dganin-hw/bldc-foc/hardware/encoder-board/README.md

# Плата энкодера

Маленькая плата с датчиком AS5047P. Она измеряет угол ротора по магниту на валу
мотора и передаёт его в STM32 основной платы по SPI. На плате восемь компонентов:
датчик, два конденсатора, четыре резистора и разъём.

Плата энкодера: сторона магнита и сторона кабеля

*Слева сторона, обращённая к магниту, справа обратная сторона с разъёмом.*

## Коротко

| Параметр | Значение |
|---|---|
| Размер | 32 × 28 мм, 2 слоя, FR-4 1,6 мм, фаски 1 мм на углах |
| Датчик | AS5047P-ATSM, 14 бит, TSSOP-14, в центре платы |
| Питание | только 3,3 В от основной платы (3,0-3,6 В), 5 В подавать нельзя |
| Интерфейс | SPI mode 1, первые запуски на частоте до 1 МГц |
| Крепление | 4 отверстия Ø2,2 мм под M2 на сетке 24 × 20 мм, по центру датчика |
| Разъём | JST GH, 6 контактов, на обратной стороне |

## Подключение к основной плате

| Основная плата, J3 | Энкодер, J1 | Сигнал | Вывод AS5047P |
|---:|---:|---|---|
| 1 | 1 | 3,3 В | 11 и 12 (соединены) |
| 2 | 2 | GND | 5 (TEST) и 13 |
| 3 | 3 | SCK | 2 |
| 4 | 4 | MISO | 3, через R4 33 Ом |
| 5 | 5 | MOSI | 4 |
| 6 | 6 | CS, активный ноль | 1 |

Разъём J1 - JST SM06B-GHS-TB(LF)(SN), шаг 1,25 мм. Ответная часть - корпус
GHR-06V-S и шесть контактов SSHL-002T-P0.2. На другом конце кабеля гнездовая колодка
1×6 с шагом 2,54 мм под J3. Готовый кабель GH-GH сюда не подходит.

- Для первого кабеля провод AWG28 длиной до 150 мм. Это условие для стенда, а не
  гарантированная длина линии SPI.
- Контакты считать по маркировке платы и чертежу разъёма, а не по цвету провода.
  Вид сзади зеркальный.
- До включения прозвонить все шесть проводов и проверить, что соседние контакты
  не замкнуты.
- Кабель вести подальше от фазных проводов мотора.

Контрольные площадки: TP1 - 3,3 В, TP2 - GND, TP3 - CS, TP4 - SCK, TP5 - MOSI,
TP6 - MISO после R4.

## Схема

- Выводы питания VDD (11) и VDD3V3 (12) соединены, как требует питание 3,3 В.
  TEST (5) соединён с GND (13). Рядом стоят C1 100 нФ и C2 1 мкФ.
- R1 10 кОм держит CS в единице, R2 и R3 47 кОм держат SCK и MOSI в нуле, пока
  STM32 в сбросе. Вместе с R37 10 кОм на основной плате CS подтянут примерно через
  5 кОм.
- R4 33 Ом стоит у выхода MISO. Линия MISO общая с DRV8323 на основной плате, там
  же подтяжка R10 1 кОм. При CS = 1 датчик отпускает линию. Энкодер и драйвер нельзя
  выбирать одновременно.
- Выходы A/B/I и U/V/W датчика не используются.

## Первый запуск

1. Обесточить обе платы. Проверить ориентацию U1, пайку, отсутствие перемычек
   припоем, соединение выводов 11 и 12, TEST и GND. Прозвонить кабель.
2. Подать питание на основную плату при снятой JP1, чтобы мост был обесточен.
   Измерить 3,3 В между TP1 и TP2, проверить, что ничего не греется. Датчик
   потребляет до 15 мА.
3. Настроить SPI: mode 1 (CPOL = 0, CPHA = 1), старшим битом вперёд, 16 бит,
   частота до 1 МГц. После включения подождать 10 мс. От спада CS до первого такта
   и между посылками при CS = 1 выдерживать не меньше 350 нс.
4. Ответ приходит со сдвигом на одну посылку: сначала команда чтения, ответ на неё
   придёт в следующей посылке. Команды отправлять с чётным битом чётности, в ответе
   проверять чётность и флаг ошибки.
5. Прочитать регистры диагностики и угол при медленном полном обороте. Переход
   16383 → 0 при прохождении нуля нормален. Проверить повторяемость и биение,
   положение магнита подобрать по диагностике поля.
6. Ноль электрического угла и направление вращения хранить в прошивке STM32.
   OTP-память датчика для стенда программировать не нужно.

Паспортные 10 МГц SPI на стенде не проверялись.

## Механика

| Элемент | Координаты в KiCad, мм | Относительно U1, мм |
|---|---|---|
| U1, ось магнита | 100; 100 | 0; 0 |
| H1, Ø2,2 | 88; 90 | -12; -10 |
| H2, Ø2,2 | 112; 90 | +12; -10 |
| H3, Ø2,2 | 112; 110 | +12; +10 |
| H4, Ø2,2 | 88; 110 | -12; +10 |
| J1, обратная сторона | 100; 110,5 | 0; +10,5 |

Вид со стороны магнита: X вправо, Y вниз.

- Сторона `MAGNET SIDE` смотрит на магнит, кабель выходит у нижнего края с обратной
  стороны.
- Плата крепится к неподвижному кронштейну, а не к вращающемуся торцу мотора.
  Головки винтов, шайбы и стойки не шире Ø4,5 мм, вокруг отверстий зона без меди
  Ø5 мм. Крепёж лучше немагнитный, например латунный. Не всякая нержавейка немагнитна.
- Магнит двухполюсный, намагниченный по диаметру, Ø6 × 2,5 мм. По документации
  датчику нужно поле 35-70 мТ. Начальный зазор 2 мм от крышки магнита до корпуса U1
  задаётся калибром из комплекта стенда, рабочий зазор подбирается по диагностике.
- Позади платы у J1 нужно около 6 мм свободного места и около 15 мм за краем платы
  для колодки, проводов и защёлки.

Плата и магнит встроены в [испытательный стенд](../stand/README.md).

## Файлы

- [`kicad/`](kicad/) - проект KiCad 10, открывать `foc-encoder.kicad_pro`.
- [`documentation/SCHEMATIC.pdf`](documentation/SCHEMATIC.pdf) - схема.
- [`documentation/ASSEMBLY-TOP.pdf`](documentation/ASSEMBLY-TOP.pdf) и
  [`ASSEMBLY-BOTTOM.pdf`](documentation/ASSEMBLY-BOTTOM.pdf) - сборочные чертежи.
- [`manufacturing/`](manufacturing/) - Gerber, сверловка, перечень компонентов и координаты.
- [`mechanical/foc-encoder.step`](mechanical/foc-encoder.step) - 3D-модель с компонентами,
  начало координат XY на оси U1. При импорте проверить направление осей и Z.
- [`mechanical/`](mechanical/) - контур и оси в DXF.

Проверки ERC и DRC в KiCad проходят без ошибок. SPI, магнит и механику ещё нужно
проверить на собранной плате.
