dganin-hw/bldc-foc/hardware/dev-board/manufacturing/drill/drill-report.txt

Drill report for foc-dev-board.kicad_pcb
Created on 2026-09-15T18:38:44

Copper Layer Stackup:
    =============================================================
    L1 :  F.Cu                      front
    L2 :  In1.Cu                    in1
    L3 :  In2.Cu                    in2
    L4 :  B.Cu                      back

Drill file 'foc-dev-board-PTH.drl' contains
    plated through holes:
    =============================================================
    T1  0.200mm  0.0079"  (25 holes))
    T2  0.300mm  0.0118"  (300 holes))
    T3  1.000mm  0.0394"  (23 holes))
    T4  1.050mm  0.0413"  (4 holes))
    T5  1.300mm  0.0512"  (7 holes))

    Total plated holes count 359

Drill file 'foc-dev-board-NPTH.drl' contains
    unplated through holes:
    =============================================================
    T1  3.200mm  0.1260"  (4 holes))

    Total unplated holes count 4
