dganin-hw/bldc-foc/docs/pin-plan.md

# План выводов STM32G431

> Документ относится к основной плате. Правило про единственный TIM1 действует
> для этой платы и не запрещает управлять мостами через HRTIM или несколько
> синхронизированных таймеров в 4-in-1 ESC.

Делается **до первой линии схемы**. Схема зависит от распределения выводов, а не
наоборот: нарисовать схему и потом открыть CubeMX - верный способ обнаружить, что
выбранные ноги не умеют нужного.

Корпус: LQFP48 (`G431CBT6`, основная плата). У UFQFPN48 (`G431CBU6`, возможный
4-in-1) **другая физическая нумерация выводов**. Назначения GPIO можно переиспользовать
после проверки, номера ножек переносить дословно нельзя. Схема:
[основная плата](../hardware/dev-board/README.md). Тайминг АЦП и защиты из `.ioc`
нужно проверить перед включением силовой части.

> GPIO перенесены в схему основной платы, выбор функций взят из CubeMX 6.18.1.
> Это не подтверждает рабочий тайминг ADC/PWM или настройку аппаратной защиты.
> Исходник: `hardware/dev-board/cubemx/CubeMX.ioc`, отчёт рядом в `.pdf`.

**До запуска прошивки требуется:**

- `ProjectManager.TargetToolchain=EWARM` - сменить на **CMake** при генерации кода
- Приоритеты NVIC все по нулям. Нужно: `ADC1_2` → 0 (цикл FOC), `EXTI15_10` → 2
  (авария драйвера), DMA и USART → 3 и ниже. Ставится в коде инициализации
- Спроектировать точку выборки шунтов. При center-aligned и RCR=0 Update возникает
  на обоих экстремумах, поэтому один TRGO Update не гарантирует один правильный
  замер за период PWM. Проверить длительность нижнего импульса и установление CSA/ADC.
- Явно включить BKIN, выбрать активный Low, idle-уровни и порядок повторного взвода.
- Начать проверку SPI на пониженной частоте; SDO драйвера имеет открытый сток.

Ещё одно значение не хранится в `.ioc`, потому что совпадает с дефолтом:
`Clock Prescaler = Synchronous clock mode divided by 4` у обоих АЦП (42.5 МГц).
Если после обновления CubeMX дефолт изменится - проверить.

---

## Правила, из которых всё следует

1. **Все шесть выходов ШИМ - с одного TIM1.** Не обсуждается: комплементарность и
   dead-time аппаратные, между двумя таймерами их не сделать.
2. **Комплементарные каналы не должны съедать выводы, способные на АЦП.** Это
   главное решение всей раскладки, см. ниже.
3. **Три тока распределены между ADC1 и ADC2.** Первые ранги IA/IB могут измеряться
   одновременно; IC во втором ранге ADC1 измеряется позже. Способ использования
   этих измерений в FOC ещё нужно определить.
4. **Injected ADC читаются из JDR в обработчике.** DMA для них здесь не используется;
   каналы DMA SPI, USART и таймера DShot проверяются на конфликты отдельно.
5. Выводы SWD не занимать ничем: иначе при первой же ошибке конфигурации плата
   перестанет прошиваться.

---

## Ключевое решение: N-каналы на порт B

У TIM1 у каждого канала несколько вариантов вывода. Для комплементарных есть два
типичных набора:

| Набор | CH1N | CH2N | CH3N | Последствие |
|---|---|---|---|---|
| A | PA7 | PB0 | PB1 | **съедает три вывода, способные на АЦП** |
| B | PB13 | PB14 | PB15 | порт A остаётся свободным под аналог |

**Берём набор B.** PA7, PB0, PB1 - аналоговые входы, и они нужны под измерение
токов. Набор A загоняет в тупик, из которого выход только через перерисовку.

Это же и есть причина, по которой мы отказались от встроенных опампов G431 в
пользу усилителей внутри DRV8323: входы опампов сидят ровно на этих же выводах и
конфликтуют с TIM1.

Прямые каналы CH1/CH2/CH3 - PA8/PA9/PA10, вариантов по сути нет.

---

## Итоговая раскладка

| Вывод | Функция | Сигнал | Настройки |
|---|---|---|---|
| PA8 | TIM1_CH1 | ШИМ фазы A, верх | center-aligned, ARR 1770 |
| PA9 | TIM1_CH2 | ШИМ фазы B, верх | |
| PA10 | TIM1_CH3 | ШИМ фазы C, верх | |
| PB13 | TIM1_CH1N | ШИМ фазы A, низ | dead-time DTG=68 ≈ 400 нс |
| PB14 | TIM1_CH2N | ШИМ фазы B, низ | |
| PB15 | TIM1_CH3N | ШИМ фазы C, низ | |
| PB12 | TIM1_BKIN | аварийное отключение от nFAULT | включить и проверить активный Low |
| PA0 | ADC1_IN1 | ток фазы A | инж. ранг 1, 6.5 такта |
| PA1 | ADC1_IN2 | ток фазы C | инж. ранг 2, 6.5 такта |
| PA2 | ADC1_IN3 | Vbat через делитель | инж. ранг 3, 47.5 такта |
| PA4 | ADC2_IN17 | ток фазы B | инж. ранг 1, 6.5 такта |
| PA5 | ADC2_IN13 | NTC | инж. ранг 2, 47.5 такта |
| PB3 | SPI1_SCK | шина драйвера и энкодера | 16 бит, 5.3 Мбит/с, CPOL 0 / CPHA 1 |
| PB4 | SPI1_MISO | | DMA RX |
| PB5 | SPI1_MOSI | | DMA TX |
| PA15 | `DRV_CS` | выбор драйвера | выход, старт High |
| PB9 | `ENC_CS` | выбор энкодера | выход, старт High |
| PA11 | `DRV_ENABLE` | разрешение драйвера | выход, **старт Low** |
| PA12 | `DRV_NFAULT` | авария драйвера | вход, pull-up, EXTI по спаду |
| PB6 | TIM4_CH1 | приём DShot600 | захват обоих фронтов, фильтр 3, DMA |
| PB10 | USART3_TX | телеметрия | DMA TX |
| PB11 | USART3_RX | команды | |
| PC13 | `LED` | индикация | выход |
| PB1 | `TP_TIMING` | замер времени цикла | выход, пятак под щуп |
| PA13 | SYS_JTMS-SWDIO | отладка | |
| PA14 | SYS_JTCK-SWCLK | отладка | |

Оба АЦП запускаются от одного TRGO TIM1 по нарастающему фронту, тактируются
синхронно от HCLK с делением на 4 (42.5 МГц). Прерывание `ADC1_2` - обработчик
цикла FOC, приоритет 0.

**Не подключены в схеме:** PA3, PA6, PA7, PB0, PB2, PB7, PC14, PC15, PF0, PF1.
PB8 используется как BOOT0, PG10/NRST - для сброса; их нельзя считать свободными.

Полезно, что осталось: три аналоговых входа про запас, второй канал того же TIM4
под возможное разделение приёма и передачи двунаправленного DShot, и PB7 рядом с
PB6 для этого же.

### Как сгруппировано на корпусе

- **Правая грань** - всё к драйверу: шесть ШИМ, BKIN, nFAULT, ENABLE
- **Верхняя грань** - SPI и два CS: драйвер и разъём энкодера
- **Левая грань** - аналог: пять входов АЦП подряд
- **Нижняя грань** - UART, пин замера, свободные выводы
- DShot вынесен на PB6 отдельно от затворных сигналов

При разводке это даёт четыре аккуратных пучка вместо паутины через весь корпус.

---

## Что проверить в CubeMX перед схемой

- [ ] Все шесть ШИМ встают на TIM1 одновременно, без конфликтов
- [ ] TIM1_BKIN доступен на выбранном выводе в LQFP48
- [ ] Токи A/B/C: минимум один на ADC1 и один на ADC2
- [ ] Инжектированные группы **обоих** АЦП стартуют от TRGO TIM1
- [ ] Таймер DShot умеет input capture с DMA на выбранном выводе
- [ ] Каналы DMA АЦП и DShot не пересекаются
- [ ] Vbat и NTC - на выводах, способных на АЦП, и не заняты ничем
- [ ] PA13/PA14 свободны
- [ ] BOOT0 разведён

Результат - экспортировать из CubeMX (`.ioc` + отчёт) в `hardware/` и
зафиксировать. Схема рисуется по нему, а не по этому документу.

---

## Процедура в CubeMX

Порядок выбран так, чтобы самое зажатое вставало первым.

1. `New Project` → `STM32G431CBT6` (корпус влияет на список доступных выводов)
2. **`System Core → SYS → Debug: Serial Wire` - первым делом.** Резервирует
   PA13/PA14. Если забыть, отладочный интерфейс может уйти под другую функцию, и
   плата перестанет прошиваться после первой же заливки
3. `System Core → RCC → HSE: Disable` - кварц не ставим
4. `TIM1`: Internal Clock; `Channel1/2/3 = PWM Generation CHx CHxN`;
   `Counter Mode = Center Aligned mode 1`; `PSC = 0`; `ARR = 1770`
   (170 МГц / (2 × 1771) = 48.0 кГц); `TRGO = Update Event`;
   включить `Break Input`, dead-time 300-500 нс на первое время
5. **Переставить N-каналы на PB13/PB14/PB15** вручную через клик по выводу.
   CubeMX по умолчанию возьмёт PA7/PB0/PB1 - набор, съедающий аналоговые входы.
   Убедиться, что PA7, PB0, PB1 освободились
6. `ADC1` и `ADC2`: каналы токов разнести между двумя АЦП; инжектированная группа,
   `External Trigger Source = Timer 1 Trigger Out event`
7. `SPI1`, `USART`, отдельный таймер в `Input Capture direct mode` под DShot, GPIO
8. `Clock Configuration`: вписать `170` в HCLK
9. `DMA Settings`: проверить каналы SPI, UART и DShot. Для injected ADC DMA не назначается
10. Сохранить `.ioc` в `hardware/dev-board/cubemx/`, `Toolchain = CMake`,
    `Generate Report`. **Код не генерировать** - нужна только раскладка

---

## Перенос на 4-in-1

В текущем `.ioc` CS энкодера - PB9. При отказе от энкодера эта линия освобождается.
Для переноса на UFQFPN48 заново сверить **все физические номера выводов**, питание
и доступность функций по datasheet STM32G431. У этого корпуса распиновка отличается
от LQFP48; прямая замена посадочного места недопустима.

Проверка выполняется один раз, четыре канала получают её бесплатно.
