dganin-hw/bldc-foc/docs/safety.md

# Безопасность и порядок включения

Прочитать до первого включения силовой части. Здесь нет паранойи - есть
конкретные способы не потерять плату и глаза.

---

## Железные правила

1. **БП только с ограничением тока.** Первое включение - предел 0.3 А. Поднимать
   порог только после того, как всё ожидаемое работает.
2. **Начинать с 12 В и маленького мотора.** Энергия ошибки растёт как V².
3. **Очки при первом включении новой платы.** Электролит и керамика при КЗ
   разлетаются.
4. **Мотор механически закреплён.** Незакреплённый мотор с пропеллером - травма.
   Пропеллер не ставить вообще, пока алгоритм не отлажен.
5. **Не трогать плату под напряжением.** Щупы ставить при выключенном питании.
6. **Земля осциллографа.** При измерении на high-side НЕЛЬЗЯ цеплять землю щупа
   к средней точке полумоста - это КЗ через землю сети. Использовать
   дифференциальный щуп либо измерять сигналы относительно GND в пределах
   допустимых напряжений прибора. Изолированный БП сам по себе не разрешает
   подключать землю щупа к фазе: остаются общие земли каналов, USB и ST-Link.
7. **Разряд шины.** После выключения конденсаторы шины держат заряд. Ждать или
   ставить bleeder-резистор.

---

## Отдельно про дрон

Здесь появляются два источника опасности, которых нет на стенде: аккумулятор и
пропеллеры.

### LiPo

**У LiPo нет ограничения тока.** Лабораторный БП при КЗ уходит в защиту, LiPo
отдаёт сотни ампер и продолжает. Разница между «сгорел транзистор» и «пожар».

- Вся отладка - **только от лабораторного БП**. LiPo подключается в последнюю
  очередь, после полной наземной валидации
- Первое подключение LiPo - через **smoke stopper** (лампа накаливания 12 В в
  разрыв плюса): при КЗ она просто светится
- Хранить и заряжать в огнеупорном мешке, не оставлять без присмотра
- Не подключать/отключать аккумулятор при вращающихся моторах
- Вздувшийся аккумулятор - в утиль, не «ещё разок»

### Пропеллеры

- **Все стендовые работы - без пропеллеров.** Вообще. Ни одного исключения:
  «только проверить направление» - тоже без
- Пропеллеры ставятся только на собранном аппарате, после того как направления
  вращения и микшер проверены без них
- Первые подлёты - на привязи или в защитной клетке, на улице и вдали от людей
- Перед каждым включением: газ на минимуме, аппарат disarmed, руки не над плоскостью
  винтов
- Раскрученный 5" пропеллер режет до кости. Это не фигура речи

### Failsafe

Failsafe по потере DShot - **обязательная функция до первого полёта**, а не
доработка потом. Проверять её на стенде: выдернуть сигнальный провод при
работающем моторе, мотор должен плавно остановиться.

То же с failsafe в приёмнике и FC - настроить и проверить выключением пульта.

---

## Порядок первого включения новой силовой платы

1. Визуальный осмотр, проверка на КЗ тестером: Vbus↔GND, каждая фаза↔GND, 3.3 В↔GND
2. На основной плате снять JP1 и JP2, затем подать 12 В на J1 с ограничением тока.
   Проверить 5 В/3,3 В, прошивку MCU и внешний датчик. Не подавать внешние 3,3/5 В
   на сигнальные разъёмы. При JP1 open питание VM драйвера отсутствует; его SPI
   проверяется позже, после подключения VM и контролируемого разрешения ENABLE.
3. Проверить, что при старте MCU все шесть PWM и команда ENABLE имеют неактивный
   уровень. Перед изменением перемычек выключать питание и проверять разряд VM.
4. Установить JP1, оставить JP2 снятой; мотор не подключать. Подать 12 В с
   ограничением тока. Ток покоя оценивать по бюджету MCU, buck/LDO и драйвера,
   а не считать, что он обязательно равен нескольким миллиамперам. VM должен
   оставаться в рабочем диапазоне; 5 В недостаточно для полноценной проверки DRV8323.
5. После проверки прошивки запуска установить JP2 при снятом питании. При
   неактивных PWM разрешить драйвер, прочитать SPI и настроить защиту. Затем без
   мотора проверить входные PWM, реальные VGS, dead-time, реакцию nFAULT/BKIN
   и кнопки отключения. Осциллограммы сохранять; freeze таймера защитой не считать.
6. Подключать мотор только после этих проверок и проверки измерения токов.
   Ограничение тока БП относится к входу платы, а программный лимит - к фазному
   току: это разные величины. Начинать с малой команды и проверенного режима
   остановки без недопустимого подъёма напряжения шины.
7. Повышать нагрузку только по результатам измерений тока, напряжения и
   температуры. Использовать NTC/термопару, не оценивать температуру пальцем.

Подробный порядок для основной платы описан в
[памятке по сборке и первому включению](../hardware/dev-board/bring-up.md).

Если на любом шаге БП уходит в ограничение тока - **выключить и разбираться**,
а не «попробовать ещё раз».

---

## Типовые способы сжечь всё

| Ошибка | Последствие | Профилактика |
|---|---|---|
| Dead-time = 0 или инверсия сигнала | сквозной ток, оба транзистора плеча открыты → мгновенный отказ | проверить осциллографом ДО силового питания |
| Зависание МК с открытым ключом | постоянный ток в обмотке, перегрев | IWDG + BRK-вход + аппаратная OCP драйвера |
| Отладчик остановил МК на брейкпоинте | выход может остаться активным | заранее снять ENABLE; проверить BKIN и неактивные уровни. При freeze выходы TIM1 отключаются, но их уровень зависит от OSSI и GPIO: проверить осциллографом |
| Длинная петля коммутации на плате | выбросы напряжения выше Vds | керамика вплотную к полумосту, короткий контур |
| Слишком короткий интервал проводимости нижнего ключа | недостоверная выборка шунта | ограничить скважность по реальному окну измерения. DRV8323RS использует зарядовый насос, а не bootstrap моста |
| Перепутана полярность питания | мгновенный отказ | reverse-polarity MOSFET на входе |
| Обрыв фазы при работе | выброс на индуктивности | не дёргать разъёмы под напряжением |

---

## Что должно быть на столе

- [ ] БП с ограничением тока
- [ ] Осциллограф (2+ канала), желательно дифференциальный щуп
- [ ] Мультиметр
- [ ] Тиски/крепление для мотора
- [ ] Огнетушитель или хотя бы отсутствие бумаги вокруг
- [ ] Резисторы 10-47 Ом мощные - для «мягкого» первого включения
