dganin-hw/bldc-foc/hardware/dev-board/cubemx/CubeMX.pdf

18/08/2026

CubeMX Project
Configuration Report

## 1. Description

### 1.1. Project

Project Name | CubeMX
Board Name | custom
Generated with: | STM32CubeMX 6.18.1
Date | 08/18/2026

### 1.2. MCU

MCU Series | STM32G4
MCU Line | STM32G4x1
MCU name | STM32G431CBTx
MCU Package | LQFP48
MCU Pin number | 48

### 1.3. Core(s) information

Core(s) | ARM Cortex-M4

## 2. Pinout Configuration

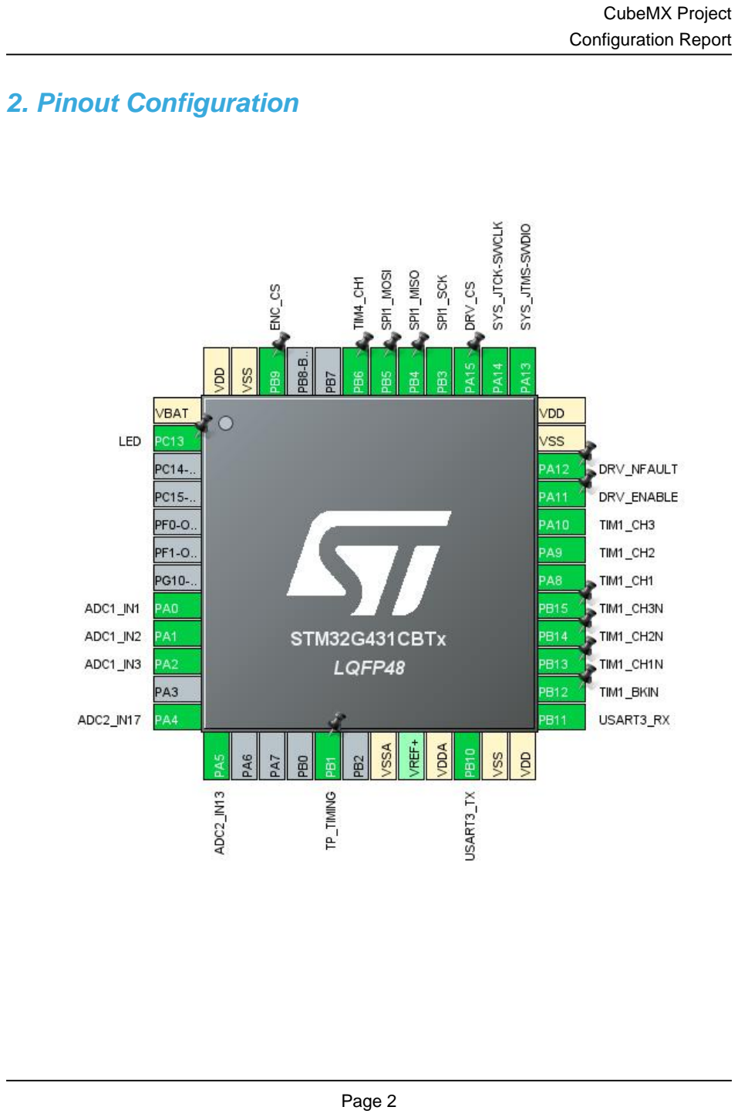
[picture p12: page 3]

## 3. Pins Configuration

Pin Number LQFP48 | Pin Name (function after reset) | Pin Type | Alternate Function(s) | Label
1 | VBAT | Power
2 | PC13 * | I/O | GPIO_Output | LED
8 | PA0 | I/O | ADC1_IN1
9 | PA1 | I/O | ADC1_IN2
10 | PA2 | I/O | ADC1_IN3
12 | PA4 | I/O | ADC2_IN17
13 | PA5 | I/O | ADC2_IN13
17 | PB1 * | I/O | GPIO_Output | TP_TIMING
19 | VSSA | Power
21 | VDDA | Power
22 | PB10 | I/O | USART3_TX
23 | VSS | Power
24 | VDD | Power
25 | PB11 | I/O | USART3_RX
26 | PB12 | I/O | TIM1_BKIN
27 | PB13 | I/O | TIM1_CH1N
28 | PB14 | I/O | TIM1_CH2N
29 | PB15 | I/O | TIM1_CH3N
30 | PA8 | I/O | TIM1_CH1
31 | PA9 | I/O | TIM1_CH2
32 | PA10 | I/O | TIM1_CH3
33 | PA11 * | I/O | GPIO_Output | DRV_ENABLE
34 | PA12 | I/O | GPIO_EXTI12 | DRV_NFAULT
35 | VSS | Power
36 | VDD | Power
37 | PA13 | I/O | SYS_JTMS-SWDIO
38 | PA14 | I/O | SYS_JTCK-SWCLK
39 | PA15 * | I/O | GPIO_Output | DRV_CS
40 | PB3 | I/O | SPI1_SCK
41 | PB4 | I/O | SPI1_MISO
42 | PB5 | I/O | SPI1_MOSI
43 | PB6 | I/O | TIM4_CH1
46 | PB9 * | I/O | GPIO_Output | ENC_CS
47 | VSS | Power
48 | VDD | Power

* The pin is affected with an I/O function

## 4. Clock Tree Configuration

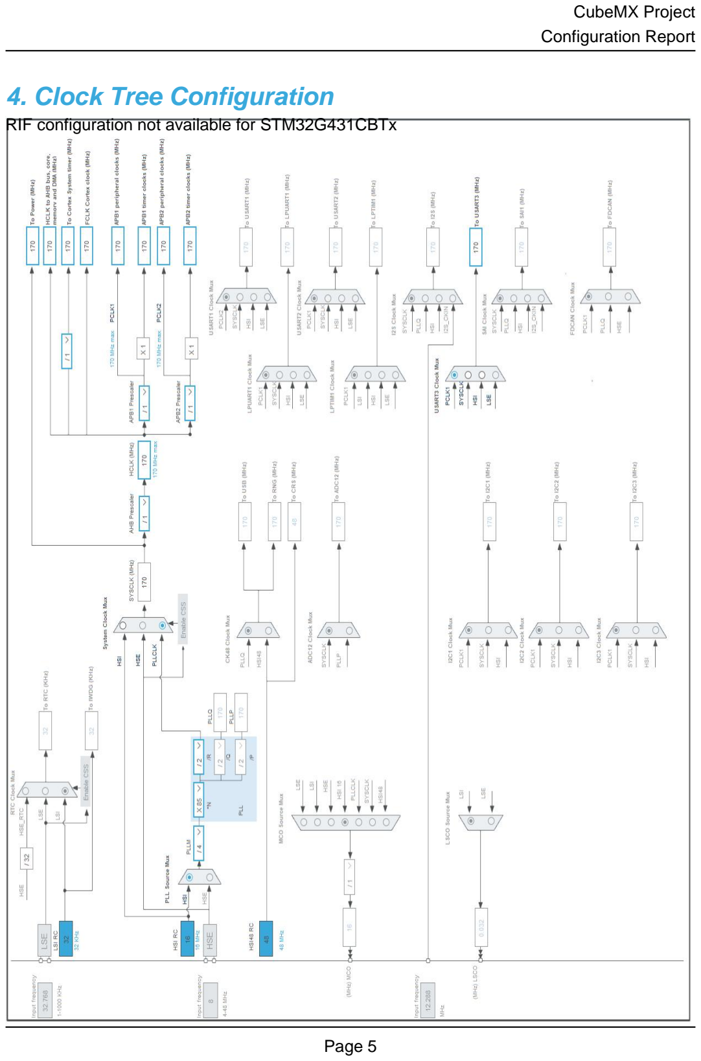
[picture p13: page 6]

RIF configuration not available for STM32G431CBTx

## 1. Power Consumption Calculator report

### 1.1. Microcontroller Selection

Series | STM32G4
Line | STM32G4x1
MCU | STM32G431CBTx
Datasheet | DS12589_Rev0

### 1.2. Parameter Selection

Temperature | 25
Vdd | 3.0

### 1.3. Battery Selection

Battery | Li-SOCL2(A3400)
Capacity | 3400.0 mAh
Self Discharge | 0.08 %/month
Nominal Voltage | 3.6 V
Max Cont Current | 100.0 mA
Max Pulse Current | 200.0 mA
Cells in series | 1
Cells in parallel | 1

### 1.4. Sequence

Step | Step1 | Step2
Mode | RUN | STOP1
Vdd | 3.0 | 3.0
Voltage Source | Battery | Battery
Range | Range1-Boost | NoRange
Fetch Type | FLASH/ART | NA
CPU Frequency | 170 MHz | 0 Hz
Clock Configuration | HSE BYP PLL | ALL CLOCKS OFF
Clock Source Frequency | 4 MHz | 0 Hz
Peripherals
Additional Cons. | 0 mA | 0 mA
Average Current | 25.5 mA | 59 µA
Duration | 0.1 ms | 0.9 ms
DMIPS | 213.0 | 0.0
Ta Max | 124.26 | 129.99
Category | In DS Table | In DS Table

### 1.5. Results

Sequence Time | 1 ms | Average Current | 2.6 mA
Battery Life | 1 month, 23 days, 22 hours | Average DMIPS | 212.5 DMIPS

### 1.6. Chart

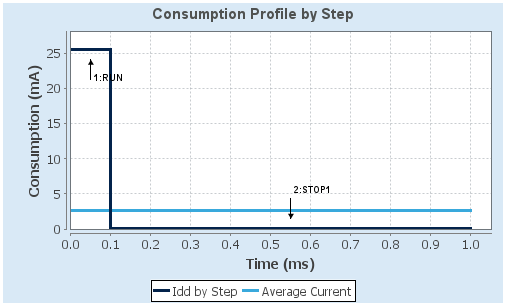
[picture p14: figure]

## 2. Software Project

### 2.1. Project Settings

Name | Value
Project Name | CubeMX
Project Folder | D:\Projects\bldc-foc\hardware\dev-board\cubemx
Toolchain / IDE | EWARM V8.50
Firmware Package Name and Version | STM32Cube FW_G4 V1.6.3
Application Structure | Advanced
Generate Under Root | No
Do not generate the main() | No
Minimum Heap Size | 0x200
Minimum Stack Size | 0x400

### 2.2. Code Generation Settings

Name | Value
STM32Cube MCU packages and embedded software | Copy all used libraries into the project folder
Generate peripheral initialization as a pair of '.c/.h' files | No
Backup previously generated files when re-generating | No
Keep User Code when re-generating | Yes
Delete previously generated files when not re-generated | Yes
Set all free pins as analog (to optimize the power consumption) | No
Enable Full Assert | No

### 2.3. Advanced Settings - Generated Function Calls

Rank | Function Name | Peripheral Instance Name
1 | SystemClock_Config | RCC
2 | MX_GPIO_Init | GPIO
3 | MX_DMA_Init | DMA
4 | MX_ADC1_Init | ADC1
5 | MX_ADC2_Init | ADC2
6 | MX_SPI1_Init | SPI1
7 | MX_TIM1_Init | TIM1
8 | MX_USART3_UART_Init | USART3
9 | MX_TIM4_Init | TIM4

## 3. Peripherals and Middlewares Configuration

### 3.1. ADC1

IN1: IN1 Single-ended
IN2: IN2 Single-ended
IN3: IN3 Single-ended
3.1.1. Parameter Settings:

ADCs_Common_Settings:

Mode | Independent mode
ADC_Settings:
Clock Prescaler | Synchronous clock mode divided by 4
Resolution | ADC 12-bit resolution
Data Alignment | Right alignment
Gain Compensation | 0
Scan Conversion Mode | Enabled
End Of Conversion Selection | End of single conversion
Low Power Auto Wait | Disabled
Continuous Conversion Mode | Disabled
Discontinuous Conversion Mode | Disabled
DMA Continuous Requests | Disabled
Overrun behaviour | Overrun data preserved
ADC_Regular_ConversionMode:
Enable Regular Conversions | Disable *
ADC_Injected_ConversionMode:
Enable Injected Conversions | Enable *
Number Of Conversions | 3 *
External Trigger Source | Timer 1 Trigger Out event *
External Trigger Conversion Edge | Trigger detection on the rising edge
Enable Injected Oversampling | Disable
Injected Conversion Mode | None
Injected Queue | Injected Queue Disable
Rank | 1
Channel | Channel 1
Sampling Time | 6.5 Cycles *
Offset Number | No offset
Rank | 2 *
Channel | Channel 2 *
Sampling Time | 6.5 Cycles *
Offset Number | No offset

Rank | 3 *
Channel | Channel 3 *
Sampling Time | 47.5 Cycles *
Offset Number | No offset
Analog Watchdog 1:
Enable Analog WatchDog1 Mode | false
Analog Watchdog 2:
Enable Analog WatchDog2 Mode | false
Analog Watchdog 3:
Enable Analog WatchDog3 Mode | false

### 3.2. ADC2

IN13: IN13 Single-ended
mode: IN17 Single-ended
3.2.1. Parameter Settings:

ADCs_Common_Settings:

Mode | Independent mode
ADC_Settings:
Clock Prescaler | Synchronous clock mode divided by 4
Resolution | ADC 12-bit resolution
Data Alignment | Right alignment
Gain Compensation | 0
Scan Conversion Mode | Enabled
End Of Conversion Selection | End of single conversion
Low Power Auto Wait | Disabled
Continuous Conversion Mode | Disabled
Discontinuous Conversion Mode | Disabled
DMA Continuous Requests | Disabled
Overrun behaviour | Overrun data preserved
ADC_Regular_ConversionMode:
Enable Regular Conversions | Disable *
ADC_Injected_ConversionMode:
Enable Injected Conversions | Enable *
Number Of Conversions | 2 *
External Trigger Source | Timer 1 Trigger Out event *
External Trigger Conversion Edge | Trigger detection on the rising edge
Enable Injected Oversampling | Disable

Injected Conversion Mode | None
Injected Queue | Injected Queue Disable
Rank | 1
Channel | Channel 17 *
Sampling Time | 6.5 Cycles *
Offset Number | No offset
Rank | 2 *
Channel | Channel 13
Sampling Time | 47.5 Cycles *
Offset Number | No offset
Analog Watchdog 1:
Enable Analog WatchDog1 Mode | false
Analog Watchdog 2:
Enable Analog WatchDog2 Mode | false
Analog Watchdog 3:
Enable Analog WatchDog3 Mode | false

### 3.3. RCC

3.3.1. Parameter Settings:

System Parameters:

VDD voltage (V) | 3.3
Instruction Cache | Enabled
Prefetch Buffer | Disabled
Data Cache | Enabled
Flash Latency(WS) | 4 WS (5 CPU cycle)
RCC Parameters:
HSI Calibration Value | 64
HSE Startup Timout Value (ms) | 100
LSE Startup Timout Value (ms) | 5000
Power Parameters:
Power Regulator Voltage Scale | Power Regulator Voltage Scale 1 boost
Peripherals Clock Configuration:
Generate the peripherals clock configuration | TRUE

### 3.4. SPI1

Mode: Full-Duplex Master
3.4.1. Parameter Settings:

Basic Parameters:

Frame Format | Motorola
Data Size | 16 Bits *
First Bit | MSB First
Clock Parameters:
Prescaler (for Baud Rate) | 32 *
Baud Rate | 5.3125 MBits/s *
Clock Polarity (CPOL) | Low
Clock Phase (CPHA) | 2 Edge *
Advanced Parameters:
CRC Calculation | Disabled
NSS Signal Type | Software

### 3.5. SYS

Debug: Serial Wire
Timebase Source: SysTick
mode: save power of non-active UCPD - deactive Dead Battery pull-up

### 3.6. TIM1

Clock Source : Internal Clock
Channel1: PWM Generation CH1 CH1N
Channel2: PWM Generation CH2 CH2N Channel3: PWM Generation CH3 CH3N mode: Activate-Break-Input
3.6.1. Parameter Settings:

Counter Settings:

Prescaler (PSC - 16 bits value) | 0
Counter Mode | Center Aligned mode1 *
Dithering | Disable
Counter Period (AutoReload Register - 16 bits value ) | 1770 *
Internal Clock Division (CKD) | No Division
Repetition Counter (RCR - 16 bits value) | 0

auto-reload preload | Enable *
Trigger Output (TRGO) Parameters:
Master/Slave Mode (MSM bit) | Disable (Trigger input effect not delayed)
Trigger Event Selection TRGO | Update Event *
Trigger Event Selection TRGO2 | Reset (UG bit from TIMx_EGR)
Break And Dead Time management - BRK Configuration:
BRK State | Enable
BRK Polarity | High
BRK Filter (4 bits value) | 0
BRK Sources Configuration
- Digital Input | Enable
Break_IO mode selection | Break IO is an Input
Digital Input Polarity | Polarity High
- COMP1 | Disable
- COMP2 | Disable
- COMP3 | Disable
- COMP4 | Disable
Break And Dead Time management - BRK2 Configuration:
BRK2 State | Disable
BRK2 Polarity | High
BRK2 Filter (4 bits value) | 0
BRK2 Sources Configuration
- Digital Input | Disable
- COMP1 | Disable
- COMP2 | Disable
- COMP3 | Disable
- COMP4 | Disable
Break And Dead Time management - Output Configuration:
Automatic Output State | Disable
Off State Selection for Run Mode (OSSR) | Disable
Off State Selection for Idle Mode (OSSI) | Disable
Lock Configuration | Off
DeadTime Preload | Disable
Dead Time | 68 *
Asymmetrical DeadTime | Disable
Falling Dead Time | 0
Clear Input:
Clear Input Source | Disable
PWM Generation Channel 1 and 1N:
Mode | PWM mode 1
Pulse (16 bits value) | 0

Output compare preload | Enable
Fast Mode | Disable
CH Polarity | High
CHN Polarity | High
CH Idle State | Reset
CHN Idle State | Reset
PWM Generation Channel 2 and 2N:
Mode | PWM mode 1
Pulse (16 bits value) | 0
Output compare preload | Enable
Fast Mode | Disable
CH Polarity | High
CHN Polarity | High
CH Idle State | Reset
CHN Idle State | Reset
PWM Generation Channel 3 and 3N:
Mode | PWM mode 1
Pulse (16 bits value) | 0
Output compare preload | Enable
Fast Mode | Disable
CH Polarity | High
CHN Polarity | High
CH Idle State | Reset
CHN Idle State | Reset

### 3.7. TIM4

Clock Source : Internal Clock Channel1: Input Capture direct mode
3.7.1. Parameter Settings:

Counter Settings:

Prescaler (PSC - 16 bits value) | 0
Counter Mode | Up
Dithering | Disable
Counter Period (AutoReload Register - 16 bits value ) | 65535
Internal Clock Division (CKD) | No Division
auto-reload preload | Disable
Trigger Output (TRGO) Parameters:
Master/Slave Mode (MSM bit) | Disable (Trigger input effect not delayed)
Trigger Event Selection TRGO | Reset (UG bit from TIMx_EGR)

Input Capture Channel 1:

Polarity Selection | Both Edges *
IC Selection | Direct
Prescaler Division Ratio | No division
Input Filter (4 bits value) | 3 *

### 3.8. USART3

Mode: Asynchronous
3.8.1. Parameter Settings:

Basic Parameters:

Baud Rate | 115200
Word Length | 8 Bits (including Parity)
Parity | None
Stop Bits | 1
Advanced Parameters:
Data Direction | Receive and Transmit
Over Sampling | 16 Samples
Single Sample | Disable
ClockPrescaler | 1
Fifo Mode | Disable
Txfifo Threshold | 1 eighth full configuration
Rxfifo Threshold | 1 eighth full configuration
Advanced Features:
Auto Baudrate | Disable
TX Pin Active Level Inversion | Disable
RX Pin Active Level Inversion | Disable
Data Inversion | Disable
TX and RX Pins Swapping | Disable
Overrun | Enable
DMA on RX Error | Enable
MSB First | Disable

* User modified value

## 4. System Configuration

### 4.1. GPIO configuration

IP | Pin | Signal | GPIO mode | GPIO pull/up pull down | Max Speed | User Label
ADC1 | PA0 | ADC1_IN1 | Analog mode | No pull-up and no pull-down | n/a
| PA1 | ADC1_IN2 | Analog mode | No pull-up and no pull-down | n/a
| PA2 | ADC1_IN3 | Analog mode | No pull-up and no pull-down | n/a
ADC2 | PA4 | ADC2_IN17 | Analog mode | No pull-up and no pull-down | n/a
| PA5 | ADC2_IN13 | Analog mode | No pull-up and no pull-down | n/a
SPI1 | PB3 | SPI1_SCK | Alternate Function Push Pull | No pull-up and no pull-down | High *
| PB4 | SPI1_MISO | Alternate Function Push Pull | No pull-up and no pull-down | High *
| PB5 | SPI1_MOSI | Alternate Function Push Pull | No pull-up and no pull-down | High *
SYS | PA13 | SYS_JTMS-SWDIO | n/a | n/a | n/a
| PA14 | SYS_JTCK-SWCLK | n/a | n/a | n/a
TIM1 | PB12 | TIM1_BKIN | Alternate Function Open Drain | No pull-up and no pull-down | Low
| PB13 | TIM1_CH1N | Alternate Function Push Pull | No pull-up and no pull-down | Very High *
| PB14 | TIM1_CH2N | Alternate Function Push Pull | No pull-up and no pull-down | Very High *
| PB15 | TIM1_CH3N | Alternate Function Push Pull | No pull-up and no pull-down | Very High *
| PA8 | TIM1_CH1 | Alternate Function Push Pull | No pull-up and no pull-down | Very High *
| PA9 | TIM1_CH2 | Alternate Function Push Pull | No pull-up and no pull-down | Very High *
| PA10 | TIM1_CH3 | Alternate Function Push Pull | No pull-up and no pull-down | Very High *
TIM4 | PB6 | TIM4_CH1 | Alternate Function Push Pull | No pull-up and no pull-down | Low
USART3 | PB10 | USART3_TX | Alternate Function Push Pull | No pull-up and no pull-down | Low
| PB11 | USART3_RX | Alternate Function Push Pull | No pull-up and no pull-down | Low
GPIO | PC13 | GPIO_Output | Output Push Pull | No pull-up and no pull-down | Low | LED
| PB1 | GPIO_Output | Output Push Pull | No pull-up and no pull-down | Low | TP_TIMING
| PA11 | GPIO_Output | Output Push Pull | No pull-up and no pull-down | Low | DRV_ENABLE
| PA12 | GPIO_EXTI12 | External Interrupt Mode with Falling edge trigger detection | Pull-up * | n/a | DRV_NFAULT

IP | Pin | Signal | GPIO mode | GPIO pull/up pull down | Max Speed | User Label
| PA15 | GPIO_Output | Output Push Pull | No pull-up and no pull-down | Low | DRV_CS
| PB9 | GPIO_Output | Output Push Pull | No pull-up and no pull-down | Low | ENC_CS

### 4.2. DMA configuration

DMA request | Stream | Direction | Priority
SPI1_RX | DMA1_Channel1 | Peripheral To Memory | Medium *
SPI1_TX | DMA1_Channel2 | Memory To Peripheral | Medium *
USART3_RX | DMA1_Channel3 | Peripheral To Memory | Low
USART3_TX | DMA1_Channel4 | Memory To Peripheral | Low
TIM4_CH1 | DMA1_Channel5 | Peripheral To Memory | Low

SPI1_RX: DMA1_Channel1 DMA request Settings:

Mode: | Normal
Peripheral Increment: | Disable
Memory Increment: | Enable *
Peripheral Data Width: | Half Word
Memory Data Width: | Half Word

SPI1_TX: DMA1_Channel2 DMA request Settings:

Mode: | Normal
Peripheral Increment: | Disable
Memory Increment: | Enable *
Peripheral Data Width: | Half Word
Memory Data Width: | Half Word

USART3_RX: DMA1_Channel3 DMA request Settings:

Mode: | Normal
Peripheral Increment: | Disable
Memory Increment: | Enable *
Peripheral Data Width: | Byte
Memory Data Width: | Byte

USART3_TX: DMA1_Channel4 DMA request Settings:

Mode: | Normal
Peripheral Increment: | Disable
Memory Increment: | Enable *
Peripheral Data Width: | Byte

Memory Data Width: Byte

TIM4_CH1: DMA1_Channel5 DMA request Settings:

Mode: | Normal
Peripheral Increment: | Disable
Memory Increment: | Enable *
Peripheral Data Width: | Half Word
Memory Data Width: | Half Word

### 4.3. NVIC configuration

4.3.1. NVIC
Interrupt Table | Enable | Preenmption Priority | SubPriority
Non maskable interrupt | true | 0 | 0
Hard fault interrupt | true | 0 | 0
Memory management fault | true | 0 | 0
Prefetch fault, memory access fault | true | 0 | 0
Undefined instruction or illegal state | true | 0 | 0
System service call via SWI instruction | true | 0 | 0
Debug monitor | true | 0 | 0
Pendable request for system service | true | 0 | 0
System tick timer | true | 15 | 0
DMA1 channel1 global interrupt | true | 0 | 0
DMA1 channel2 global interrupt | true | 0 | 0
DMA1 channel3 global interrupt | true | 0 | 0
DMA1 channel4 global interrupt | true | 0 | 0
DMA1 channel5 global interrupt | true | 0 | 0
ADC1 and ADC2 global interrupt | true | 0 | 0
USART3 global interrupt / USART3 wake-up interrupt through EXTI line 28 | true | 0 | 0
EXTI line[15:10] interrupts | true | 0 | 0
PVD/PVM1/PVM2/PVM3/PVM4 interrupts through EXTI lines 16/38/39/40/41 | unused
Flash global interrupt | unused
RCC global interrupt | unused
TIM1 break interrupt and TIM15 global interrupt | unused
TIM1 update interrupt and TIM16 global interrupt | unused
TIM1 trigger and commutation interrupts and TIM17 global interrupt | unused
TIM1 capture compare interrupt | unused
TIM4 global interrupt | unused
SPI1 global interrupt | unused
FPU global interrupt | unused
4.3.2. NVIC Code generation
Enabled interrupt Table | Select for init sequence ordering | Generate IRQ handler | Call HAL handler
Non maskable interrupt | false | true | false
Hard fault interrupt | false | true | false
Memory management fault | false | true | false

Enabled interrupt Table | Select for init sequence ordering | Generate IRQ handler | Call HAL handler
Prefetch fault, memory access fault | false | true | false
Undefined instruction or illegal state | false | true | false
System service call via SWI instruction | false | true | false
Debug monitor | false | true | false
Pendable request for system service | false | true | false
System tick timer | false | true | true
DMA1 channel1 global interrupt | false | true | true
DMA1 channel2 global interrupt | false | true | true
DMA1 channel3 global interrupt | false | true | true
DMA1 channel4 global interrupt | false | true | true
DMA1 channel5 global interrupt | false | true | true
ADC1 and ADC2 global interrupt | false | true | true
USART3 global interrupt / USART3 wake-up interrupt through EXTI line 28 | false | true | true
EXTI line[15:10] interrupts | false | true | true

* User modified value

## 5. System Views

5.1. Category view
5.1.1. Current

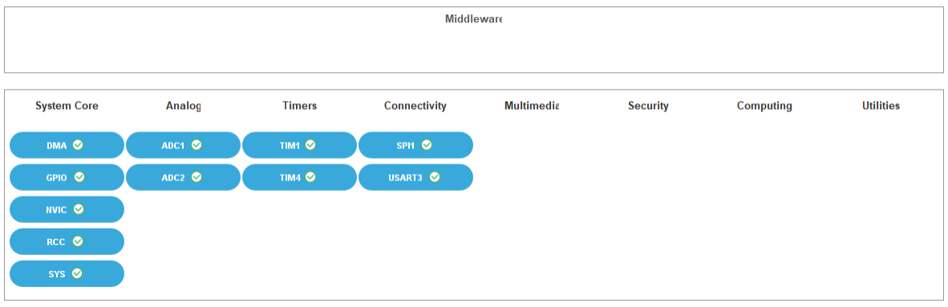
[picture p15: figure]

## 6. Docs & Resources

Type | Link
BSDL files | https://www.st.com/resource/en/bsdl_model/stm32g4_bsdl.zip
IBIS models | https://www.st.com/resource/en/ibis_model/stm32g4_ibis.zip
System View Description | https://www.st.com/resource/en/svd/stm32g4_svd.zip
Presentations | https://www.st.com/resource/en/product_presentation/stm32-stm8_embedded_software_solutions.pdf
Presentations | https://www.st.com/resource/en/product_presentation/stm32_eval-tools_portfolio.pdf
Presentations | https://www.st.com/resource/en/product_presentation/stm32_stm8_functi onal-safety-packages.pdf
Presentations | https://www.st.com/resource/en/product_presentation/stm32-usb-c-pd-solutions-presentation.pdf
Presentations | https://www.st.com/resource/en/product_presentation/stm32-stm8_software_development_tools.pdf
Presentations | https://www.st.com/resource/en/product_presentation/microcontrollers-stm32-family-overview.pdf
Presentations | https://www.st.com/resource/en/product_presentation/microcontrollers-stm32g4-series-product-overview.pdf
Brochures | https://www.st.com/resource/en/brochure/humanoid-robot-reference-guide.pdf
Flyers | https://www.st.com/resource/en/flyer/flstm32g4.pdf
Flyers | https://www.st.com/resource/en/flyer/flstm32nucleo.pdf
Flyers | https://www.st.com/resource/en/flyer/flstm32trust.pdf
Flyers | https://www.st.com/resource/en/flyer/flstm32c5.pdf
Security Bulletin | https://www.st.com/resource/en/technical_note/tn1489-security-bulletin-tn1489stpsirt-physical-attacks-on-stm32-and-stm32cube-firmware-stmicroelectronics.pdf
Application Notes | https://www.st.com/resource/en/application_note/an1709-emc-design-guide-for-stm8-stm32-and-legacy-mcus-stmicroelectronics.pdf

Application Notes | https://www.st.com/resource/en/application_note/an4221-i2c-protocol-used-in-the-stm32-bootloader-stmicroelectronics.pdf
Application Notes | https://www.st.com/resource/en/application_note/an4232-getting-started-with-analog-comparators-for-stm32f3-series-and-stm32g4-series-devices-stmicroelectronics.pdf
Application Notes | https://www.st.com/resource/en/application_note/an4296-use-stm32f3stm32g4-ccm-sram-with-iar-embedded-workbench-keil-mdkarm-stmicroelectronics-stm32cubeide-and-other-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
Application Notes | https://www.st.com/resource/en/application_note/an4655-virtually-increasing-the-number-of-serial-communication-peripherals-in-stm32-applications-stmicroelectronics.p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
Application Notes | https://www.st.com/resource/en/application_note/an4750-handling-of-soft-errors-in-stm32-applications-stmicroelectronics.pdf
Application Notes | https://www.st.com/resource/en/application_note/an4803-highspeed-si-simulations-using-ibis-and-boardlevel-simulations-using-hyperlynx-si-on-stm32-mcus-and-mpus-stmic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
Application Notes | https://www.st.com/resource/en/application_note/an5027-interfacing-pdm-digital-microphones-using-stm32-mcus-and-mpus-stmicroelectronics.pdf
Application Notes | https://www.st.com/resource/en/application_note/an5093-getting-started-with-stm32g4-series--hardware-development-boards-stmicroelectronics.pdf
Application Notes | https://www.st.com/resource/en/application_note/an5306-operational-amplifier-opamp-usage-in-stm32g4-series-stmicroelectronics.pdf
Application Notes | https://www.st.com/resource/en/application_note/an5310-guideline-for-using-analog-features-of-stm32g4-series-versus-stm32f3-series-devices-stmicroelectronics.pdf
Application Notes | https://www.st.com/resource/en/application_note/an5315-stm32cube-firmware-examples-for-stm32g4-series-stmicroelectronics.pdf
Application Notes | https://www.st.com/resource/en/application_note/an5346-stm32g4-adc-use-tips-and-recommendations-stmicroelectronics.pdf
Application Notes | https://www.st.com/resource/en/application_note/an4899-stm32-microcontroller-gpio-hardware-settings-and-lowpower-consumption-stmicroelectronics.pdf

Application Notes | https://www.st.com/resource/en/application_note/an5612-esd-protection-of-stm32-mcus-and-mpus-stmicroelectronics.pdf
Application Notes | https://www.st.com/resource/en/application_note/an4991-how-to-wake-up-an-stm32-microcontroller-from-lowpower-mode-with-the-usart-or-the-lpuart-stmicroelectronics.pdf
Application Notes | https://www.st.com/resource/en/application_note/an4838-introduction-to-memory-protection-unit-management-on-stm32-mcus-stmicroelectronics.pdf
Application Notes | https://www.st.com/resource/en/application_note/an5325-how-to-use-the-cordic-to-perform-mathematical-functions-on-stm32-mcus-stmicroelectronics.pdf
Application Notes | https://www.st.com/resource/en/application_note/an4879-introduction-to-usb-hardware-and-pcb-guidelines-using-stm32-mcus-stmicroelectronics.pdf
Application Notes | https://www.st.com/resource/en/application_note/an5225-introduction-to-usb-typec-power-delivery-for-stm32-mcus-and-mpus-stmicroelectronics.pdf
Application Notes | https://www.st.com/resource/en/application_note/an4894-how-to-use-eeprom-emulation-on-stm32-mcus-stmicroelectronics.pdf
Application Notes | https://www.st.com/resource/en/application_note/an5537-how-to-use-adc-oversampling-techniques-to-improve-signaltonoise-ratio-on-stm32-mcus-stmicroelectronics.pdf
Application Notes | https://www.st.com/resource/en/application_note/an5405-how-to-use-fdcan-bootloader-protocol-on-stm32-mcus-stmicroelectronics.pdf
Application Notes | https://www.st.com/resource/en/application_note/an5978-introduction-to-mb1971-llc-hat-12-v-to-75-v1-a-for-f334-g474-nucleo-board-stmicroelectronics.pdf
Application Notes | https://www.st.com/resource/en/application_note/an5690-how-to-use-vrefbuf-peripheral-on-stm32-mcus-and-mpus-stmicroelectronics.pdf
Application Notes | https://www.st.com/resource/en/application_note/an4230-introduction-to-random-number-generation-validation-using-the-nist-statistical-test-suite-for-stm32-mcus-and-m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
Application Notes | https://www.st.com/resource/en/application_note/an2548-introduction-to-dma-controller-for-stm32-mcus-stmicroelectronics.pdf

Application Notes | https://www.st.com/resource/en/application_note/an4013-introduction-to-timers-for-stm32-mcus-stmicroelectronics.pdf
Application Notes | https://www.st.com/resource/en/application_note/an4277-how-to-use-pwm-shutdown-for-motor-control-and-digital-power-conversion-on-stm32-mcus-stmicroelectronics.pdf
Application Notes | https://www.st.com/resource/en/application_note/an4635-how-to-optimize-lpuart-power-consumption-on-stm32-mcus-stmicroelectronics.pdf
Application Notes | https://www.st.com/resource/en/application_note/an4908-getting-started-with-usart-automatic-baud-rater-detection-for-stm32-mcus-stmicroelectronics.pdf
Application Notes | https://www.st.com/resource/en/application_note/an5156-introduction-to-security-for-stm32-mcus-stmicroelectronics.pdf
Application Notes | https://www.st.com/resource/en/application_note/an5224-introduction-to-dmamux-for-stm32-mcus-stmicroelectronics.pdf
Application Notes | https://www.st.com/resource/en/application_note/an5543-guidelines-for-enhanced-spi-communication-on-stm32-mcus-and-mpus-stmicroelectronics.pdf
Application Notes | https://www.st.com/resource/en/application_note/an5348-introduction-to-fdcan-peripherals-for-stm32-mcus-stmicroelectronics.pdf
Application Notes | https://www.st.com/resource/en/application_note/cd00211314-how-to-optimize-the-adc-accuracy-in-the-stm32-mcus-stmicroelectronics.pdf
Application Notes | https://www.st.com/resource/en/application_note/an2639-soldering-recommendations-and-package-information-for-leadfree-ecopack2-mcus-and-mpus-stmicroelectronics.pdf
Application Notes | https://www.st.com/resource/en/application_note/an4566-how-to-extend-the-dac-performance-on-stm32-mcus-stmicroelectronics.pdf
Application Notes | https://www.st.com/resource/en/application_note/an5647-the-goertzel-algorithm-to-compute-individual-terms-of-the-discrete-fourier-transform-dft-in-stm32-products-stm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
Application Notes | https://www.st.com/resource/en/application_note/an2606-introduction-to-system-memory-boot-mode-on-stm32-mcus-stmicroelectronics.pdf
Application Notes | https://www.st.com/resource/en/application_note/an5036-guidelines-for-

| thermal-management-on-stm32-mcus-and-mpus-stmicroelectronics.pdf
Application Notes | https://www.st.com/resource/en/application_note/an3126-how-to-use-dac-for-audio-and-waveform-generation-on-stm32-mcus-and-mpus-stmicroelectronics.pdf
Application Notes | https://www.st.com/resource/en/application_note/an3155-how-to-use-usart-protocol-in-bootloader-on-stm32-mcus-stmicroelectronics.pdf
Application Notes | https://www.st.com/resource/en/application_note/an3156-how-to-use-usb-dfu-protocol-in-bootloader-on-stm32-mcus-stmicroelectronics.pdf
Application Notes | https://www.st.com/resource/en/application_note/an4286-how-to-use-spi-protocol-in-bootloader-on-stm32-mcus-stmicroelectronics.pdf
Application Notes | https://www.st.com/resource/en/application_note/an4759-introduction-to-using-the-hardware-realtime-clock-rtc-and-the-tamper-management-unit-tamp-for-stm32-mcus-stmic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
Application Notes | https://www.st.com/resource/en/application_note/an4776-how-to-use-generalpurpose-timer-peripheral-on-stm32-mcus-stmicroelectronics.pdf
Application Notes | https://www.st.com/resource/en/application_note/an4989-introduction-to-debug-toolbox-for-stm32-mcus-stmicroelectronics.pdf
Application Notes | https://www.st.com/resource/en/application_note/an5094-migrating-between-stm32f334303-and-stm32g431g474g491-mcus-stmicroelectronics.pdf
Application Notes | https://www.st.com/resource/en/application_note/an5738-guidelines-for-lifetime-estimation-on-stm32g4-mcus-stmicroelectronics.pdf
Application Notes | https://www.st.com/resource/en/application_note/an6363-introduction-to-clock-requirements-and-calibration-for-stm32-mcus-stmicroelectronics.pdf
Errata Sheets | https://www.st.com/resource/en/errata_sheet/es0431-stm32g431xx441xx-device-errata-stmicroelectronics.pdf
Datasheet | https://www.st.com/resource/en/datasheet/dm00507199.pdf
Programming Manuals | https://www.st.com/resource/en/programming_manual/pm0214-stm32-cortexm4-mcus-and-mpus-programming-manual-stmicroelectronics.pdf
Reference Manuals | https://www.st.com/resource/en/reference_manual/rm0440-stm32g4-series-advanced-armbased-32bit-mcus-stmicroelectronics.pdf

Technical Notes
& Articles

https://www.st.com/resource/en/technical_note/tn1163-description-ofwlcsp-for-microcontrollers-and-recommendations-for-its-use-

| stmicroelectronics.pdf
Technical Notes & Articles | https://www.st.com/resource/en/technical_note/tn1205-tape-and-reel-shipping-media-for-stm8-and-stm32-microcontrollers-in-fpn-packages-stmicroelectronics.pdf
Technical Notes & Articles | https://www.st.com/resource/en/technical_note/tn1206-tape-and-reel-shipping-media-for-stm8-and-stm32-microcontrollers-in-qfp-packages-stmicroelectronics.pdf
Technical Notes & Articles | https://www.st.com/resource/en/technical_note/tn1207-tape-and-reel-shipping-media-for-stm8-and-stm32-microcontrollers-in-so-packages-stmicroelectronics.pdf
Technical Notes & Articles | https://www.st.com/resource/en/technical_note/tn1208-tape-and-reel-shipping-media-for-stm8-and-stm32-microcontrollers-in-tssop-and-ssop-packages-stmicroelectronics.p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
Technical Notes & Articles | https://www.st.com/resource/en/technical_note/tn1433-reference-device-marking-schematics-for-stm32-microcontrollers-and-microprocessors-stmicroelectronics.pdf
Technical Notes & Articles | https://www.st.com/resource/en/technical_note/tn1204-tape-and-reel-shipping-media-for-stm32-devices-in-bga-packages-stmicroelectronics.pdf
User Manuals | https://www.st.com/resource/en/user_manual/um3167-stm32g4-series-ulcsaiec-607301603351-selftest-library-user-guide-stmicroelectronics.pdf
