dganin-hw/bldc-foc/hardware/stand/fasteners.csv

Деталь | Количество | Единица | Узел | Размер_или_условие | Статус
Винт M3×10 | 4 | шт. | Ножки | Длина из-под головки | По CAD, проверить примеркой
Винт M3×12 | 4 | шт. | Кронштейн мотора к основанию | Длина из-под головки | По CAD, проверить примеркой
Винт M3×16 | 12 | шт. | PCB 4 + опора энкодера 4 + рамка 4 | Головка у PCB ≤Ø7 | По CAD, проверить примеркой
Гайка M3 | 20 | шт. | Все соединения M3 | Шестигранная под ключ 5,5 | По CAD, проверить примеркой
Шайба M3 обычная | 24 | шт. | Ножки 4 + PCB 4 + моторный кронштейн 4 + опора 4 + рамка 8 | 3,2×7×0,5 | По CAD, проверить примеркой
Шайба M3 широкая | 4 | шт. | Под основанием в пазах опоры | 3,2×9×0,8 | По CAD, проверить примеркой
Шайба M5 широкая | 4 | шт. | Поверх рамки энкодера под малыми шайбами M3 | 5,3×15×1,2 | По CAD, проверить примеркой
Винт M2×16 | 4 | шт. | PCB энкодера | Латунь предпочтительна, головка ≤Ø4,5, без шайбы Ø5 у платы | По CAD, проверить примеркой
Винт M2×30 потайной | 4 | шт. | Крышка держателя магнита | Латунь, потай 90°, головка ≤Ø4,3, конус высотой ≤1,2, полная резьба | По CAD, проверить примеркой
Гайка M2 | 8 | шт. | PCB энкодера 4 + держатель 4 | Латунь, под ключ 4, высота ≤1,6 | По CAD, проверить примеркой
Винт M2,5, длина не утверждена | 4 | шт. | Мотор к стенке | Ввинчивание e = L - 5 - 0,5 мм, сверить допустимую глубину | Длина после проверки мотора
Шайба M2,5 | 4 | шт. | Мотор к стенке | 2,7×6×0,5 | По CAD, проверить примеркой
Штатный адаптер M5 и его два оригинальных винта | 1 | комплект | MN2212 к держателю | Болтовой адаптер по PDF, буртик Ø5,7, резьбовая часть 13 мм | Проверить наличие и исполнение в комплекте мотора
Гайка M5 тонкая DIN 439B | 2 | шт. | Крепление корпуса держателя и контрение | Латунь, M5×0,8, под ключ 8, высота 2,7 | По CAD, проверить примеркой
Шайба M5 обычная | 1 | шт. | Под корпусом держателя | Латунь, 5,3×10×1 | По CAD, проверить примеркой
Струбцина | 2 | шт. | Основание к столу | Зажимать над ножками, раствор под фактический стол | Подобрать по столу
Стяжка кабельная | 5 | шт. | Разгрузка проводов | Ширина ≤2,5 мм, ориентир 100 мм длиной | По трассе кабелей
