dganin-hw/bldc-foc/hardware/dev-board/manufacturing/placement/component-map.csv

Reference | Value | MPN_or_assembly | Footprint | X_from_left_mm | Y_from_top_mm | KiCad_angle_deg | Side | Physical_BOM | DNP | Note
C1 | 470u / 35V low ESR | EEUFR1V471 | Capacitor_THT:CP_Radial_D10.0mm_P5.00mm | 21.0 | 18.0 | 0.0 | TOP | True | False | Panasonic FR, 470uF 35V, D10 x H16 mm, lead pitch 5mm; 0.6mm leads.
C10 | 100n / 10V | CL10B104KB8NNNC | Capacitor_SMD:C_0603_1608Metric | 91.4 | 43.55 | -90.0 | TOP | True | False
C11 | 100n / 10V | CL10B104KB8NNNC | Capacitor_SMD:C_0603_1608Metric | 82.1 | 40.6 | 0.0 | TOP | True | False
C12 | 100n / 10V | CL10B104KB8NNNC | Capacitor_SMD:C_0603_1608Metric | 78.0 | 42.7 | 180.0 | TOP | True | False
C13 | 4.7u / 10V | CL21B475KPFNNNE | Capacitor_SMD:C_0805_2012Metric | 82.0 | 36.5 | 0.0 | TOP | True | False
C14 | 1u / 10V | CL10B105KO8NNNC | Capacitor_SMD:C_0603_1608Metric | 83.5 | 55.7 | 180.0 | TOP | True | False
C15 | 100n / 10V | CL10B104KB8NNNC | Capacitor_SMD:C_0603_1608Metric | 83.5 | 53.25 | 180.0 | TOP | True | False | At VDDA pin 21.
C16 | 100n / 10V | CL10B104KB8NNNC | Capacitor_SMD:C_0603_1608Metric | 86.0 | 54.2 | -90.0 | TOP | True | False | At VREF+ pin 20.
C17 | 1u / 10V | CL10B105KO8NNNC | Capacitor_SMD:C_0603_1608Metric | 87.0 | 57.0 | 0.0 | TOP | True | False | At VREF+ pin 20.
C18 | 100n / 10V | CL10B104KB8NNNC | Capacitor_SMD:C_0603_1608Metric | 74.6 | 44.0 | 0.0 | TOP | True | False
C19 | 47n / 50V X7R | CL10B473KB8NNNC | Capacitor_SMD:C_0603_1608Metric | 53.8 | 44.4 | 90.0 | TOP | True | False
C2 | 4.7u / 50V X7R | GRM32ER71H475KA88L | Capacitor_SMD:C_1210_3225Metric | 54.7 | 38.0 | 90.0 | TOP | True | False
C20 | 1u / 25V X7R | CL21B105KAFNNNE | Capacitor_SMD:C_0805_2012Metric | 52.4 | 48.2 | -90.0 | TOP | True | False
C21 | 100n / 50V | CL10B104KB8NNNC | Capacitor_SMD:C_0603_1608Metric | 53.8 | 51.5 | 0.0 | TOP | True | False
C22 | 10u / 50V X7R | GRM32ER71H106KA12L | Capacitor_SMD:C_1210_3225Metric | 51.0 | 55.0 | -90.0 | TOP | True | False
C23 | 1u / 10V | CL10B105KO8NNNC | Capacitor_SMD:C_0603_1608Metric | 67.0 | 44.0 | 0.0 | TOP | True | False
C24 | 100n / 10V | CL10B104KB8NNNC | Capacitor_SMD:C_0603_1608Metric | 67.2 | 51.8 | 0.0 | TOP | True | False
C25 | 1n / C0G | GRM1885C1H102JA01D | Capacitor_SMD:C_0603_1608Metric | 78.0 | 45.5 | 0.0 | TOP | True | False
C26 | 1n / C0G | GRM1885C1H102JA01D | Capacitor_SMD:C_0603_1608Metric | 78.0 | 51.0 | 0.0 | TOP | True | False
C27 | 1n / C0G | GRM1885C1H102JA01D | Capacitor_SMD:C_0603_1608Metric | 78.0 | 48.0 | 0.0 | TOP | True | False
C28 | 4.7u / 50V X7R | GRM32ER71H475KA88L | Capacitor_SMD:C_1210_3225Metric | 18.0 | 26.0 | 0.0 | TOP | True | False
C29 | 100n / 50V | CL10B104KB8NNNC | Capacitor_SMD:C_0603_1608Metric | 23.0 | 24.0 | 0.0 | TOP | True | False
C3 | 100n / 50V | CL10B104KB8NNNC | Capacitor_SMD:C_0603_1608Metric | 55.05 | 41.7 | 180.0 | TOP | True | False
C30 | 4.7u / 50V X7R | GRM32ER71H475KA88L | Capacitor_SMD:C_1210_3225Metric | 18.0 | 42.0 | 0.0 | TOP | True | False
C31 | 100n / 50V | CL10B104KB8NNNC | Capacitor_SMD:C_0603_1608Metric | 23.0 | 40.0 | 0.0 | TOP | True | False
C32 | 4.7u / 50V X7R | GRM32ER71H475KA88L | Capacitor_SMD:C_1210_3225Metric | 18.0 | 58.0 | 0.0 | TOP | True | False
C33 | 100n / 50V | CL10B104KB8NNNC | Capacitor_SMD:C_0603_1608Metric | 23.0 | 56.0 | 0.0 | TOP | True | False
C34 | 10n / 50V | CL10B103KB8NNNC | Capacitor_SMD:C_0603_1608Metric | 78.0 | 53.5 | 0.0 | TOP | True | False
C35 | 10n / 10V | CL10B103KB8NNNC | Capacitor_SMD:C_0603_1608Metric | 79.0 | 55.5 | 0.0 | TOP | True | False
C4 | 100n / 25V | CL10B104KB8NNNC | Capacitor_SMD:C_0603_1608Metric | 58.5 | 41.4 | 180.0 | TOP | True | False
C5 | 22u / 16V X7R | CL32B226KAJNNNE | Capacitor_SMD:C_1210_3225Metric | 70.8 | 34.4 | 180.0 | TOP | True | False
C6 | 22u / 16V X7R | CL32B226KAJNNNE | Capacitor_SMD:C_1210_3225Metric | 70.8 | 38.4 | 180.0 | TOP | True | False
C7 | 1u / 10V | CL10B105KO8NNNC | Capacitor_SMD:C_0603_1608Metric | 84.4 | 23.6 | 90.0 | TOP | True | False
C8 | 4.7u / 10V | CL21B475KPFNNNE | Capacitor_SMD:C_0805_2012Metric | 91.0 | 26.05 | 0.0 | TOP | True | False
C9 | 100n / 10V | CL10B104KB8NNNC | Capacitor_SMD:C_0603_1608Metric | 88.5 | 53.3 | 0.0 | TOP | True | False
D1 | BZT52C12 | BZT52C12-7-F | Diode_SMD:D_SOD-123 | 55.0 | 15.0 | 90.0 | TOP | True | False | 12 V VGS clamp; cathode at PMOS source.
D2 | SMBJ18A | SMBJ18A | Diode_SMD:D_SMB | 63.0 | 19.0 | 0.0 | TOP | True | False | Input transient clamp, NOT a continuous braking resistor.
D3 | SS16 | SS16 | Diode_SMD:D_SMA | 58.4 | 36.9 | 90.0 | TOP | True | False
D4 | POWER green | LTST-C190KGKT | LED_SMD:LED_0603_1608Metric | 95.0 | 5.0 | 0.0 | TOP | True | False
D5 | STATUS green | LTST-C190KGKT | LED_SMD:LED_0603_1608Metric | 95.0 | 9.0 | 0.0 | TOP | True | False
F1 | 2A fast / DC-rated | BK1/S501-2-R + 01110005MR x2 | Fuse:Fuseholder_Clip-5x20mm_Littelfuse_111_Inline_P20.00x5.00mm_D1.05mm_Horizontal | 18.0 | 5.0 | 0.0 | TOP | True | False | Assembly: two Littelfuse 111 clips plus one Eaton BK1/S501-2-R, 2A fast 5x20mm cartridge; not a phase-current limiter.
H1 | M3 NPTH |  | MountingHole:MountingHole_3.2mm_M3 | 4.0 | 4.0 | 0.0 | TOP | False | False
H2 | M3 NPTH |  | MountingHole:MountingHole_3.2mm_M3 | 104.0 | 4.0 | 0.0 | TOP | False | False
H3 | M3 NPTH |  | MountingHole:MountingHole_3.2mm_M3 | 104.0 | 77.0 | 0.0 | TOP | False | False
H4 | M3 NPTH |  | MountingHole:MountingHole_3.2mm_M3 | 4.0 | 77.0 | 0.0 | TOP | False | False
J1 | VIN 12V / GND | 1715721 | TerminalBlock_Phoenix:TerminalBlock_Phoenix_MKDS-1,5-2-5.08_1x02_P5.08mm_Horizontal | 7.0 | 16.0 | -90.0 | TOP | True | False | Phoenix MKDS 1.5/2-5.08; wire entry faces board left edge.
J2 | MOTOR A / B / C | 1715734 | TerminalBlock_Phoenix:TerminalBlock_Phoenix_MKDS-1,5-3-5.08_1x03_P5.08mm_Horizontal | 7.0 | 47.0 | -90.0 | TOP | True | False | Phoenix MKDS 1.5/3-5.08; wire entry faces board left edge.
J3 | ENC 3V3 GND SCK MISO MOSI CS | B-2100S06P-A110 | Connector_PinHeader_2.54mm:PinHeader_1x06_P2.54mm_Vertical | 104.0 | 13.0 | 0.0 | TOP | True | False
J4 | SWD VTREF GND IO CLK RESET | B-2100S05P-A110 | Connector_PinHeader_2.54mm:PinHeader_1x05_P2.54mm_Vertical | 104.0 | 31.0 | 0.0 | TOP | True | False
J5 | UART 3V3 GND TX RX | B-2100S04P-A110 | Connector_PinHeader_2.54mm:PinHeader_1x04_P2.54mm_Vertical | 104.0 | 47.0 | 0.0 | TOP | True | False
J6 | DSHOT / GND | B-2100S02P-A110 | Connector_PinHeader_2.54mm:PinHeader_1x02_P2.54mm_Vertical | 104.0 | 61.0 | 0.0 | TOP | True | False
J7 | EXTERNAL BUS LOAD | 1715721 | TerminalBlock_Phoenix:TerminalBlock_Phoenix_MKDS-1,5-2-5.08_1x02_P5.08mm_Horizontal | 7.0 | 32.0 | -90.0 | TOP | True | False | External VM/GND load connection; braking load is not included.
JP1 | BRIDGE POWER LINK | B-2100S02P-A110 | Connector_PinHeader_2.54mm:PinHeader_1x02_P2.54mm_Vertical | 63.0 | 4.0 | 90.0 | TOP | True | False
JP2 | ARM LINK | B-2100S02P-A110 | Connector_PinHeader_2.54mm:PinHeader_1x02_P2.54mm_Vertical | 75.0 | 63.0 | 90.0 | TOP | True | False
L1 | 33u / SRN6045TA-330M | SRN6045TA-330M | Inductor_SMD:L_Bourns_SRN6045TA | 63.9 | 36.0 | 0.0 | TOP | True | False
Q1 | PSMN7R0-60YS | PSMN7R0-60YS,115 | Package_TO_SOT_SMD:LFPAK56 | 23.0 | 32.0 | 180.0 | TOP | True | False
Q2 | PSMN7R0-60YS | PSMN7R0-60YS,115 | Package_TO_SOT_SMD:LFPAK56 | 35.0 | 32.0 | 180.0 | TOP | True | False
Q3 | PSMN7R0-60YS | PSMN7R0-60YS,115 | Package_TO_SOT_SMD:LFPAK56 | 23.0 | 48.0 | 180.0 | TOP | True | False
Q4 | PSMN7R0-60YS | PSMN7R0-60YS,115 | Package_TO_SOT_SMD:LFPAK56 | 35.0 | 48.0 | 180.0 | TOP | True | False
Q5 | PSMN7R0-60YS | PSMN7R0-60YS,115 | Package_TO_SOT_SMD:LFPAK56 | 23.0 | 64.0 | 180.0 | TOP | True | False
Q6 | PSMN7R0-60YS | PSMN7R0-60YS,115 | Package_TO_SOT_SMD:LFPAK56 | 35.0 | 64.0 | 180.0 | TOP | True | False
Q7 | IRFR5305TRPBF | IRFR5305TRPBF | Package_TO_SOT_SMD:TO-252-2 | 48.0 | 7.0 | 90.0 | TOP | True | False | Reverse polarity: drain toward input, source toward load. On-state permits regenerative current to source.
R1 | 10k | RC0603FR-0710KL | Resistor_SMD:R_0603_1608Metric | 59.0 | 14.0 | 90.0 | TOP | True | False
R10 | 1k | RC0603FR-071KL | Resistor_SMD:R_0603_1608Metric | 71.0 | 45.0 | 0.0 | TOP | True | False | Open-drain SDO; verify RC rise time with encoder cable. 3.3mA maximum static load.
R11 | 10k | RC0603FR-0710KL | Resistor_SMD:R_0603_1608Metric | 71.0 | 47.0 | 0.0 | TOP | True | False
R12 | 10k | RC0603FR-0710KL | Resistor_SMD:R_0603_1608Metric | 71.0 | 49.0 | 0.0 | TOP | True | False
R13 | 1k | RC0603FR-071KL | Resistor_SMD:R_0603_1608Metric | 72.0 | 54.0 | 0.0 | TOP | True | False
R14 | 10k | RC0603FR-0710KL | Resistor_SMD:R_0603_1608Metric | 72.5 | 41.5 | 0.0 | TOP | True | False
R15 | 100R | RC0603FR-07100RL | Resistor_SMD:R_0603_1608Metric | 75.0 | 46.0 | 0.0 | TOP | True | False
R16 | 100R | RC0603FR-07100RL | Resistor_SMD:R_0603_1608Metric | 75.0 | 51.0 | 0.0 | TOP | True | False
R17 | 100R | RC0603FR-07100RL | Resistor_SMD:R_0603_1608Metric | 75.0 | 48.0 | 0.0 | TOP | True | False
R18 | 2.2R | RC0603FR-072R2L | Resistor_SMD:R_0603_1608Metric | 28.0 | 28.0 | 180.0 | TOP | True | False
R19 | 100k | RC0603FR-07100KL | Resistor_SMD:R_0603_1608Metric | 28.0 | 30.5 | -90.0 | TOP | True | False
R2 | 2.2k / 1W | 25121WF2201T4E | Resistor_SMD:R_2512_6332Metric | 15.0 | 71.0 | 90.0 | TOP | True | False | Bus bleed; nominal 1.03 s RC with 470u.
R20 | 2.2R | RC0603FR-072R2L | Resistor_SMD:R_0603_1608Metric | 40.0 | 28.0 | 180.0 | TOP | True | False
R21 | 100k | RC0603FR-07100KL | Resistor_SMD:R_0603_1608Metric | 40.0 | 30.5 | -90.0 | TOP | True | False
R22 | 2.2R | RC0603FR-072R2L | Resistor_SMD:R_0603_1608Metric | 28.0 | 44.0 | 180.0 | TOP | True | False
R23 | 100k | RC0603FR-07100KL | Resistor_SMD:R_0603_1608Metric | 28.0 | 46.5 | -90.0 | TOP | True | False
R24 | 2.2R | RC0603FR-072R2L | Resistor_SMD:R_0603_1608Metric | 40.0 | 44.0 | 180.0 | TOP | True | False
R25 | 100k | RC0603FR-07100KL | Resistor_SMD:R_0603_1608Metric | 40.0 | 46.5 | -90.0 | TOP | True | False
R26 | 2.2R | RC0603FR-072R2L | Resistor_SMD:R_0603_1608Metric | 28.0 | 60.0 | 180.0 | TOP | True | False
R27 | 100k | RC0603FR-07100KL | Resistor_SMD:R_0603_1608Metric | 28.0 | 62.5 | -90.0 | TOP | True | False
R28 | 2.2R | RC0603FR-072R2L | Resistor_SMD:R_0603_1608Metric | 40.0 | 60.0 | 180.0 | TOP | True | False
R29 | 100k | RC0603FR-07100KL | Resistor_SMD:R_0603_1608Metric | 40.0 | 62.5 | -90.0 | TOP | True | False
R3 | 56k / 0.1% | RT0603BRD0756KL | Resistor_SMD:R_0603_1608Metric | 48.5 | 42.975 | 0.0 | TOP | True | False
R30 | 20m / 1% / 1W | WSK2512R0200FEA | Resistor_SMD:R_Shunt_Vishay_WSK2512_6332Metric_T1.19mm | 46.0 | 32.0 | 0.0 | TOP | True | False | 20mOhm 1% 1W, T=1.19mm. Four terminals: 1/4 force, 2/3 sense. Sense lands 1.70 x 0.76mm per Vishay drawing.
R31 | 20m / 1% / 1W | WSK2512R0200FEA | Resistor_SMD:R_Shunt_Vishay_WSK2512_6332Metric_T1.19mm | 46.0 | 48.0 | 0.0 | TOP | True | False | 20mOhm 1% 1W, T=1.19mm. Four terminals: 1/4 force, 2/3 sense. Sense lands 1.70 x 0.76mm per Vishay drawing.
R32 | 20m / 1% / 1W | WSK2512R0200FEA | Resistor_SMD:R_Shunt_Vishay_WSK2512_6332Metric_T1.19mm | 46.0 | 64.0 | 0.0 | TOP | True | False | 20mOhm 1% 1W, T=1.19mm. Four terminals: 1/4 force, 2/3 sense. Sense lands 1.70 x 0.76mm per Vishay drawing.
R33 | 33R | RC0603FR-0733RL | Resistor_SMD:R_0603_1608Metric | 86.25 | 38.5 | 90.0 | TOP | True | False
R34 | 33R | RC0603FR-0733RL | Resistor_SMD:R_0603_1608Metric | 88.6 | 38.5 | 90.0 | TOP | True | False
R35 | 33R | RC0603FR-0733RL | Resistor_SMD:R_0603_1608Metric | 96.0 | 15.0 | 90.0 | TOP | True | False
R36 | 33R | RC0603FR-0733RL | Resistor_SMD:R_0603_1608Metric | 96.0 | 19.0 | 90.0 | TOP | True | False
R37 | 10k | RC0603FR-0710KL | Resistor_SMD:R_0603_1608Metric | 96.0 | 25.0 | 0.0 | TOP | True | False
R38 | 100R | RC0603FR-07100RL | Resistor_SMD:R_0603_1608Metric | 96.0 | 61.0 | 0.0 | TOP | True | False
R39 | 47k | RC0603FR-0747KL | Resistor_SMD:R_0603_1608Metric | 94.0 | 65.0 | 0.0 | TOP | True | False
R4 | 10k / 0.1% | RT0603BRD0710KL | Resistor_SMD:R_0603_1608Metric | 51.0 | 43.8 | -90.0 | TOP | True | False
R40 | 100R | RC0603FR-07100RL | Resistor_SMD:R_0603_1608Metric | 96.0 | 49.0 | 0.0 | TOP | True | False
R41 | 100R | RC0603FR-07100RL | Resistor_SMD:R_0603_1608Metric | 96.0 | 53.0 | 0.0 | TOP | True | False
R42 | 49.9k / 0.1% | RT0603BRD0749K9L | Resistor_SMD:R_0603_1608Metric | 65.0 | 65.0 | 0.0 | TOP | True | False
R43 | 49.9k / 0.1% | RT0603BRD0749K9L | Resistor_SMD:R_0603_1608Metric | 68.0 | 67.0 | 0.0 | TOP | True | False
R44 | 10k / 0.1% | RT0603BRD0710KL | Resistor_SMD:R_0603_1608Metric | 71.0 | 69.0 | 0.0 | TOP | True | False
R45 | 10k / 1% | RC0603FR-0710KL | Resistor_SMD:R_0603_1608Metric | 74.0 | 58.0 | 0.0 | TOP | True | False
R5 | 100k | RC0603FR-07100KL | Resistor_SMD:R_0603_1608Metric | 49.7 | 39.9 | -90.0 | TOP | True | False
R6 | 2.2k | RC0603FR-072K2L | Resistor_SMD:R_0603_1608Metric | 89.0 | 5.0 | 0.0 | TOP | True | False
R7 | 0R / analog feed | RC0603JR-070RL | Resistor_SMD:R_0603_1608Metric | 80.0 | 57.0 | 0.0 | TOP | True | False | One ground plane; no split in ground. Optional ferrite needs resonance review.
R8 | 10k | RC0603FR-0710KL | Resistor_SMD:R_0603_1608Metric | 96.0 | 46.0 | 90.0 | TOP | True | False
R9 | 2.2k | RC0603FR-072K2L | Resistor_SMD:R_0603_1608Metric | 89.0 | 9.0 | 0.0 | TOP | True | False
SW1 | RESET | TL3342F160QG | Button_Switch_SMD:SW_SPST_TL3342 | 91.0 | 74.0 | 0.0 | TOP | True | False | E-Switch TL3342F160QG; reset.
SW2 | HOLD TO DISABLE | TL3342F160QG | Button_Switch_SMD:SW_SPST_TL3342 | 100.0 | 70.0 | 0.0 | TOP | True | False | Momentary ENABLE disable; firmware must enforce deliberate rearming.
TH1 | 10k / B3435 | NCP18XH103F03RB | Resistor_SMD:R_0603_1608Metric | 38.0 | 71.0 | 0.0 | TOP | True | False | Verify exact R-T table before firmware conversion.
TP1 | GND |  | TestPoint:TestPoint_Pad_D1.0mm | 33.0 | 22.0 | 0.0 | TOP | False | False
TP10 | DRV_nFAULT |  | TestPoint:TestPoint_Pad_D1.0mm | 94.0 | 58.0 | 0.0 | TOP | False | False
TP11 | TP_TIMING |  | TestPoint:TestPoint_Pad_D1.0mm | 94.0 | 63.0 | 0.0 | TOP | False | False
TP12 | SPI_MISO |  | TestPoint:TestPoint_Pad_D1.0mm | 96.0 | 22.0 | 0.0 | TOP | False | False
TP13 | PWM_AH |  | TestPoint:TestPoint_Pad_D1.0mm | 77.0 | 29.0 | 0.0 | TOP | False | False
TP14 | PWM_AL |  | TestPoint:TestPoint_Pad_D1.0mm | 81.0 | 29.0 | 0.0 | TOP | False | False
TP15 | PWM_BH |  | TestPoint:TestPoint_Pad_D1.0mm | 77.0 | 33.0 | 0.0 | TOP | False | False
TP16 | PWM_BL |  | TestPoint:TestPoint_Pad_D1.0mm | 81.0 | 33.0 | 0.0 | TOP | False | False
TP17 | PWM_CH |  | TestPoint:TestPoint_Pad_D1.0mm | 85.0 | 33.0 | 0.0 | TOP | False | False
TP18 | PWM_CL |  | TestPoint:TestPoint_Pad_D1.0mm | 85.0 | 30.0 | 0.0 | TOP | False | False
TP19 | ADC_IA |  | TestPoint:TestPoint_Pad_D1.0mm | 78.5 | 38.3 | 0.0 | TOP | False | False
TP2 | GND |  | TestPoint:TestPoint_Pad_D1.0mm | 64.0 | 57.0 | 0.0 | TOP | False | False
TP20 | ADC_IB |  | TestPoint:TestPoint_Pad_D1.0mm | 75.2 | 53.7 | 0.0 | TOP | False | False
TP21 | ADC_IC |  | TestPoint:TestPoint_Pad_D1.0mm | 74.5 | 55.7 | 0.0 | TOP | False | False
TP22 | ADC_VBUS |  | TestPoint:TestPoint_Pad_D1.0mm | 73.0 | 74.0 | 0.0 | TOP | False | False
TP23 | ADC_NTC |  | TestPoint:TestPoint_Pad_D1.0mm | 71.0 | 58.0 | 0.0 | TOP | False | False
TP24 | DRV_DVDD |  | TestPoint:TestPoint_Pad_D1.0mm | 69.0 | 42.2 | 0.0 | TOP | False | False
TP25 | GATE_H_A |  | TestPoint:TestPoint_Pad_D1.0mm | 25.2 | 27.0 | 0.0 | TOP | False | False
TP26 | PH_A |  | TestPoint:TestPoint_Pad_D1.0mm | 29.5 | 33.5 | 0.0 | TOP | False | False
TP27 | GATE_L_A |  | TestPoint:TestPoint_Pad_D1.0mm | 42.5 | 29.0 | 0.0 | TOP | False | False
TP28 | LS_A |  | TestPoint:TestPoint_Pad_D1.0mm | 40.0 | 33.5 | 0.0 | TOP | False | False
TP29 | GATE_H_B |  | TestPoint:TestPoint_Pad_D1.0mm | 25.2 | 43.0 | 0.0 | TOP | False | False
TP3 | GND |  | TestPoint:TestPoint_Pad_D1.0mm | 92.0 | 56.0 | 0.0 | TOP | False | False
TP30 | PH_B |  | TestPoint:TestPoint_Pad_D1.0mm | 29.5 | 49.5 | 0.0 | TOP | False | False
TP31 | GATE_L_B |  | TestPoint:TestPoint_Pad_D1.0mm | 42.5 | 45.0 | 0.0 | TOP | False | False
TP32 | LS_B |  | TestPoint:TestPoint_Pad_D1.0mm | 40.0 | 49.5 | 0.0 | TOP | False | False
TP33 | GATE_H_C |  | TestPoint:TestPoint_Pad_D1.0mm | 25.2 | 59.0 | 0.0 | TOP | False | False
TP34 | PH_C |  | TestPoint:TestPoint_Pad_D1.0mm | 29.5 | 65.5 | 0.0 | TOP | False | False
TP35 | GATE_L_C |  | TestPoint:TestPoint_Pad_D1.0mm | 42.5 | 61.0 | 0.0 | TOP | False | False
TP36 | LS_C |  | TestPoint:TestPoint_Pad_D1.0mm | 40.0 | 65.5 | 0.0 | TOP | False | False
TP4 | VIN_PROTECTED |  | TestPoint:TestPoint_Pad_D1.0mm | 56.0 | 22.0 | 0.0 | TOP | False | False
TP5 | VM |  | TestPoint:TestPoint_Pad_D1.0mm | 33.0 | 18.0 | 0.0 | TOP | False | False
TP6 | +5V |  | TestPoint:TestPoint_Pad_D1.0mm | 75.1 | 34.4 | 0.0 | TOP | False | False
TP7 | +3V3 |  | TestPoint:TestPoint_Pad_D1.0mm | 93.0 | 30.0 | 0.0 | TOP | False | False
TP8 | +3V3_A |  | TestPoint:TestPoint_Pad_D1.0mm | 84.0 | 61.0 | 0.0 | TOP | False | False
TP9 | DRV_ENABLE |  | TestPoint:TestPoint_Pad_D1.0mm | 72.0 | 67.0 | 0.0 | TOP | False | False
U1 | STM32G431CBT6 | STM32G431CBT6 | Package_QFP:LQFP-48_7x7mm_P0.5mm | 85.0 | 47.0 | 0.0 | TOP | True | False
U2 | DRV8323RSRGZT | DRV8323RSRGZT | Package_DFN_QFN:Texas_RGZ0048A_VQFN-48-1EP_7x7mm_P0.5mm_EP5.15x5.15mm_ThermalVias | 60.0 | 47.0 | 0.0 | TOP | True | False
U3 | AP2112K-3.3TRG1 | AP2112K-3.3TRG1 | Package_TO_SOT_SMD:SOT-23-5 | 87.0 | 27.0 | 0.0 | TOP | True | False
