dganin-hw/bldc-foc/hardware/encoder-board/manufacturing/placement/component-map.csv

Ref | Value | MPN | X_mm | Y_mm | Rotation_deg | Side | In_BOM
C1 | 100n / 16V X7R | CL10B104KB8NNNC | 105.5 | 99.1 | 90.0 | Top | True
C2 | 1u / 16V X7R | CL10B105KO8NNNC | 108.0 | 99.1 | 90.0 | Top | True
H1 | M2 / NPTH 2.2 |  | 88.0 | 90.0 | 0.0 | Top | False
H2 | M2 / NPTH 2.2 |  | 112.0 | 90.0 | 0.0 | Top | False
H3 | M2 / NPTH 2.2 |  | 112.0 | 110.0 | 0.0 | Top | False
H4 | M2 / NPTH 2.2 |  | 88.0 | 110.0 | 0.0 | Top | False
J1 | SM06B-GHS-TB(LF)(SN) | SM06B-GHS-TB(LF)(SN) | 100.0 | 110.5 | 180.0 | Bottom | True
R1 | 10k / 1% | RC0603FR-0710KL | 94.0 | 95.0 | -90.0 | Top | True
R2 | 47k / 1% | RC0603FR-0747KL | 91.5 | 98.7 | 90.0 | Top | True
R3 | 47k / 1% | RC0603FR-0747KL | 91.5 | 102.5 | 90.0 | Top | True
R4 | 33R / 1% | RC0603FR-0733RL | 94.5 | 99.35 | 180.0 | Top | True
TP1 | 3V3 |  | 108.0 | 94.5 | 0.0 | Top | False
TP2 | GND |  | 108.0 | 103.0 | 0.0 | Top | False
TP3 | ENC_CS |  | 95.0 | 91.8 | 0.0 | Top | False
TP4 | ENC_SCK |  | 88.0 | 96.0 | 0.0 | Top | False
TP5 | ENC_MOSI |  | 88.0 | 104.0 | 0.0 | Top | False
TP6 | SPI_MISO |  | 96.0 | 105.0 | 0.0 | Top | False
U1 | AS5047P-ATSM | AS5047P-ATSM | 100.0 | 100.0 | 0.0 | Top | True
