dganin-hw/bldc-foc/hardware/stand/step/stand-assembly.step

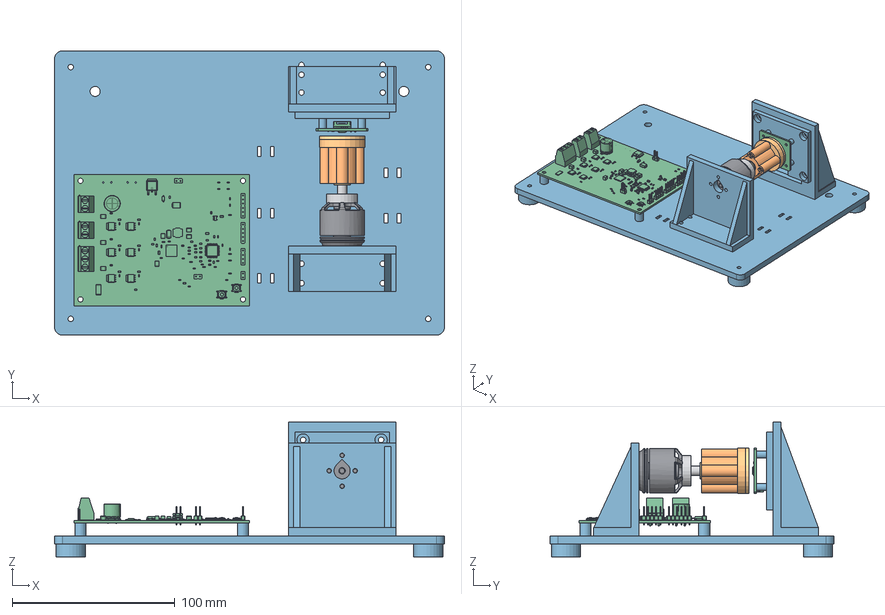
[picture p16: CAD file, 2026-10-20]
hardware/stand/step/stand-assembly.step
240.0 x 175.0 x 83.0 mm
01_base_1
02_foot_1
02_foot_2
02_foot_3
02_foot_4
03_pcb_spacer_1
03_pcb_spacer_2
03_pcb_spacer_3
03_pcb_spacer_4
04_motor_bracket_1
05_encoder_slide_1
06_encoder_frame_1
07_magnet_cup_1
08_magnet_tray_1
09_magnet_lid_1
REF_factory_motor
REF_adapter_PDF_envelope
REF_diametric_magnet_6x2p5
REF_M5_brass_thin_nut_1
REF_M5_brass_thin_nut_2
REF_M5_washer
REF_encoder_E0_R1
REF_main_A0_R1
