dganin-hw/bldc-foc/hardware/dev-board/mechanical/foc-dev-board.step

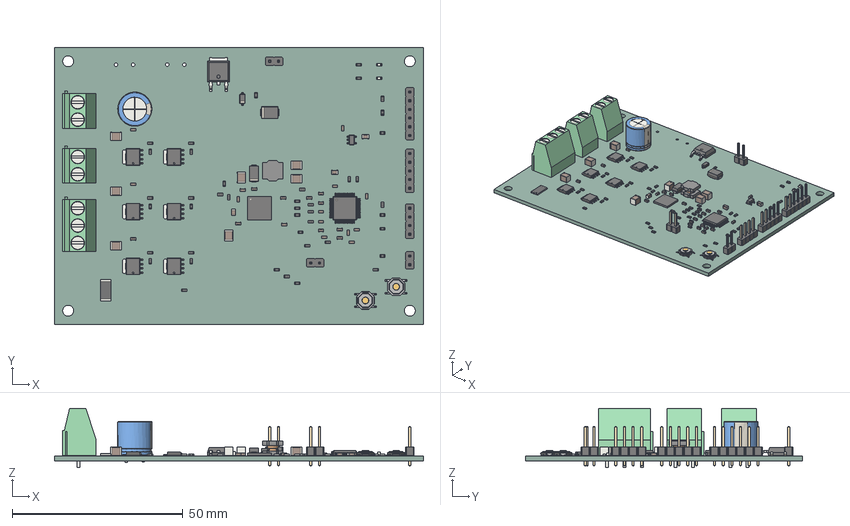
[picture p17: CAD file, 2026-10-20]
hardware/dev-board/mechanical/foc-dev-board.step
108.0 x 81.0 x 17.3 mm
C_0603_1608Metric x 24
C_1210_3225Metric x 7
C_0805_2012Metric x 3
R_0603_1608Metric x 42
SOT-23-5
CP_Radial_D100mm_P500mm
D_SMA
adbeea53-9c39-11ed-93f0-dde97e994e83_part x 6
adbeea54-9c39-11ed-93f0-dde97e994e83_part x 6
adbeea55-9c39-11ed-93f0-dde97e994e83_part x 6
D_SMB
D_SOD-123
TerminalBlock_Phoenix_MKDS-1,5-2-5.08_1x02_P5.08mm_Horizontal x 2
R_2512_6332Metric
PinHeader_1x06_P254mm_Vertical
PinHeader_1x02_P254mm_Vertical x 3
Texas_RGZ0048A_VQFN-48-1EP_7x7mm_P0.5mm_EP5.15x5.15mm
L_Bourns_SRN6045TA
SW_SPST_TL3342 x 2
LQFP-48_7x7mm_P0.5mm
PinHeader_1x05_P254mm_Vertical
PinHeader_1x04_P254mm_Vertical
LED_0603_1608Metric x 2
TerminalBlock_Phoenix_MKDS-1,5-3-5.08_1x03_P5.08mm_Horizontal
932d09b3-9c39-11ed-93f0-dde97e994e83_part
932d09b4-9c39-11ed-93f0-dde97e994e83_part
932d09b5-9c39-11ed-93f0-dde97e994e83_part
foc-dev-board_PCB
