dganin-hw/bldc-foc/hardware/encoder-board/mechanical/foc-encoder-User_Drawings.dxf

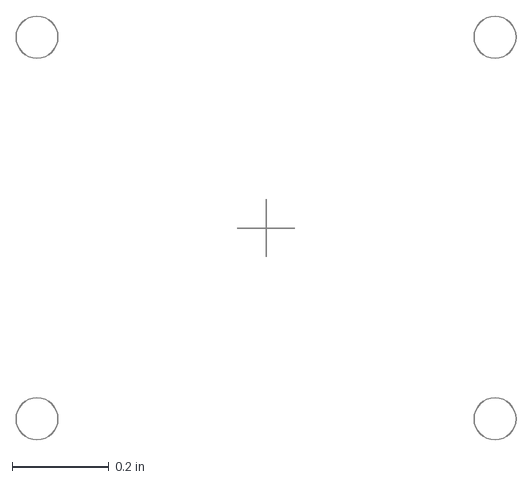
[picture p18: CAD file, 2026-10-20]
hardware/encoder-board/mechanical/foc-encoder-User_Drawings.dxf
1.03 x 0.874 in
