dganin-hw/bldc-foc/hardware/stand/step/11_gap_gauge_2mm.step

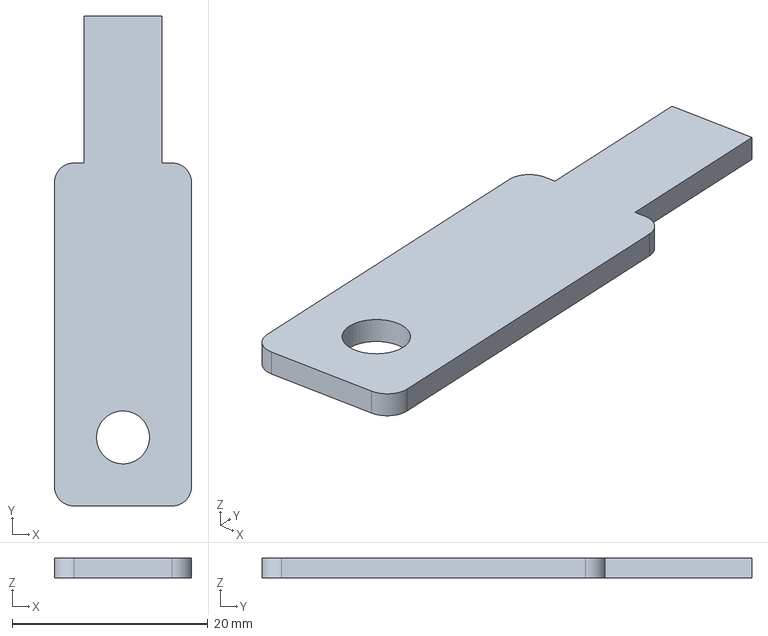
[picture p19: CAD file, 2026-10-20]
hardware/stand/step/11_gap_gauge_2mm.step
14.0 x 50.0 x 2.00 mm
