dganin-hw/bldc-foc/hardware/encoder-board/mechanical/foc-encoder-Edge_Cuts.dxf

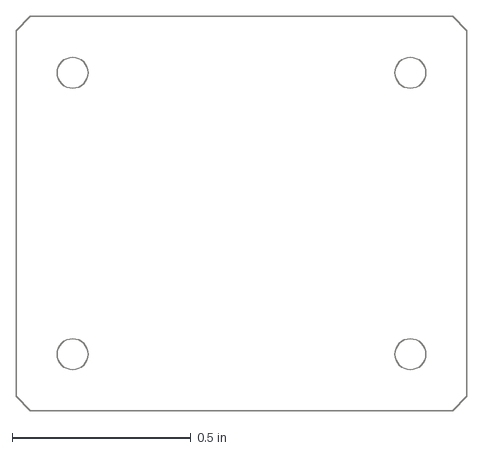
[picture p20: CAD file, 2026-10-20]
hardware/encoder-board/mechanical/foc-encoder-Edge_Cuts.dxf
1.26 x 1.10 in
