dganin-hw/bldc-foc/hardware/stand/step/10_fit_coupon.step

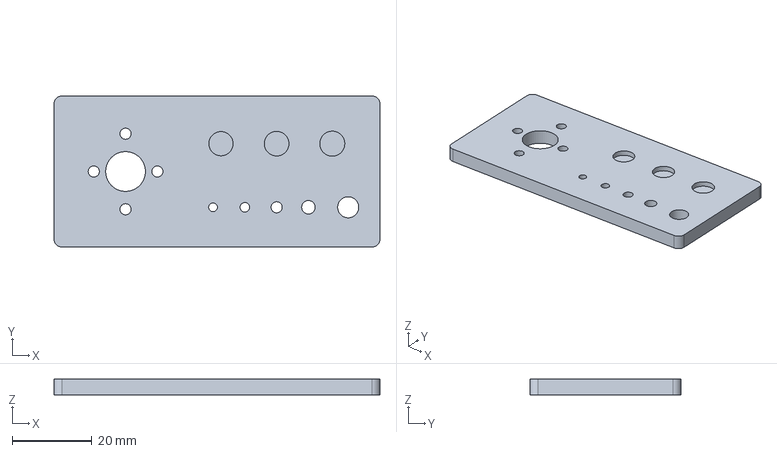
[picture p21: CAD file, 2026-10-20]
hardware/stand/step/10_fit_coupon.step
82.0 x 38.0 x 4.00 mm
