dganin-hw/bldc-foc/hardware/encoder-board/mechanical/foc-encoder.step

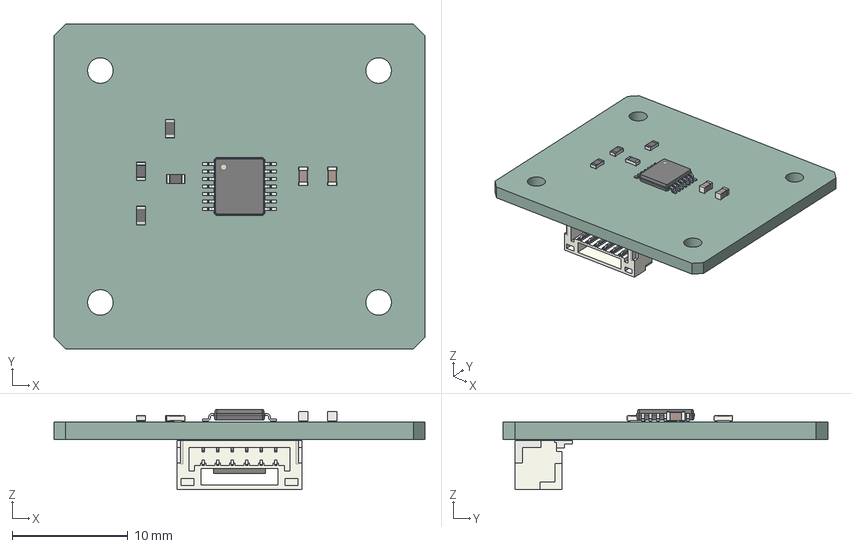
[picture p22: CAD file, 2026-10-20]
hardware/encoder-board/mechanical/foc-encoder.step
32.0 x 28.0 x 6.92 mm
R_0603_1608Metric x 4
C_0603_1608Metric x 2
TSSOP-14_4.4x5mm_P0.65mm
JST_SM06B_GHS_TB
foc-encoder_PCB
