dganin-hw/bldc-foc/hardware/stand/step/05_encoder_slide.step

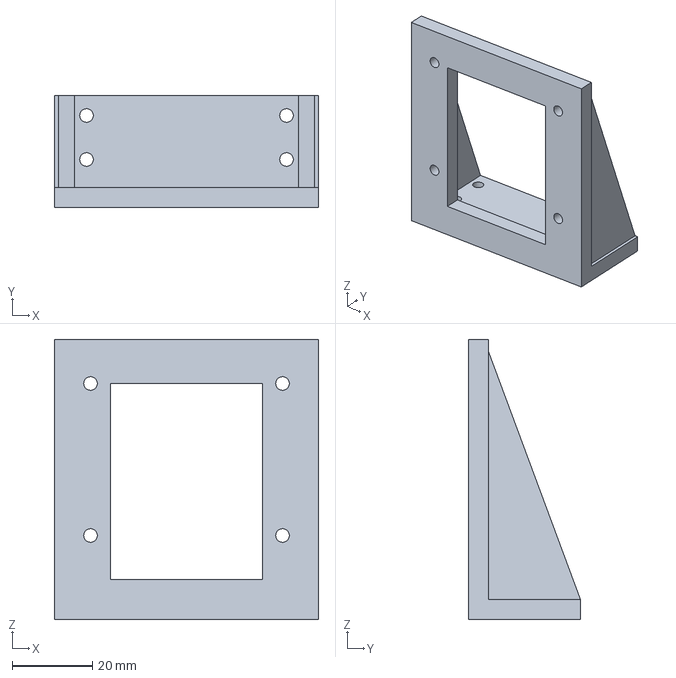
[picture p23: CAD file, 2026-10-20]
hardware/stand/step/05_encoder_slide.step
66.0 x 28.0 x 70.0 mm
