dganin-hw/bldc-foc/hardware/stand/step/04_motor_bracket.step

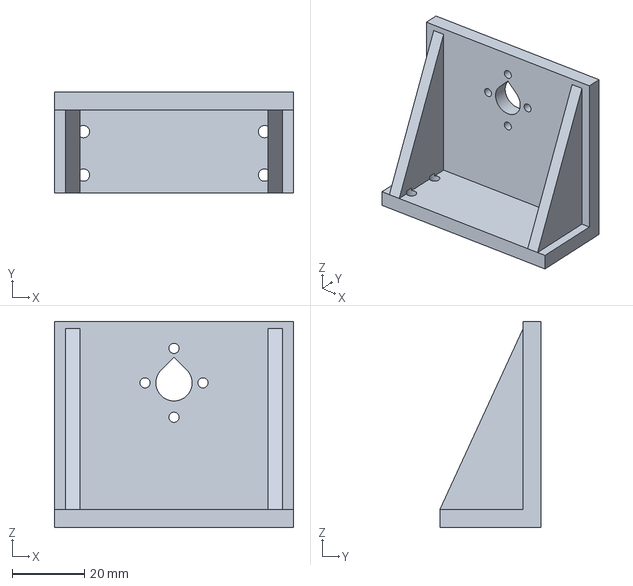
[picture p24: CAD file, 2026-10-20]
hardware/stand/step/04_motor_bracket.step
66.0 x 28.0 x 57.0 mm
