dganin-hw/bldc-foc/hardware/stand/step/06_encoder_frame.step

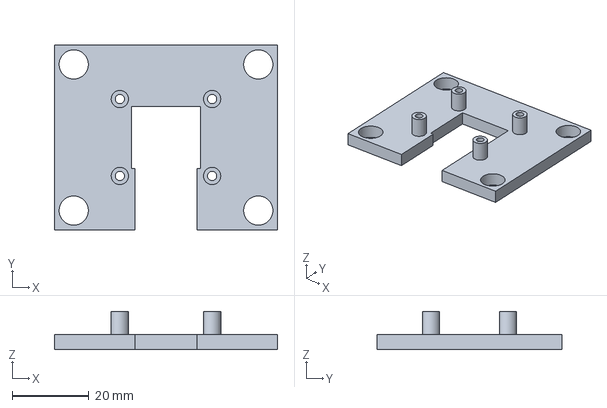
[picture p25: CAD file, 2026-10-20]
hardware/stand/step/06_encoder_frame.step
58.0 x 48.0 x 10.0 mm
