dganin-hw/bldc-foc/hardware/stand/step/08_magnet_tray.step

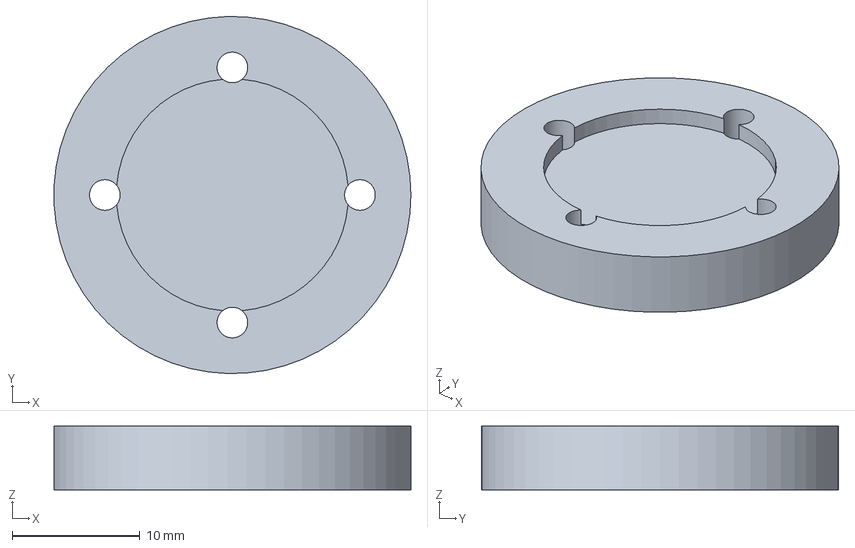
[picture p26: CAD file, 2026-10-20]
hardware/stand/step/08_magnet_tray.step
28.0 x 28.0 x 5.00 mm
