dganin-hw/bldc-foc/hardware/stand/step/07_magnet_cup.step

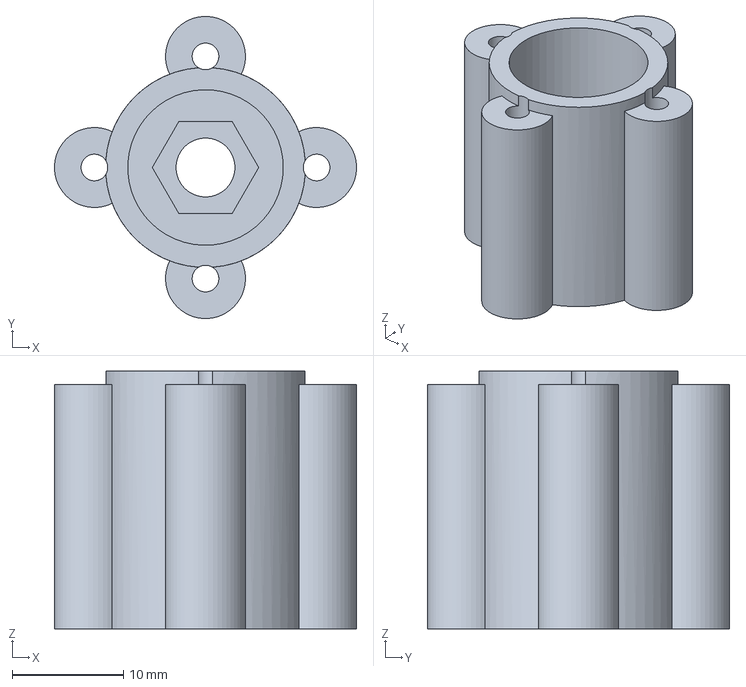
[picture p27: CAD file, 2026-10-20]
hardware/stand/step/07_magnet_cup.step
27.2 x 27.2 x 23.2 mm
