dganin-hw/bldc-foc/hardware/stand/step/03_pcb_spacer.step

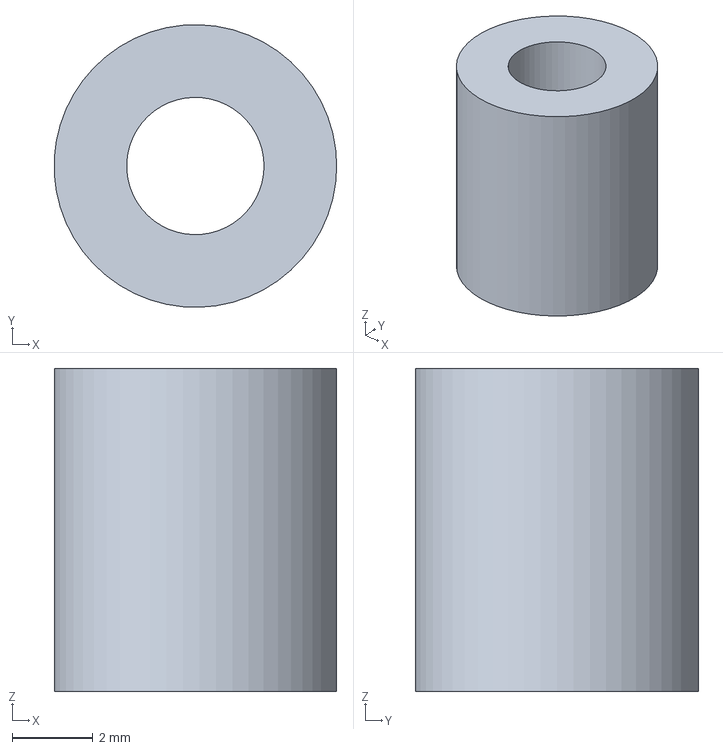
[picture p28: CAD file, 2026-10-20]
hardware/stand/step/03_pcb_spacer.step
6.99 x 7.00 x 8.00 mm
