dganin-hw/bldc-foc/hardware/stand/step/01_base.step

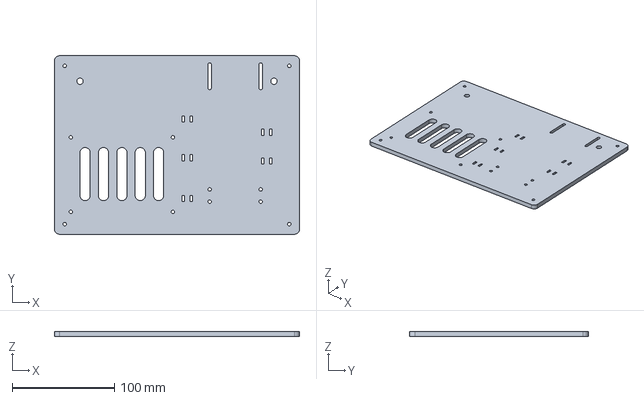
[picture p29: CAD file, 2026-10-20]
hardware/stand/step/01_base.step
240.0 x 175.0 x 5.00 mm
