dganin-hw/bldc-foc/hardware/stand/step/09_magnet_lid.step

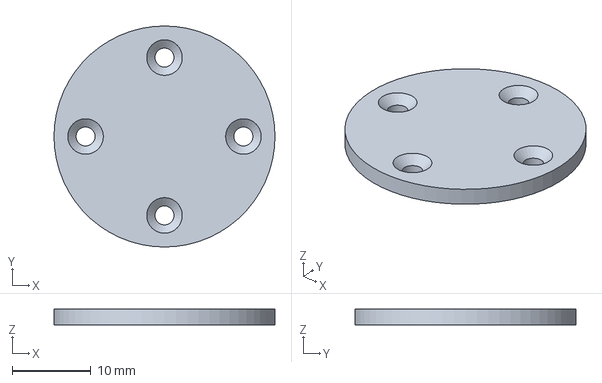
[picture p30: CAD file, 2026-10-20]
hardware/stand/step/09_magnet_lid.step
28.0 x 28.0 x 2.00 mm
