dganin-hw/bldc-foc/hardware/stand/step/02_foot.step

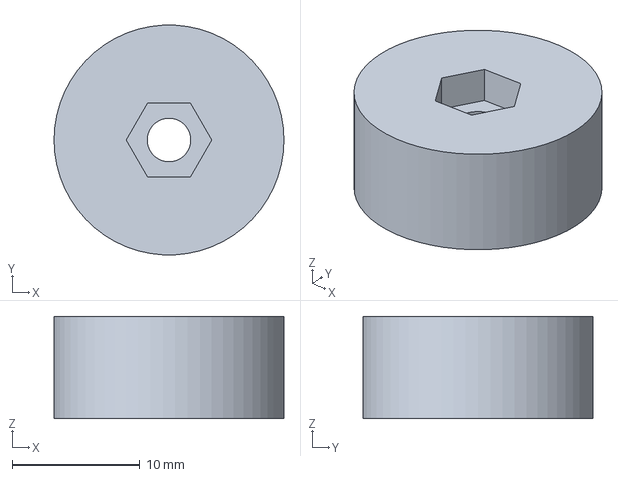
[picture p31: CAD file, 2026-10-20]
hardware/stand/step/02_foot.step
18.0 x 18.0 x 8.00 mm
