dganin-hw/bldc-foc/(list of files, cad)

Other CAD files:
hardware/stand/stl/01_base.stl
hardware/stand/stl/02_foot.stl
hardware/stand/stl/03_pcb_spacer.stl
hardware/stand/stl/04_motor_bracket.stl
hardware/stand/stl/05_encoder_slide.stl
hardware/stand/stl/06_encoder_frame.stl
hardware/stand/stl/07_magnet_cup.stl
hardware/stand/stl/08_magnet_tray.stl
hardware/stand/stl/09_magnet_lid.stl
hardware/stand/stl/10_fit_coupon.stl
hardware/stand/stl/11_gap_gauge_2mm.stl
