dganin-hw/bldc-foc/hardware/stand/print-layout.pdf

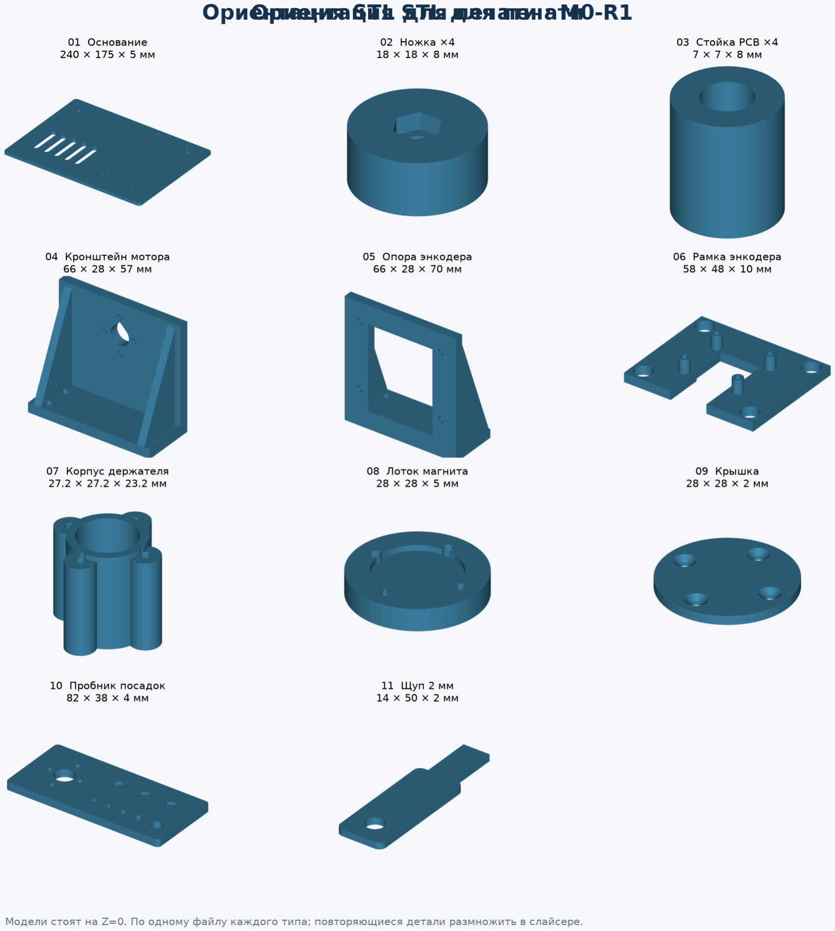
[picture p32: page 1]

Ориентация STL для печати
