dganin-hw/bldc-foc/hardware/stand/assembly.md

# Сборка стенда

Мотор, магнит и энкодер

## Крепёж на один стенд

Длины указаны для заданной геометрии, без прокладок под платой. Длина винтов M3 и
обычных M2 считается без головки, потайных M2 вместе с головкой. Резьба метрическая
с обычным шагом. Рядом с датчиком и во вращающемся держателе лучше латунь: не всякая
нержавейка немагнитна.

| Узел | Винты | Гайки | Шайбы |
|---|---|---|---|
| Четыре ножки | 4 × M3×10 | 4 × M3, в верхних гнёздах ножек | 4 × M3, Ø7×0,5 |
| Основная плата и стойки | 4 × M3×16 | 4 × M3, в нижних гнёздах основания | 4 × M3, **наружный Ø не больше 7**, толщина 0,5 |
| Кронштейн мотора к основанию | 4 × M3×12 | 4 × M3, снизу основания | 4 × M3, Ø7×0,5 |
| Опора энкодера к основанию | 4 × M3×16 | 4 × M3, снизу | сверху 4 × Ø7×0,5, снизу 4 × M3 широкие Ø9×0,8 |
| Рамка энкодера к опоре | 4 × M3×16 | 4 × M3, сзади | спереди 4 × широкие M5 Ø15×1,2 и **поверх них** 4 × M3 Ø7×0,5, сзади 4 × M3 Ø7×0,5 |
| Плата энкодера к рамке | 4 × M2×16, головка не шире Ø4,5 | 4 × M2, сзади рамки | обычные шайбы M2 Ø5 у платы не ставить, они не помещаются |
| Мотор к кронштейну | 4 × M2,5, **длина после проверки глубины** | резьба в моторе | 4 × M2,5, Ø6×0,5 |
| Штатный адаптер к ротору | два штатных винта адаптера | из комплекта мотора | из комплекта мотора |
| Корпус держателя на M5 адаптера | - | 2 × латунные тонкие M5 DIN 439B, под ключ 8, высота 2,7 | 1 × латунная M5, 5,3×10×1, под корпусом |
| Крышка и лоток к корпусу держателя | 4 × латунные **M2×30 потай 90°**, головка не шире Ø4,3, конус не выше 1,2, резьба на всю длину | 4 × латунные M2, под ключ 4, высота до 1,6 | нет |

Итого: M3×10 - 4, M3×12 - 4, M3×16 - 12, гаек M3 - 20, обычных шайб M3 - 24,
широких M3 - 4, широких M5 - 4, гаек M2 - 8. Ещё нужны две струбцины, стяжки шириной
до 2,5 мм, магнит и клей. Резьбовые вставки не нужны. Перед заказом крепежа сверить
его размеры с гнёздами на пробнике.

Широкая шайба в креплении рамки перекрывает отверстие Ø7,6 при смещении рамки, а
маленькая шайба M3 поверх неё держит головку винта. Одной обычной шайбы M3 здесь
мало. Пластик не затягивать так, как металлическое соединение.

## Порядок сборки

1. Вставить гайки M3 в четыре ножки, поставить ножки под основание и закрепить
   винтами M3×10 с шайбами сверху. Основание поднимается на 8 мм, снизу остаётся
   доступ к крепежу.
2. Вставить восемь гаек M3 снизу основания: четыре под плату, четыре под кронштейн
   мотора. Поставить четыре стойки 8 мм, на них основную плату и винты M3×16. Между
   платой и основанием 8 мм, выводы деталей не касаются пластика. Клеммники J1 и J2
   смотрят к левому краю.
3. Поставить кронштейн мотора на четыре винта M3×12. Широкая стенка смотрит к мотору,
   рёбра с обратной стороны.
4. Проверить резьбу M2,5 в моторе и допустимую глубину. При стенке 5 мм и шайбе
   0,5 мм винт входит в мотор на **e = L - 5 - 0,5** мм. Например, M2,5×8 войдёт на
   2,5 мм, но только если такая глубина допустима для этого мотора. Слишком длинный
   винт может повредить обмотку. На чертеже глубина не указана, по модели STEP её
   назначать нельзя.
5. Закрепить мотор четырьмя винтами. Отверстия: пара по горизонтали через 16 мм,
   пара по вертикали через 19 мм, вал проходит через фигурный вырез. Это не
   прямоугольник 16 × 19. Проверить, что провода мотора не зажаты между мотором и стенкой.
6. Поставить штатный адаптер M5 его родными винтами. Резьба в роторе на чертеже не
   подписана, подбирать винты по диаметру отверстия нельзя, нужен штатный комплект.
7. Вложить первую тонкую гайку M5 в шестигранное гнездо корпуса `07`, надеть
   латунную шайбу M5 на адаптер и навернуть корпус до упора в шайбу. Гайку держит
   от проворота шестигранный карман. Вторая тонкая гайка ставится сверху внутри
   корпуса и контрит первую. Корпус придерживать, работать тонкостенной глубокой
   головкой на 8 с наружным диаметром **не больше 13 мм**, полость Ø14. Штатную
   высокую гайку-колпак здесь не использовать.
8. Проверить посадку и биение, провернув мотор рукой. По резьбе набирается шайба 1 +
   дно корпуса 4 + две гайки по 2,7 = **10,4 мм** при длине резьбы 13 мм. Обе гайки
   должны полностью сидеть на резьбе, не упираться в её конец, PETG не должен
   сминаться. Настоящий адаптер может отличаться от чертежа.
9. Вклеить магнит Ø6 × 2,5 в лоток `08`. Карман шире магнита на 0,2 мм и глубиной
   1,4 мм, магнит выступает на 1,1 мм в выемку крышки глубиной 1,2 мм. Учесть слой
   клея: крышка должна лечь на лоток плоскостью. Магнит ставить по центру, а не
   прижимать к краю. Дождаться отверждения клея. Положить лоток на корпус, закрыть
   крышкой `09` и стянуть четырьмя M2×30 с гайками в задних карманах корпуса.
   Буртик корпуса Ø18×1,2 входит в выемку лотка Ø18,2×1,3 и центрирует лоток
   независимо от зазоров винтов. Головки винтов должны полностью утонуть в потаях.
   Перед пуском убедиться, что магнит, лоток, крышка и корпус вращаются как одно целое.
10. Прикрутить опору `05` четырьмя M3×16 через продольные пазы основания, пока не
    затягивая, снизу широкие шайбы M3. Собрать рамку `06` с платой энкодера:
    **AS5047P смотрит на магнит**, стойки упираются в обратную сторону платы, разъём
    JST GH попадает в вырез. Притянуть плату четырьмя M2×16 с гайками сзади рамки,
    без шайб Ø5 у платы.
11. Поставить рамку на опору четырьмя M3×16. Широкие шайбы спереди рамки, обычные
    шайбы M3 поверх широких под головками и сзади под гайками. Отцентровать U1 по
    оси магнита. Рамка смещается в круге радиусом до 2,1 мм, это не квадрат ±2,1 мм
    по каждой оси.
12. Без питания выставить начальный зазор **2 мм от крышки держателя до корпуса U1**.
    Вставить щуп узким концом между ними, затянуть опору, убрать щуп и провернуть
    мотор рукой на полный оборот. Пазы дают 12 мм хода и не ограничивают минимальный
    зазор, касание недопустимо. После проверки диагностики AS5047P зазор подбирается
    заново с учётом поля и биения. Защёлка J1 доступна сзади.
13. Закрепить кабели стяжками в прорезях основания. Кабель SPI от J3 до разъёма
    энкодера около **150 мм**, с небольшим запасом на движение опоры, петлю не
    класть рядом с вращающимися деталями. Фазные провода вести вдоль переднего края
    к J2, это примерно 230-260 мм. Штатных выводов мотора может не хватить: резать
    провода только после примерки, при необходимости сделать три удлинителя.
14. Прижать основание к столу двумя струбцинами над ножками, например у левого
    заднего и правого переднего угла. Губки не должны касаться платы и гнуть основание.

Механическая сборка не означает, что мотор готов к включению. Ток, обороты и
торможение задаются планом первого запуска в
[памятке по основной плате](../dev-board/bring-up.md).
