dganin-hw/bldc-foc/hardware/dev-board/bring-up.md

# Сборка и первое включение основной платы

Плата под питанием ещё не включалась. Здесь описан порядок, который позволяет
проверить её по частям: сначала питание логики, потом драйвер без ШИМ, потом ШИМ
без мотора и только в конце мотор с малым током.

## Механика

- Плата 108 × 81 мм, 4 слоя меди, FR-4 1,6 мм. Контур в CAD: X от 40 до 148 мм,
  Y от 43 до 124 мм.
- Отверстия H1-H4 Ø3,2 мм без металлизации, координаты (44; 47), (144; 47),
  (144; 120) и (44; 120). Головки винтов, шайбы и стойки не шире Ø7 мм. Рядом
  с разъёмами большие шайбы не ставить.
- Провода в J1, J7 и J2 заходят слева, со стороны края платы. При затяжке
  придерживать клеммник, момент 0,5-0,6 Н·м.

## Детали, на которые смотреть при сборке

Полный перечень в [`manufacturing/bom/BOM.csv`](manufacturing/bom/BOM.csv). Здесь только
позиции, где легко ошибиться.

| Позиция | Деталь | На что смотреть |
|---|---|---|
| C1 | Panasonic EEUFR1V471 | 470 мкФ, 35 В, D10 × H16 мм, шаг 5 мм. Плюс на контакт 1 (VM). Корпус по допуску бывает до 17,5 мм, над клапаном нужен запас. [Описание](https://industrial.panasonic.com/ww/products/pt/aluminum-cap-lead/models/EEUFR1V471), [чертёж серии FR](https://industrial.panasonic.com/cdbs/www-data/pdf/RDF0000/ABA0000C1259.pdf) |
| R30-R32 | Vishay WSK2512R0200FEA | 20 мОм, 1%, 1 Вт, вариант T=1,19 мм. Выводы 1 и 4 силовые, 2 и 3 измерительные. Измерительные площадки 1,70 × 0,76 мм не соединять с силовой медью. [Документация](https://www.vishay.com/docs/30108/wsk2512.pdf) |
| Q1-Q6 | Nexperia PSMN7R0-60YS,115 | LFPAK56: выводы 1, 2, 3 исток, 4 затвор, 5 (корпус) сток |
| U2 | TI DRV8323RSRGZT | VQFN48, тепловая площадка 49 = GND. Проверить метку первого вывода |
| J1, J7 | Phoenix Contact 1715721 | MKDS 1,5/2-5,08. J1: 1 = вход питания, 2 = GND. J7: 1 = VM, 2 = GND. [Описание](https://www.phoenixcontact.com/en-us/products/printed-circuit-board-terminal-mkds-15-2-508-1715721) |
| J2 | Phoenix Contact 1715734 | MKDS 1,5/3-5,08, фазы A, B, C на контактах 1, 2, 3. [Описание](https://www.phoenixcontact.com/en-us/products/printed-circuit-board-terminal-mkds-15-3-508-1715734) |
| F1 | 2 × Littelfuse 01110005MR и Eaton BK1/S501-2-R | Две клипсы и быстрая керамическая вставка 2 А, 5 × 20 мм. Один символ F1 на схеме означает три детали. [Клипсы](https://www.littelfuse.com/assetdocs/111-mr-series-datasheet?assetguid=bc74b1bc-7507-4786-9a59-0f9eb414f154), [вставка](https://www.eaton.com/content/dam/eaton/products/electronic-components/resources/data-sheet/eaton-s501-ceramic-tube-fuses-data-sheet.pdf) |
| SW1, SW2 | E-Switch TL3342F160QG | SW1 = RESET, SW2 = отключение ENABLE, пока кнопка нажата. [Чертёж](https://configured-product-images.s3.amazonaws.com/2D/specs/TL3342F160QG.pdf) |

Номинал вставки F1 не ограничивает ток фазы. Паспортный ток клеммника тоже не
равен допустимому току платы.

## Пайка U2

Под тепловой площадкой U2 стоят 25 сквозных отверстий Ø0,20 мм с площадками
Ø0,50 мм. Сверху окно в маске открывает площадку вместе с отверстиями. Снизу
нижняя площадка 4,5 × 4,5 мм и все отверстия закрыты маской (тентирование, без
заполнения смолой). Нижнюю маску не вскрывать, отверстия не рассверливать.

1. Паять дозированной пастой и феном с подогревом снизу. Паяльником тепловую
   площадку не достать.
2. Сначала U2 и остальной SMD, потом высокий C1 и клеммники, чтобы они не мешали
   греть и осматривать.
3. Не заливать площадку лишним припоем. Проверить перемычки между выводами и
   ровную посадку корпуса.
4. После пайки прозвонить шины питания и затворы на короткое замыкание. Качество
   пайки тепловой площадки на глаз не проверить.

TI рекомендует обрабатывать отверстия под пастой, здесь выбрано именно закрытие
маской снизу. Источник: [документация DRV832x](https://www.ti.com/lit/ds/symlink/drv8323.pdf),
корпус RGZ0048A, примеры платы и трафарета на с. 94-95.

## Настройка DRV8323 до первого ШИМ

**Предел 1 А задаёт прошивка, а не железо.** С шунтом 20 мОм минимальный порог
SEN_OCP (0,25 В) соответствует примерно 12,5 А, а значение после сброса
(SEN_LVL = 11b, 1 В) примерно 50 А. Это пороги компаратора с задержками и допусками,
а не точный ограничитель. Блок питания с ограничением тока и предохранитель 2 А
тоже не защищают фазу.

До первого импульса ШИМ записать в драйвер и **прочитать обратно**: режим ШИМ,
токи затворов, dead-time, VDS_OCP, OCP_MODE, OCP_DEG, CSA_FET, VREF_DIV, CSA_GAIN,
DIS_SEN, SEN_LVL и флаг окончания калибровки. Для внешних шунтов и масштаба
0,8 В/А нужно CSA_FET = 0, VREF_DIV = 1, CSA_GAIN = 11b (усиление 40). Значения
после сброса не считаются успешной записью.

Если прочитанное не совпало, SPI выдал ошибку или висит авария, ШИМ запрещён.
После сброса, сна драйвера или пропадания VM настройку повторить.

SW2 - кнопка без фиксации. Это не аварийный выключатель и не разрыв питания.
После отпускания прошивка не должна запускаться сама: она остаётся в выключенном
состоянии до отдельной команды. То же после аварии, сброса, watchdog, отладчика и
пропадания питания. Проверить полярность TIM1_BKIN, сигнал nFAULT и выключенное
состояние выходов GH/GL. Наличие сигналов на схеме ещё не значит, что защита работает.

Источник: [документация DRV832x](https://www.ti.com/lit/ds/symlink/drv8323.pdf),
раздел 8.3.7, таблицы 8-18 и 8-19.

## Знак и масштаб тока

Положительным считается ток через шунт от истока нижнего ключа к GND. При
VREF = 3,3 В, VREF_DIV = 1 и усилении 40:

```text
VSO = 1,65 В - I × 0,8 В/А
I   = (VSO_zero - VSO) / 0,8 В/А
```

- `VSO_zero` измерить для каждой фазы отдельно при нулевом токе.
- Положительный ток уменьшает VSO. Линейная область выхода от 0,25 В до 3,05 В,
  то есть примерно ±1,75 А.
- Знак и масштаб проверить известным малым током до замыкания контура. Знак в
  прошивке не менять наугад. Проверить, что фазы A, B, C не перепутаны.

## Окно АЦП и ШИМ

Токи фаз **измеряются не одновременно**. По схеме и `CubeMX.ioc`:

| Фаза | Вход | АЦП |
|---|---|---|
| A | PA0 | ADC1_IN1, injected, первый в очереди |
| C | PA1 | ADC1_IN2, injected, второй в очереди |
| B | PA4 | ADC2_IN17, injected, первый в очереди |

C измеряется после A. Общий запуск от TIM1 сам по себе не делает ADC1 и ADC2
синхронными: нужно проверить режим, задержки и готовность обоих результатов.

При 48 кГц период ШИМ около 20,83 мкс. При скважности 97% нижний ключ открыт
всего 625 нс. Только dead-time 400 нс и установление усилителя при усилении 40
(по документации DRV8323 около 1,2 мкс до 1%) уже дают около 1,6 мкс, ещё без
выборки АЦП. Поэтому предел 97% из `foc_config.h` на первом запуске не подходит,
реальный предел будет заметно ниже. При усилении 20 установление вдвое быстрее
(около 600 нс), но масштаб становится 0,4 В/А.

Допустимый диапазон скважности и момент запуска АЦП определить по осциллографу:
переключение затворов, установление усилителя и RC-фильтра, время выборки,
порядок каналов. Отдельно проверить, сколько событий TIM1 TRGO приходит за период
при центрированном счёте: на один период ШИМ должен приходиться ровно один шаг FOC.

Файлы: [`cubemx/CubeMX.ioc`](cubemx/CubeMX.ioc),
[`firmware/src/foc/foc_config.h`](../../firmware/src/foc/foc_config.h). Как работают
injected-каналы, совместный режим АЦП и TIM1, описано в
[RM0440](https://www.st.com/resource/en/reference_manual/rm0440-stm32g4-series-advanced-armbased-32bit-mcus-stmicroelectronics.pdf).

## Порядок первого включения

1. **Без питания и мотора.** Снять JP1 и JP2. Разрядить VM и проверить вольтметром.
   Осмотреть пайку и ориентацию деталей. Измерить сопротивление VIN, VIN_PROTECTED,
   VM, +5V и +3V3 относительно GND (с поправкой на заряд конденсаторов).
   Программатор подключить так, чтобы VTREF был только входом опорного напряжения
   и не питал плату.
2. **Только логика.** Подать 12 В на J1 от лабораторного источника с ограничением
   тока. С открытой JP1 питаются только понижающий преобразователь и LDO.
   Проверить +5V, +3V3, аналоговые 3,3 В и отсутствие нагрева. VM моста и
   драйвера не питается, поэтому драйвер по SPI сейчас не ответит, это нормально.
   На этом шаге проверяются МК и его питание: SWD, светодиод, UART.
3. **Подготовка драйвера.** Выключить источник, дождаться разряда C1 через R2 и
   проверить это вольтметром. Только потом установить JP1. JP2 пока не ставить.
   Тестовая прошивка держит все ШИМ выключенными, MOE таймера TIM1 запрещён.
   Мотор не подключать. Перемычки и мотор под напряжением не переключать.
4. **Драйвер без ШИМ.** Подать питание, проверить VM. Без JP2 резистор R14 держит
   ENABLE в нуле. Затем при снятом питании установить JP2, запустить тестовую
   прошивку с запрещёнными ШИМ и MOE и включить драйвер командой. Выдержать
   задержки из документации, проверить SPI и регистры аварий, записать настройки,
   прочитать их обратно и откалибровать усилители. Любое расхождение означает стоп.
5. **Осциллограф без мотора.** Только короткие тестовые импульсы. Проверить пары
   GH/SH и GL/исток, dead-time, отсутствие перекрытия, срабатывание nFAULT, BKIN и
   SW2, повторное включение только вручную. Землю осциллографа подключать только
   к GND, затвор и исток верхнего ключа мерить дифференциальным щупом. Окно АЦП
   проверить до включения обратной связи по току.
6. **Первый запуск мотора.** Обесточить плату и разрядить VM, потом подключить мотор
   и энкодер. Мотор закрепить, пропеллер и любую опасную нагрузку убрать. Ещё раз
   проверить настройки и защиты. Начать с тока не больше 0,3 А, следить за
   температурой, фактическим током и VM. К 1 А переходить только после измерений
   и проверки нагрева.

## Торможение и рекуперация

TVS-диод SMBJ18A не держит VM на уровне 16 В и не поглощает энергию торможения.
16 В - это верхняя граница рабочего диапазона, а не порог TVS. Обычный
лабораторный источник может не принимать энергию обратно, а открытый Q7 пропускает
обратный ток в источник.

Для опытов с торможением нужна внешняя нагрузка на J7 (VM и GND) или источник,
который умеет поглощать энергию. Такой нагрузки нет в BOM, её сопротивление и
мощность нужно рассчитать отдельно. Во время опыта следить за VM и останавливаться
при выходе из диапазона. Выключение ШИМ или ENABLE не отменяет рекуперацию:
вращающийся мотор заряжает шину через диоды ключей.

Источник: [документация DRV832x](https://www.ti.com/lit/ds/symlink/drv8323.pdf),
разделы 10.1 Generator Mode и 10.2 Bulk Capacitance.

## Что записывать

Версию прошивки, блок питания и его ограничения, положение JP1 и JP2, прочитанные
регистры драйвера, нули, знаки и масштабы токов, осциллограммы ШИМ, АЦП и защит,
напряжение VM и температуры. Пока этих результатов нет, плата не считается проверенной.
