dganin-hw/bldc-foc/hardware/dev-board/documentation/SCHEMATIC.pdf

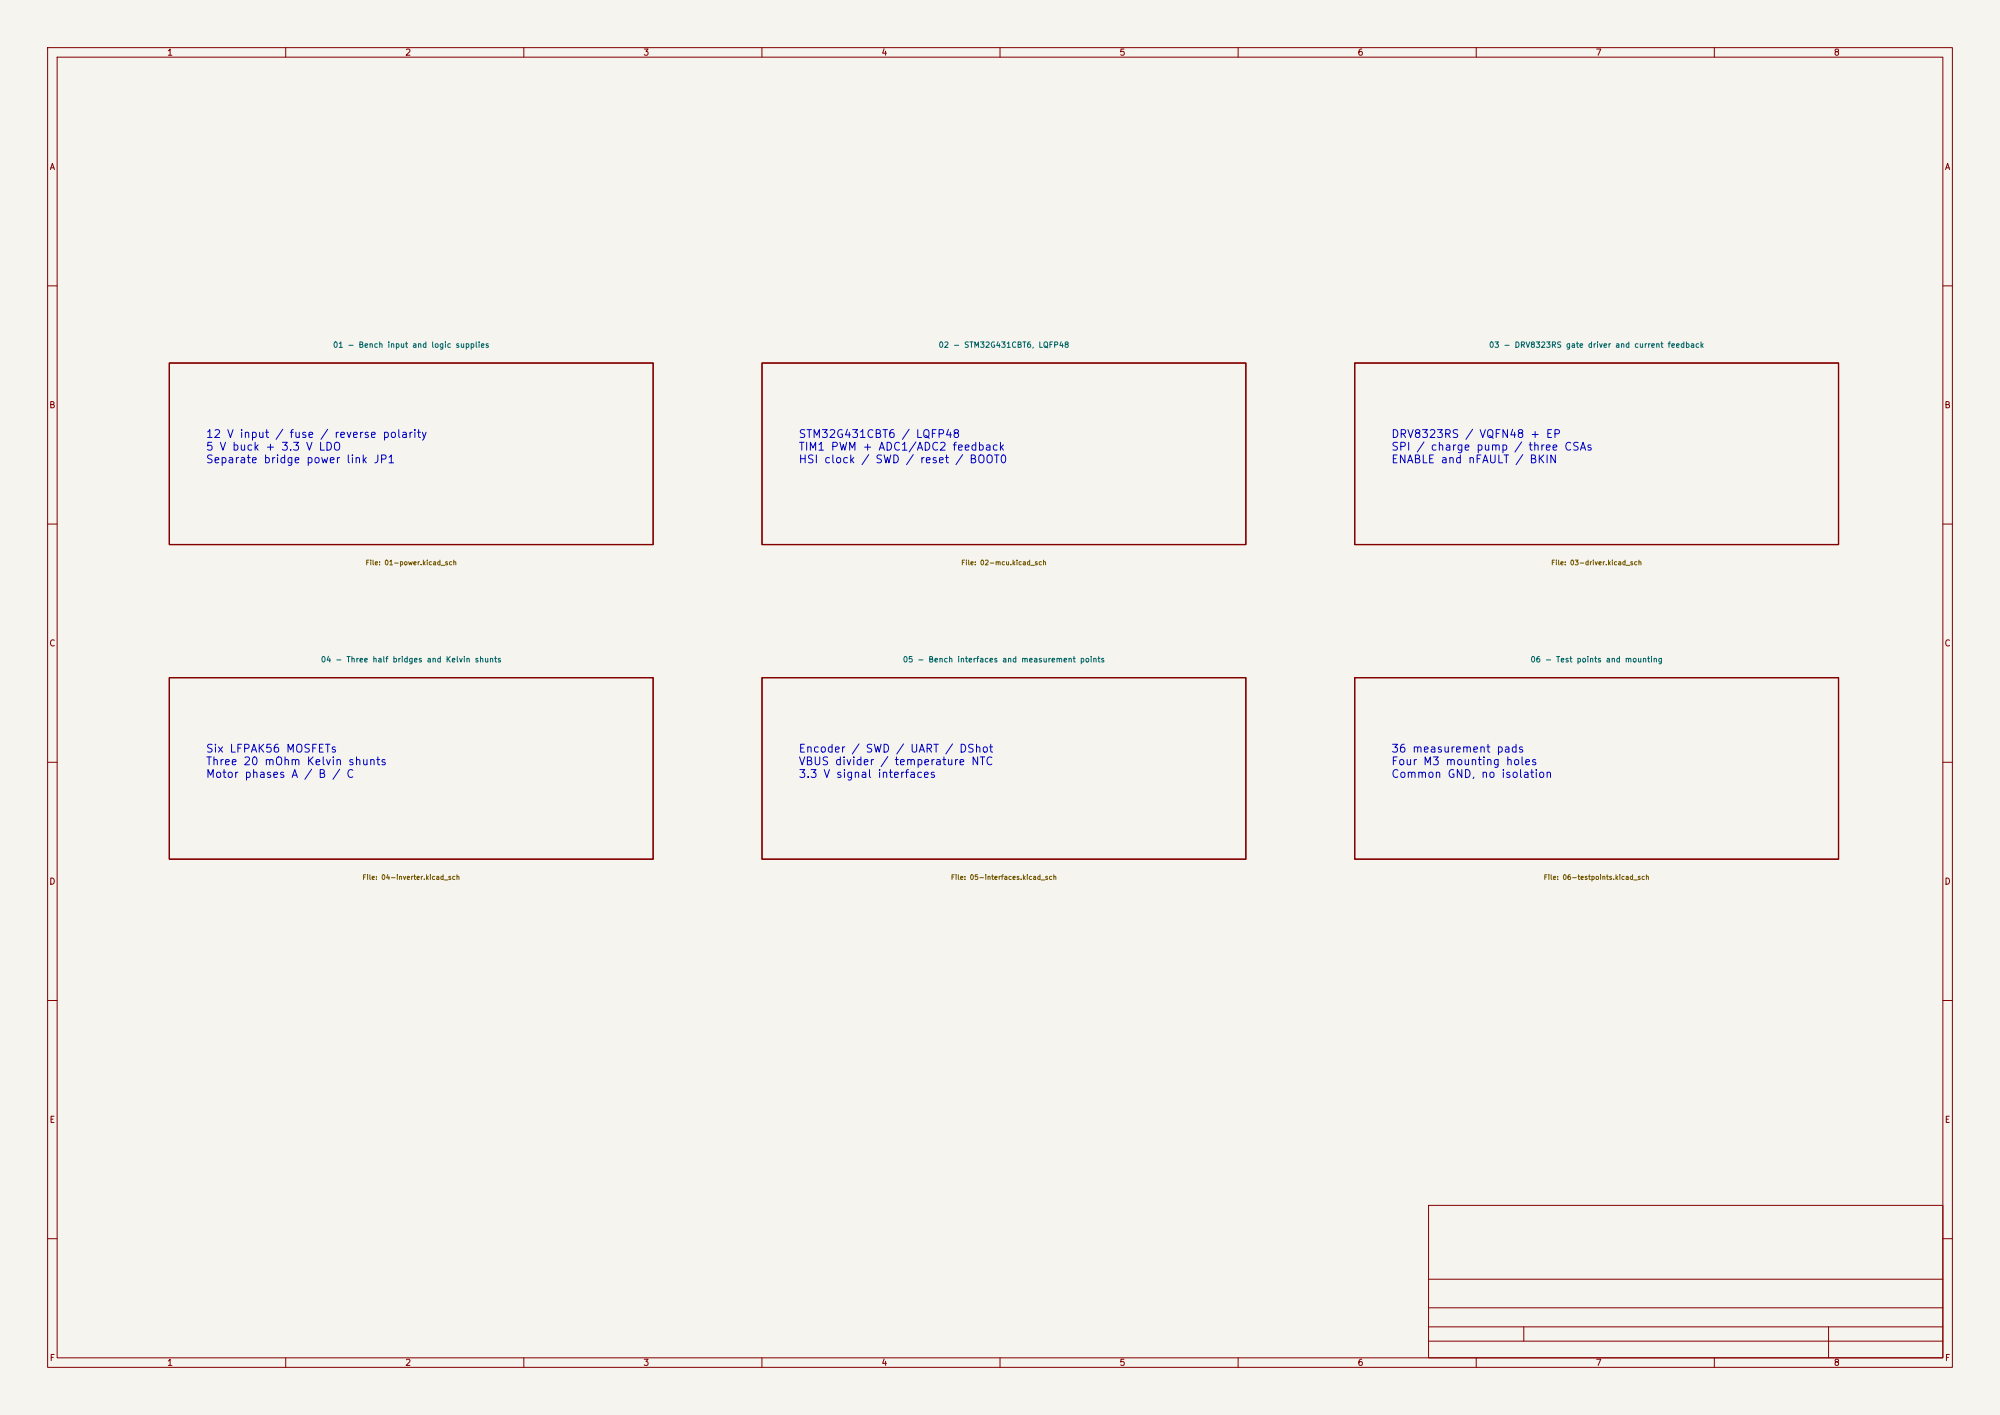
[picture p33: page 1]

01 - Bench input and logic supplies

File: 06-testpoints.kicad_sch 12 V input / fuse / reverse polarity
5 V buck + 3.3 V LDO
Separate bridge power link JP1

STM32G431CBT6 / LQFP48
TIM1 PWM + ADC1/ADC2 feedback
HSI clock / SWD / reset / BOOT0

DRV8323RS / VQFN48 + EP
SPI / charge pump / three CSAs
ENABLE and nFAULT / BKIN

File: 01-power.kicad_sch 04 - Three half bridges and Kelvin shunts

File: 03-driver.kicad_sch 06 - Test points and mounting

Six LFPAK56 MOSFETs
Three 20 mOhm Kelvin shunts
Motor phases A / B / C

Encoder / SWD / UART / DShot
VBUS divider / temperature NTC
3.3 V signal interfaces

36 measurement pads
Four M3 mounting holes
Common GND, no isolation

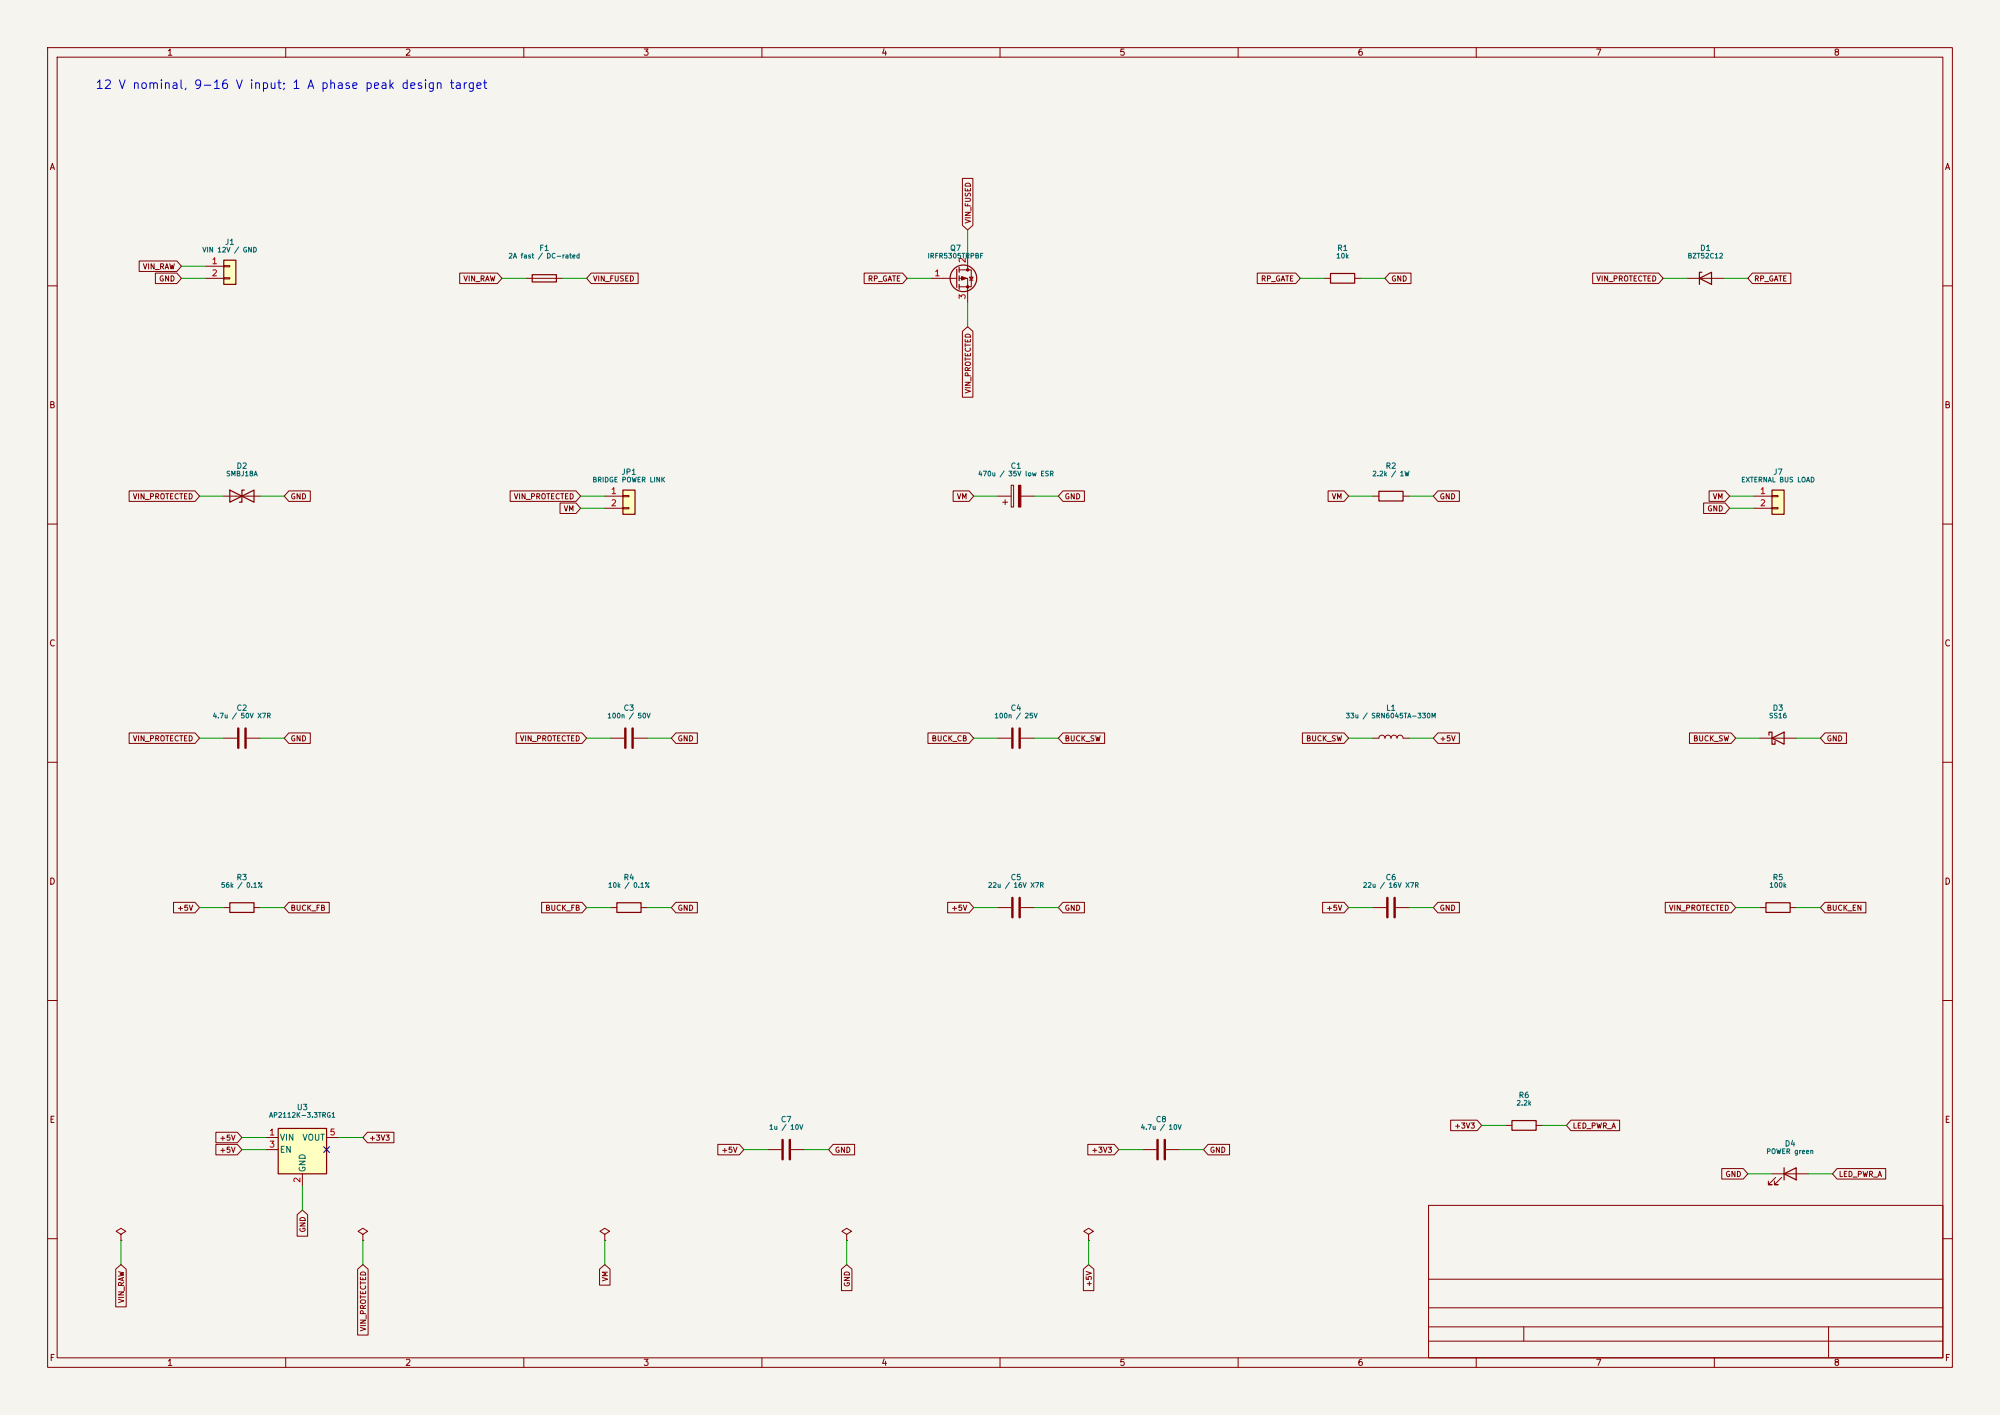
[picture p34: page 2]

12 V nominal, 9-16 V input; 1 A phase peak design target

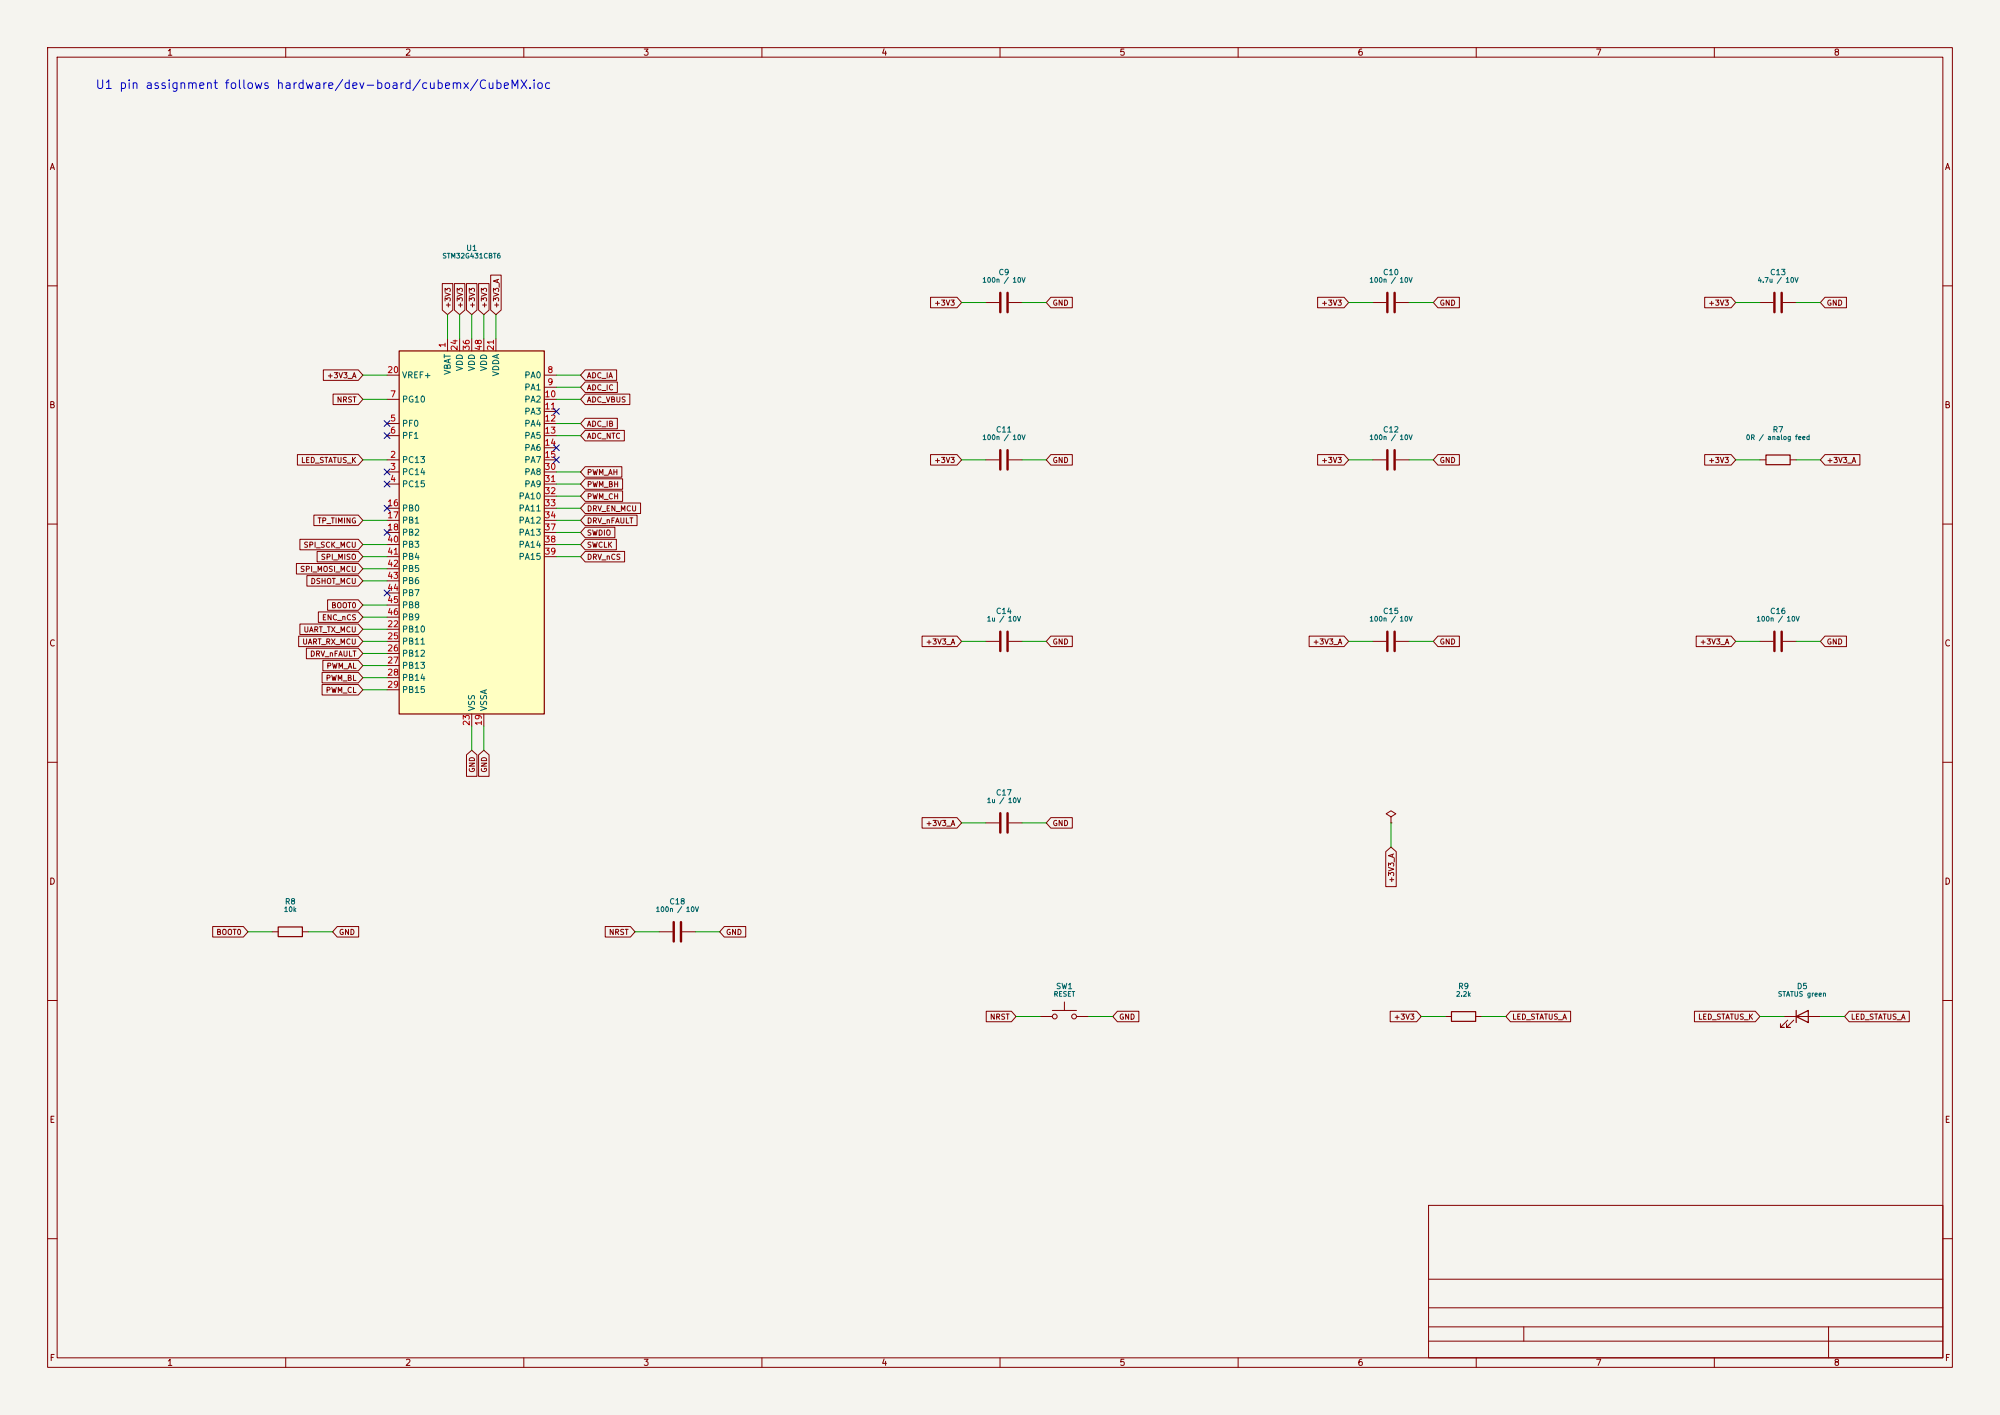
[picture p35: page 3]

U1 pin assignment follows hardware/dev-board/cubemx/CubeMX.ioc

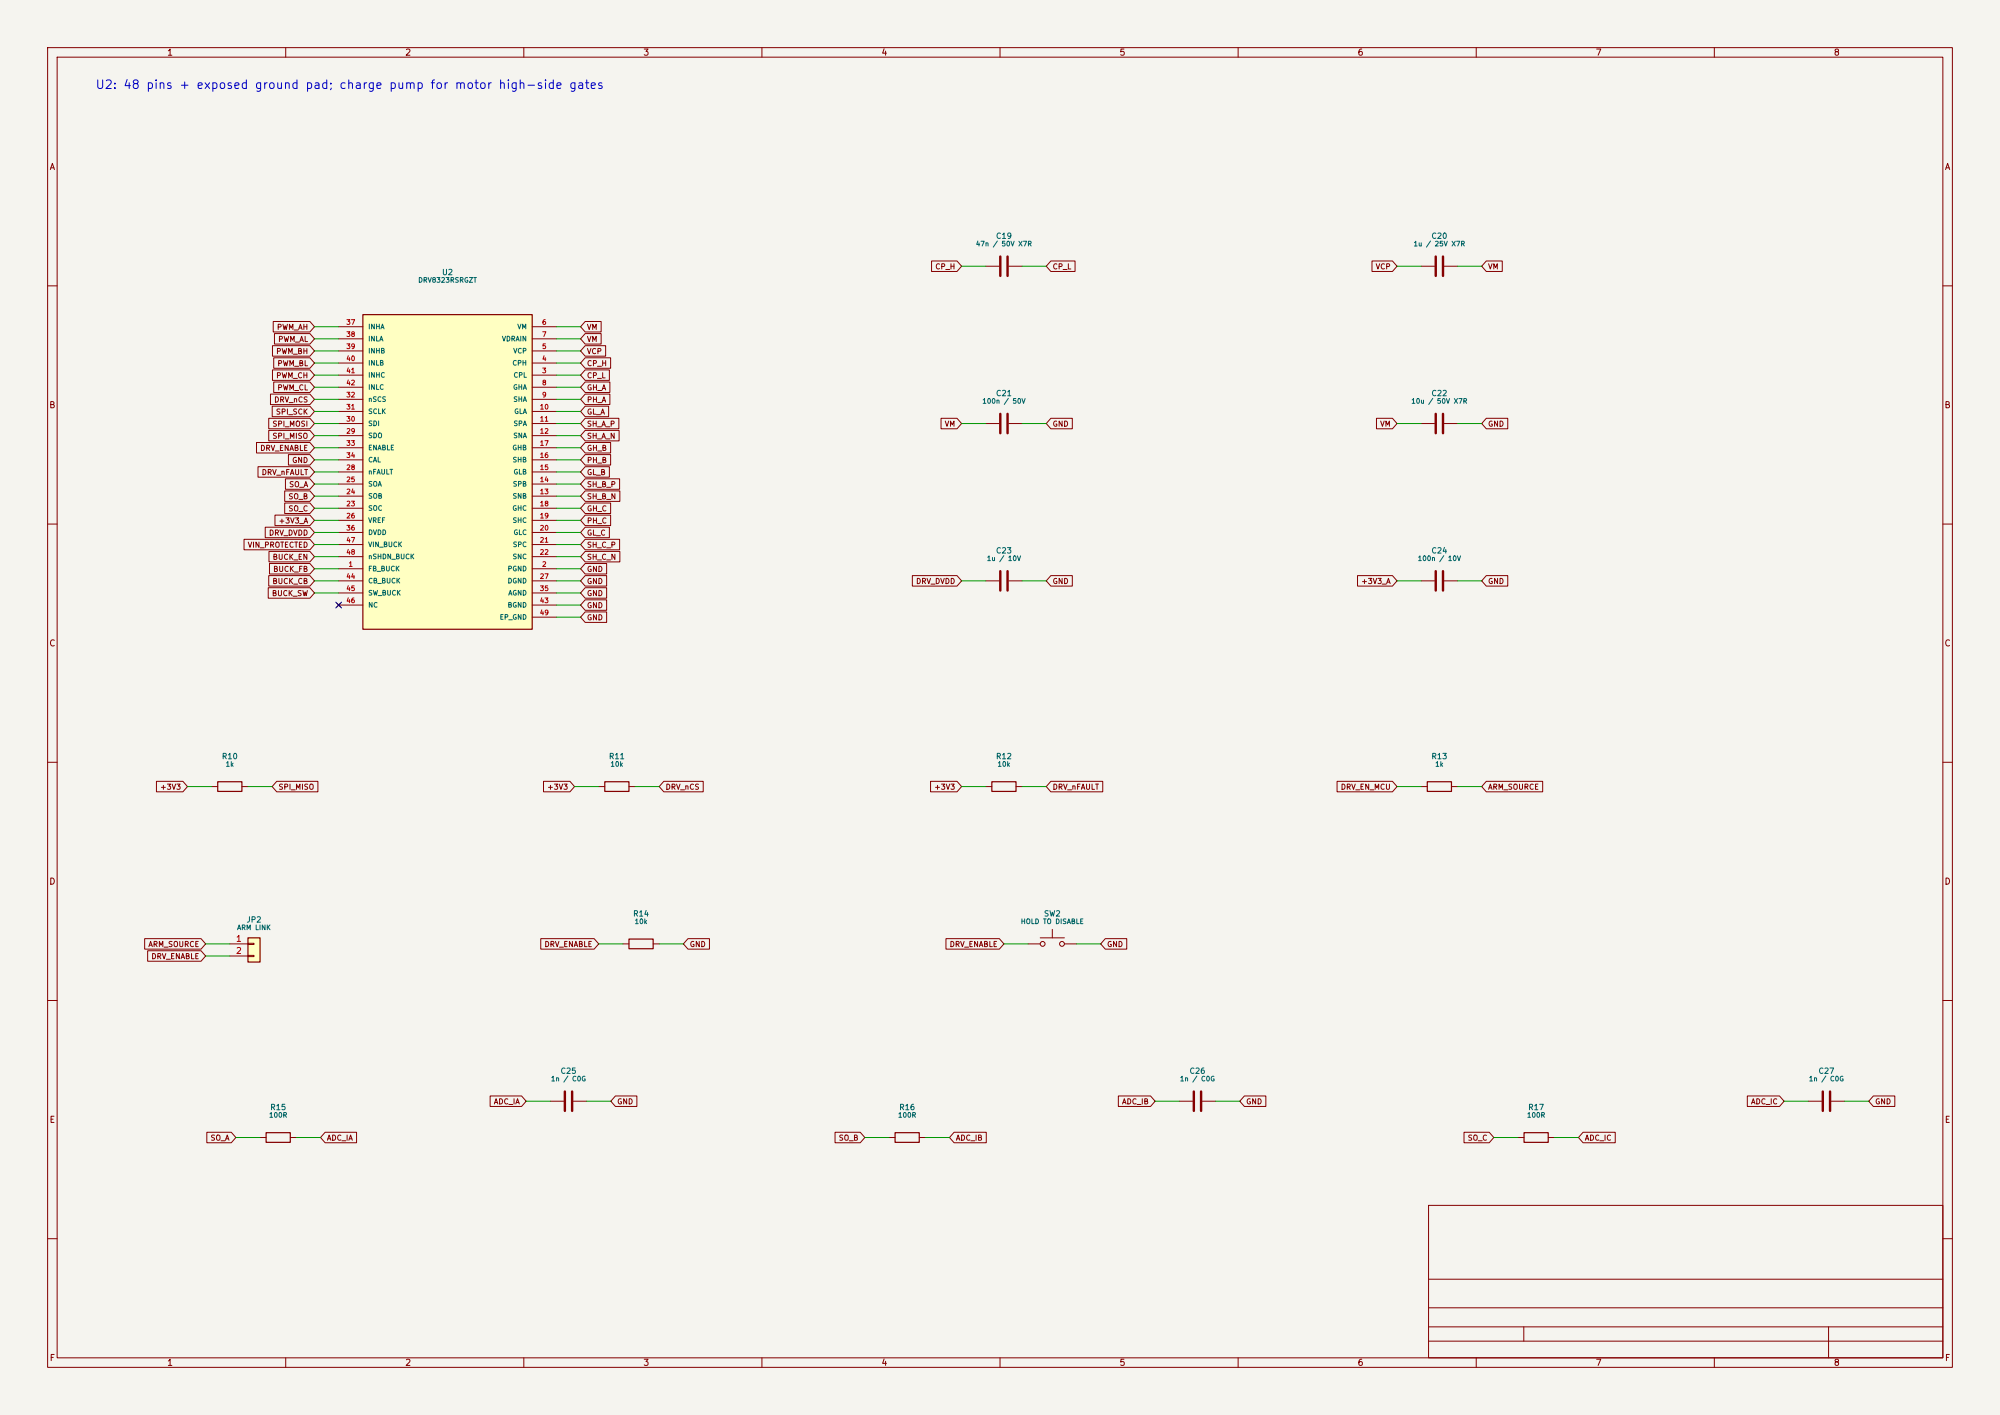
[picture p36: page 4]

GH_B U2: 48 pins + exposed ground pad; charge pump for motor high-side gates

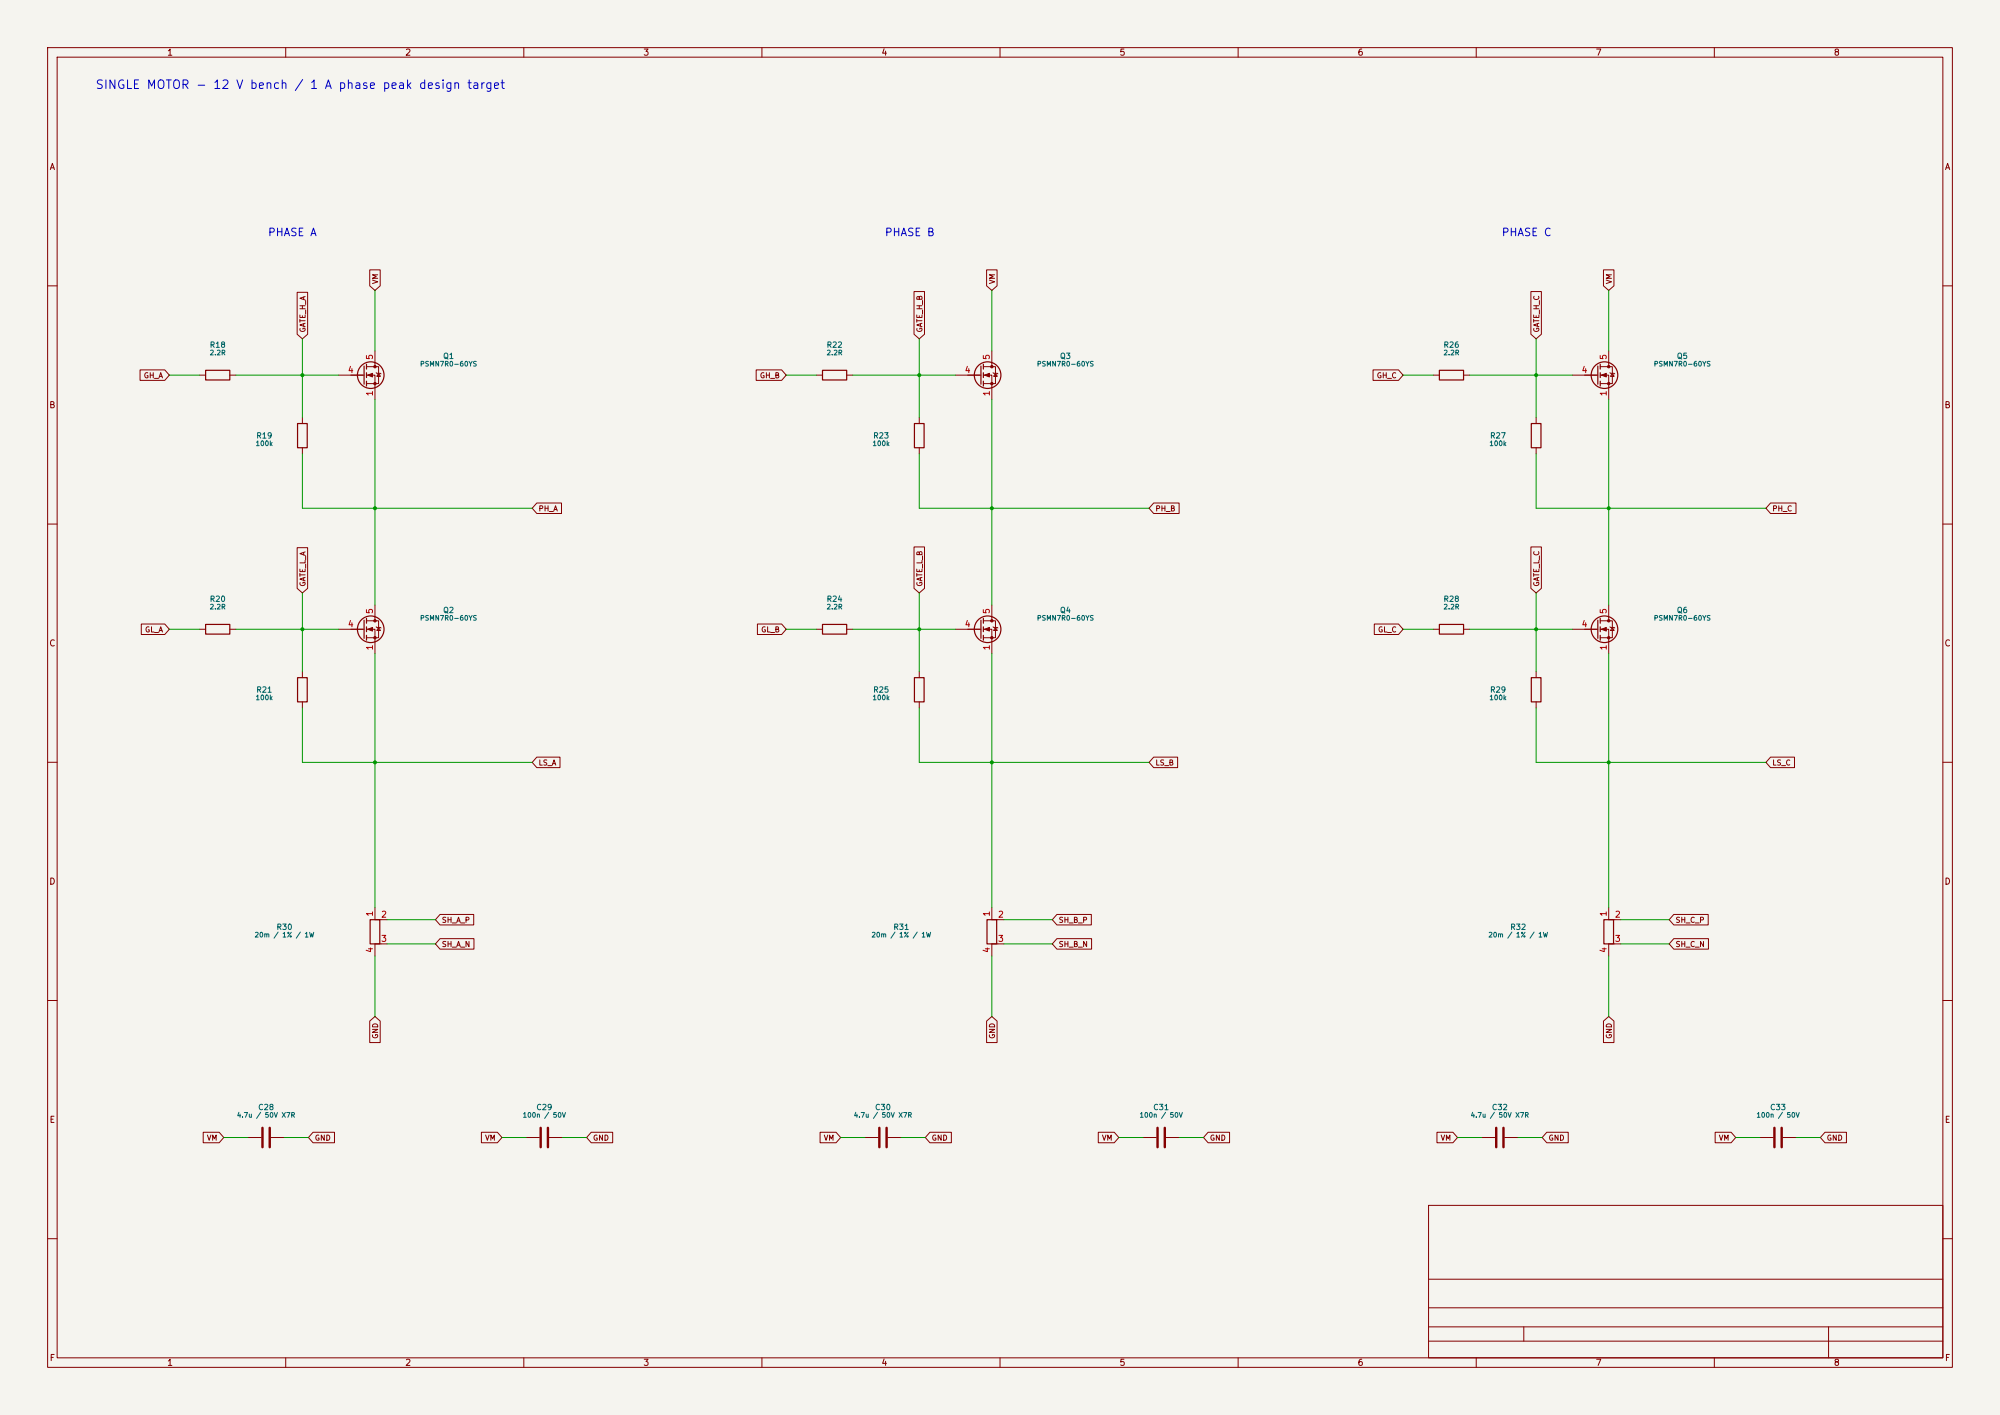
[picture p37: page 5]

SINGLE MOTOR - 12 V bench / 1 A phase peak design target

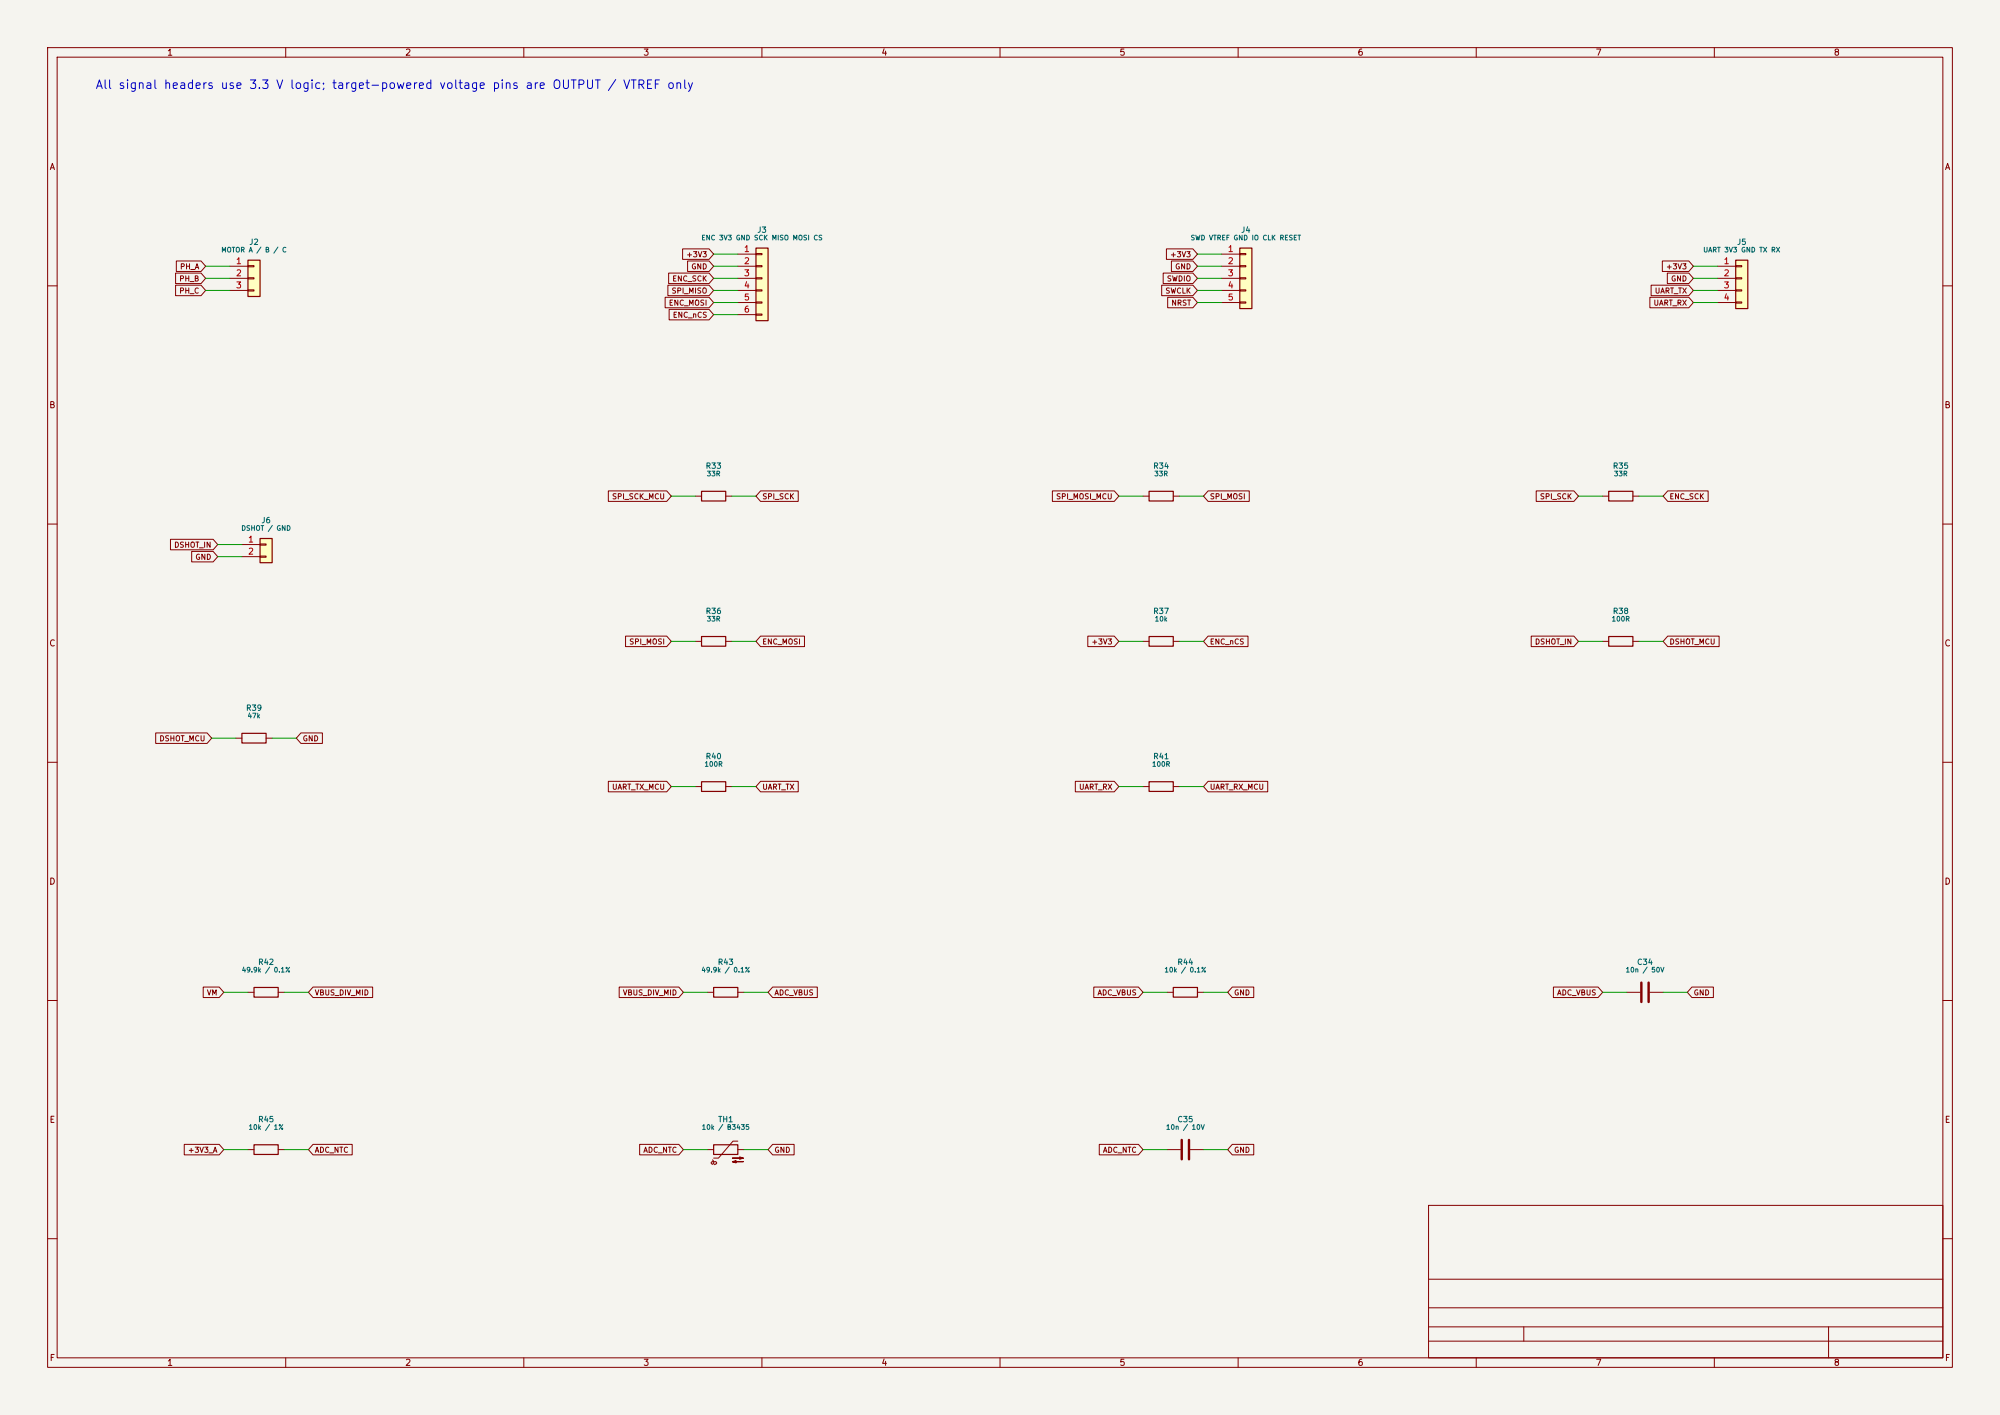
[picture p38: page 6]

SPI_MOSI All signal headers use 3.3 V logic; target-powered voltage pins are OUTPUT / VTREF only

SWD VTREF GND IO CLK RESET

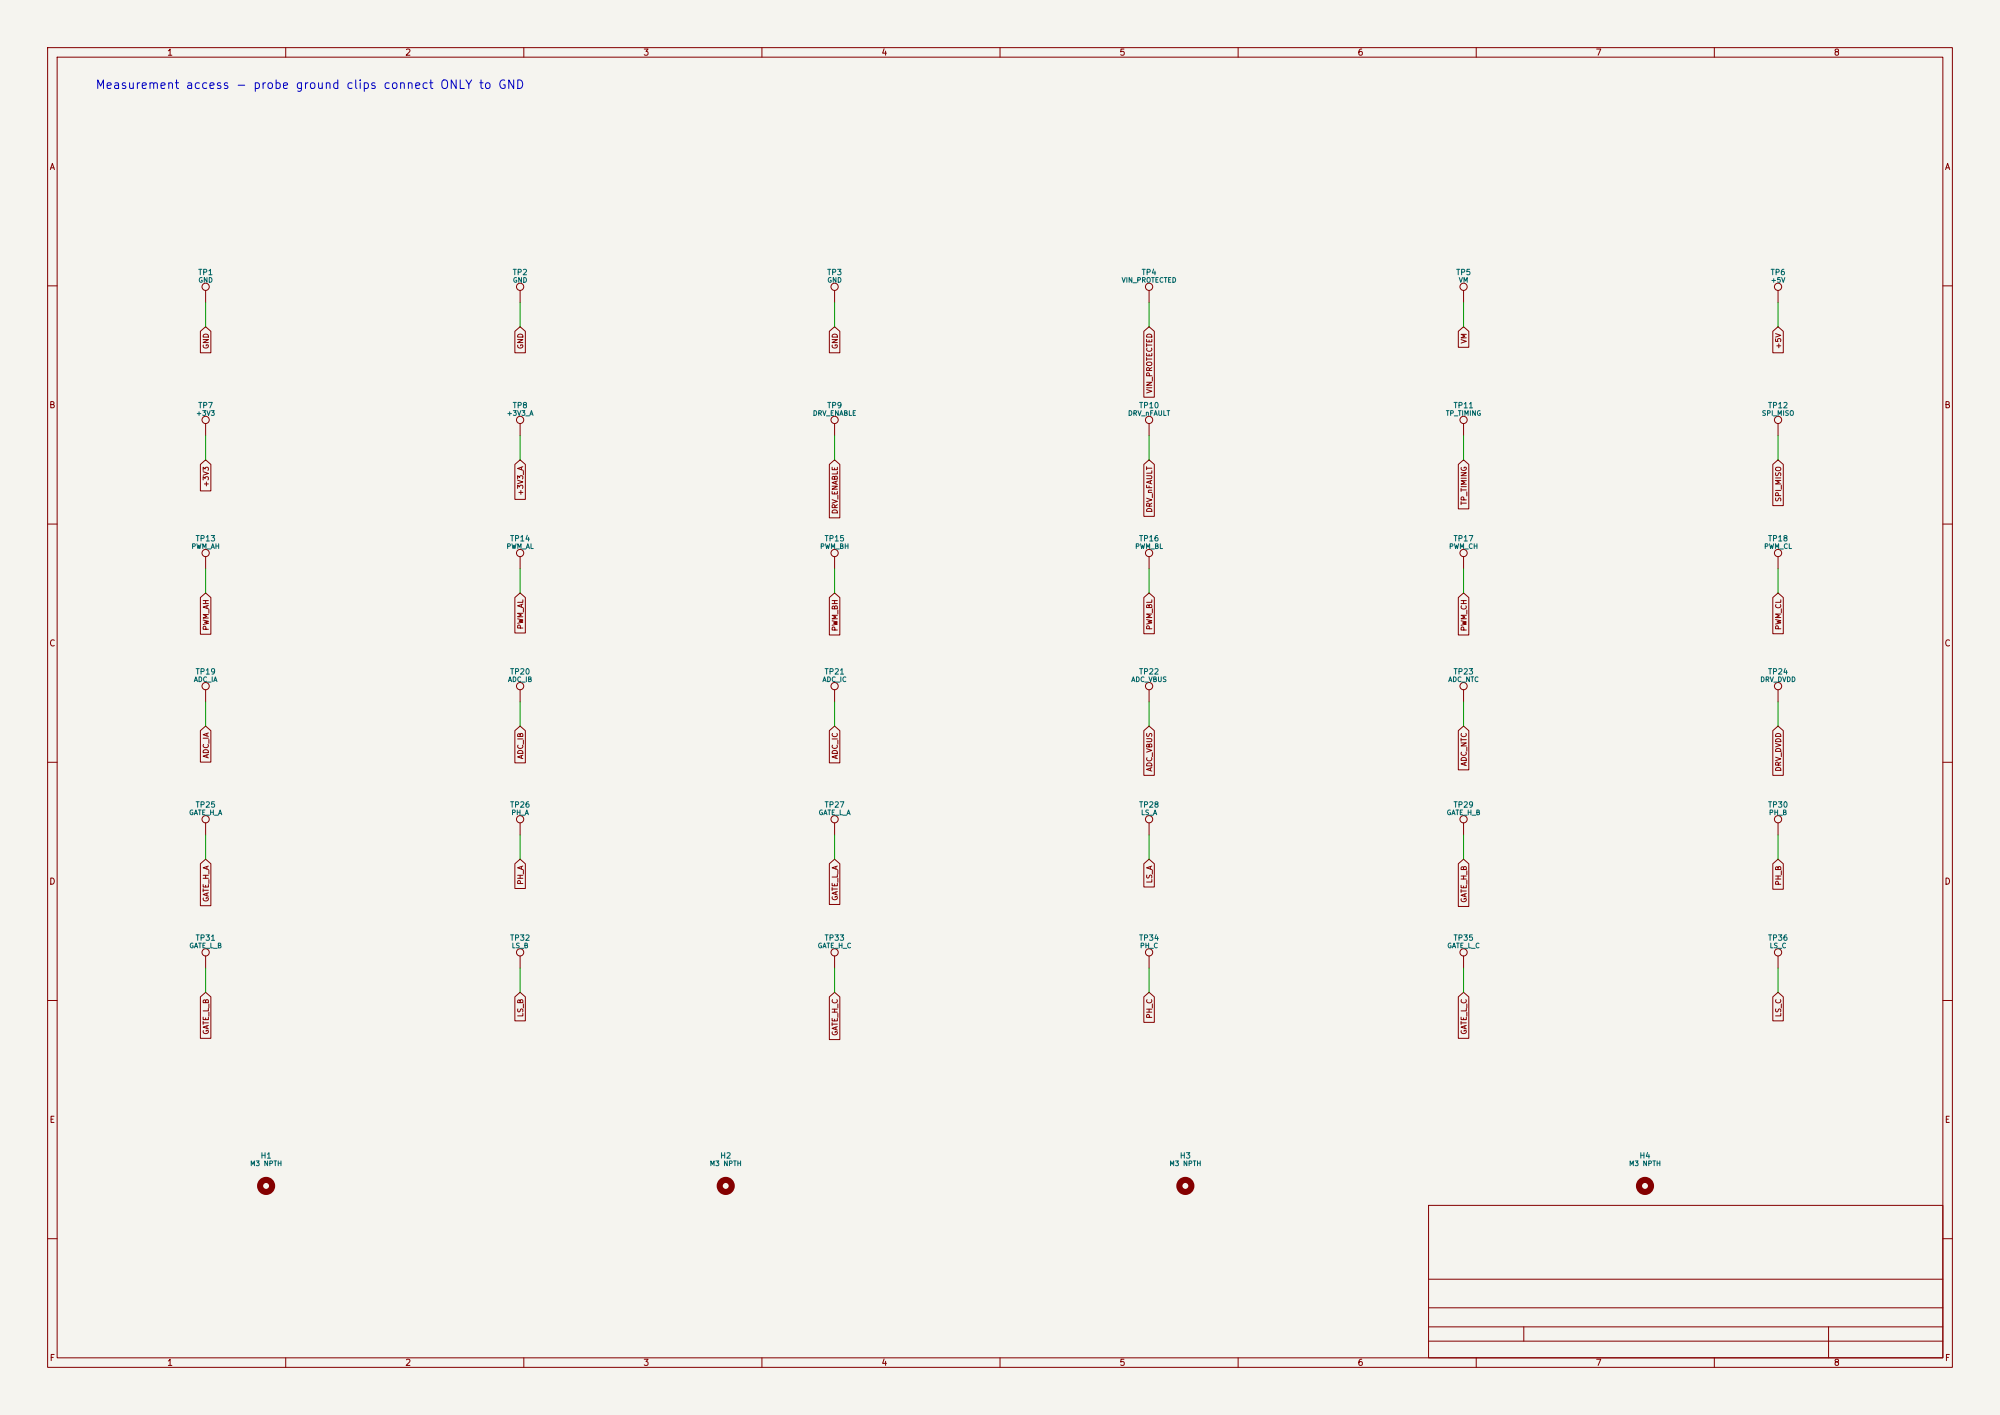
[picture p39: page 7]

Measurement access - probe ground clips connect ONLY to GND
