dganin-hw/bldc-foc/hardware/esc-4in1/documentation/SCHEMATIC.pdf

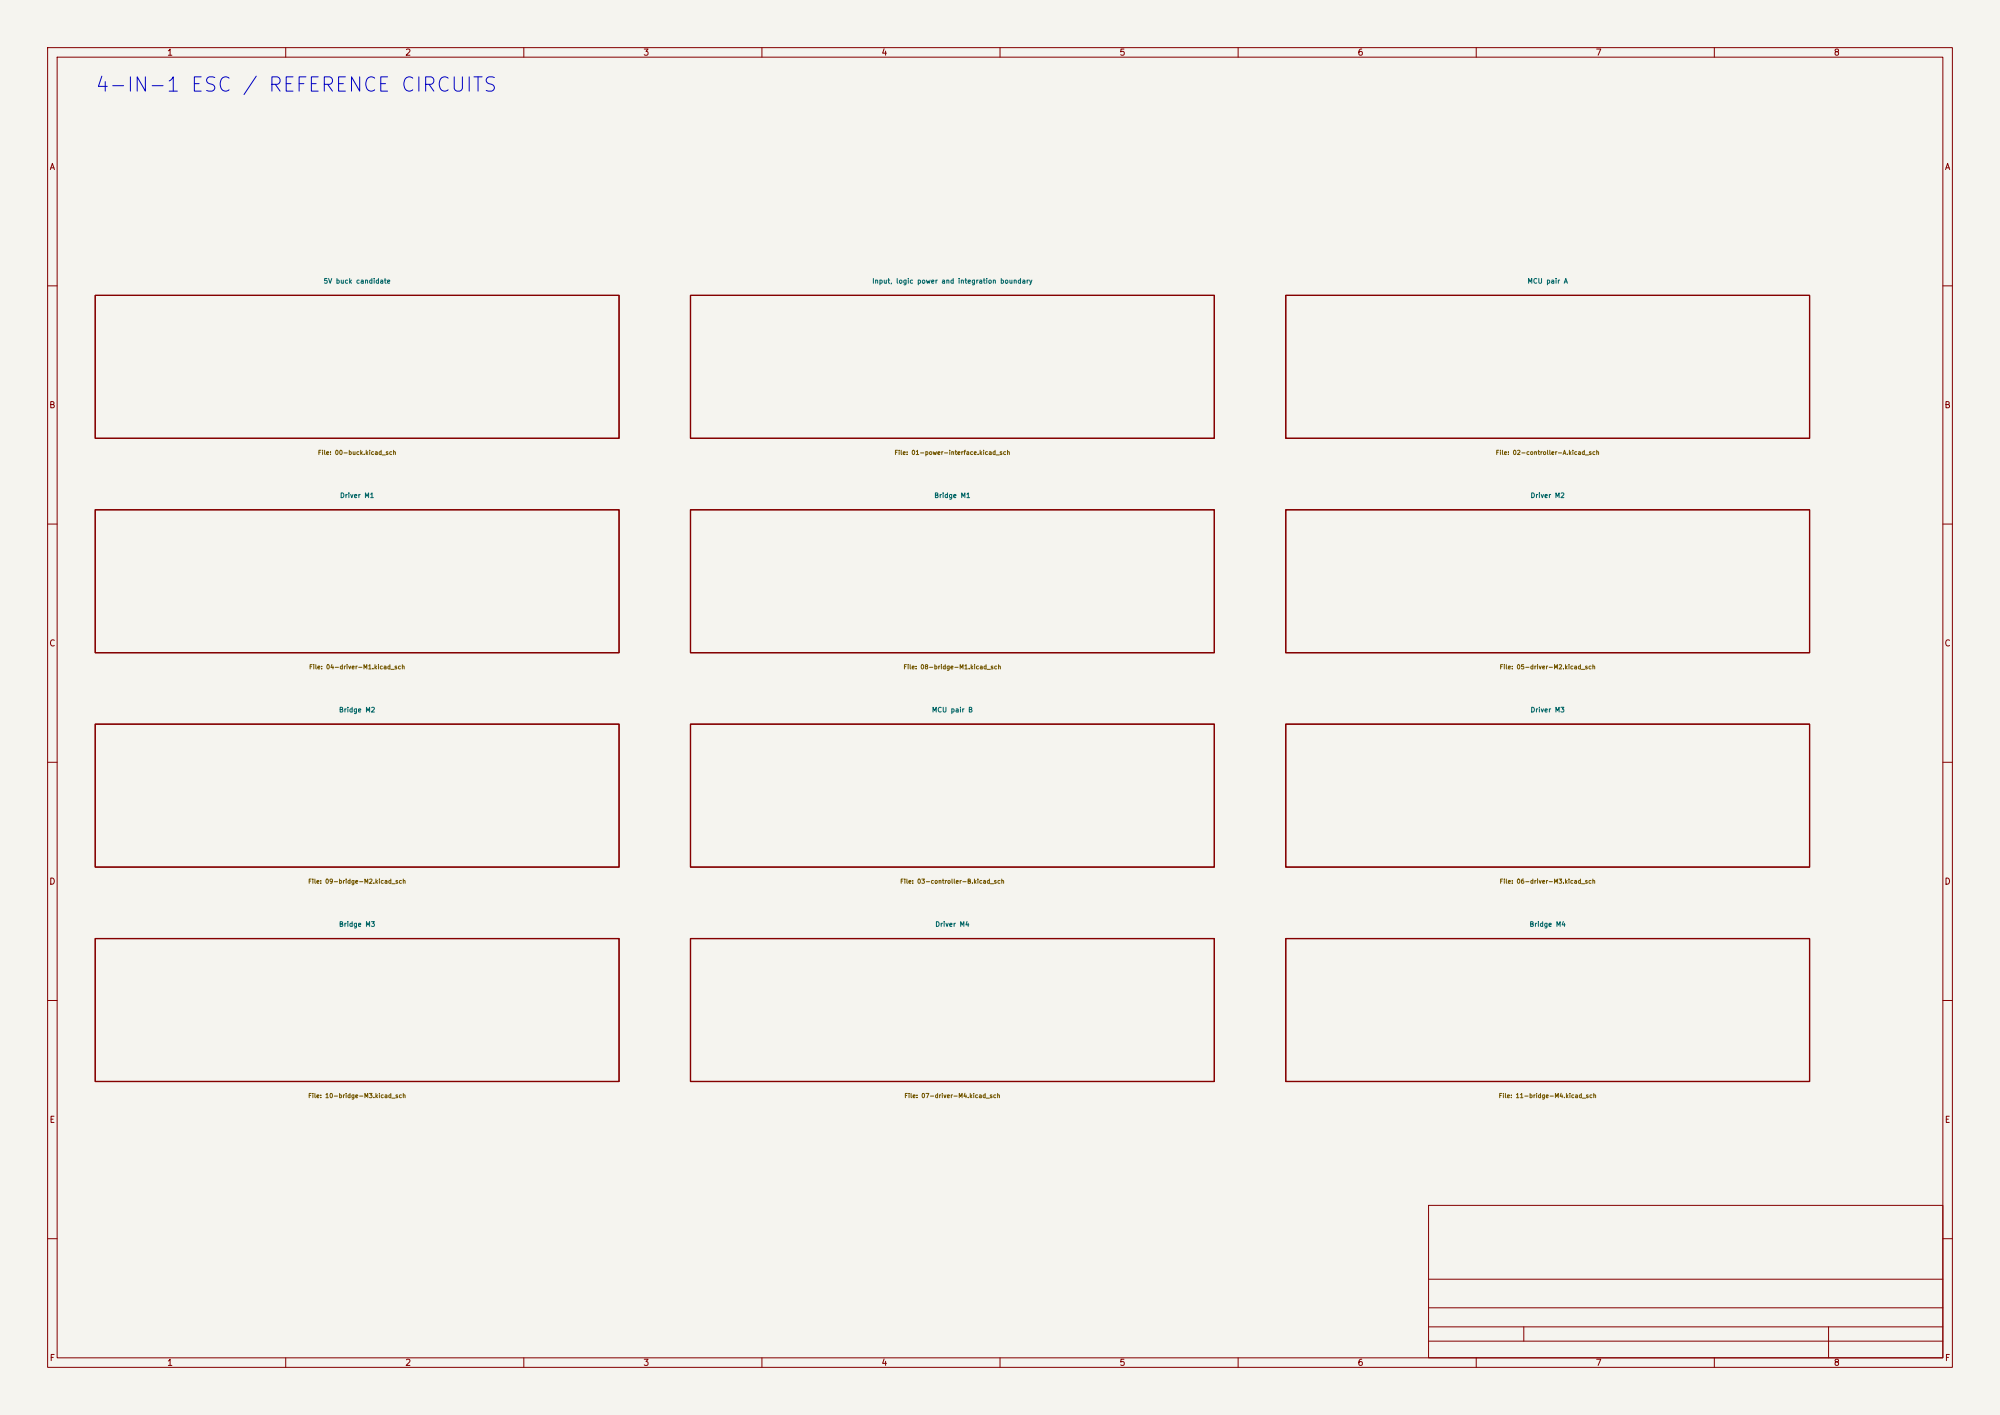
[picture p40: page 1]

File: 08-bridge-M1.kicad_sch 4-IN-1 ESC / REFERENCE CIRCUITS

File: 02-controller-A.kicad_sch MCU pair B

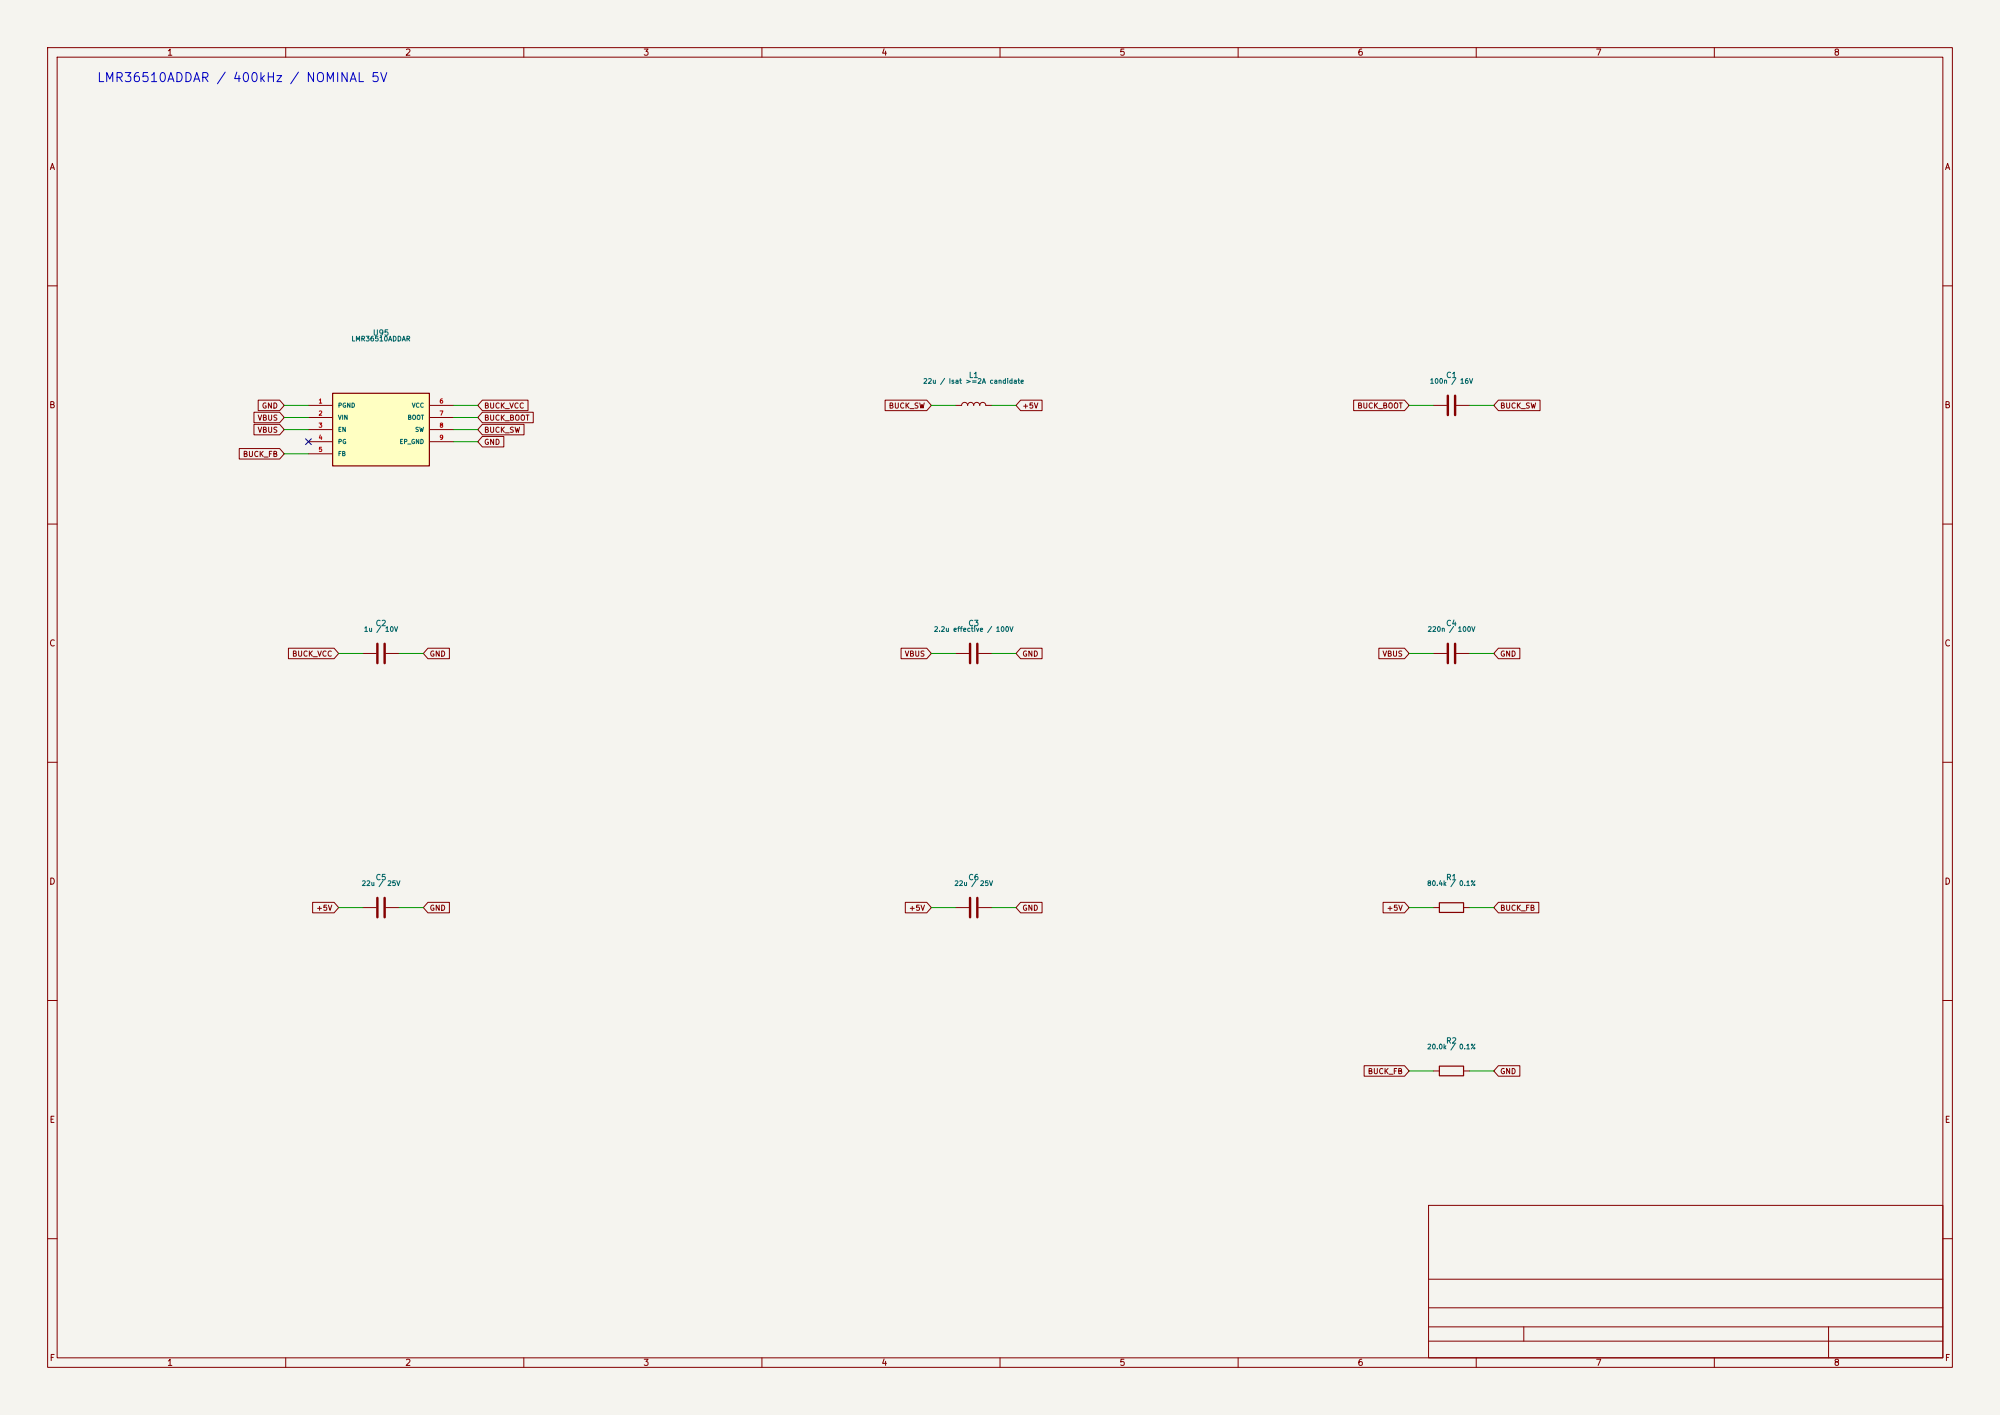
[picture p41: page 2]

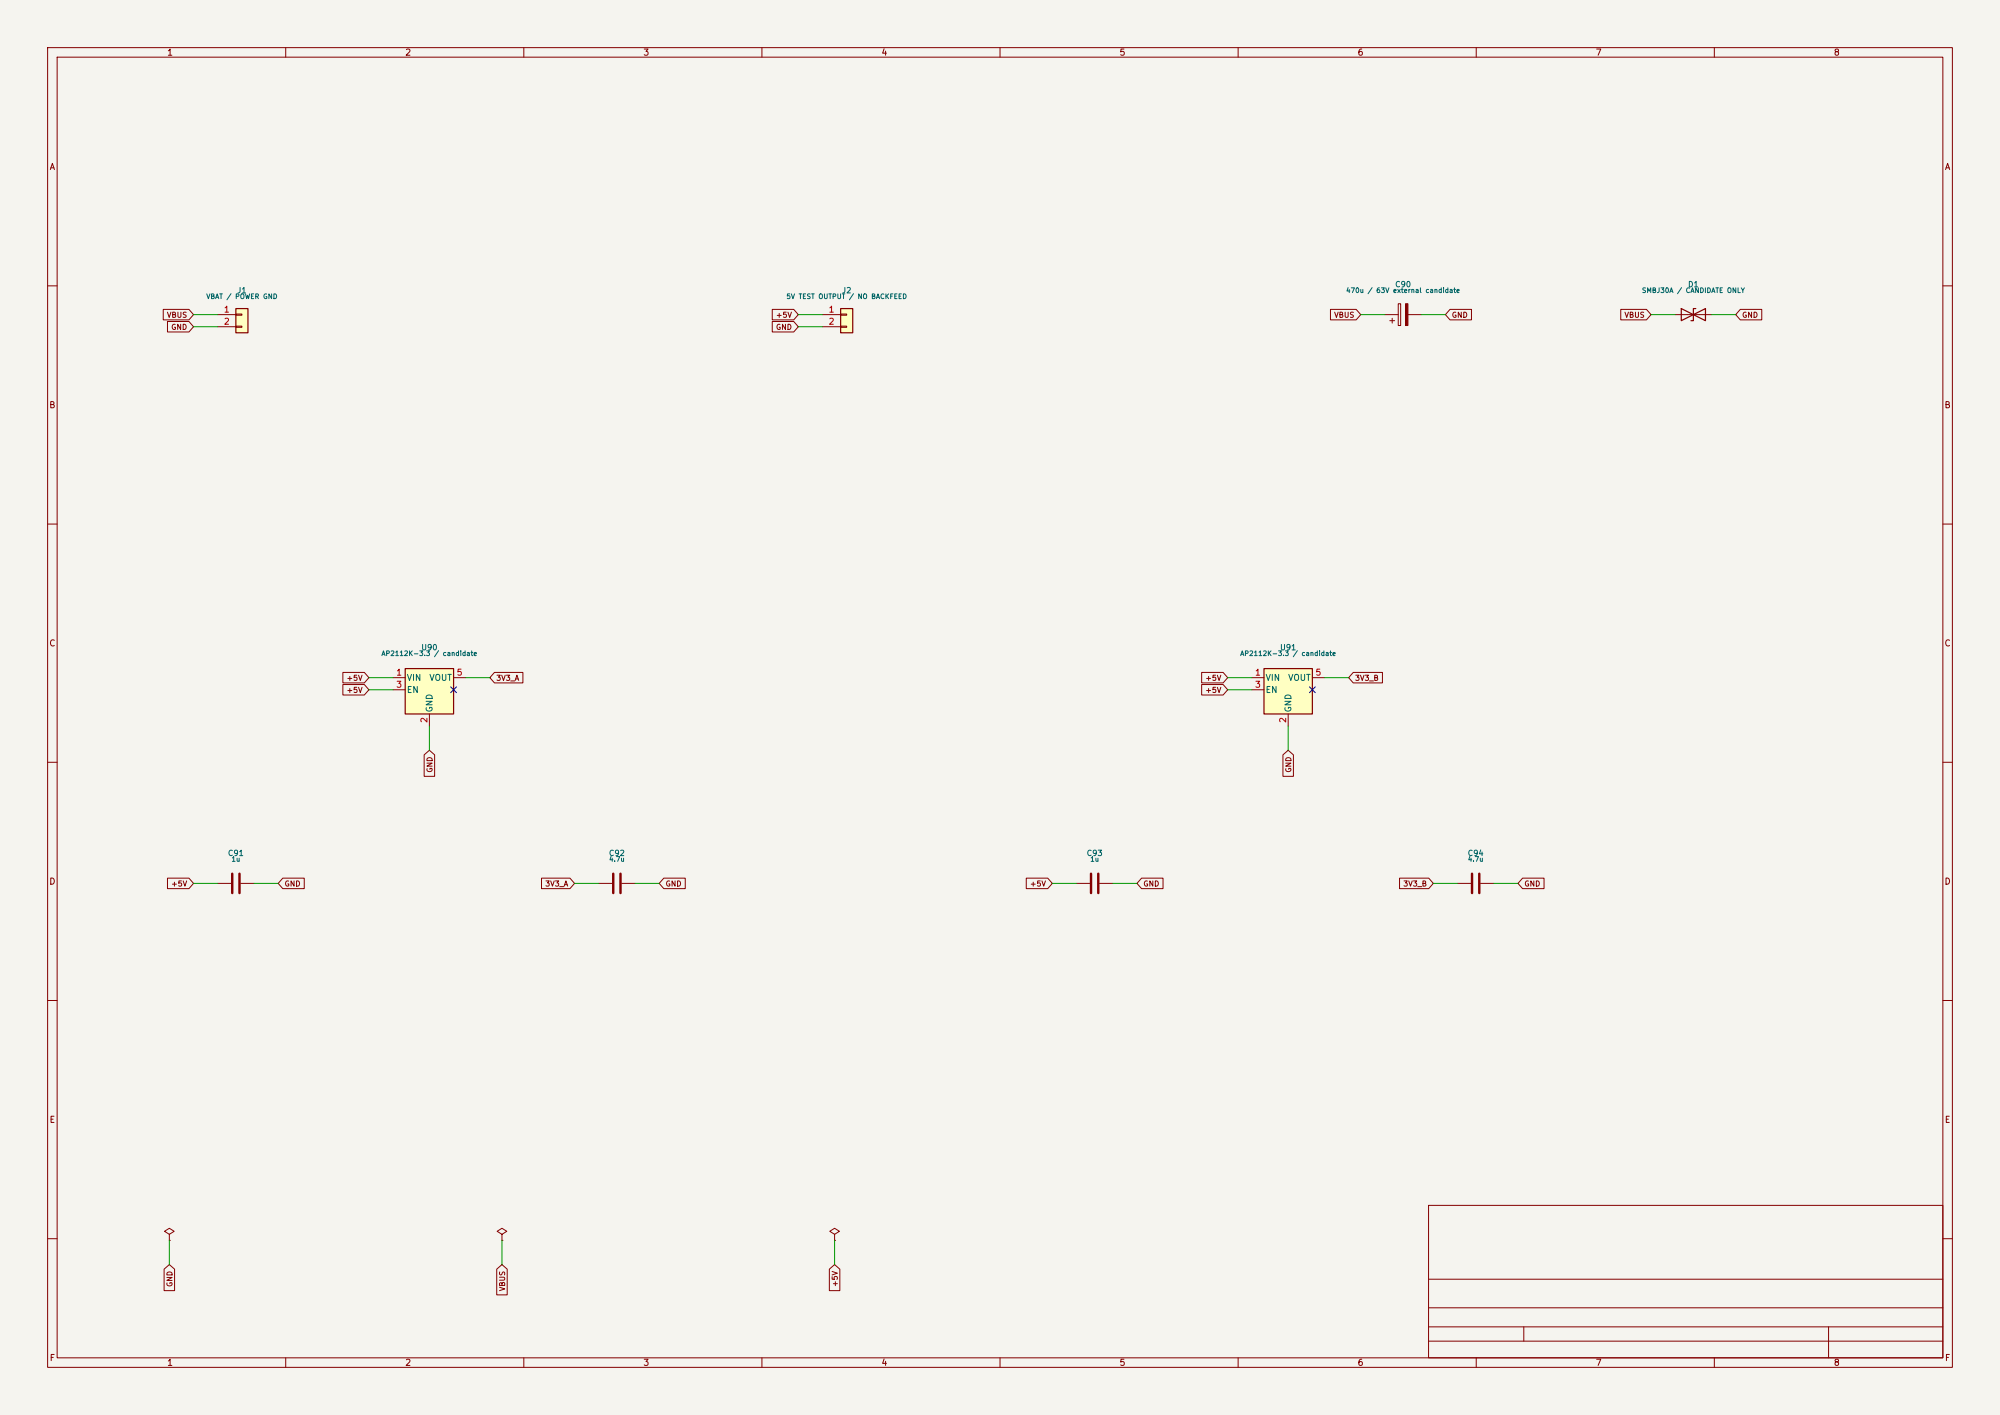
[picture p42: page 3]

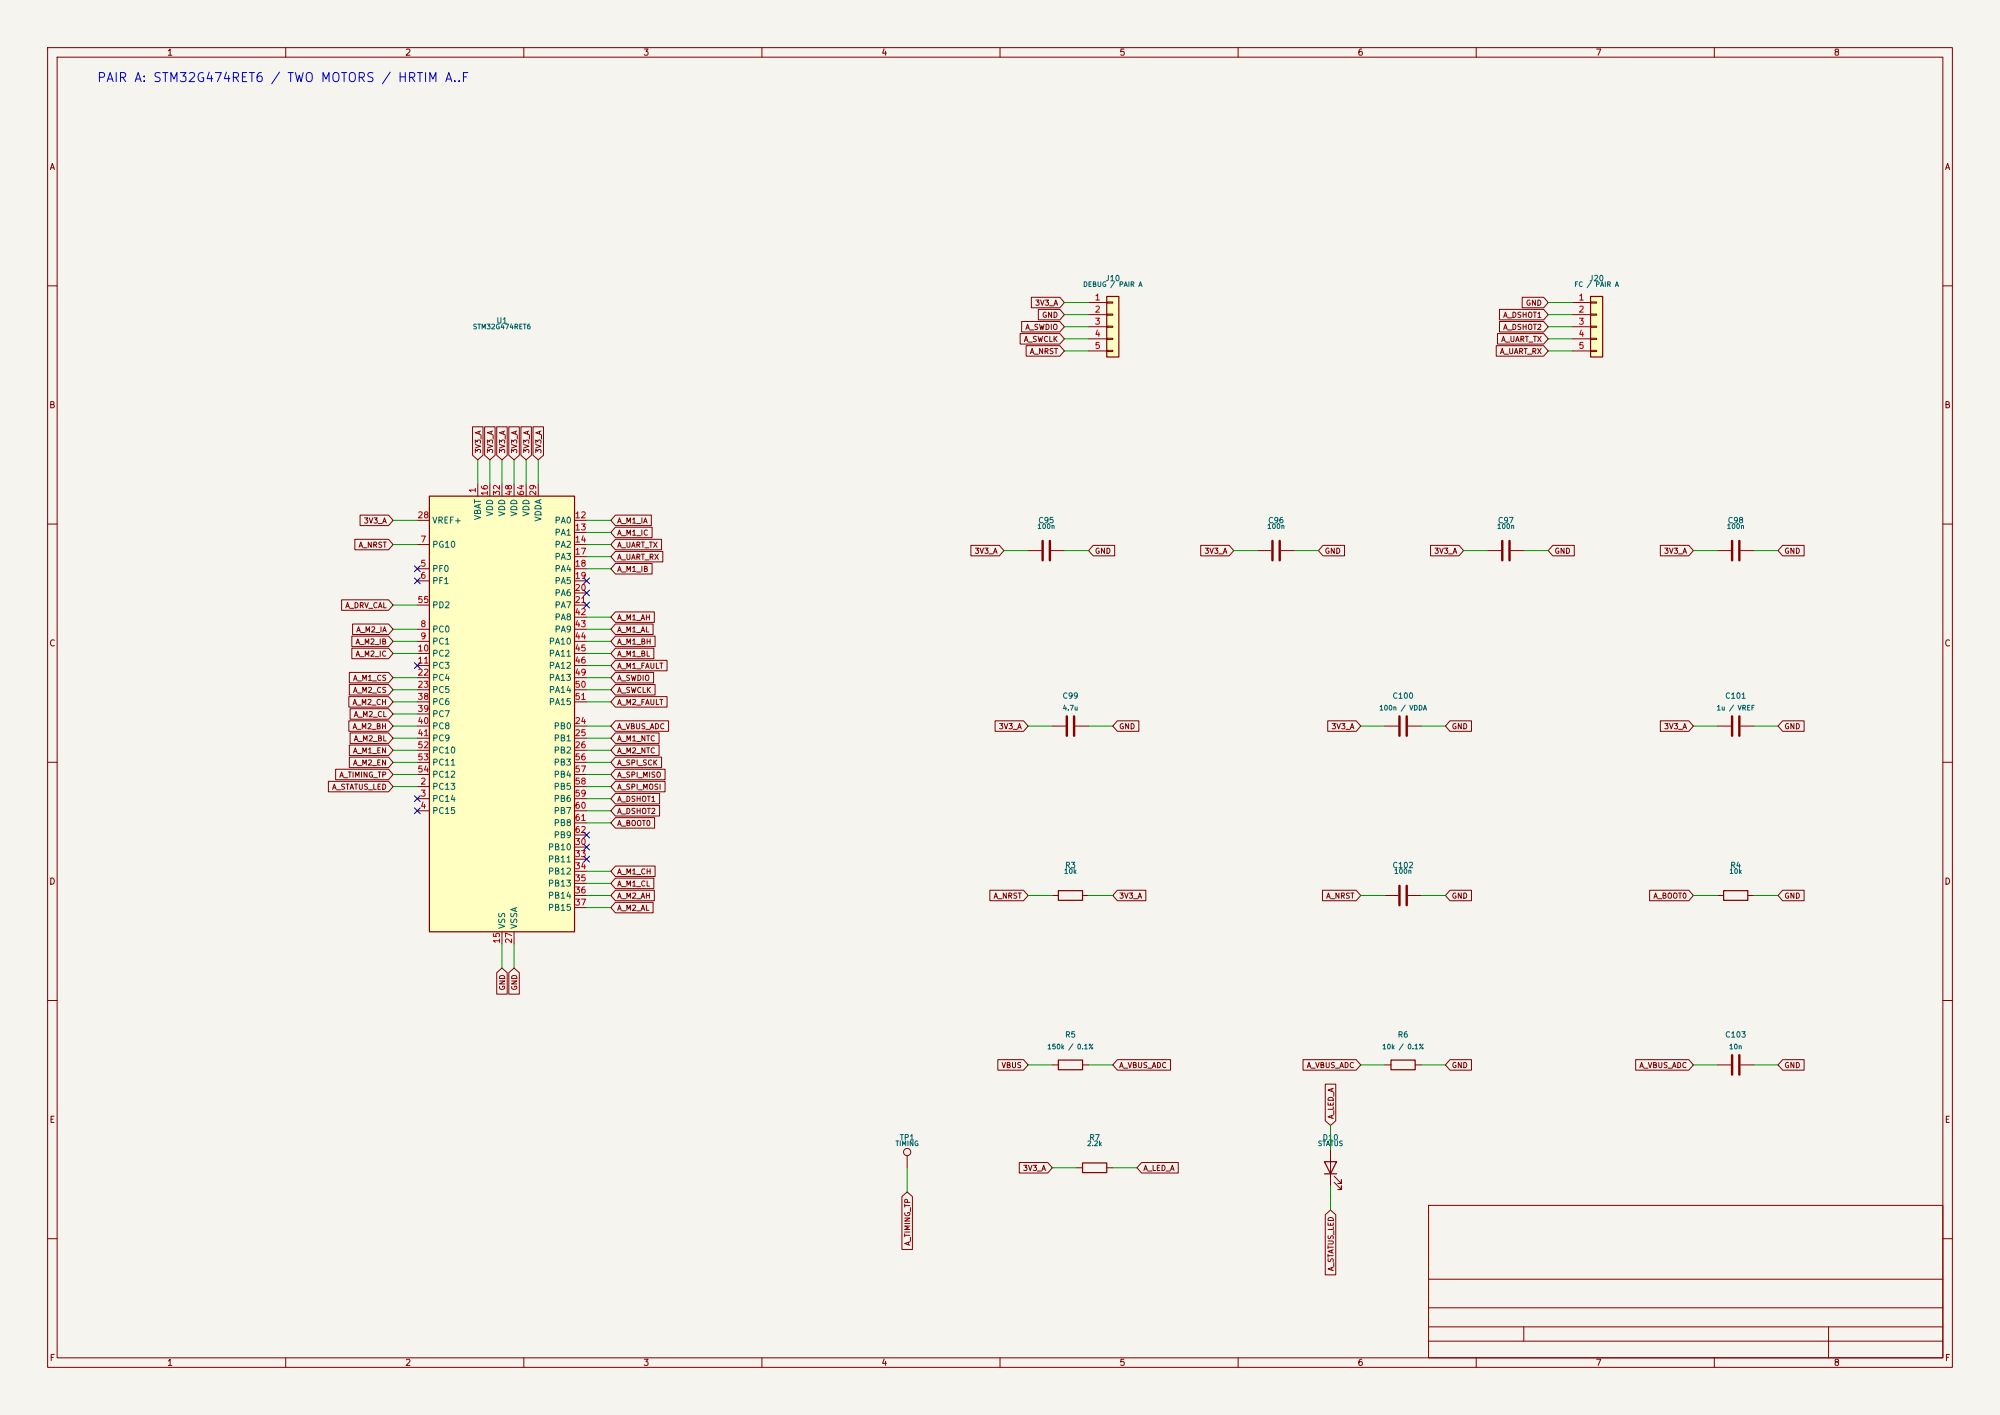
[picture p43: page 4]

A_M2_IB PAIR A: STM32G474RET6 / TWO MOTORS / HRTIM A..F

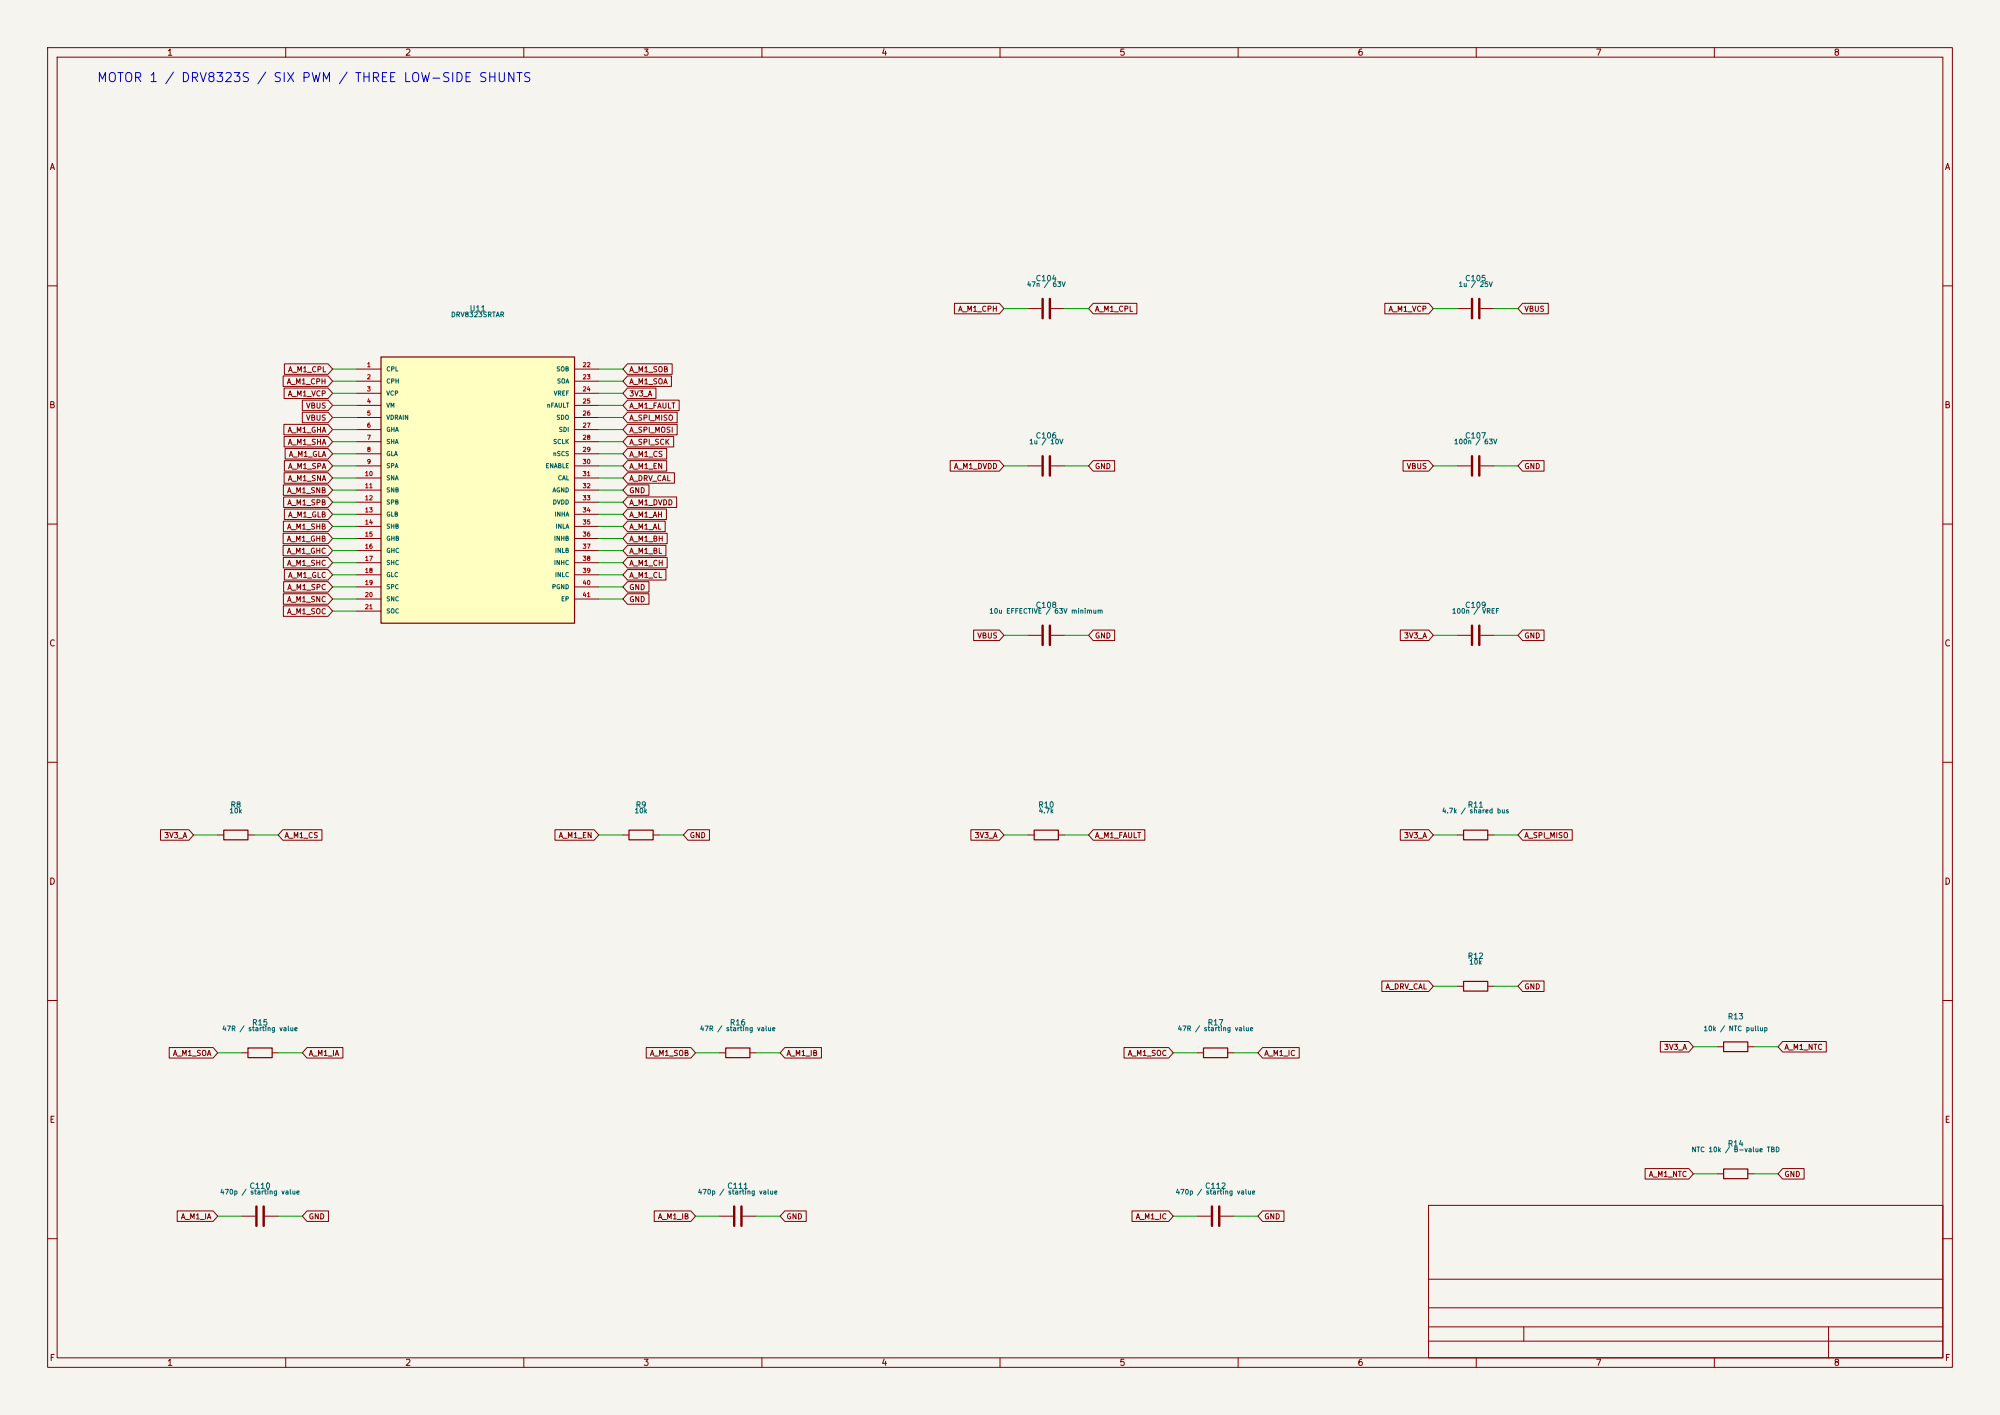
[picture p44: page 5]

MOTOR 1 / DRV8323S / SIX PWM / THREE LOW-SIDE SHUNTS

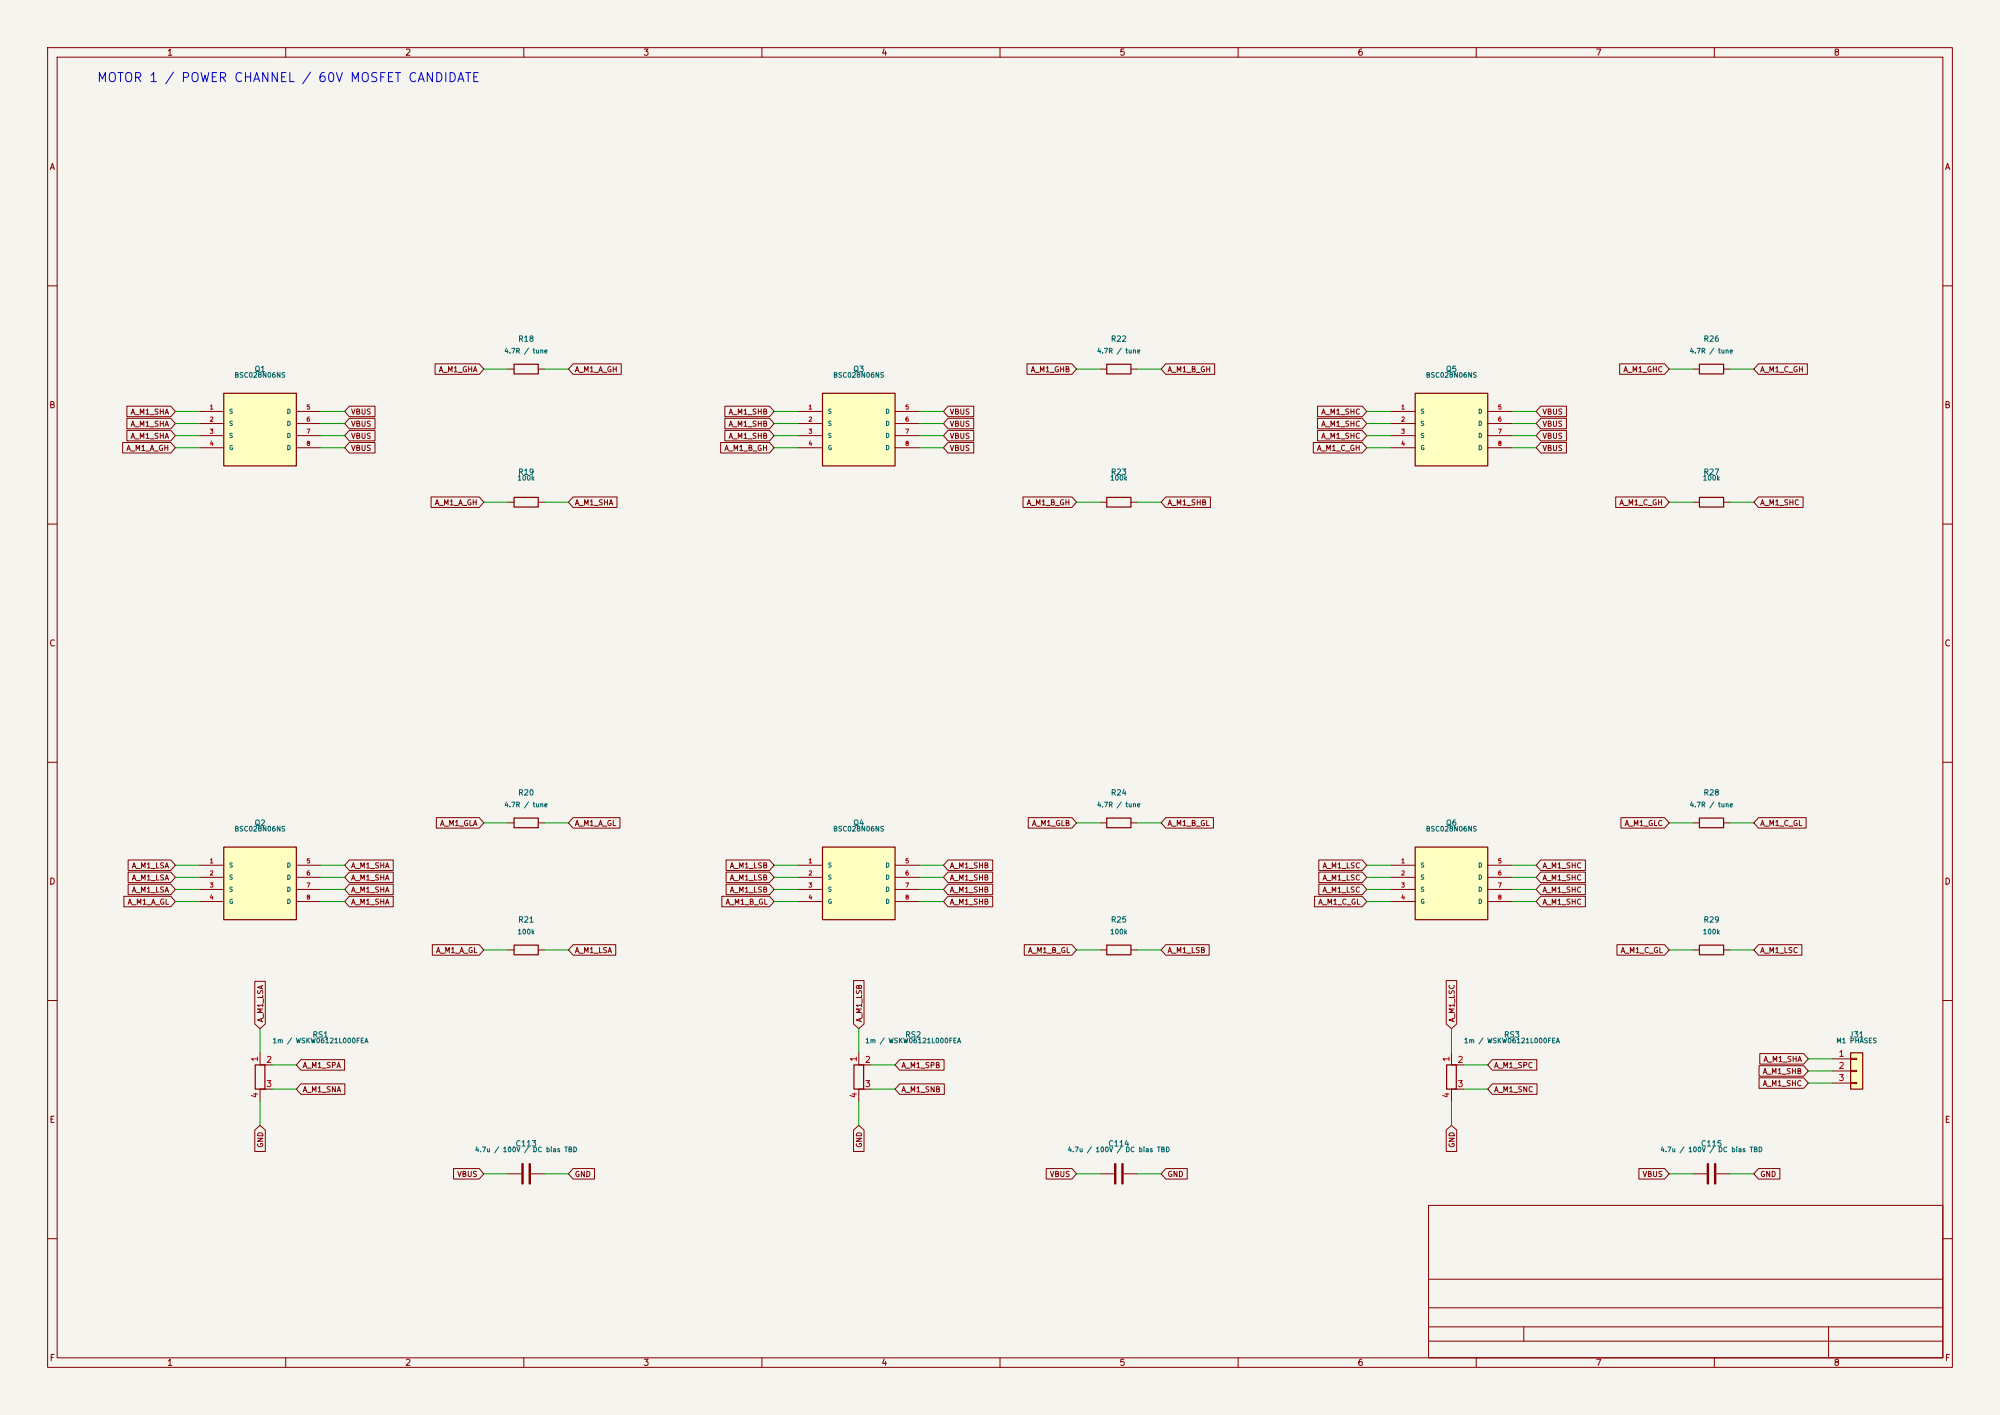
[picture p45: page 6]

A_M1_A_GH MOTOR 1 / POWER CHANNEL / 60V MOSFET CANDIDATE

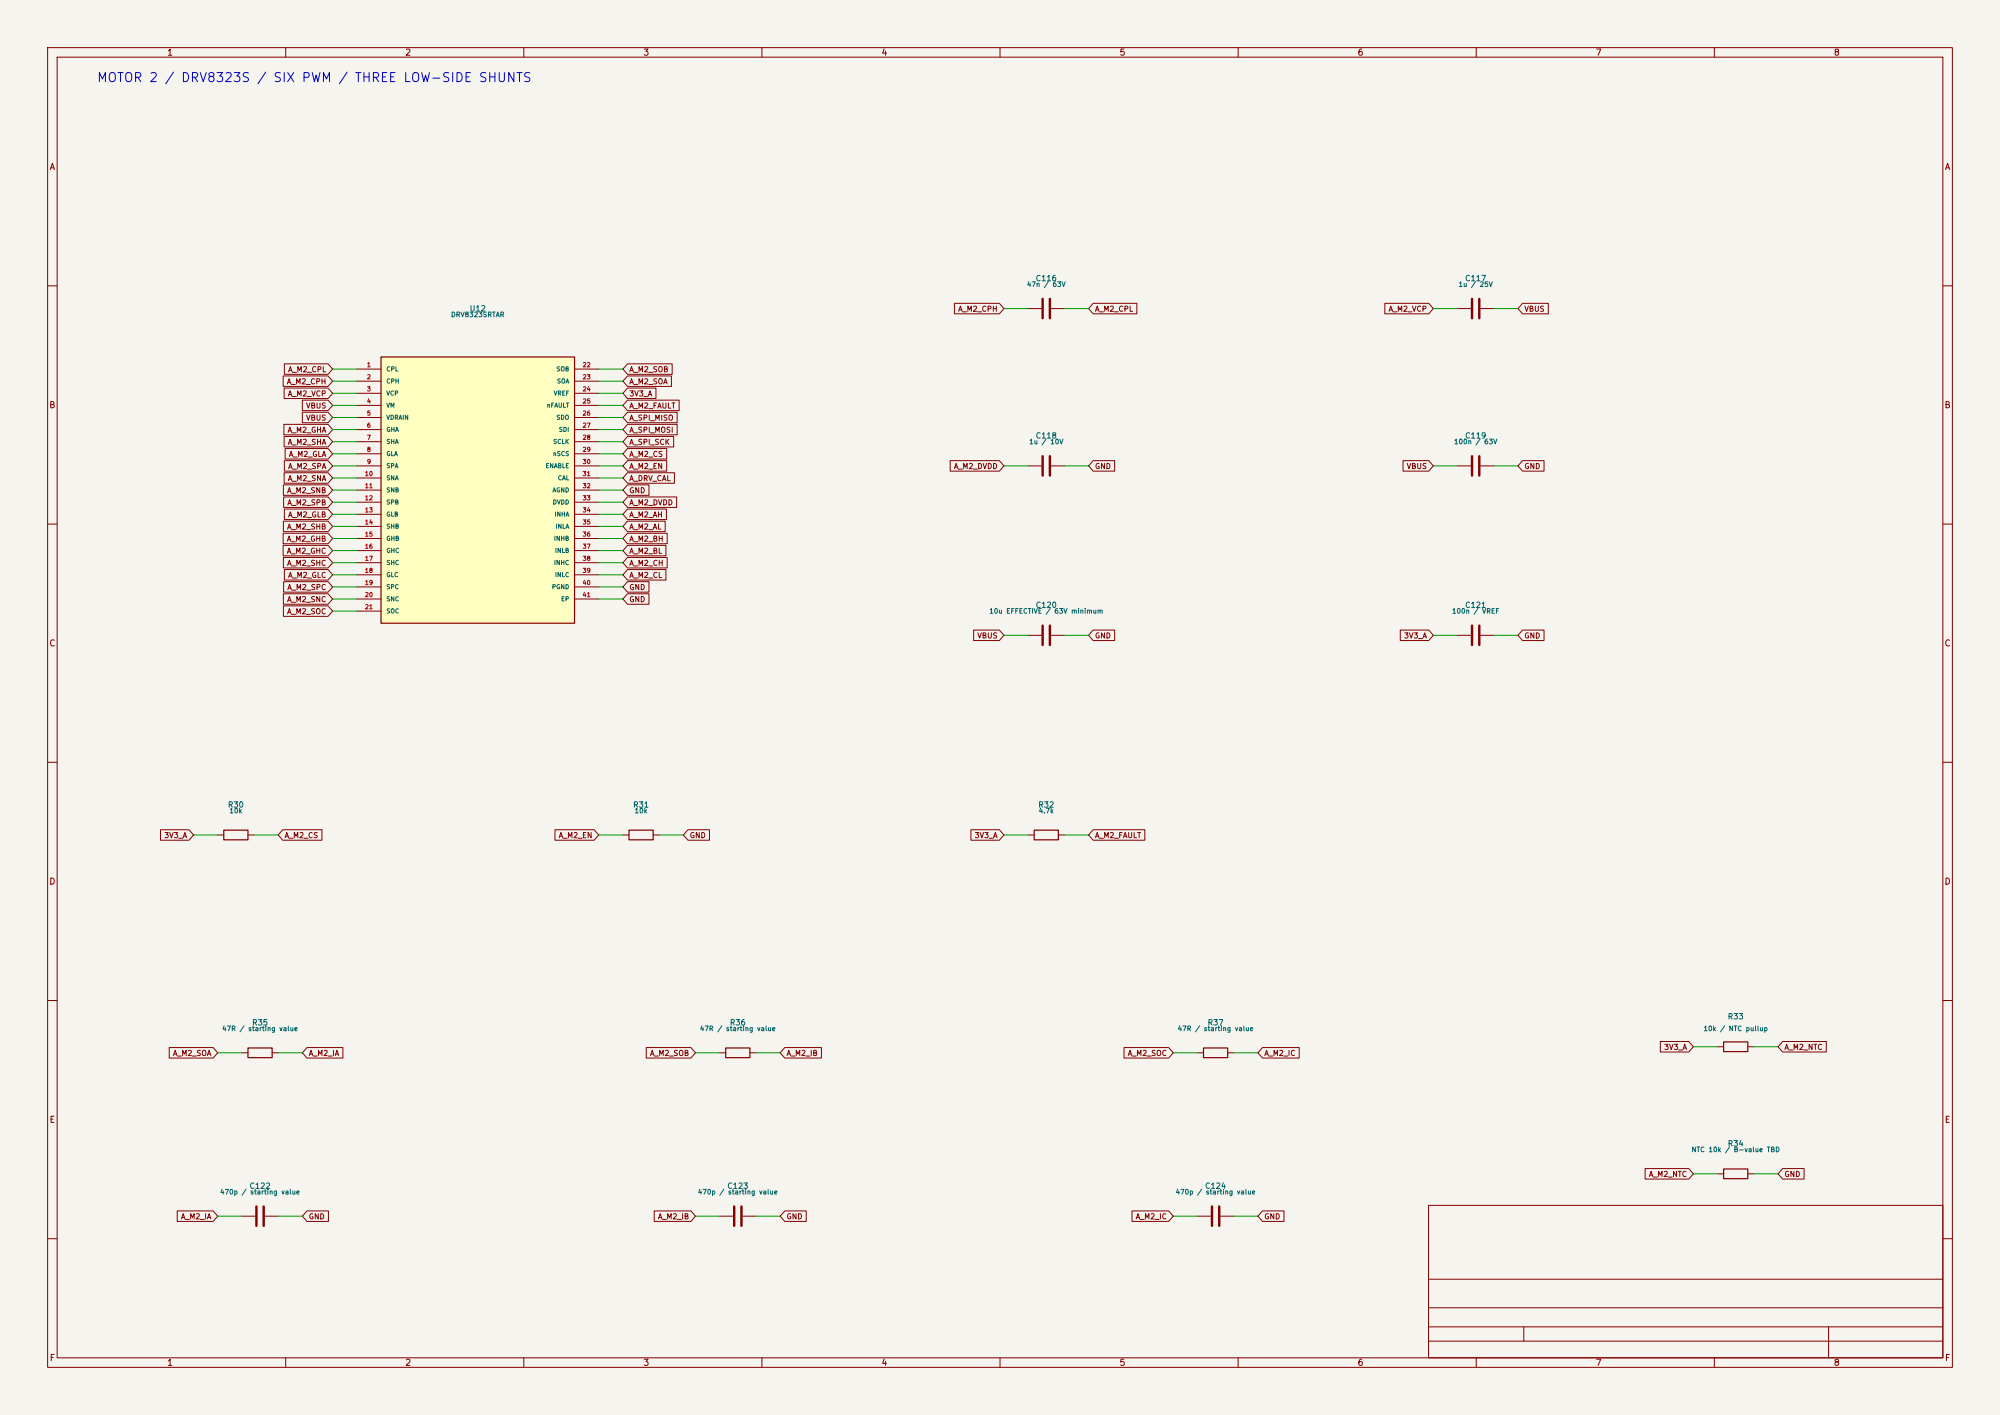
[picture p46: page 7]

VBUS MOTOR 2 / DRV8323S / SIX PWM / THREE LOW-SIDE SHUNTS
A_M2_CPL 3V3_A

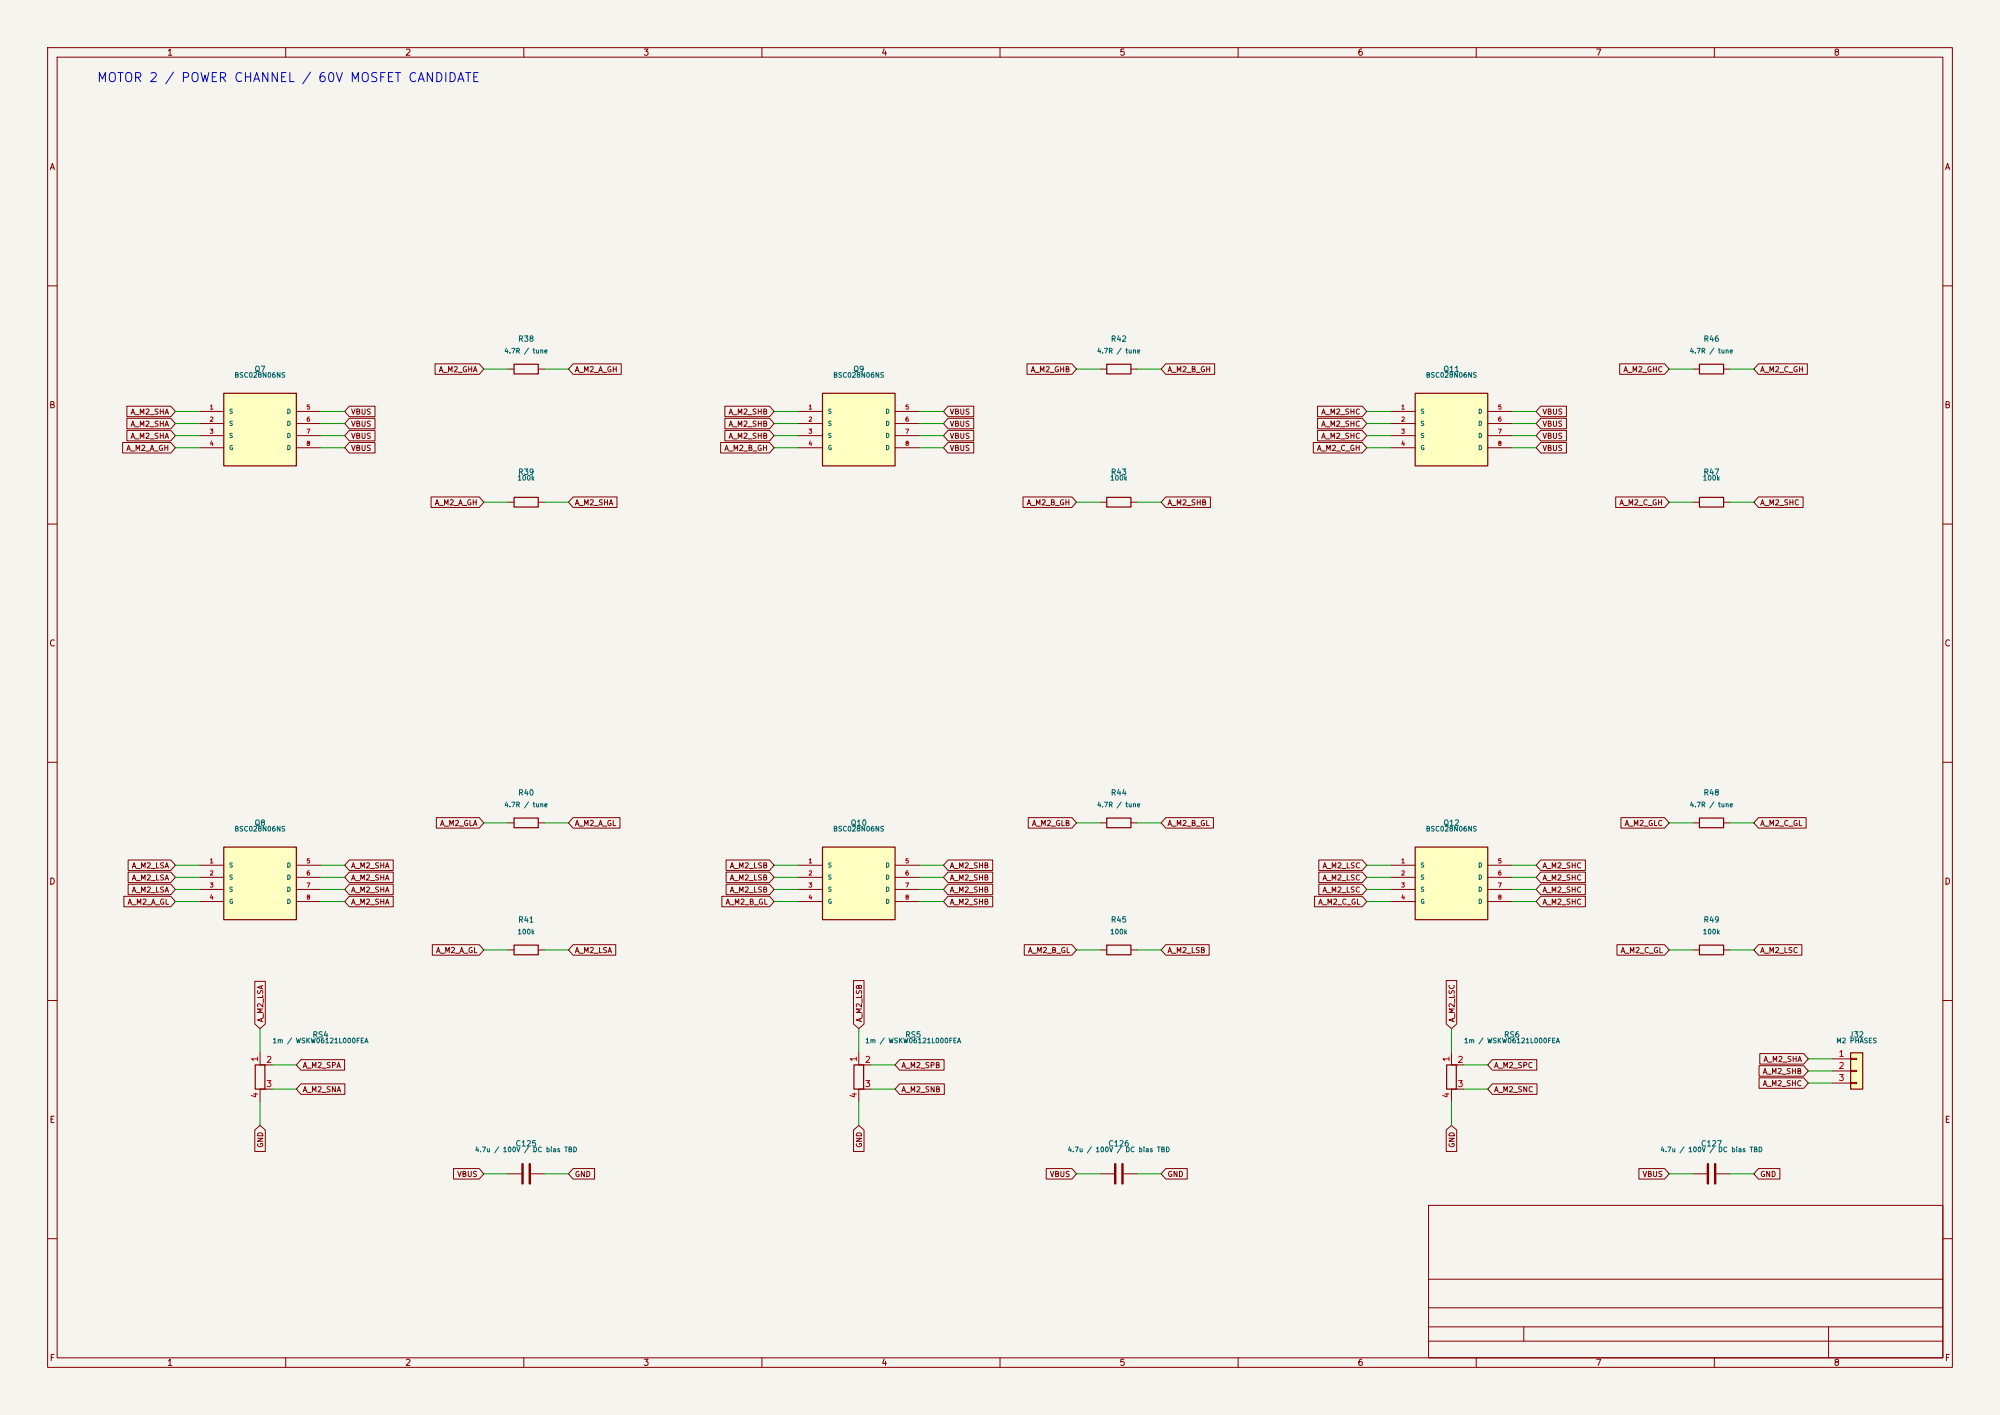
[picture p47: page 8]

A_M2_A_GH MOTOR 2 / POWER CHANNEL / 60V MOSFET CANDIDATE

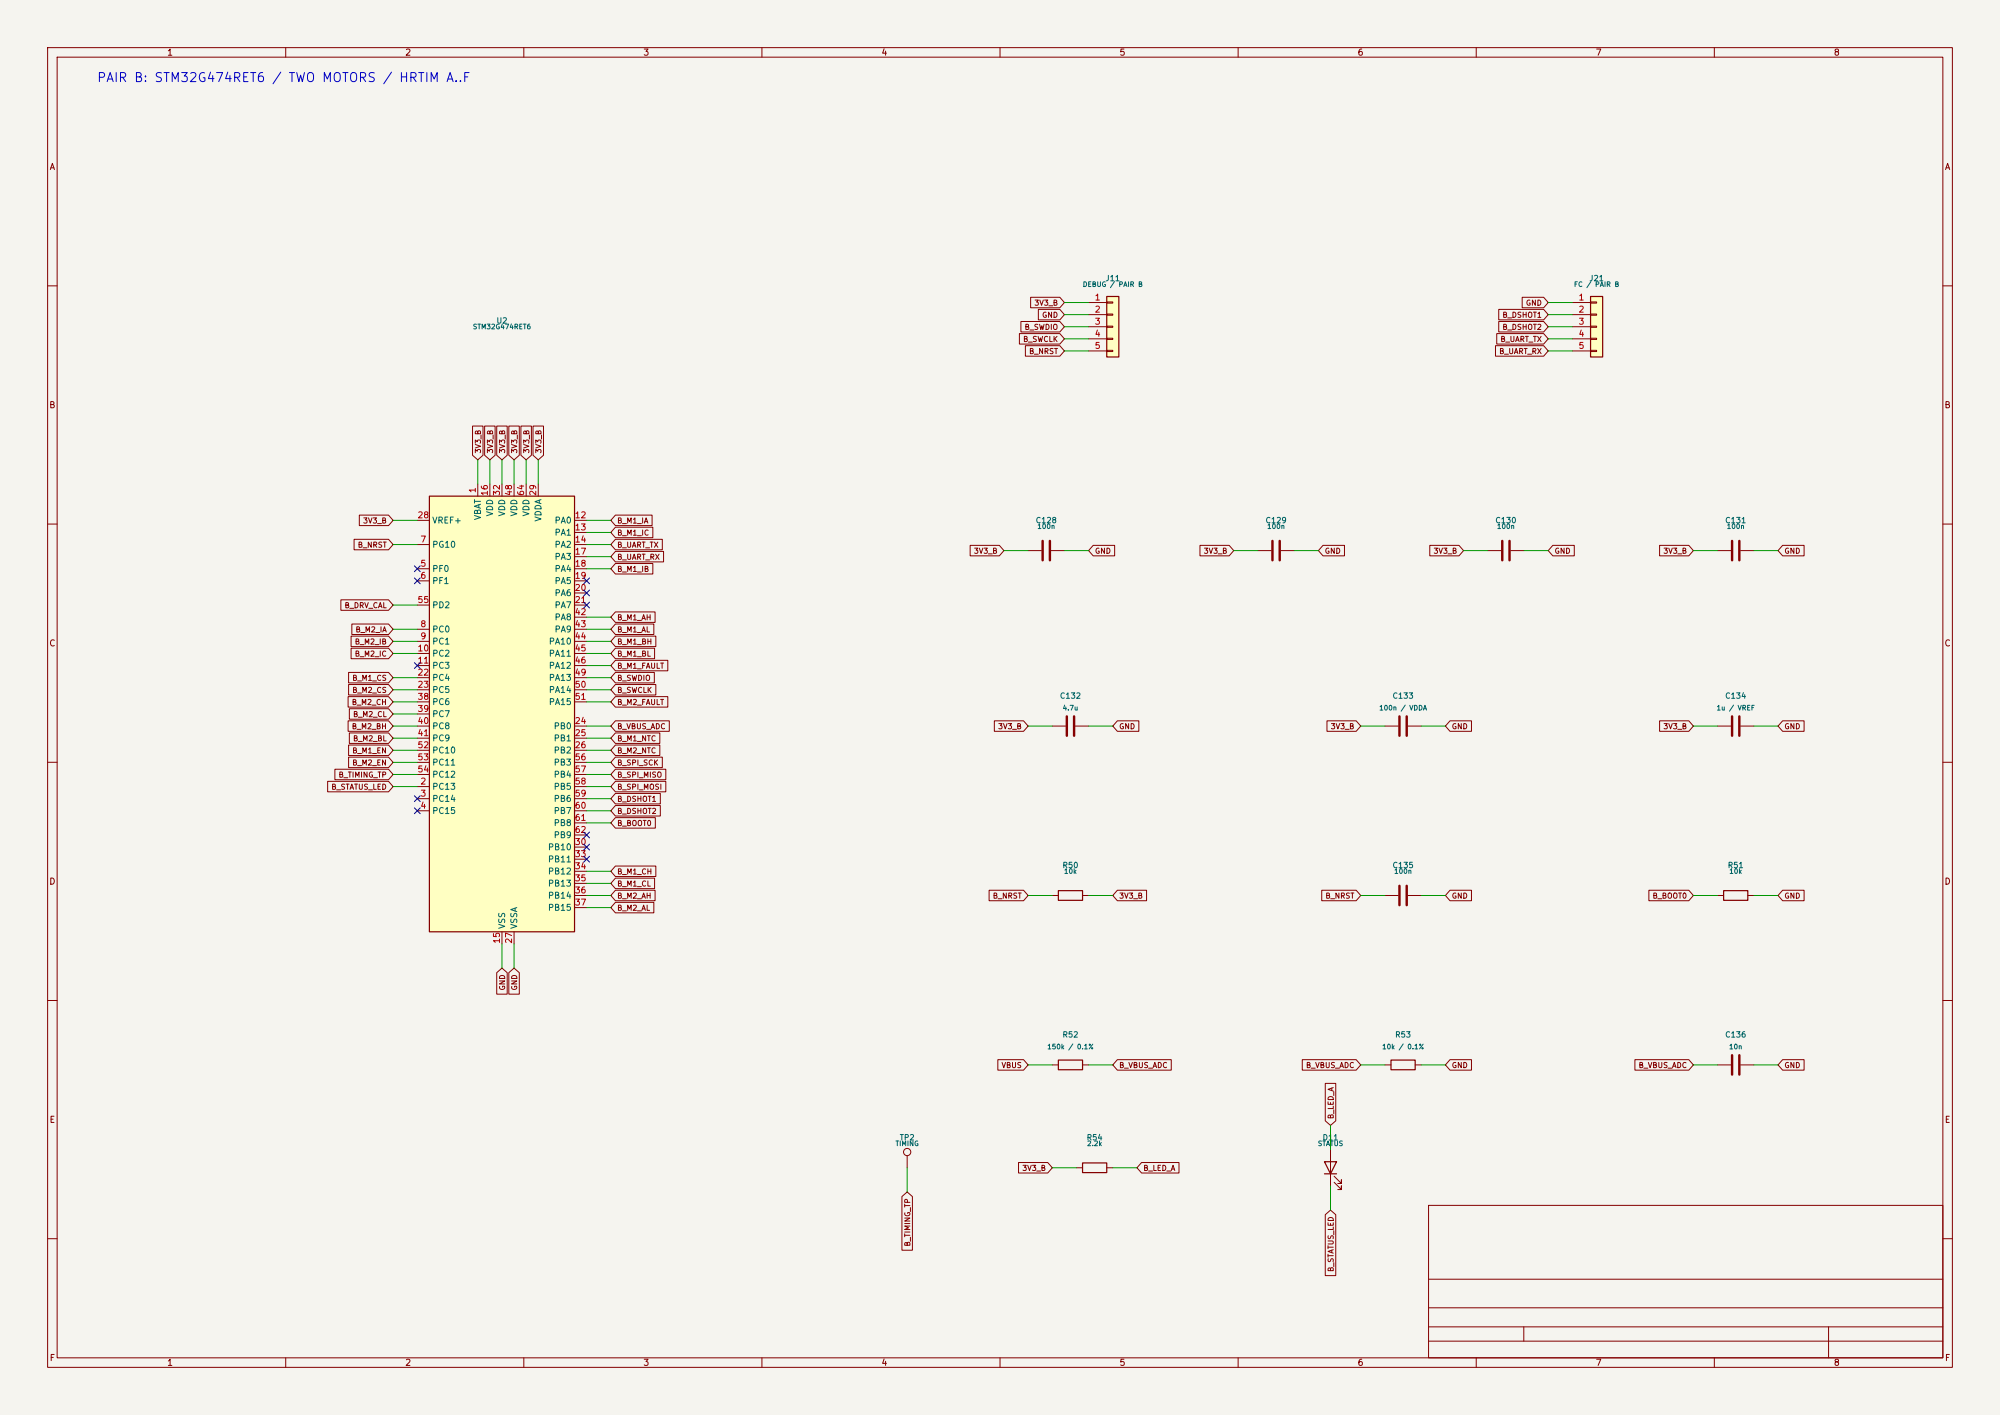
[picture p48: page 9]

B_DSHOT2 B_UART_RX PAIR B: STM32G474RET6 / TWO MOTORS / HRTIM A..F

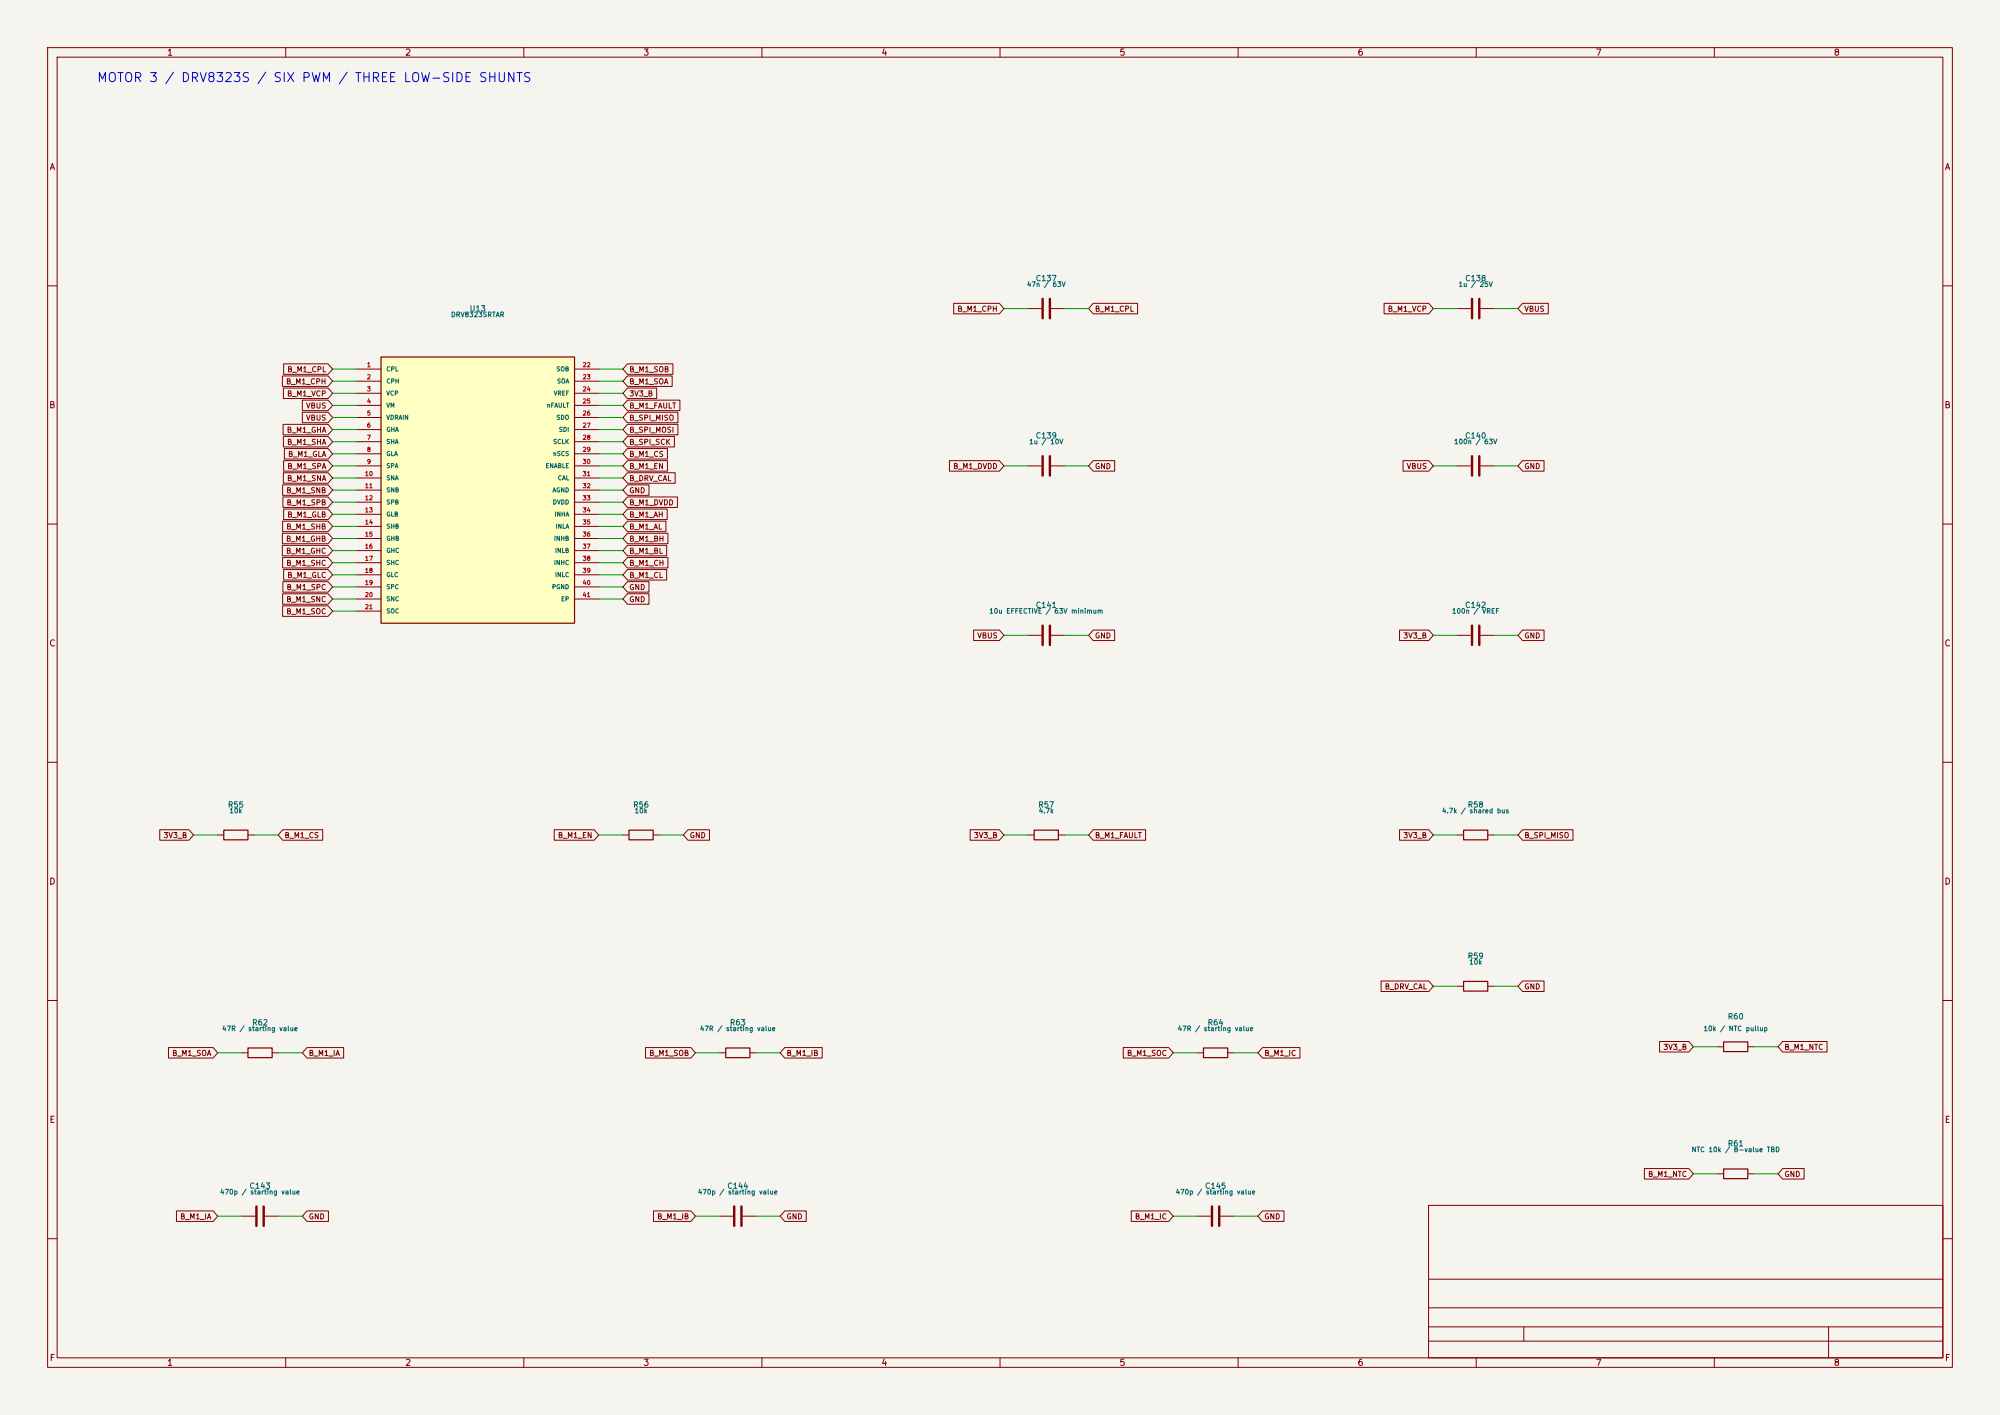
[picture p49: page 10]

B_M1_GLA MOTOR 3 / DRV8323S / SIX PWM / THREE LOW-SIDE SHUNTS

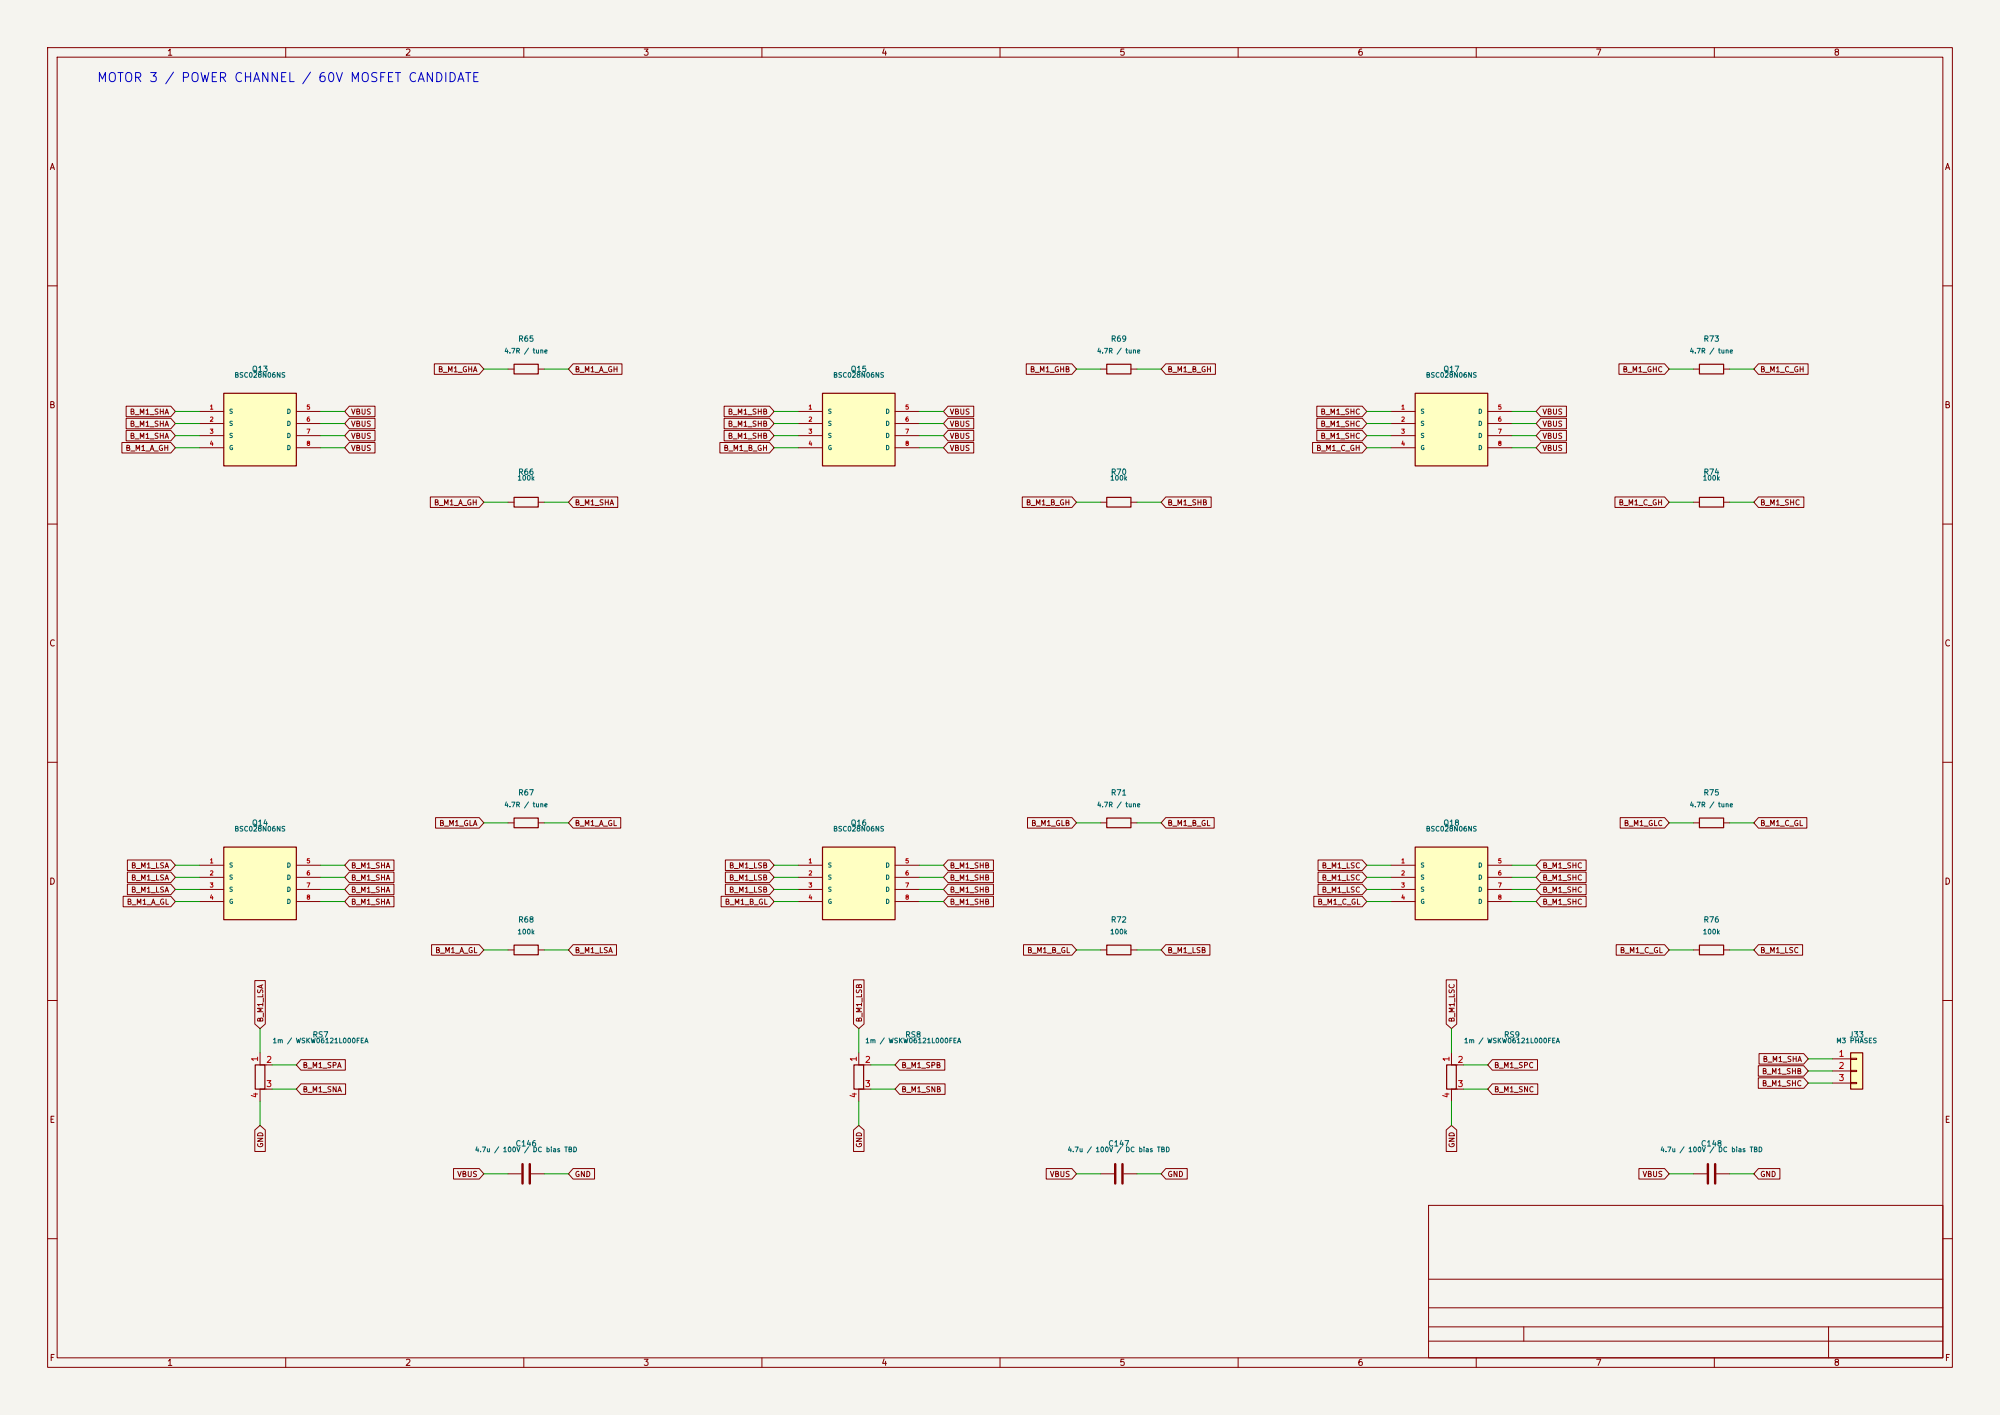
[picture p50: page 11]

MOTOR 3 / POWER CHANNEL / 60V MOSFET CANDIDATE

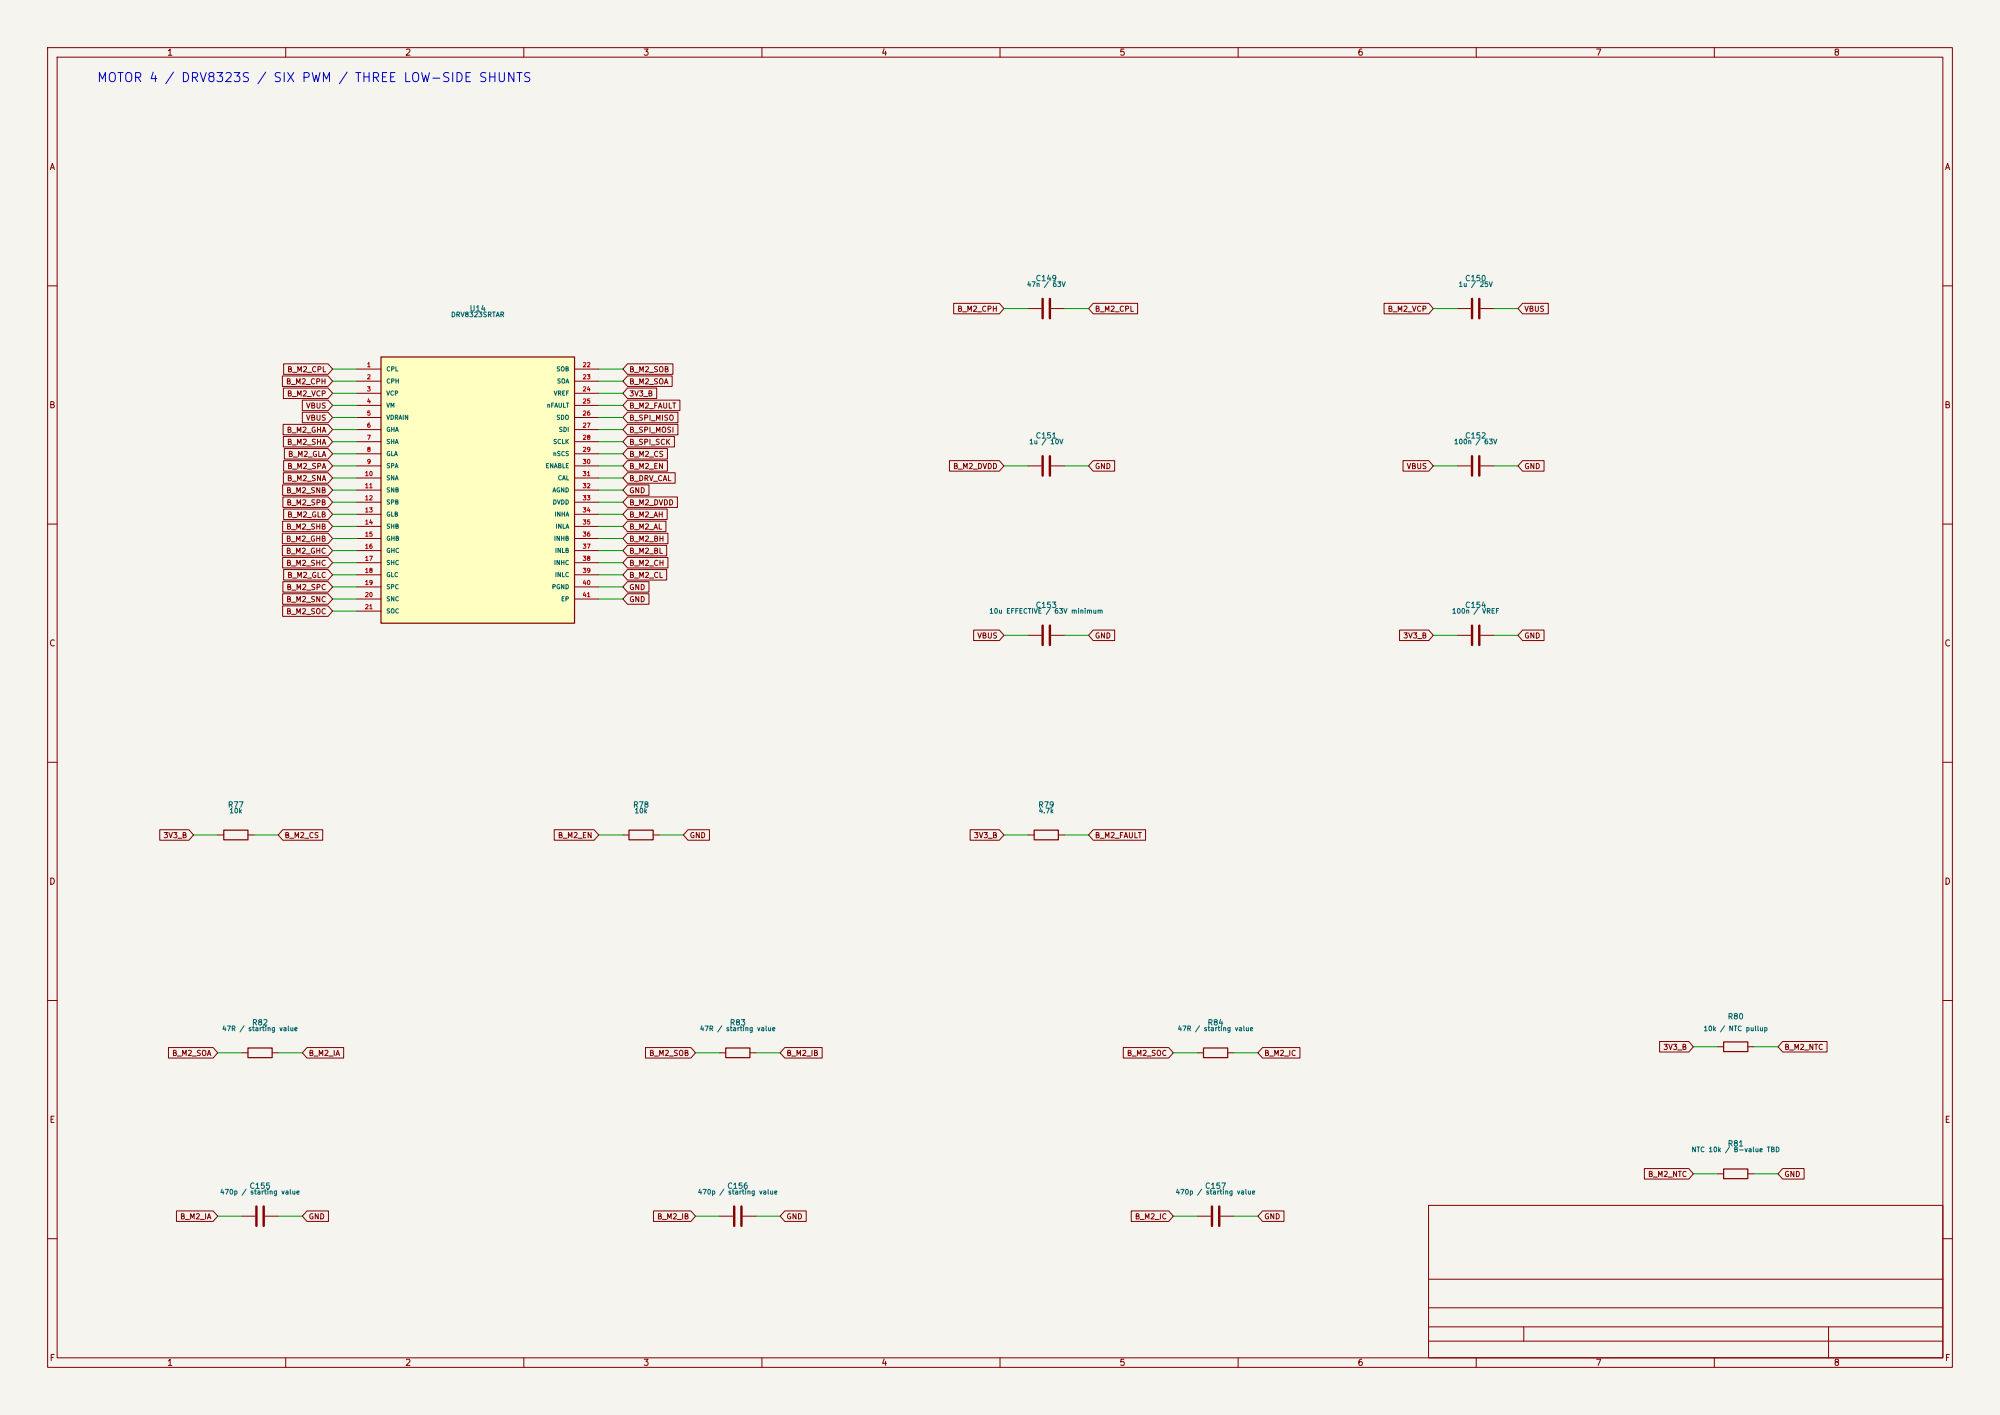
[picture p51: page 12]

NTC 10k / B-value TBD C156 470p / starting value R83 47R / starting value GND

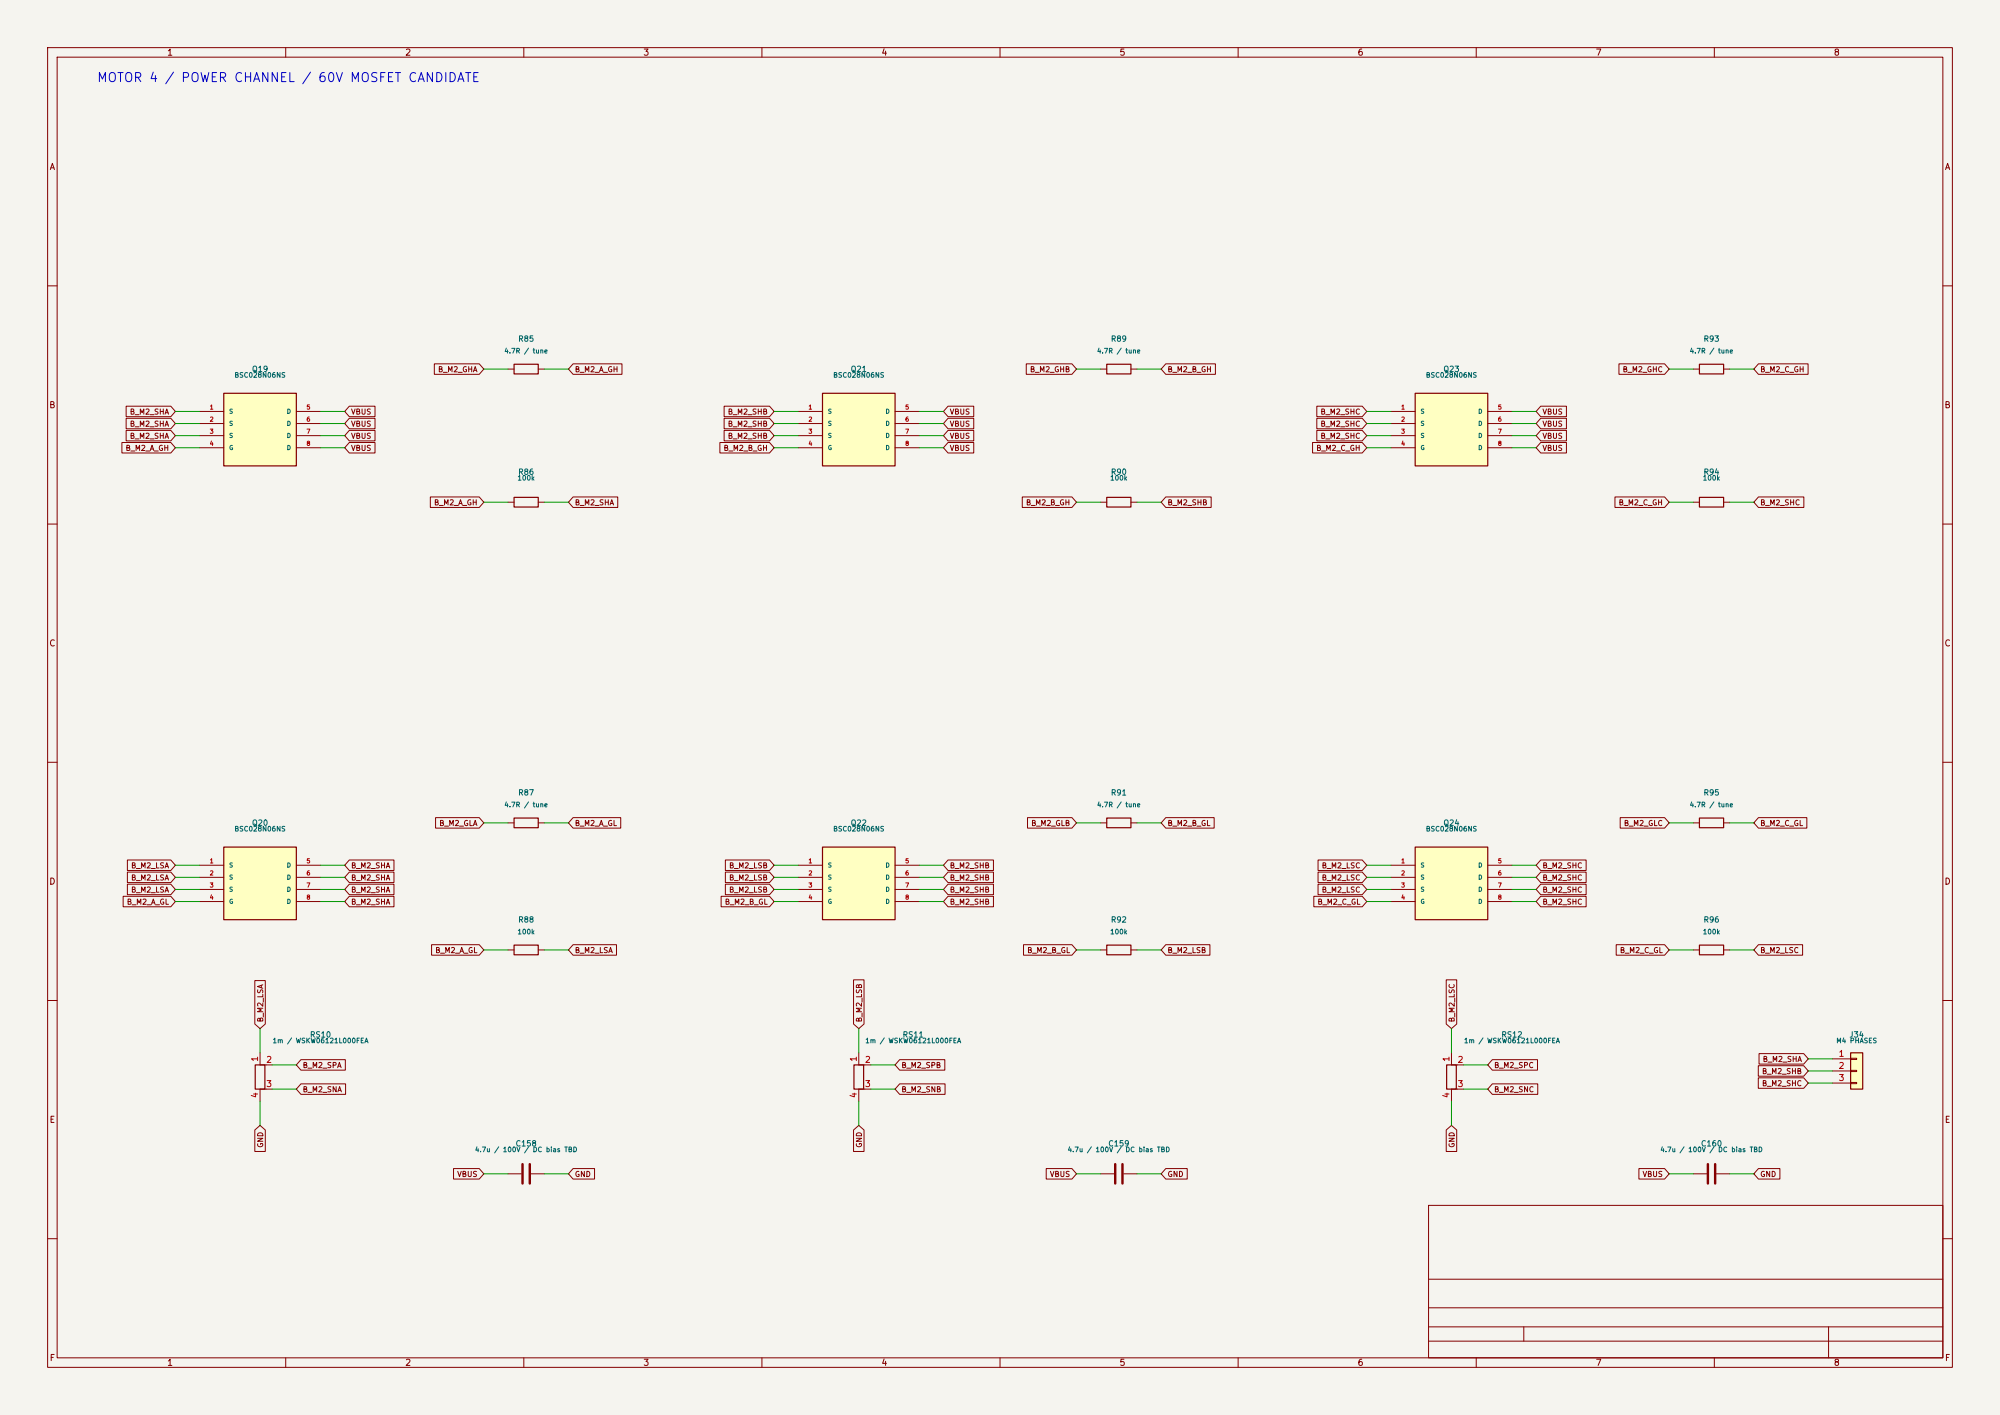
[picture p52: page 13]

B_M2_B_GH MOTOR 4 / POWER CHANNEL / 60V MOSFET CANDIDATE
