dganin-hw/bldc-foc/hardware/dev-board/documentation/ASSEMBLY.pdf

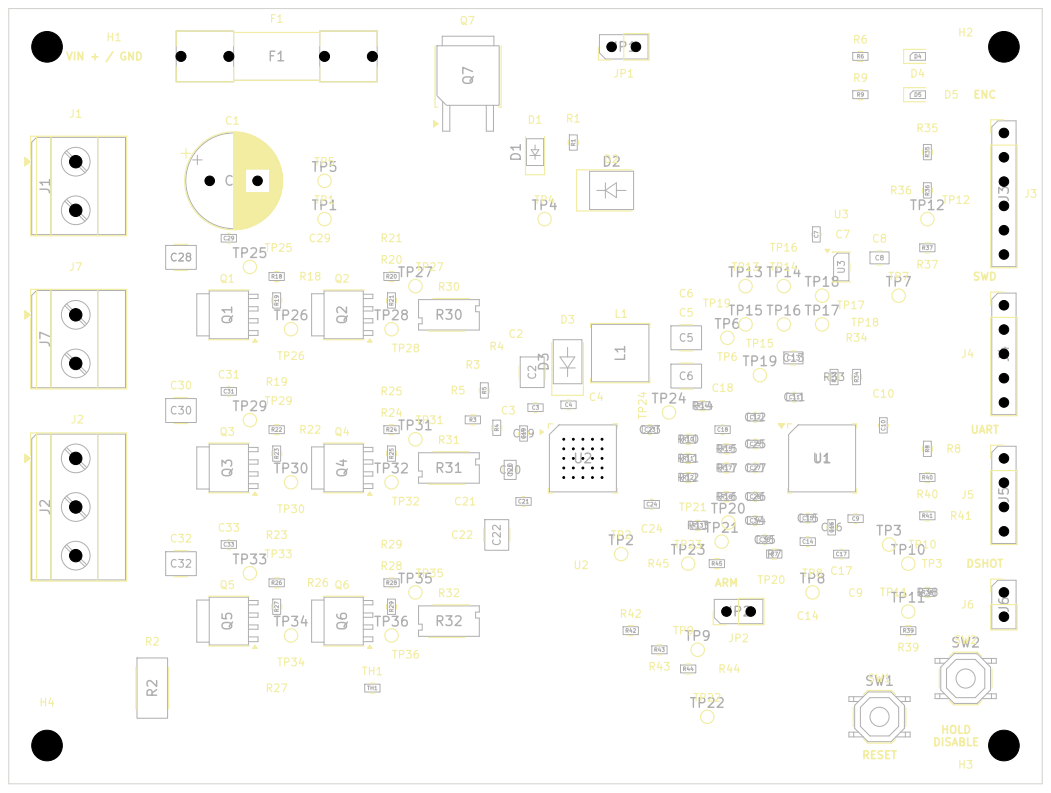
[picture p53: page 1]
