dganin-hw/bldc-foc/hardware/encoder-board/documentation/ASSEMBLY-BOTTOM.pdf

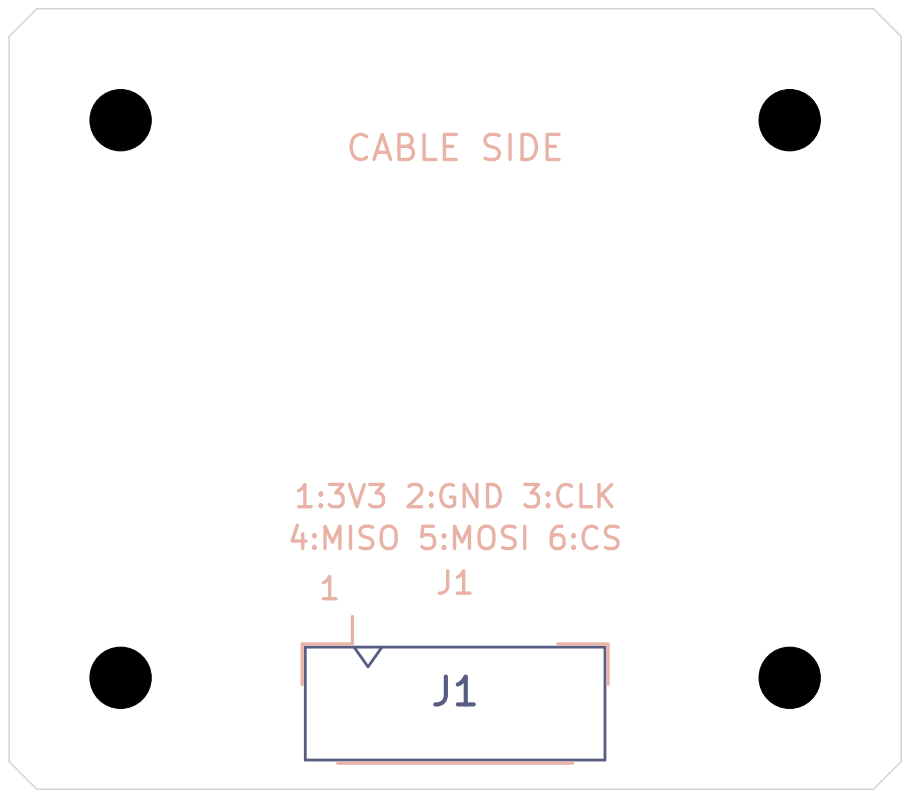
[picture p54: page 1]
