dganin-hw/bldc-foc/hardware/encoder-board/documentation/ASSEMBLY-TOP.pdf

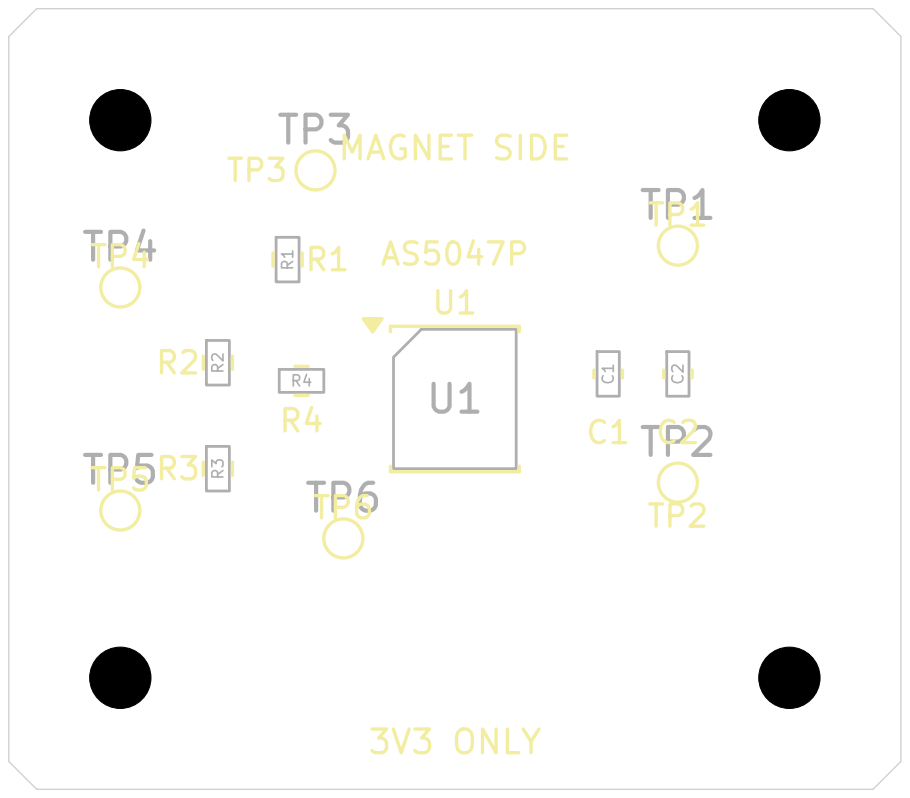
[picture p55: page 1]
