dganin-hw/bldc-foc/hardware/encoder-board/documentation/SCHEMATIC.pdf

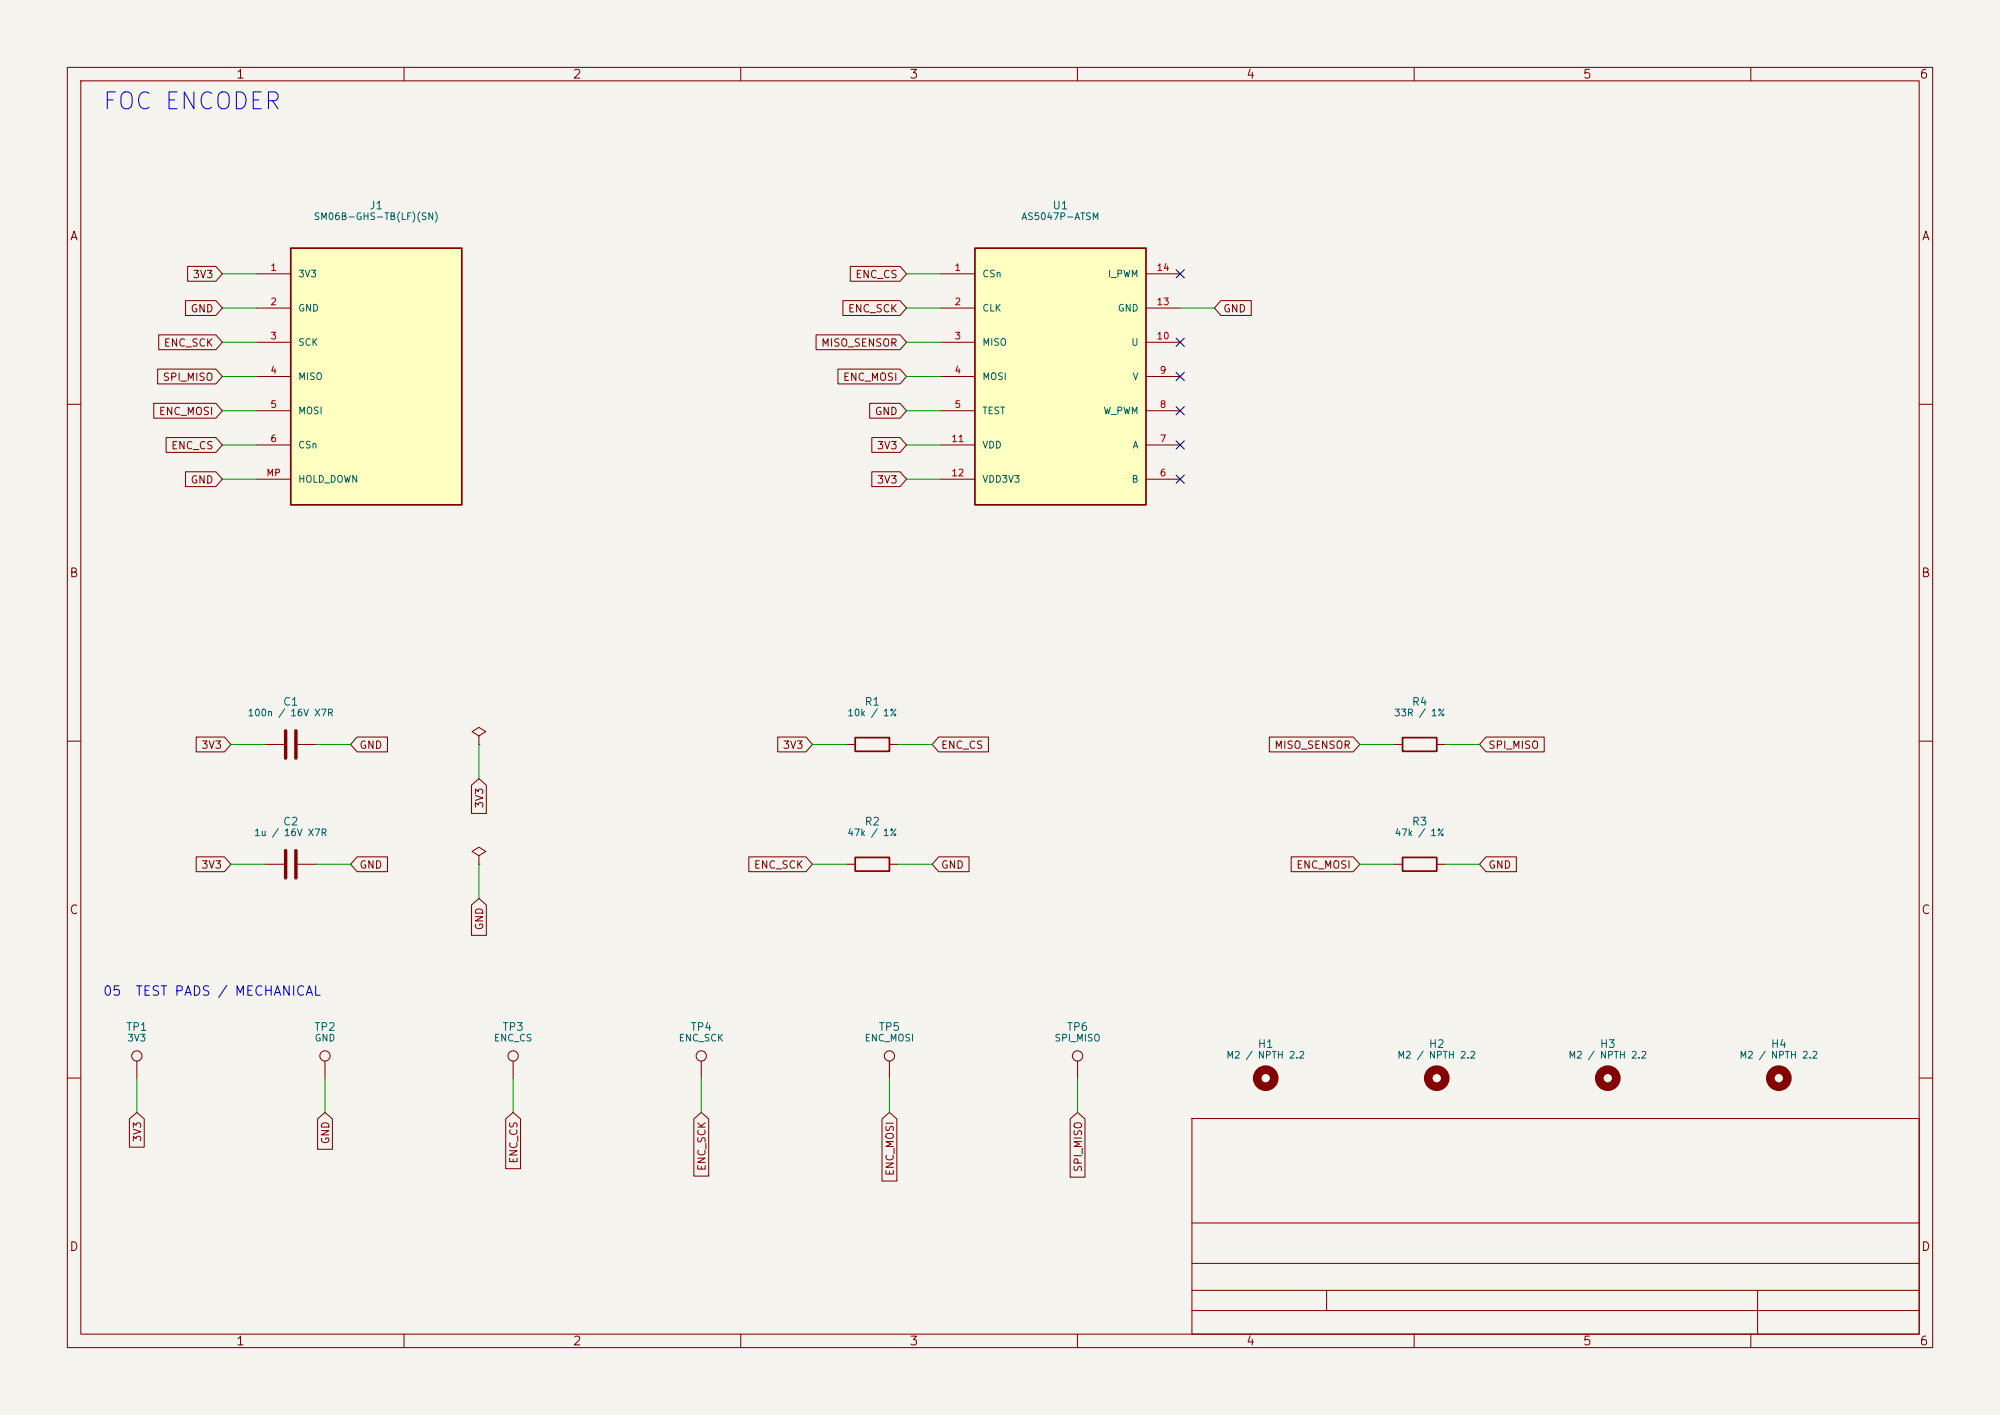
[picture p56: page 1]
