dganin-hw/bldc-foc/hardware/dev-board/kicad/foc-dev-board.kicad_pcb

## KiCad design hardware/dev-board/kicad/foc-dev-board.kicad_pcb (2026-10-20)

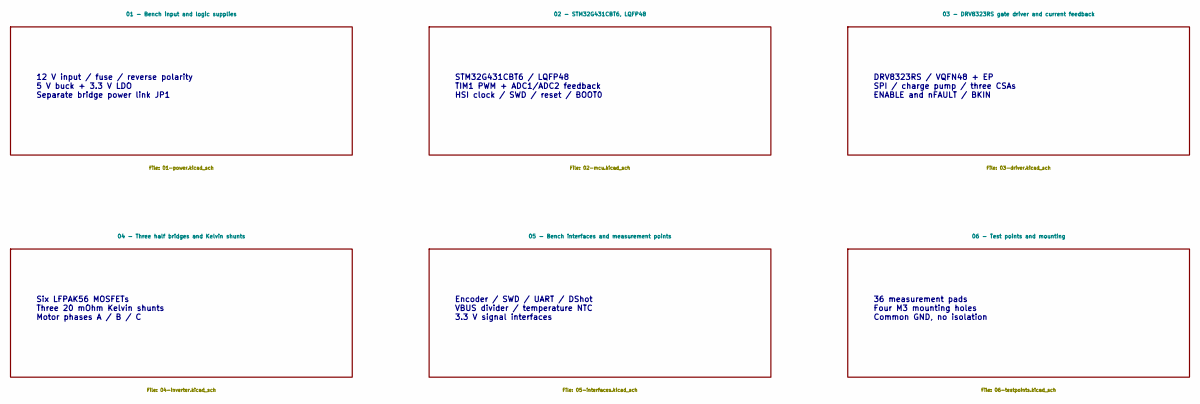
[picture p57: schematic foc-dev-board.kicad_sch]

Notes on the sheet:
12 V input / fuse / reverse polarity 5 V buck + 3.3 V LDO Separate bridge power link JP1
Encoder / SWD / UART / DShot VBUS divider / temperature NTC 3.3 V signal interfaces
Six LFPAK56 MOSFETs Three 20 mOhm Kelvin shunts Motor phases A / B / C
36 measurement pads Four M3 mounting holes Common GND, no isolation
DRV8323RS / VQFN48 + EP SPI / charge pump / three CSAs ENABLE and nFAULT / BKIN
STM32G431CBT6 / LQFP48 TIM1 PWM + ADC1/ADC2 feedback HSI clock / SWD / reset / BOOT0

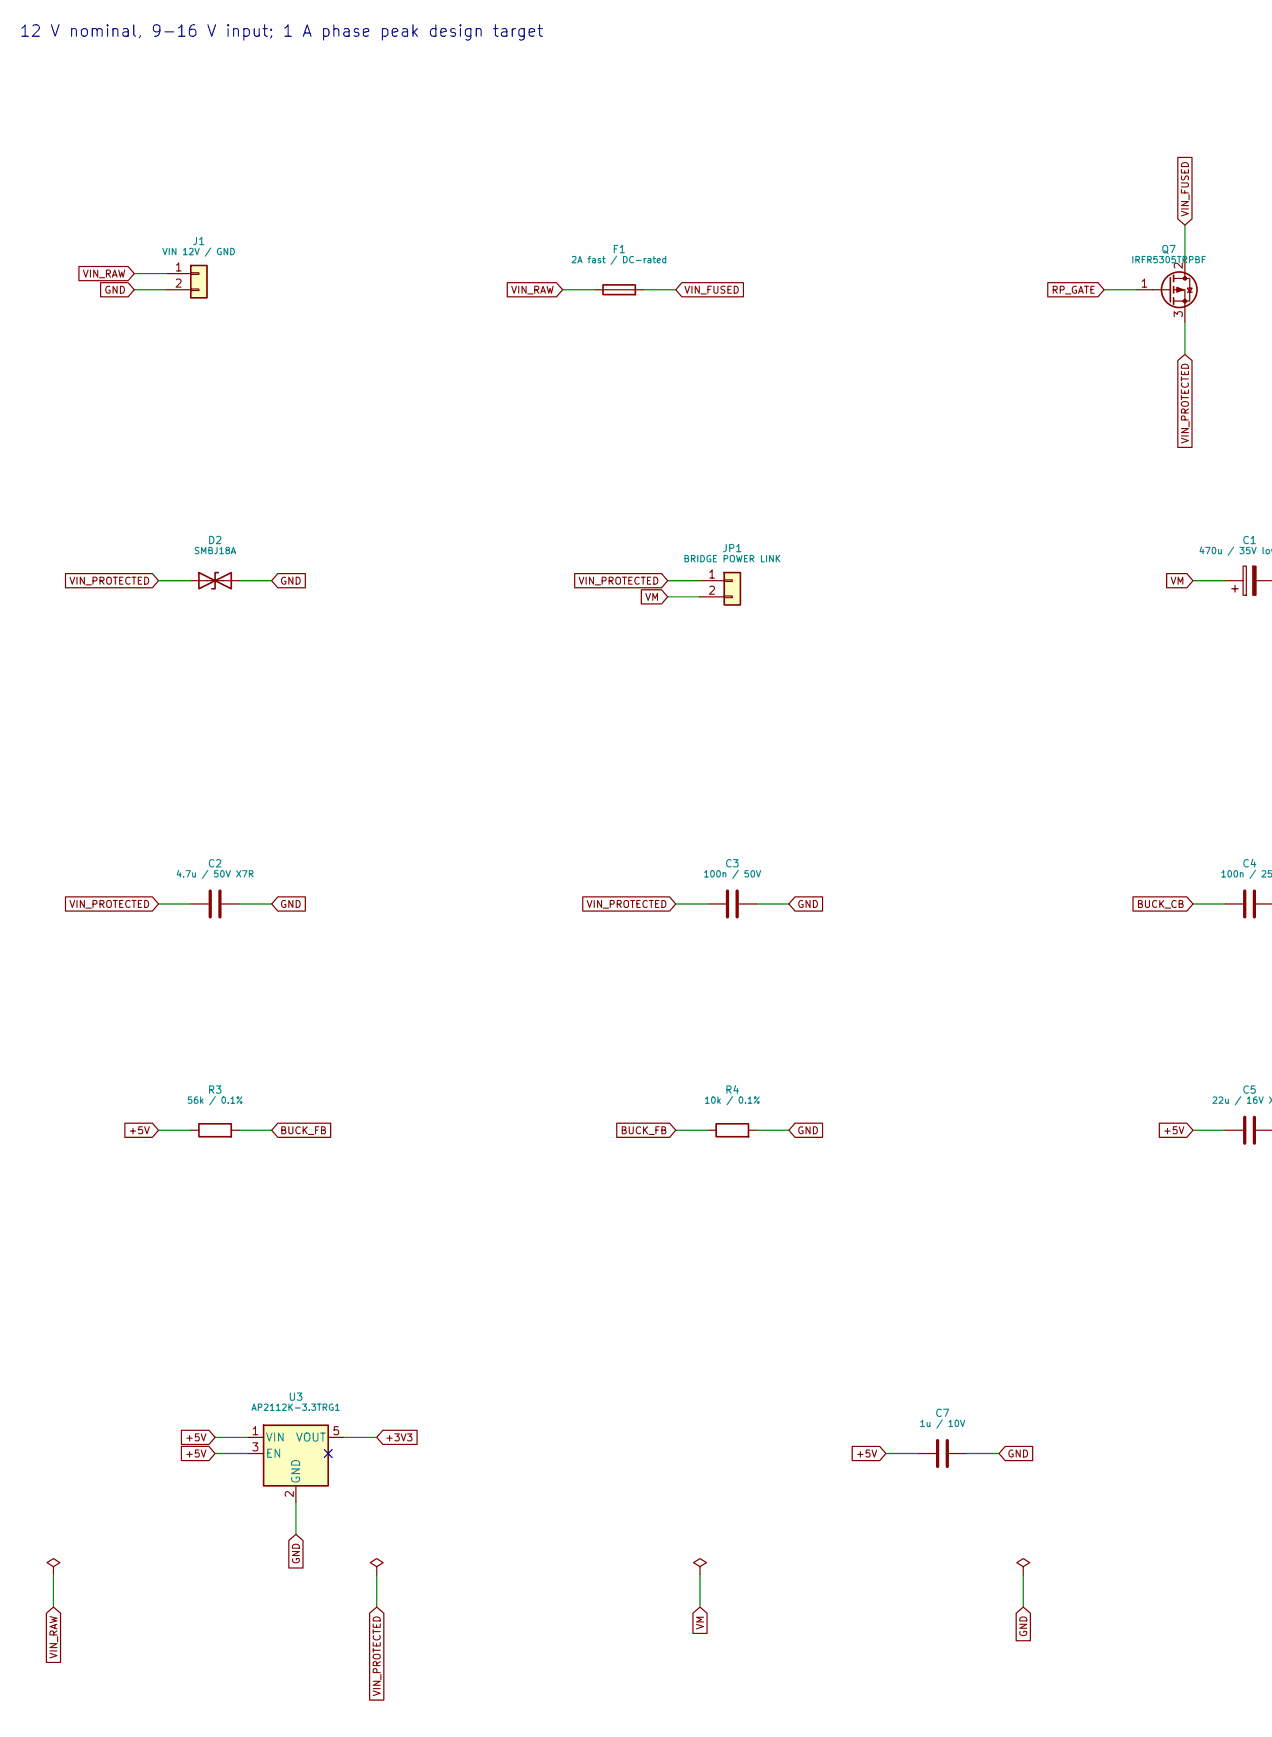
[picture p58: schematic 01-power.kicad_sch, part in row 1, column 1]

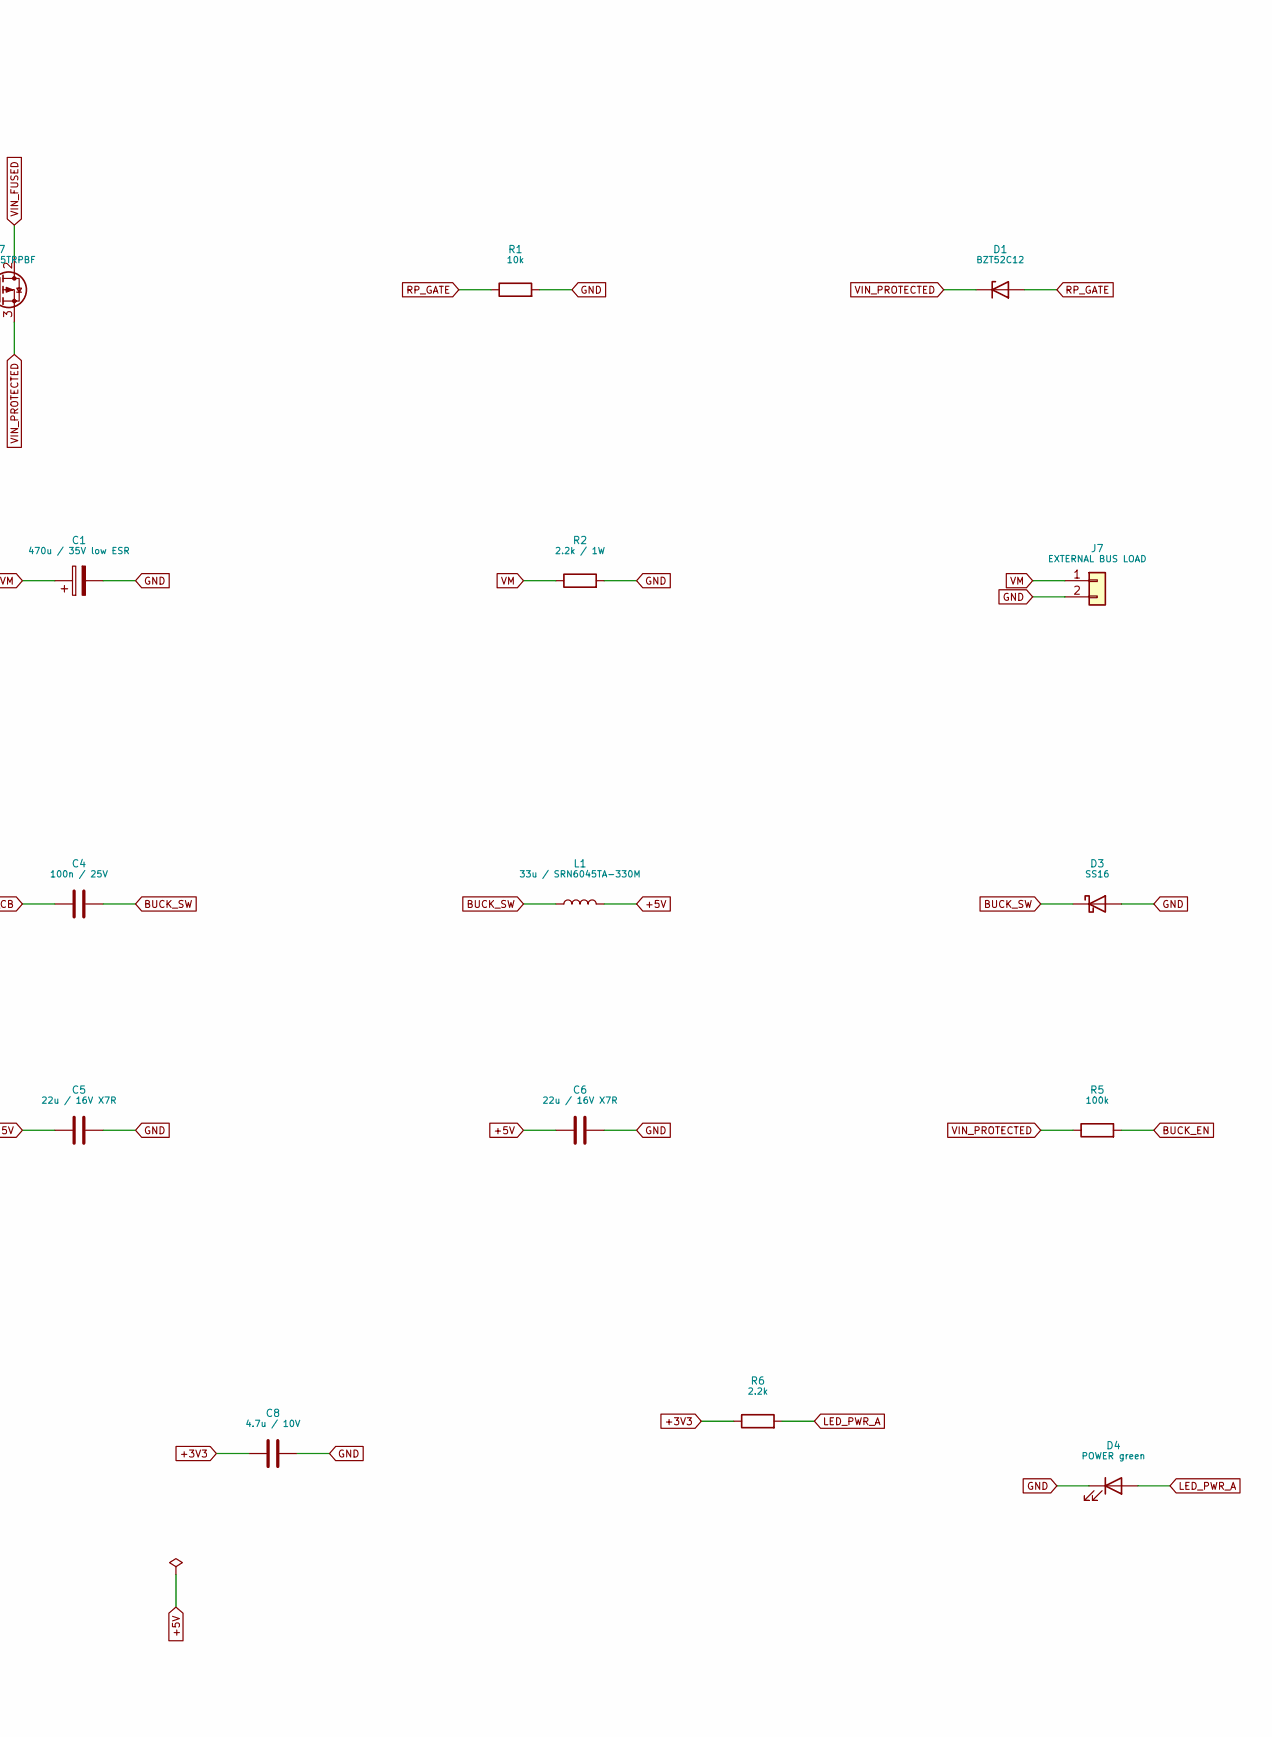
[picture p59: schematic 01-power.kicad_sch, part in row 1, column 2]

Parts:
C1: 470u / 35V low ESR; CP_Radial_D10.0mm_P5.00mm; MPN EEUFR1V471
C2: 4.7u / 50V X7R; C_1210_3225Metric
C3: 100n / 50V; C_0603_1608Metric
C4: 100n / 25V; C_0603_1608Metric
C5, C6: 22u / 16V X7R; C_1210_3225Metric
C7: 1u / 10V; C_0603_1608Metric
C8: 4.7u / 10V; C_0805_2012Metric
D1: BZT52C12; D_SOD-123; MPN BZT52C12-7-F
D2: SMBJ18A; D_SMB; MPN SMBJ18A
D3: SS16; D_SMA; MPN SS16
D4: POWER green; LED_0603_1608Metric
F1: 2A fast / DC-rated; Fuseholder_Clip-5x20mm_Littelfuse_111_Inline_P20.00x5.00mm_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; MPN 01110005MR x2
J1: VIN 12V / GND; TerminalBlock_Phoenix_MKDS-1,5-2-5.08_1x02_P5.08mm_Horizont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; MPN 1715721
J7: EXTERNAL BUS LOAD; TerminalBlock_Phoenix_MKDS-1,5-2-5.08_1x02_P5.08mm_Horizont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; MPN 1715721
JP1: BRIDGE POWER LINK; PinHeader_1x02_P2.54mm_Vertical
L1: 33u / SRN6045TA-330M; L_Bourns_SRN6045TA; MPN SRN6045TA-330M
Q7: IRFR5305TRPBF; TO-252-2; MPN IRFR5305TRPBF
R1: 10k; R_0603_1608Metric
R2: 2.2k / 1W; R_2512_6332Metric
R3: 56k / 0.1%; R_0603_1608Metric
R4: 10k / 0.1%; R_0603_1608Metric
R5: 100k; R_0603_1608Metric
R6: 2.2k; R_0603_1608Metric
U3: AP2112K-3.3TRG1; SOT-23-5; MPN AP2112K-3.3TRG1

Connections:
+3V3: C8.1, R6.1, U3.5 (VOUT); also elsewhere on the board
+5V: C5.1, C6.1, C7.1, L1.2, R3.1, U3.1 (VIN), U3.3 (EN); also elsewhere on the board
BUCK_CB: C4.1; also elsewhere on the board
BUCK_EN: R5.2; also elsewhere on the board
BUCK_FB: R3.2, R4.1; also elsewhere on the board
BUCK_SW: C4.2, D3.1 (K), L1.1; also elsewhere on the board
GND: C1.2, C2.2, C3.2, C5.2, C6.2, C7.2, C8.2, D2.2 (A2), D3.2 (A), D4.1 (K), J1.2, J7.2, R1.2, R2.2, R4.2, U3.2 (GND); also elsewhere on the board
LED_PWR_A: D4.2 (A), R6.2
RP_GATE: D1.2 (A), Q7.1 (G), R1.1
VIN_FUSED: F1.2, Q7.2 (D)
VIN_PROTECTED: C2.1, C3.1, D1.1 (K), D2.1 (A1), JP1.1, Q7.3 (S), R5.1; also elsewhere on the board
VIN_RAW: F1.1, J1.1
VM: C1.1, J7.1, JP1.2, R2.1; also elsewhere on the board

Notes on the sheet:
12 V nominal, 9-16 V input; 1 A phase peak design target

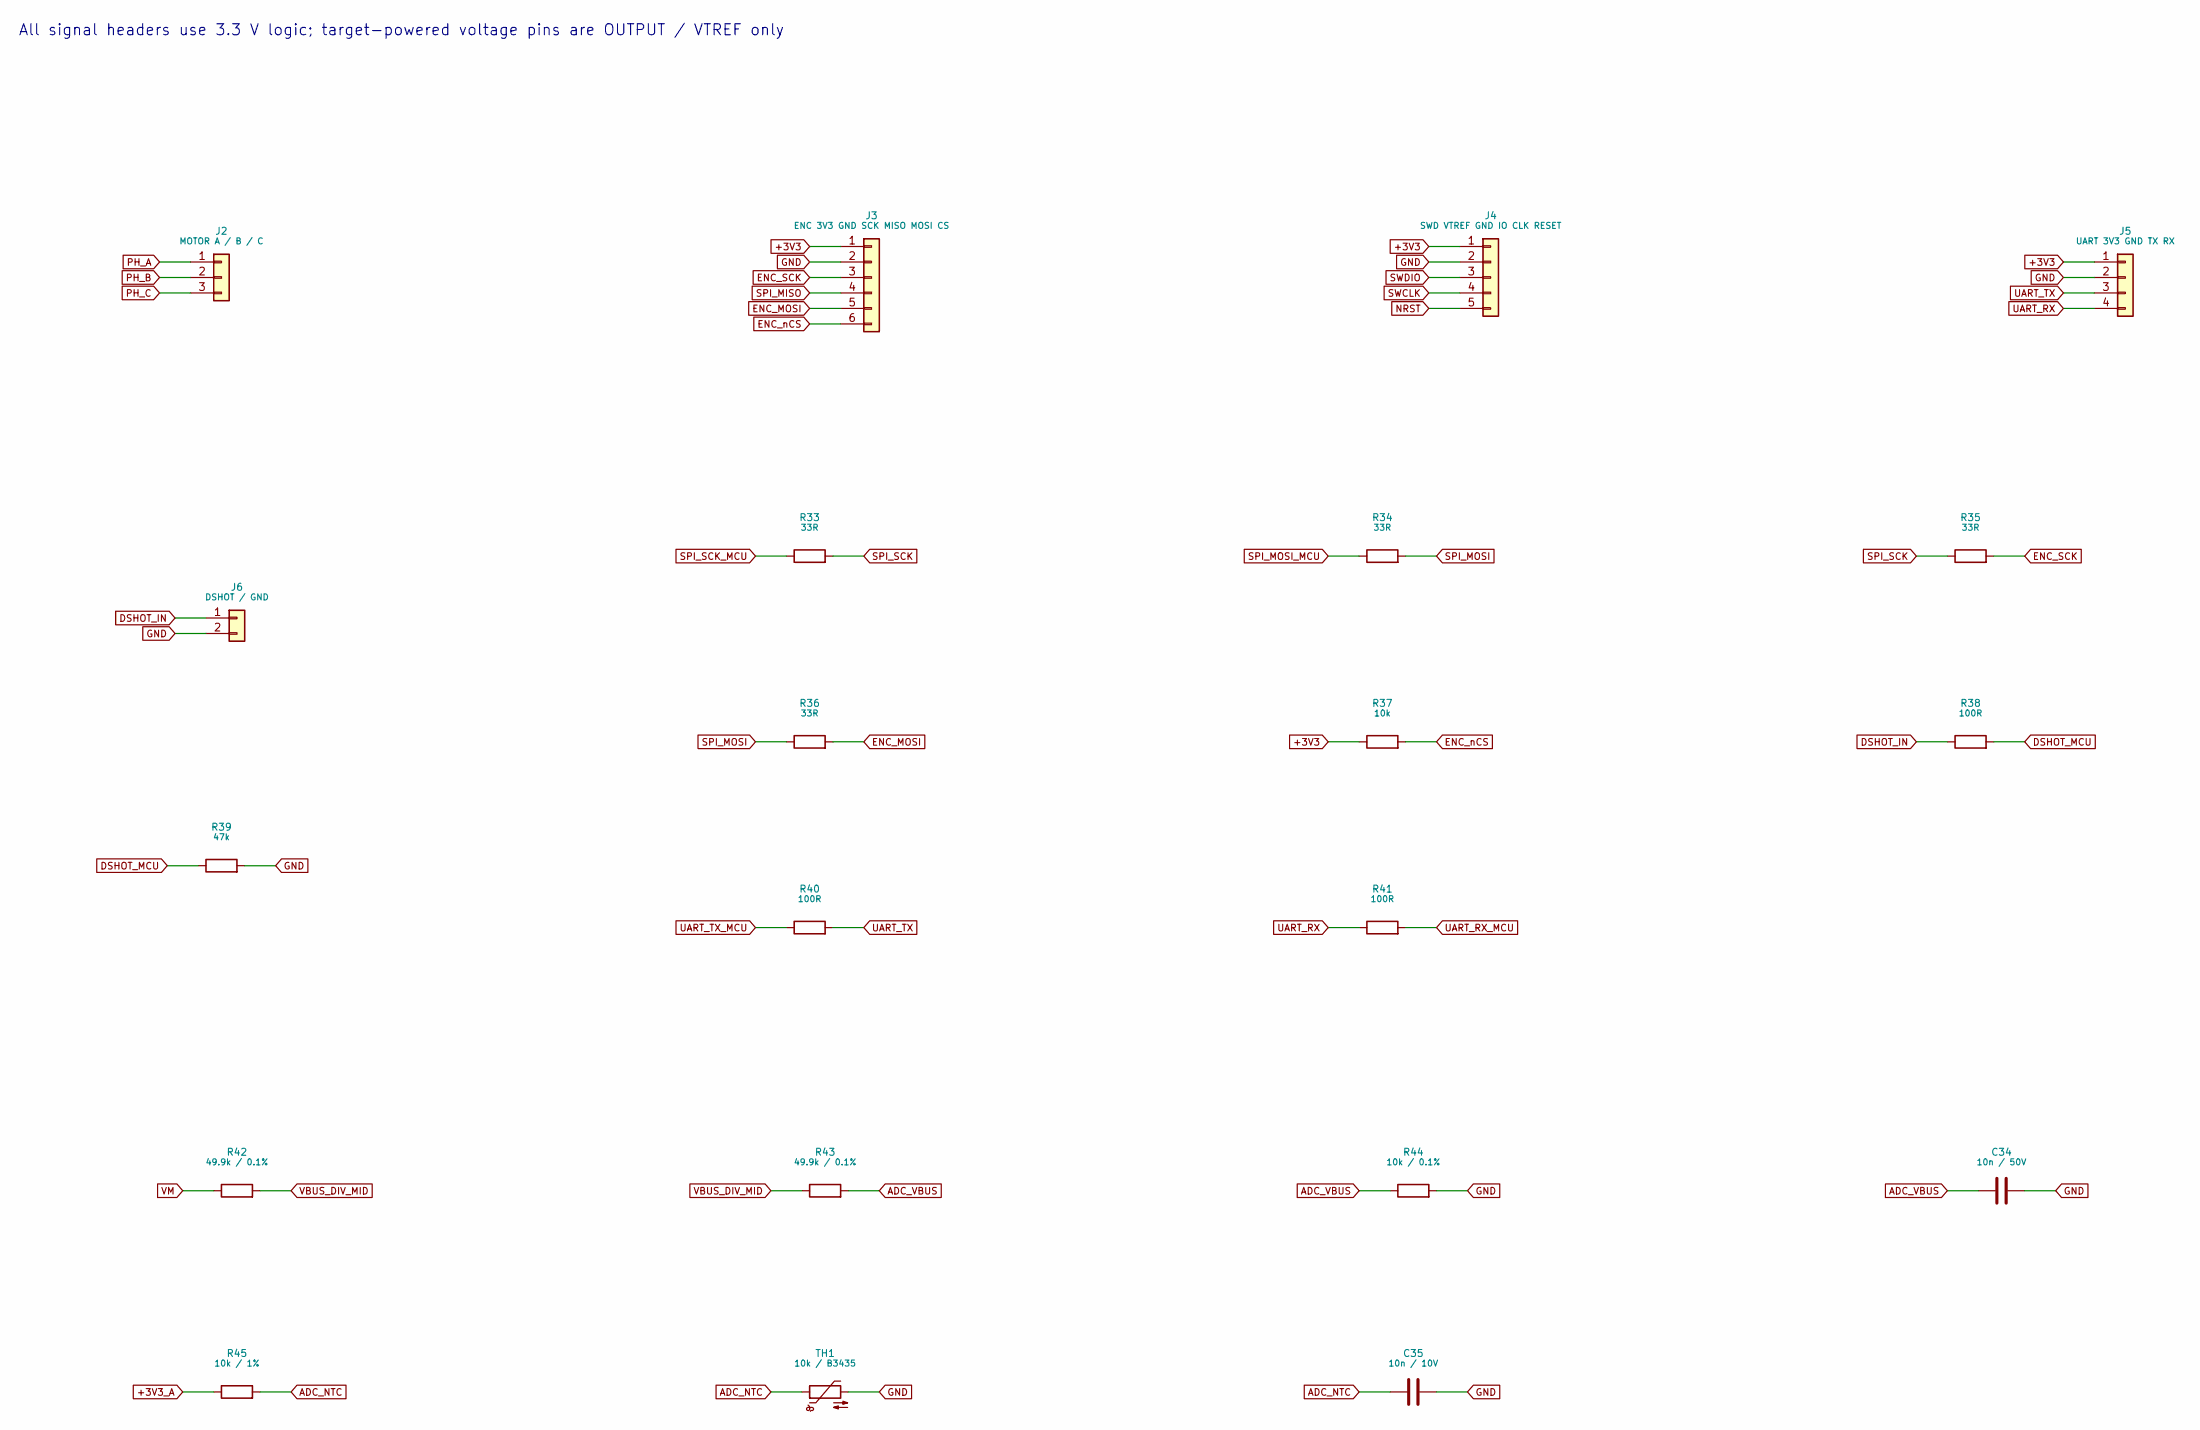
[picture p60: schematic 05-interfaces.kicad_sch]

Parts:
C34: 10n / 50V; C_0603_1608Metric
C35: 10n / 10V; C_0603_1608Metric
J2: MOTOR A / B / C; TerminalBlock_Phoenix_MKDS-1,5-3-5.08_1x03_P5.08mm_Horizont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; MPN 1715734
J3: ENC 3V3 GND SCK MISO MOSI CS; PinHeader_1x06_P2.54mm_Vertical
J4: SWD VTREF GND IO CLK RESET; PinHeader_1x05_P2.54mm_Vertical
J5: UART 3V3 GND TX RX; PinHeader_1x04_P2.54mm_Vertical
J6: DSHOT / GND; PinHeader_1x02_P2.54mm_Vertical
R33, R34, R35, R36: 33R; R_0603_1608Metric
R37: 10k; R_0603_1608Metric
R38, R40, R41: 100R; R_0603_1608Metric
R39: 47k; R_0603_1608Metric
R42, R43: 49.9k / 0.1%; R_0603_1608Metric
R44: 10k / 0.1%; R_0603_1608Metric
R45: 10k / 1%; R_0603_1608Metric
TH1: 10k / B3435; R_0603_1608Metric; MPN NCP18XH103F03RB

Connections:
+3V3: J3.1, J4.1, J5.1, R37.1; also elsewhere on the board
+3V3_A: R45.1; also elsewhere on the board
ADC_NTC: C35.1, R45.2, TH1.1; also elsewhere on the board
ADC_VBUS: C34.1, R43.2, R44.1; also elsewhere on the board
DSHOT_IN: J6.1, R38.1
DSHOT_MCU: R38.2, R39.1; also elsewhere on the board
ENC_MOSI: J3.5, R36.2
ENC_SCK: J3.3, R35.2
ENC_nCS: J3.6, R37.2; also elsewhere on the board
GND: C34.2, C35.2, J3.2, J4.2, J5.2, J6.2, R39.2, R44.2, TH1.2; also elsewhere on the board
NRST: J4.5; also elsewhere on the board
PH_A: J2.1; also elsewhere on the board
PH_B: J2.2; also elsewhere on the board
PH_C: J2.3; also elsewhere on the board
SPI_MISO: J3.4; also elsewhere on the board
SPI_MOSI: R34.2, R36.1; also elsewhere on the board
SPI_MOSI_MCU: R34.1; also elsewhere on the board
SPI_SCK: R33.2, R35.1; also elsewhere on the board
SPI_SCK_MCU: R33.1; also elsewhere on the board
SWCLK: J4.4; also elsewhere on the board
SWDIO: J4.3; also elsewhere on the board
UART_RX: J5.4, R41.1
UART_RX_MCU: R41.2; also elsewhere on the board
UART_TX: J5.3, R40.2
UART_TX_MCU: R40.1; also elsewhere on the board
VBUS_DIV_MID: R42.2, R43.1
VM: R42.1; also elsewhere on the board

Notes on the sheet:
All signal headers use 3.3 V logic; target-powered voltage pins are OUTPUT / VTREF only

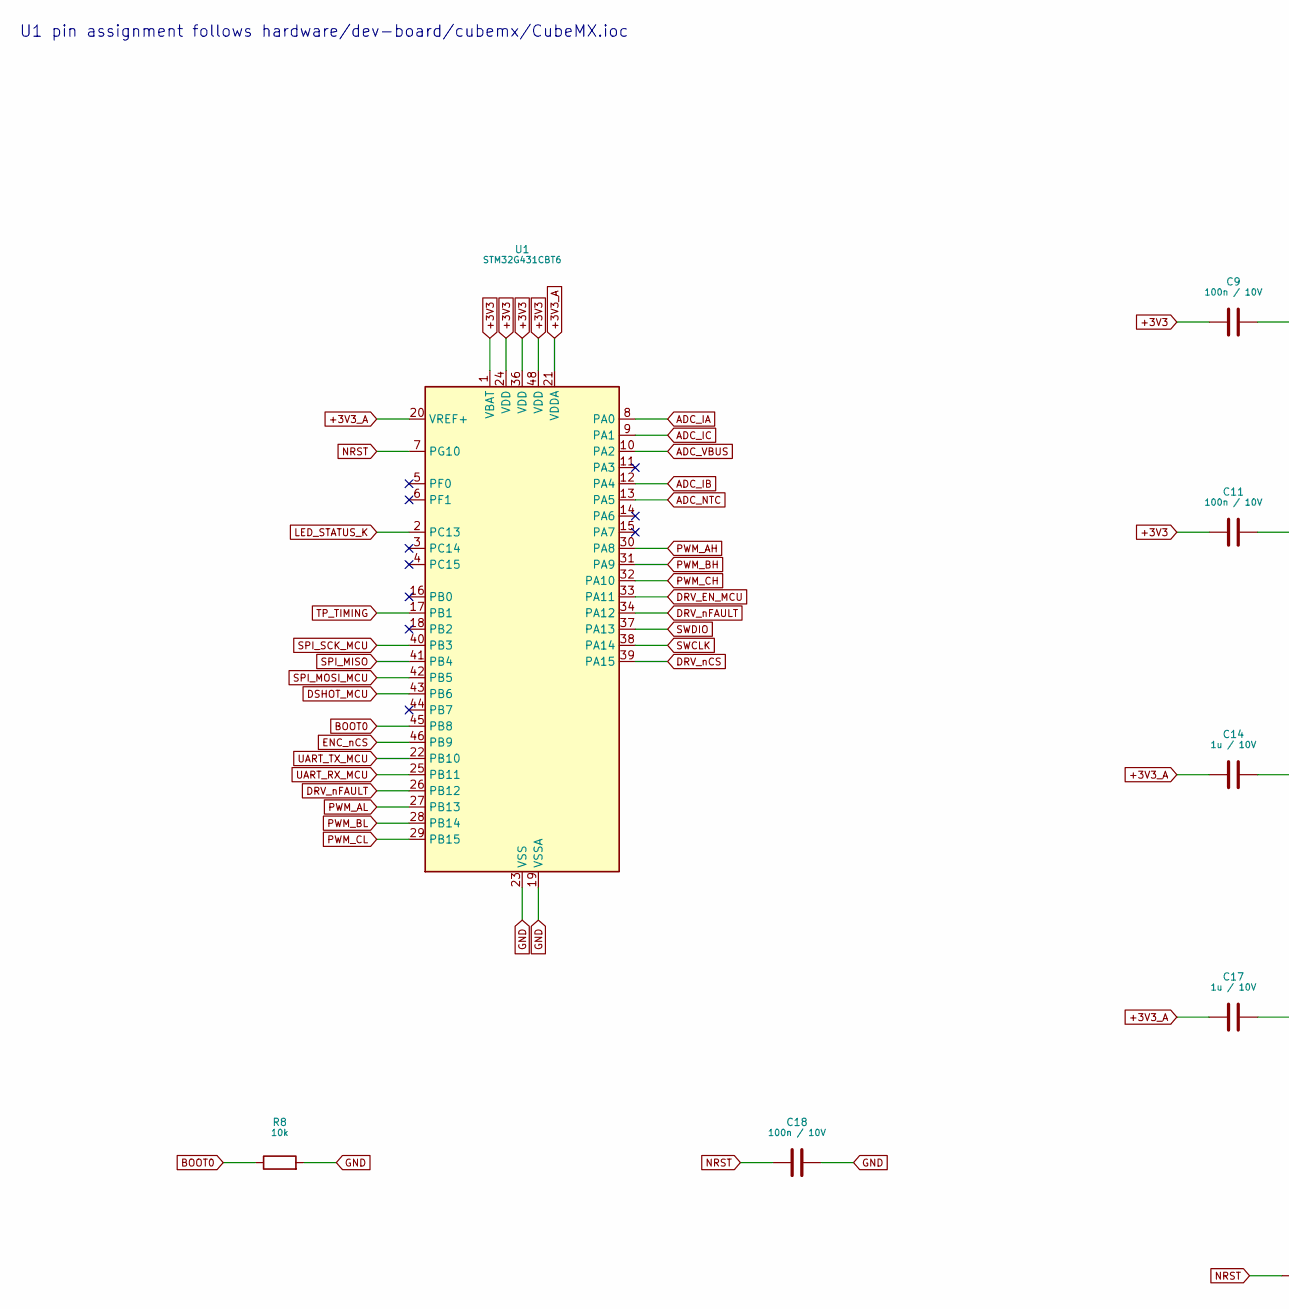
[picture p61: schematic 02-mcu.kicad_sch, part in row 1, column 1]

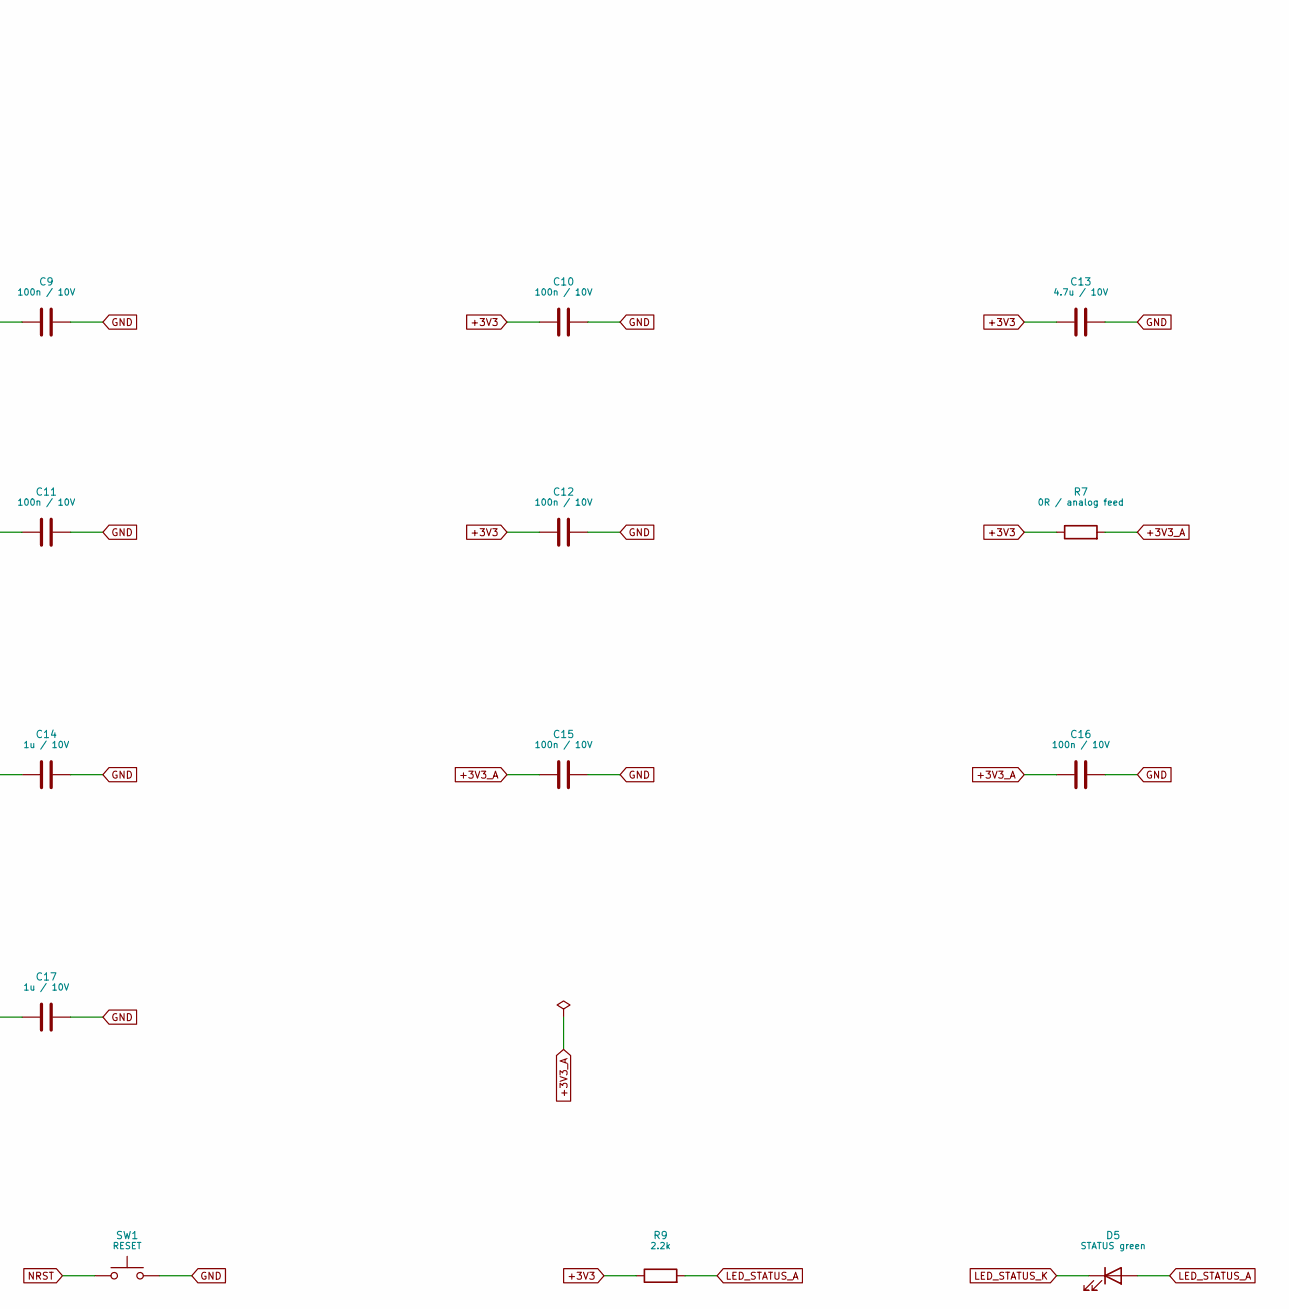
[picture p62: schematic 02-mcu.kicad_sch, part in row 1, column 2]

Parts:
C9, C10, C11, C12, C15, C16, C18: 100n / 10V; C_0603_1608Metric
C13: 4.7u / 10V; C_0805_2012Metric
C14, C17: 1u / 10V; C_0603_1608Metric
D5: STATUS green; LED_0603_1608Metric
R7: 0R / analog feed; R_0603_1608Metric
R8: 10k; R_0603_1608Metric
R9: 2.2k; R_0603_1608Metric
SW1: RESET; SW_SPST_TL3342; MPN TL3342F160QG
U1: STM32G431CBT6; LQFP-48_7x7mm_P0.5mm; MPN STM32G431CBT6

Connections:
+3V3: C9.1, C10.1, C11.1, C12.1, C13.1, R7.1, R9.1, U1.1 (VBAT), U1.24 (VDD), U1.36 (VDD), U1.48 (VDD); also elsewhere on the board
+3V3_A: C14.1, C15.1, C16.1, C17.1, R7.2, U1.20 (VREF+), U1.21 (VDDA); also elsewhere on the board
ADC_IA: U1.8 (PA0); also elsewhere on the board
ADC_IB: U1.12 (PA4); also elsewhere on the board
ADC_IC: U1.9 (PA1); also elsewhere on the board
ADC_NTC: U1.13 (PA5); also elsewhere on the board
ADC_VBUS: U1.10 (PA2); also elsewhere on the board
BOOT0: R8.1, U1.45 (PB8)
DRV_EN_MCU: U1.33 (PA11); also elsewhere on the board
DRV_nCS: U1.39 (PA15); also elsewhere on the board
DRV_nFAULT: U1.26 (PB12), U1.34 (PA12); also elsewhere on the board
DSHOT_MCU: U1.43 (PB6); also elsewhere on the board
ENC_nCS: U1.46 (PB9); also elsewhere on the board
GND: C9.2, C10.2, C11.2, C12.2, C13.2, C14.2, C15.2, C16.2, C17.2, C18.2, R8.2, SW1.2, U1.19 (VSSA), U1.23 (VSS), U1.35 (VSS), U1.47 (VSS); also elsewhere on the board
LED_STATUS_A: D5.2 (A), R9.2
LED_STATUS_K: D5.1 (K), U1.2 (PC13)
NRST: C18.1, SW1.1, U1.7 (PG10); also elsewhere on the board
PWM_AH: U1.30 (PA8); also elsewhere on the board
PWM_AL: U1.27 (PB13); also elsewhere on the board
PWM_BH: U1.31 (PA9); also elsewhere on the board
PWM_BL: U1.28 (PB14); also elsewhere on the board
PWM_CH: U1.32 (PA10); also elsewhere on the board
PWM_CL: U1.29 (PB15); also elsewhere on the board
SPI_MISO: U1.41 (PB4); also elsewhere on the board
SPI_MOSI_MCU: U1.42 (PB5); also elsewhere on the board
SPI_SCK_MCU: U1.40 (PB3); also elsewhere on the board
SWCLK: U1.38 (PA14); also elsewhere on the board
SWDIO: U1.37 (PA13); also elsewhere on the board
TP_TIMING: U1.17 (PB1); also elsewhere on the board
UART_RX_MCU: U1.25 (PB11); also elsewhere on the board
UART_TX_MCU: U1.22 (PB10); also elsewhere on the board

Notes on the sheet:
U1 pin assignment follows hardware/dev-board/cubemx/CubeMX.ioc

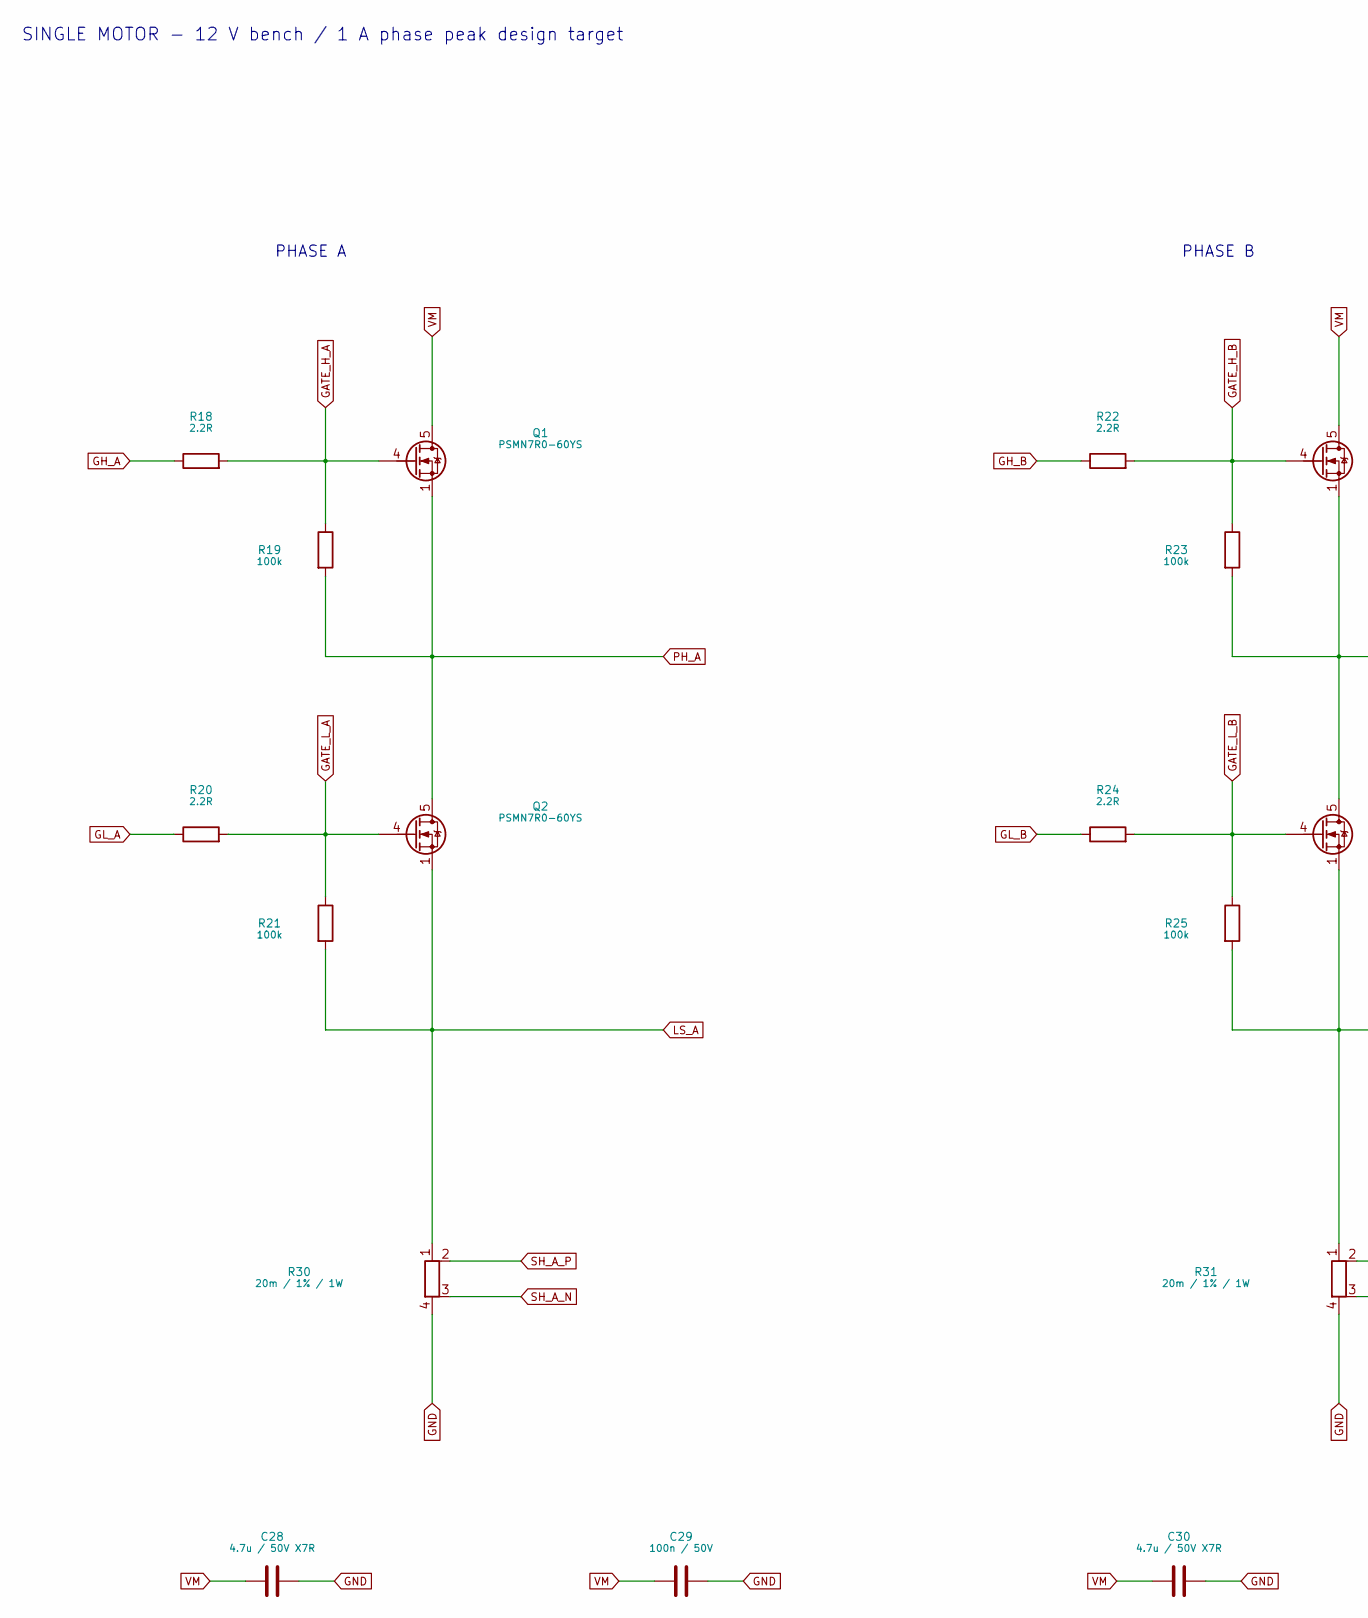
[picture p63: schematic 04-inverter.kicad_sch, part in row 1, column 1]

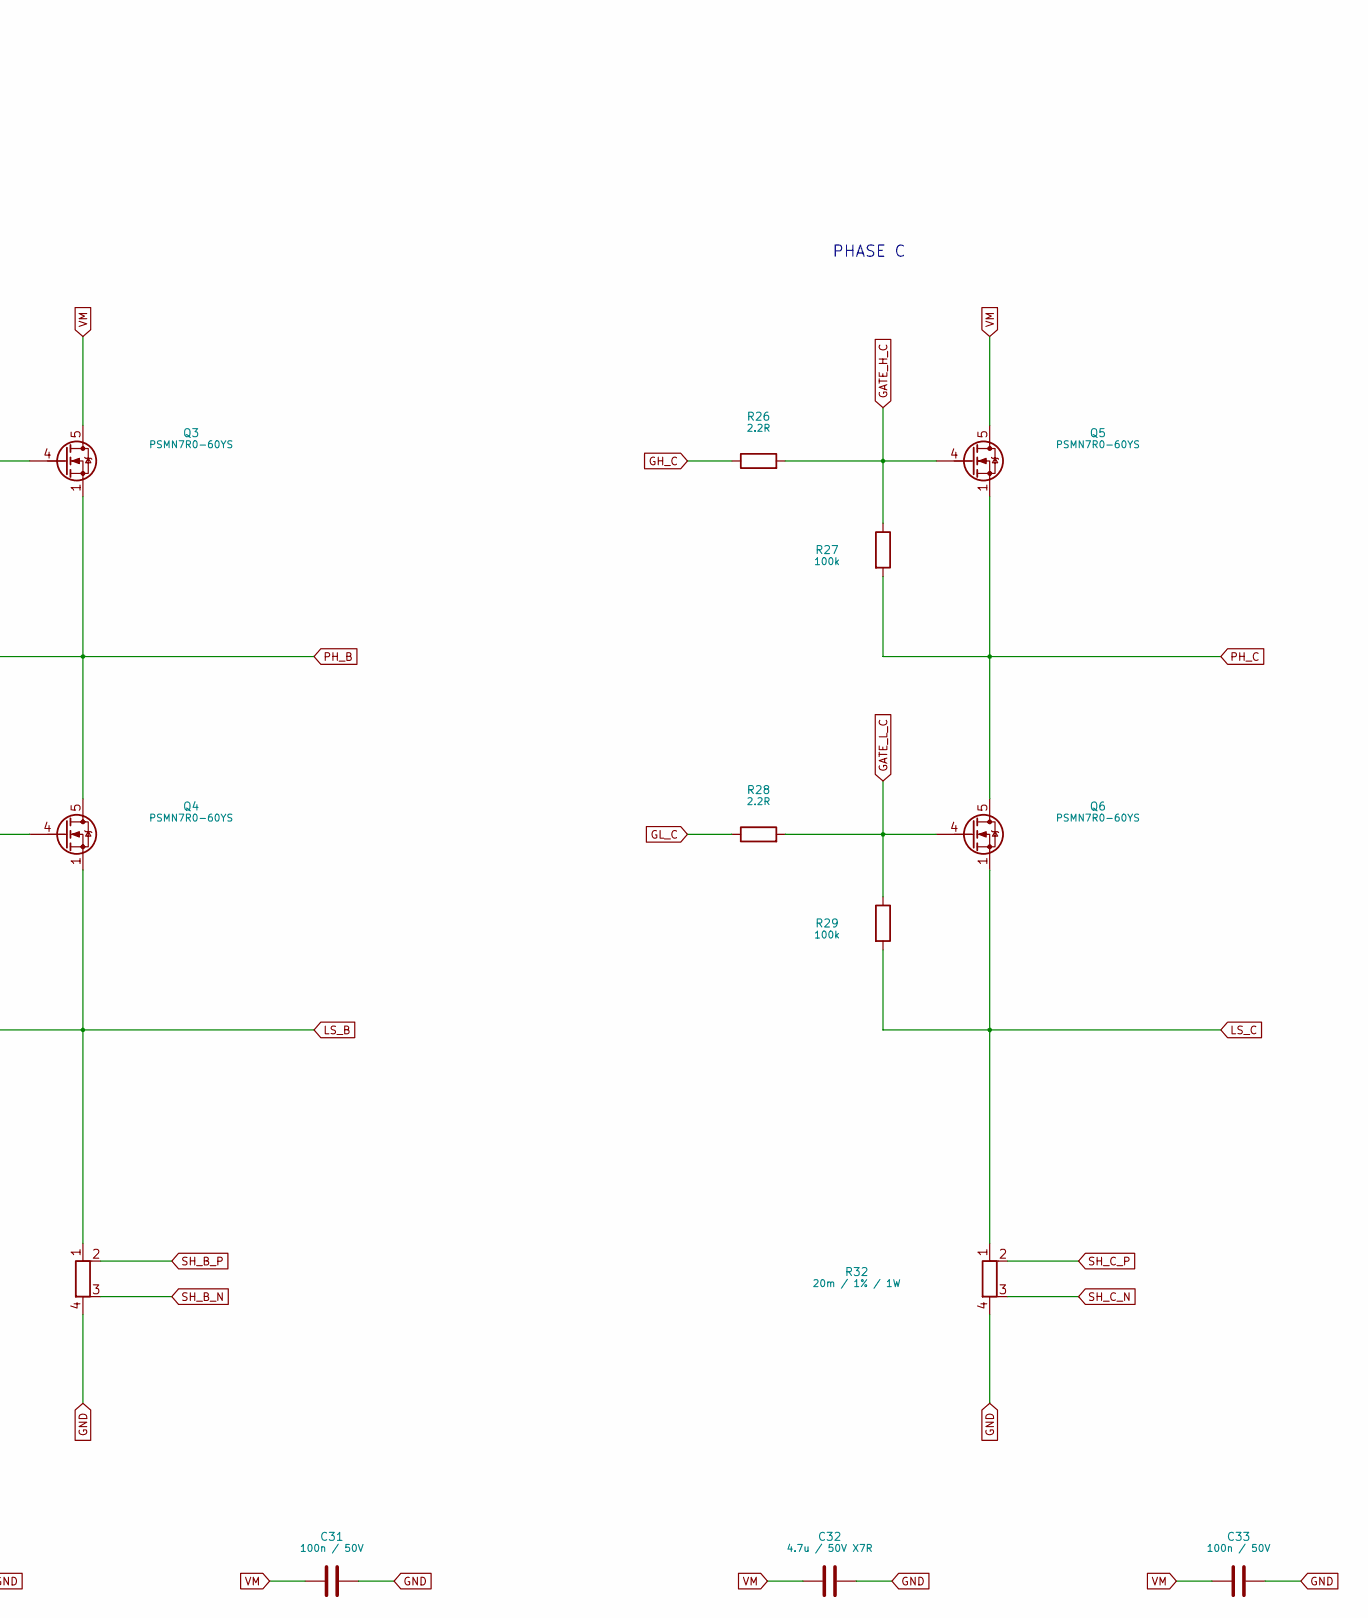
[picture p64: schematic 04-inverter.kicad_sch, part in row 1, column 2]

Parts:
C28, C30, C32: 4.7u / 50V X7R; C_1210_3225Metric
C29, C31, C33: 100n / 50V; C_0603_1608Metric
Q1, Q2, Q3, Q4, Q5, Q6: PSMN7R0-60YS; LFPAK56; MPN PSMN7R0-60YS,115
R18, R20, R22, R24, R26, R28: 2.2R; R_0603_1608Metric
R19, R21, R23, R25, R27, R29: 100k; R_0603_1608Metric
R30, R31, R32: 20m / 1% / 1W; R_Shunt_Vishay_WSK2512_6332Metric_T1.19mm; MPN WSK2512R0200FEA

Connections:
GATE_H_A: Q1.4 (G), R18.2, R19.1; also elsewhere on the board
GATE_H_B: Q3.4 (G), R22.2, R23.1; also elsewhere on the board
GATE_H_C: Q5.4 (G), R26.2, R27.1; also elsewhere on the board
GATE_L_A: Q2.4 (G), R20.2, R21.1; also elsewhere on the board
GATE_L_B: Q4.4 (G), R24.2, R25.1; also elsewhere on the board
GATE_L_C: Q6.4 (G), R28.2, R29.1; also elsewhere on the board
GH_A: R18.1; also elsewhere on the board
GH_B: R22.1; also elsewhere on the board
GH_C: R26.1; also elsewhere on the board
GL_A: R20.1; also elsewhere on the board
GL_B: R24.1; also elsewhere on the board
GL_C: R28.1; also elsewhere on the board
GND: C28.2, C29.2, C30.2, C31.2, C32.2, C33.2, R30.4, R31.4, R32.4; also elsewhere on the board
LS_A: Q2.1 (S), Q2.2 (S), Q2.3 (S), R21.2, R30.1; also elsewhere on the board
LS_B: Q4.1 (S), Q4.2 (S), Q4.3 (S), R25.2, R31.1; also elsewhere on the board
LS_C: Q6.1 (S), Q6.2 (S), Q6.3 (S), R29.2, R32.1; also elsewhere on the board
PH_A: Q1.1 (S), Q1.2 (S), Q1.3 (S), Q2.5 (D), R19.2; also elsewhere on the board
PH_B: Q3.1 (S), Q3.2 (S), Q3.3 (S), Q4.5 (D), R23.2; also elsewhere on the board
PH_C: Q5.1 (S), Q5.2 (S), Q5.3 (S), Q6.5 (D), R27.2; also elsewhere on the board
SH_A_N: R30.3; also elsewhere on the board
SH_A_P: R30.2; also elsewhere on the board
SH_B_N: R31.3; also elsewhere on the board
SH_B_P: R31.2; also elsewhere on the board
SH_C_N: R32.3; also elsewhere on the board
SH_C_P: R32.2; also elsewhere on the board
VM: C28.1, C29.1, C30.1, C31.1, C32.1, C33.1, Q1.5 (D), Q3.5 (D), Q5.5 (D); also elsewhere on the board

Notes on the sheet:
PHASE B
PHASE A
SINGLE MOTOR - 12 V bench / 1 A phase peak design target
PHASE C
