dganin-hw/bldc-foc/hardware/dev-board/kicad/foc-dev-board.kicad_pcb

## KiCad design hardware/dev-board/kicad/foc-dev-board.kicad_pcb (continued)

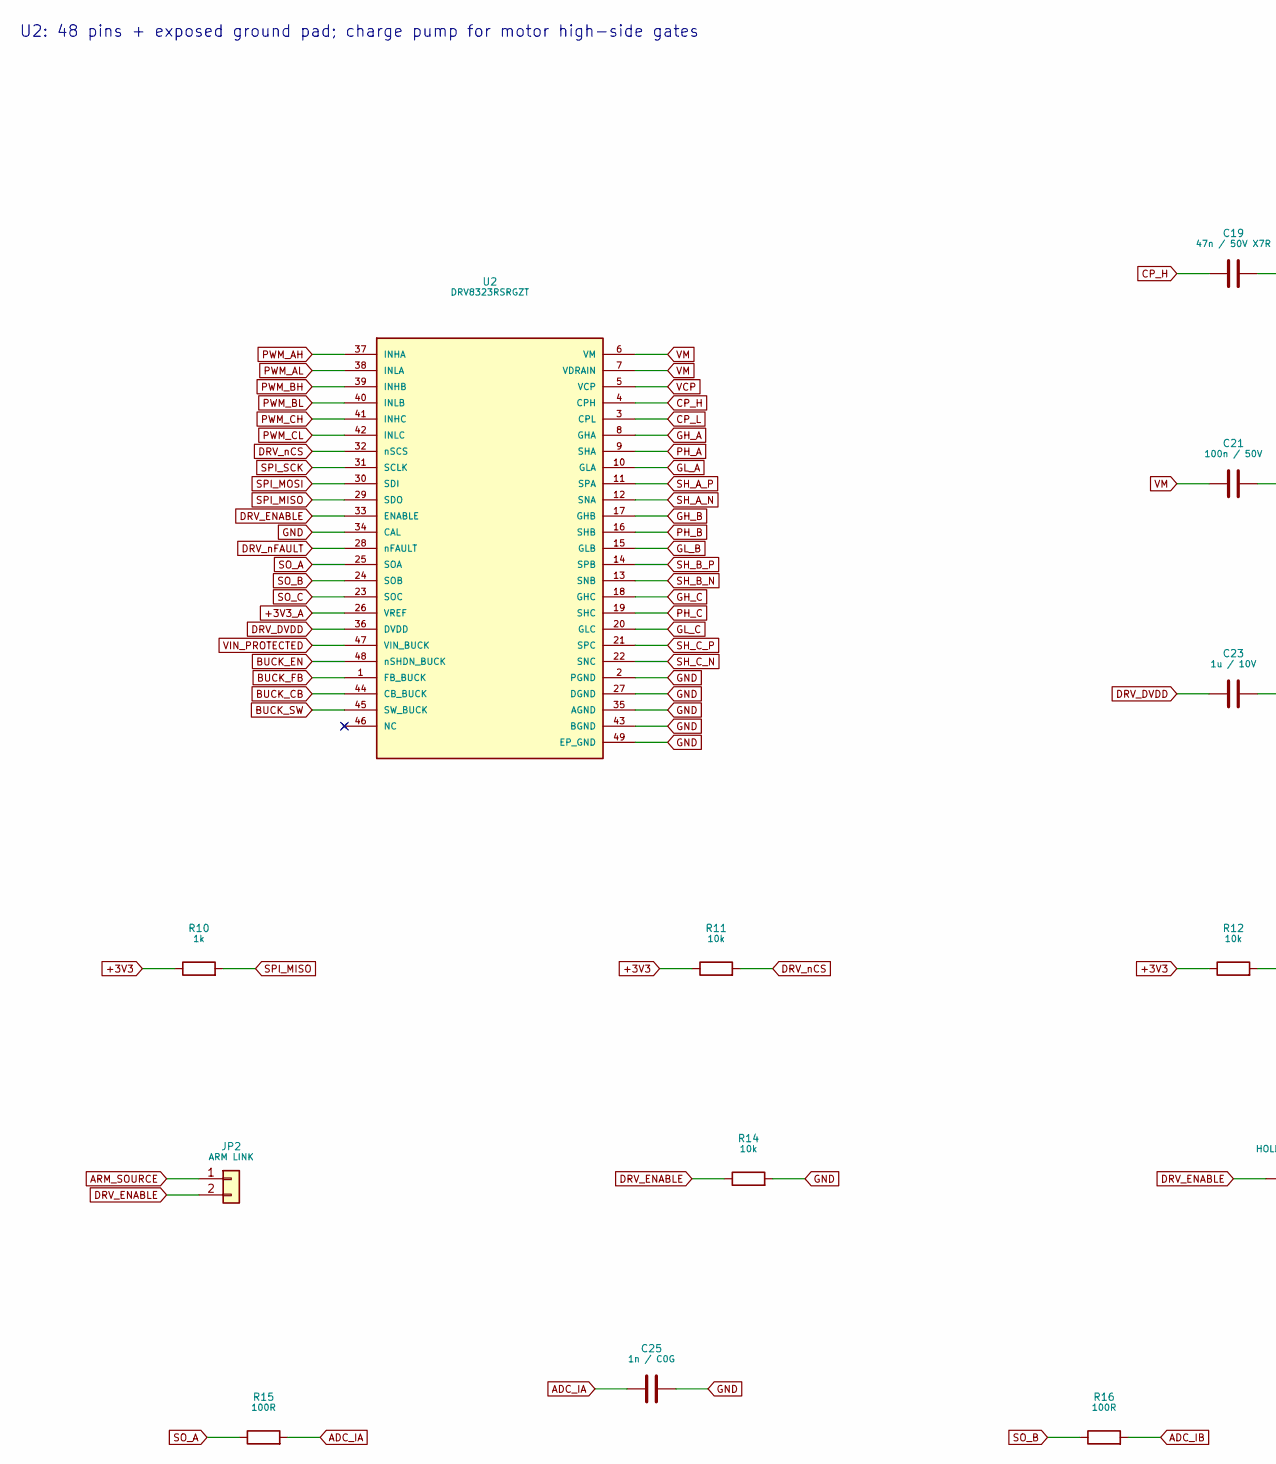
[picture p65: schematic 03-driver.kicad_sch, part in row 1, column 1]

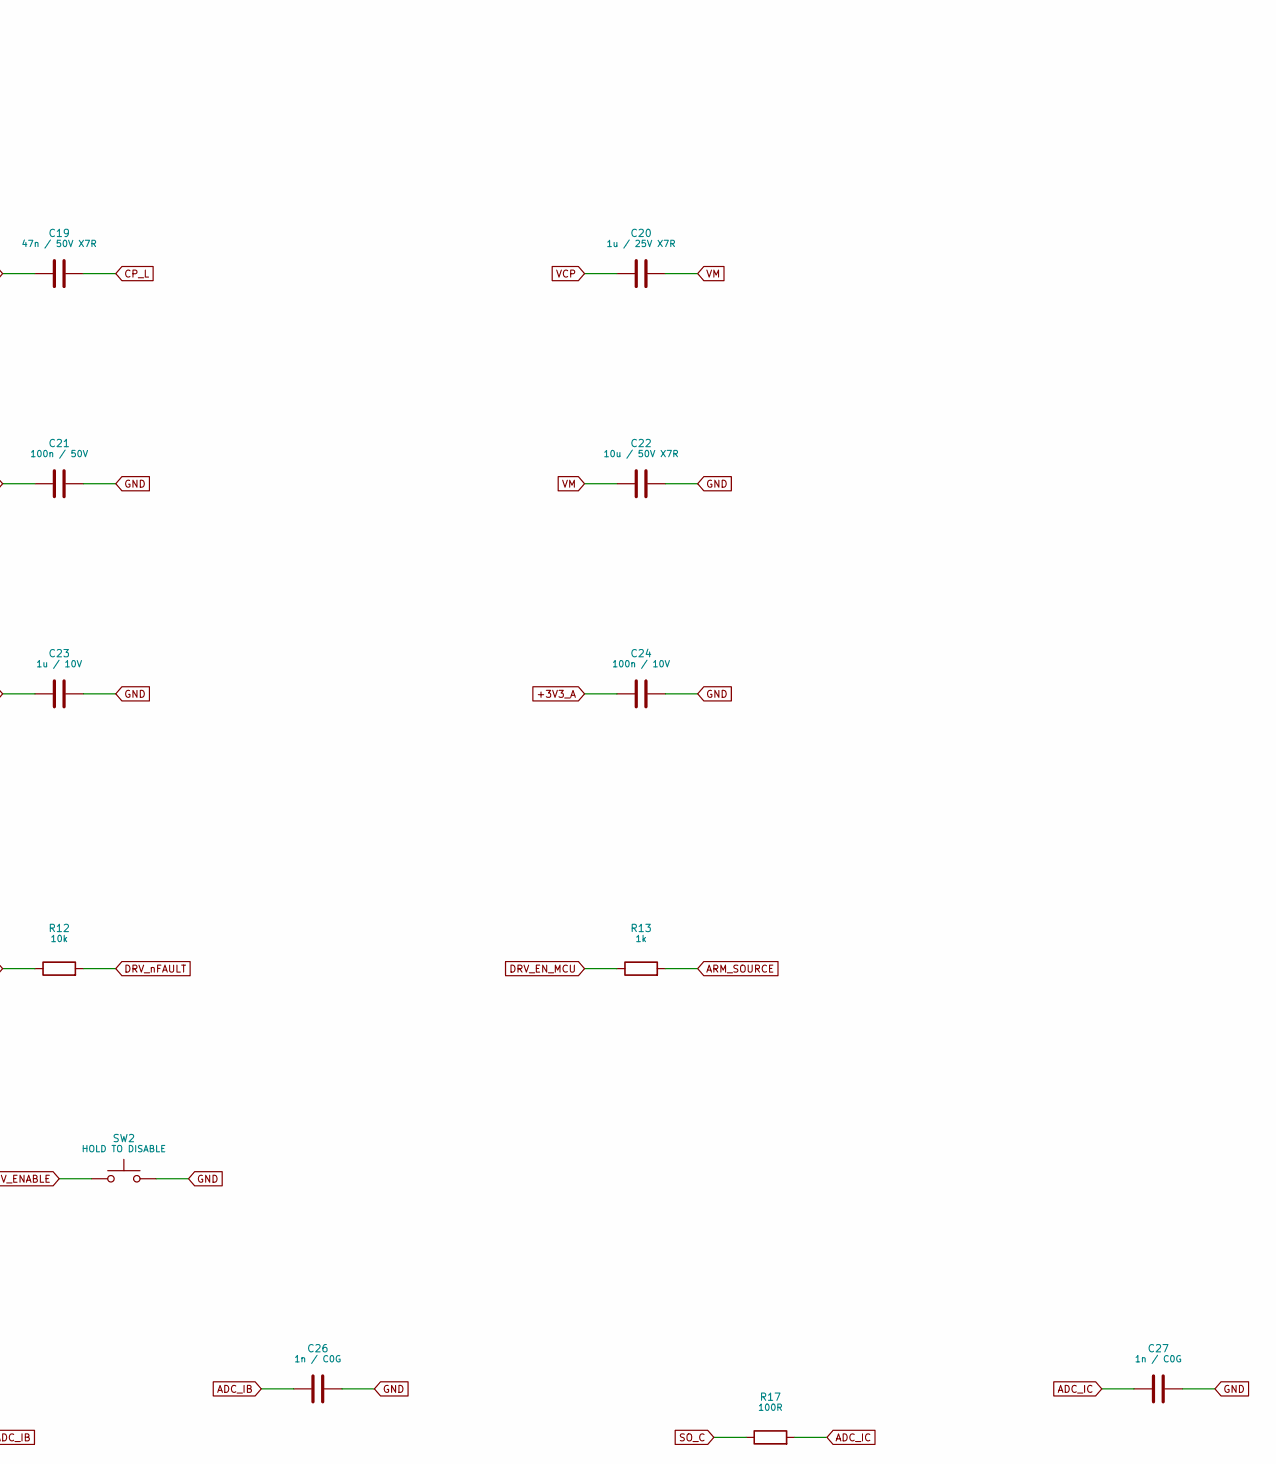
[picture p66: schematic 03-driver.kicad_sch, part in row 1, column 2]

Parts:
C19: 47n / 50V X7R; C_0603_1608Metric
C20: 1u / 25V X7R; C_0805_2012Metric
C21: 100n / 50V; C_0603_1608Metric
C22: 10u / 50V X7R; C_1210_3225Metric
C23: 1u / 10V; C_0603_1608Metric
C24: 100n / 10V; C_0603_1608Metric
C25, C26, C27: 1n / C0G; C_0603_1608Metric
JP2: ARM LINK; PinHeader_1x02_P2.54mm_Vertical
R10, R13: 1k; R_0603_1608Metric
R11, R12, R14: 10k; R_0603_1608Metric
R15, R16, R17: 100R; R_0603_1608Metric
SW2: HOLD TO DISABLE; SW_SPST_TL3342; MPN TL3342F160QG
U2: DRV8323RSRGZT; Texas_RGZ0048A_VQFN-48-1EP_7x7mm_P0.5mm_EP5.15x5.15mm_Therm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; MPN DRV8323RSRGZT

Connections:
+3V3: R10.1, R11.1, R12.1; also elsewhere on the board
+3V3_A: C24.1, U2.26 (VREF); also elsewhere on the board
ADC_IA: C25.1, R15.2; also elsewhere on the board
ADC_IB: C26.1, R16.2; also elsewhere on the board
ADC_IC: C27.1, R17.2; also elsewhere on the board
ARM_SOURCE: JP2.1, R13.2
BUCK_CB: U2.44 (CB_BUCK); also elsewhere on the board
BUCK_EN: U2.48 (nSHDN_BUCK); also elsewhere on the board
BUCK_FB: U2.1 (FB_BUCK); also elsewhere on the board
BUCK_SW: U2.45 (SW_BUCK); also elsewhere on the board
CP_H: C19.1, U2.4 (CPH)
CP_L: C19.2, U2.3 (CPL)
DRV_DVDD: C23.1, U2.36 (DVDD); also elsewhere on the board
DRV_ENABLE: JP2.2, R14.1, SW2.1, U2.33 (ENABLE); also elsewhere on the board
DRV_EN_MCU: R13.1; also elsewhere on the board
DRV_nCS: R11.2, U2.32 (nSCS); also elsewhere on the board
DRV_nFAULT: R12.2, U2.28 (nFAULT); also elsewhere on the board
GH_A: U2.8 (GHA); also elsewhere on the board
GH_B: U2.17 (GHB); also elsewhere on the board
GH_C: U2.18 (GHC); also elsewhere on the board
GL_A: U2.10 (GLA); also elsewhere on the board
GL_B: U2.15 (GLB); also elsewhere on the board
GL_C: U2.20 (GLC); also elsewhere on the board
GND: C21.2, C22.2, C23.2, C24.2, C25.2, C26.2, C27.2, R14.2, SW2.2, U2.2 (PGND), U2.27 (DGND), U2.34 (CAL), U2.35 (AGND), U2.43 (BGND), U2.49 (EP_GND); also elsewhere on the board
PH_A: U2.9 (SHA); also elsewhere on the board
PH_B: U2.16 (SHB); also elsewhere on the board
PH_C: U2.19 (SHC); also elsewhere on the board
PWM_AH: U2.37 (INHA); also elsewhere on the board
PWM_AL: U2.38 (INLA); also elsewhere on the board
PWM_BH: U2.39 (INHB); also elsewhere on the board
PWM_BL: U2.40 (INLB); also elsewhere on the board
PWM_CH: U2.41 (INHC); also elsewhere on the board
PWM_CL: U2.42 (INLC); also elsewhere on the board
SH_A_N: U2.12 (SNA); also elsewhere on the board
SH_A_P: U2.11 (SPA); also elsewhere on the board
SH_B_N: U2.13 (SNB); also elsewhere on the board
SH_B_P: U2.14 (SPB); also elsewhere on the board
SH_C_N: U2.22 (SNC); also elsewhere on the board
SH_C_P: U2.21 (SPC); also elsewhere on the board
SO_A: R15.1, U2.25 (SOA)
SO_B: R16.1, U2.24 (SOB)
SO_C: R17.1, U2.23 (SOC)
SPI_MISO: R10.2, U2.29 (SDO); also elsewhere on the board
SPI_MOSI: U2.30 (SDI); also elsewhere on the board
SPI_SCK: U2.31 (SCLK); also elsewhere on the board
VCP: C20.1, U2.5 (VCP)
VIN_PROTECTED: U2.47 (VIN_BUCK); also elsewhere on the board
VM: C20.2, C21.1, C22.1, U2.6 (VM), U2.7 (VDRAIN); also elsewhere on the board

Notes on the sheet:
U2: 48 pins + exposed ground pad; charge pump for motor high-side gates

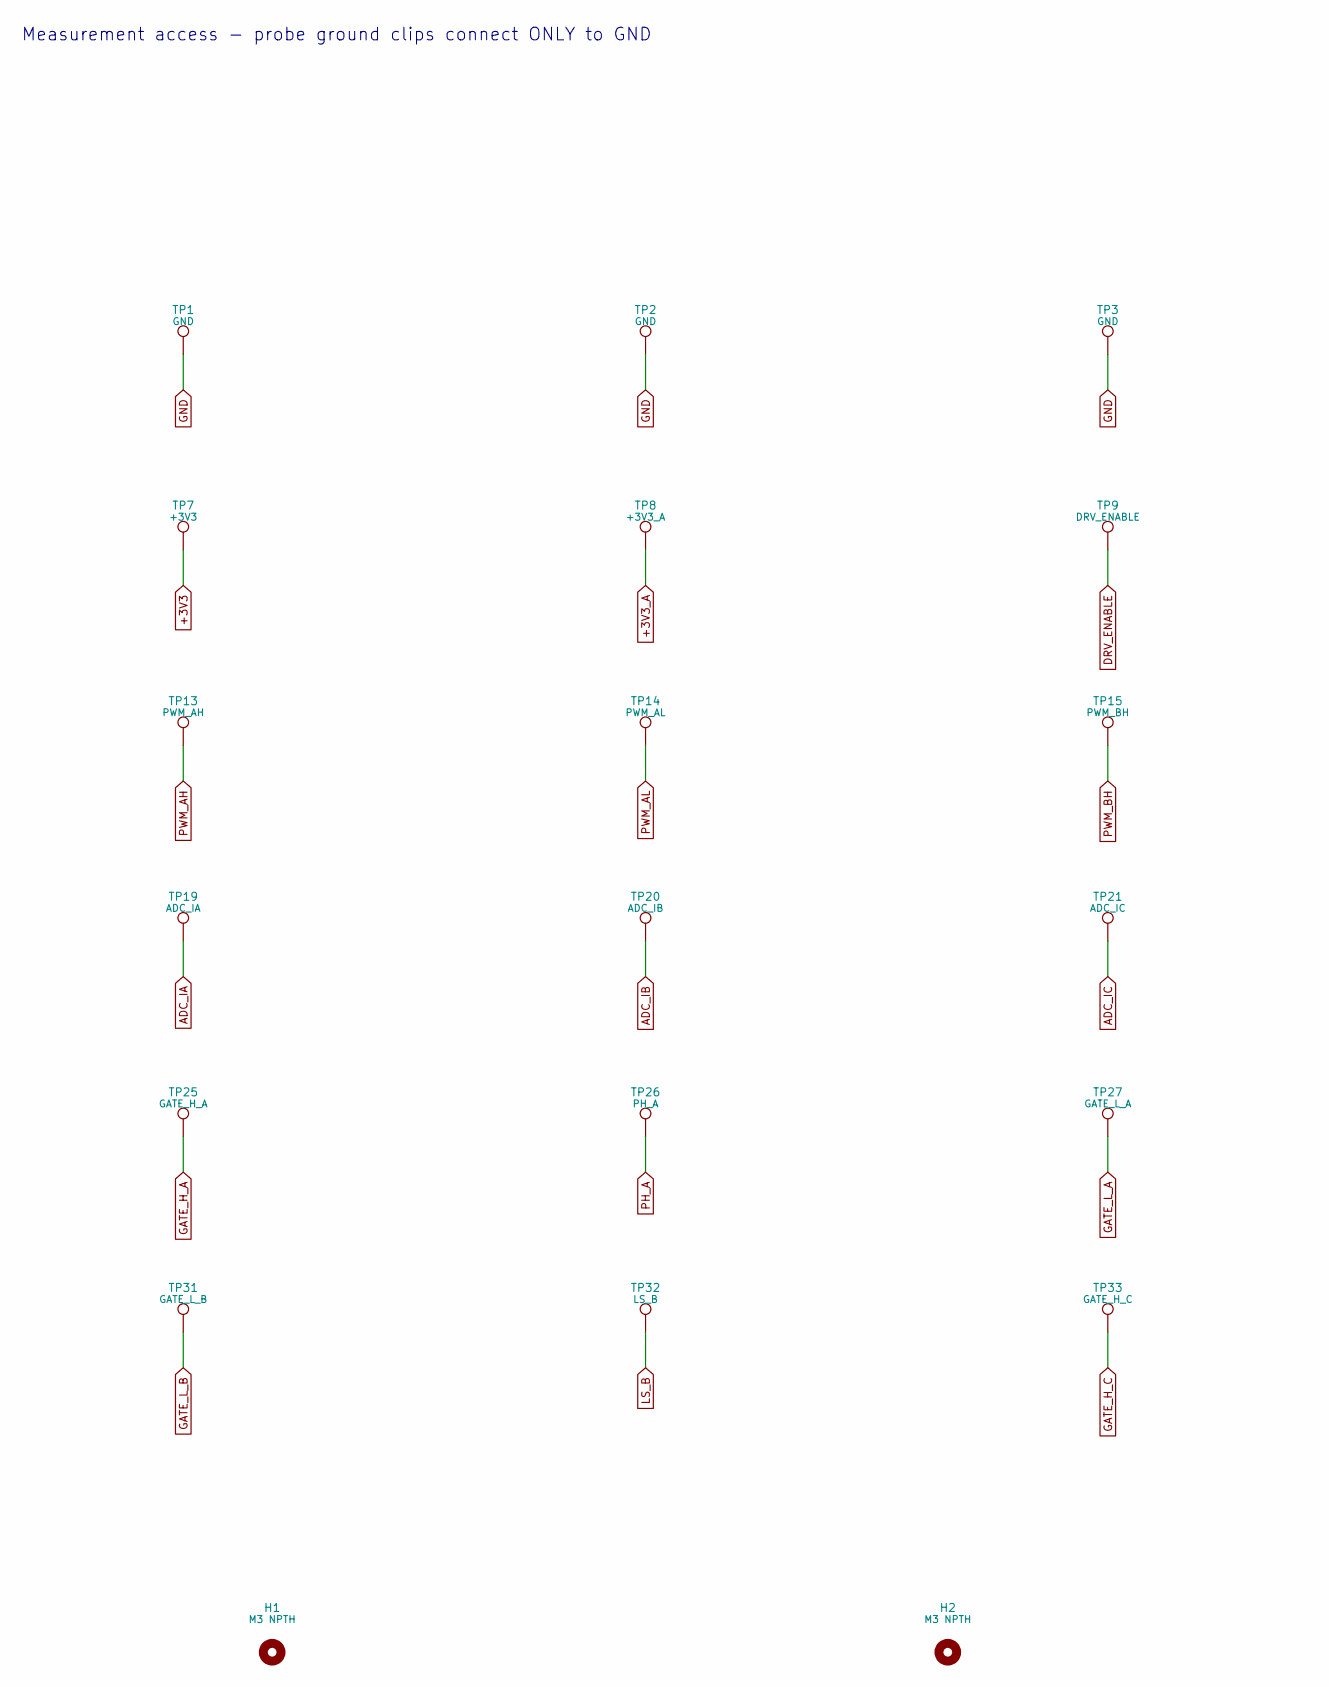
[picture p67: schematic 06-testpoints.kicad_sch, part in row 1, column 1]

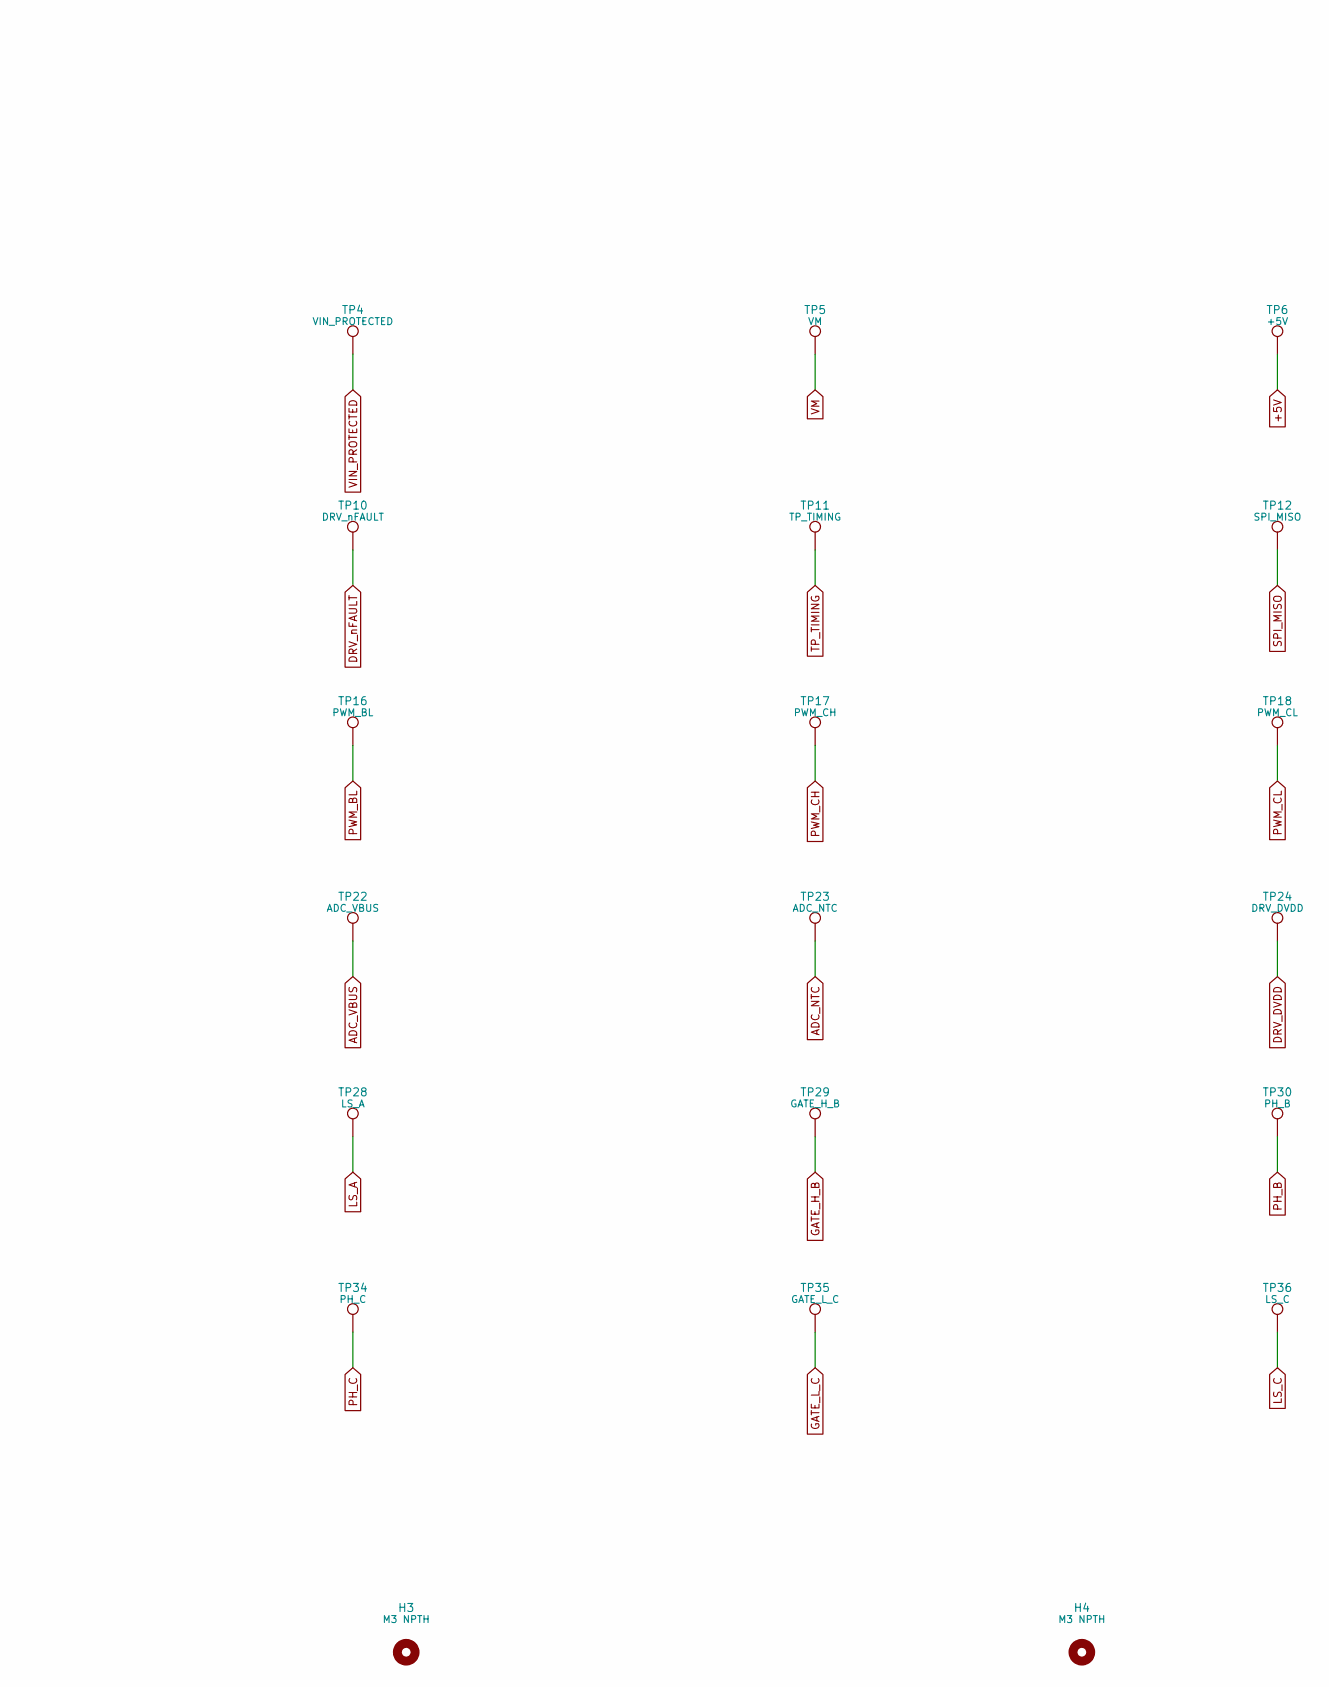
[picture p68: schematic 06-testpoints.kicad_sch, part in row 1, column 2]

Parts:
H1, H2, H3, H4: M3 NPTH; MountingHole_3.2mm_M3
TP1, TP2, TP3: GND; TestPoint_Pad_D1.0mm
TP4: VIN_PROTECTED; TestPoint_Pad_D1.0mm
TP5: VM; TestPoint_Pad_D1.0mm
TP6: +5V; TestPoint_Pad_D1.0mm
TP7: +3V3; TestPoint_Pad_D1.0mm
TP8: +3V3_A; TestPoint_Pad_D1.0mm
TP9: DRV_ENABLE; TestPoint_Pad_D1.0mm
TP10: DRV_nFAULT; TestPoint_Pad_D1.0mm
TP11: TP_TIMING; TestPoint_Pad_D1.0mm
TP12: SPI_MISO; TestPoint_Pad_D1.0mm
TP13: PWM_AH; TestPoint_Pad_D1.0mm
TP14: PWM_AL; TestPoint_Pad_D1.0mm
TP15: PWM_BH; TestPoint_Pad_D1.0mm
TP16: PWM_BL; TestPoint_Pad_D1.0mm
TP17: PWM_CH; TestPoint_Pad_D1.0mm
TP18: PWM_CL; TestPoint_Pad_D1.0mm
TP19: ADC_IA; TestPoint_Pad_D1.0mm
TP20: ADC_IB; TestPoint_Pad_D1.0mm
TP21: ADC_IC; TestPoint_Pad_D1.0mm
TP22: ADC_VBUS; TestPoint_Pad_D1.0mm
TP23: ADC_NTC; TestPoint_Pad_D1.0mm
TP24: DRV_DVDD; TestPoint_Pad_D1.0mm
TP25: GATE_H_A; TestPoint_Pad_D1.0mm
TP26: PH_A; TestPoint_Pad_D1.0mm
TP27: GATE_L_A; TestPoint_Pad_D1.0mm
TP28: LS_A; TestPoint_Pad_D1.0mm
TP29: GATE_H_B; TestPoint_Pad_D1.0mm
TP30: PH_B; TestPoint_Pad_D1.0mm
TP31: GATE_L_B; TestPoint_Pad_D1.0mm
TP32: LS_B; TestPoint_Pad_D1.0mm
TP33: GATE_H_C; TestPoint_Pad_D1.0mm
TP34: PH_C; TestPoint_Pad_D1.0mm
TP35: GATE_L_C; TestPoint_Pad_D1.0mm
TP36: LS_C; TestPoint_Pad_D1.0mm

Connections:
+3V3: TP7.1; also elsewhere on the board
+3V3_A: TP8.1; also elsewhere on the board
+5V: TP6.1; also elsewhere on the board
ADC_IA: TP19.1; also elsewhere on the board
ADC_IB: TP20.1; also elsewhere on the board
ADC_IC: TP21.1; also elsewhere on the board
ADC_NTC: TP23.1; also elsewhere on the board
ADC_VBUS: TP22.1; also elsewhere on the board
DRV_DVDD: TP24.1; also elsewhere on the board
DRV_ENABLE: TP9.1; also elsewhere on the board
DRV_nFAULT: TP10.1; also elsewhere on the board
GATE_H_A: TP25.1; also elsewhere on the board
GATE_H_B: TP29.1; also elsewhere on the board
GATE_H_C: TP33.1; also elsewhere on the board
GATE_L_A: TP27.1; also elsewhere on the board
GATE_L_B: TP31.1; also elsewhere on the board
GATE_L_C: TP35.1; also elsewhere on the board
GND: TP1.1, TP2.1, TP3.1; also elsewhere on the board
LS_A: TP28.1; also elsewhere on the board
LS_B: TP32.1; also elsewhere on the board
LS_C: TP36.1; also elsewhere on the board
PH_A: TP26.1; also elsewhere on the board
PH_B: TP30.1; also elsewhere on the board
PH_C: TP34.1; also elsewhere on the board
PWM_AH: TP13.1; also elsewhere on the board
PWM_AL: TP14.1; also elsewhere on the board
PWM_BH: TP15.1; also elsewhere on the board
PWM_BL: TP16.1; also elsewhere on the board
PWM_CH: TP17.1; also elsewhere on the board
PWM_CL: TP18.1; also elsewhere on the board
SPI_MISO: TP12.1; also elsewhere on the board
TP_TIMING: TP11.1; also elsewhere on the board
VIN_PROTECTED: TP4.1; also elsewhere on the board
VM: TP5.1; also elsewhere on the board

Notes on the sheet:
Measurement access - probe ground clips connect ONLY to GND

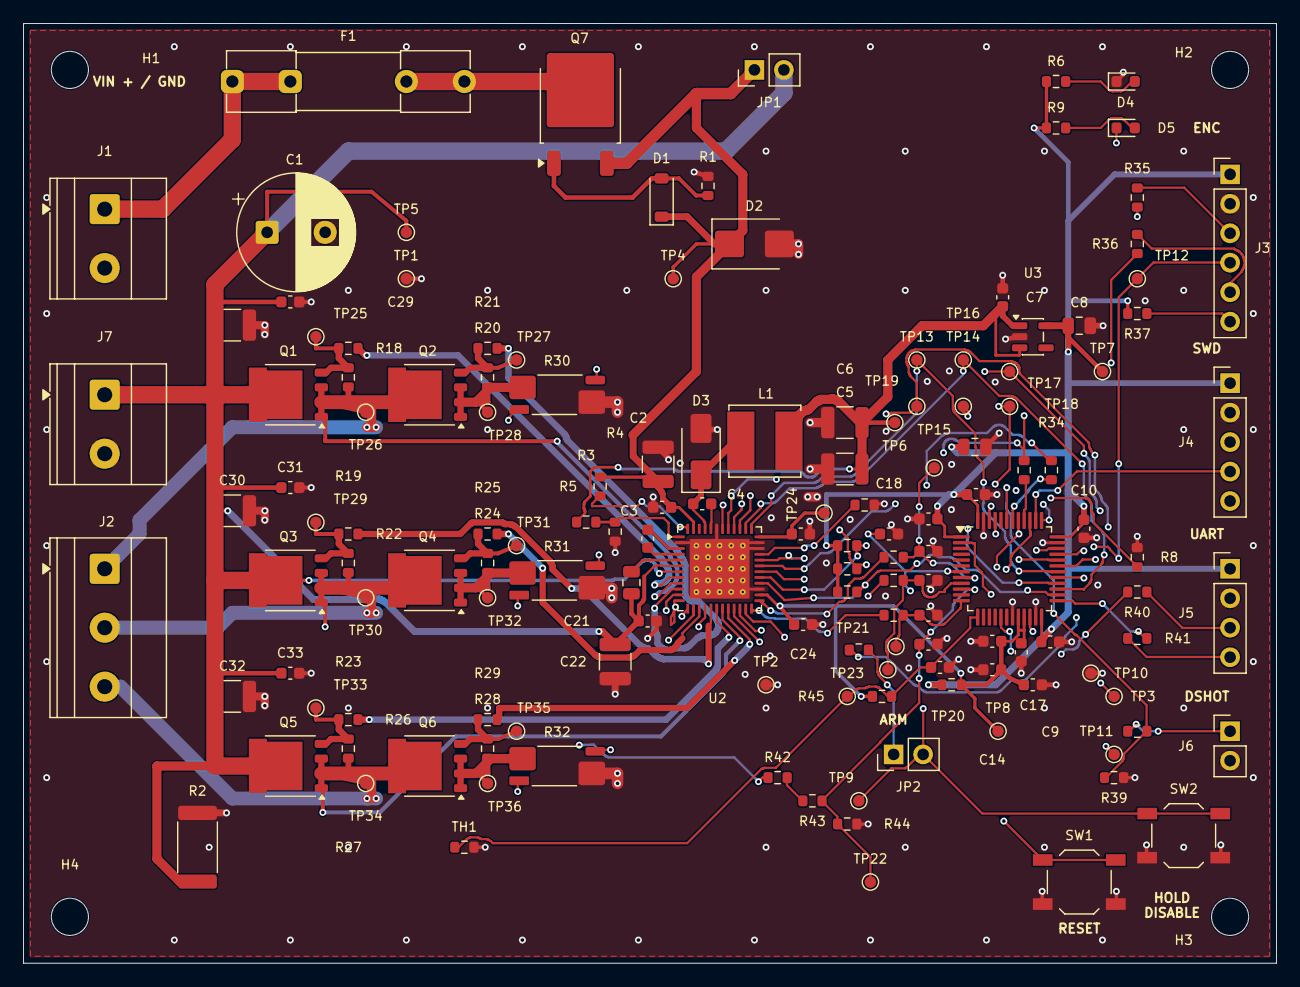
[picture p69: board foc-dev-board.kicad_pcb from above]

Board: 4 copper layers, 108.0 x 81.0 mm, 149 parts (0 on the bottom side), 83 nets.
