dganin-hw/bldc-foc/hardware/encoder-board/kicad/foc-encoder.kicad_pcb

## KiCad design hardware/encoder-board/kicad/foc-encoder.kicad_pcb (2026-10-20)

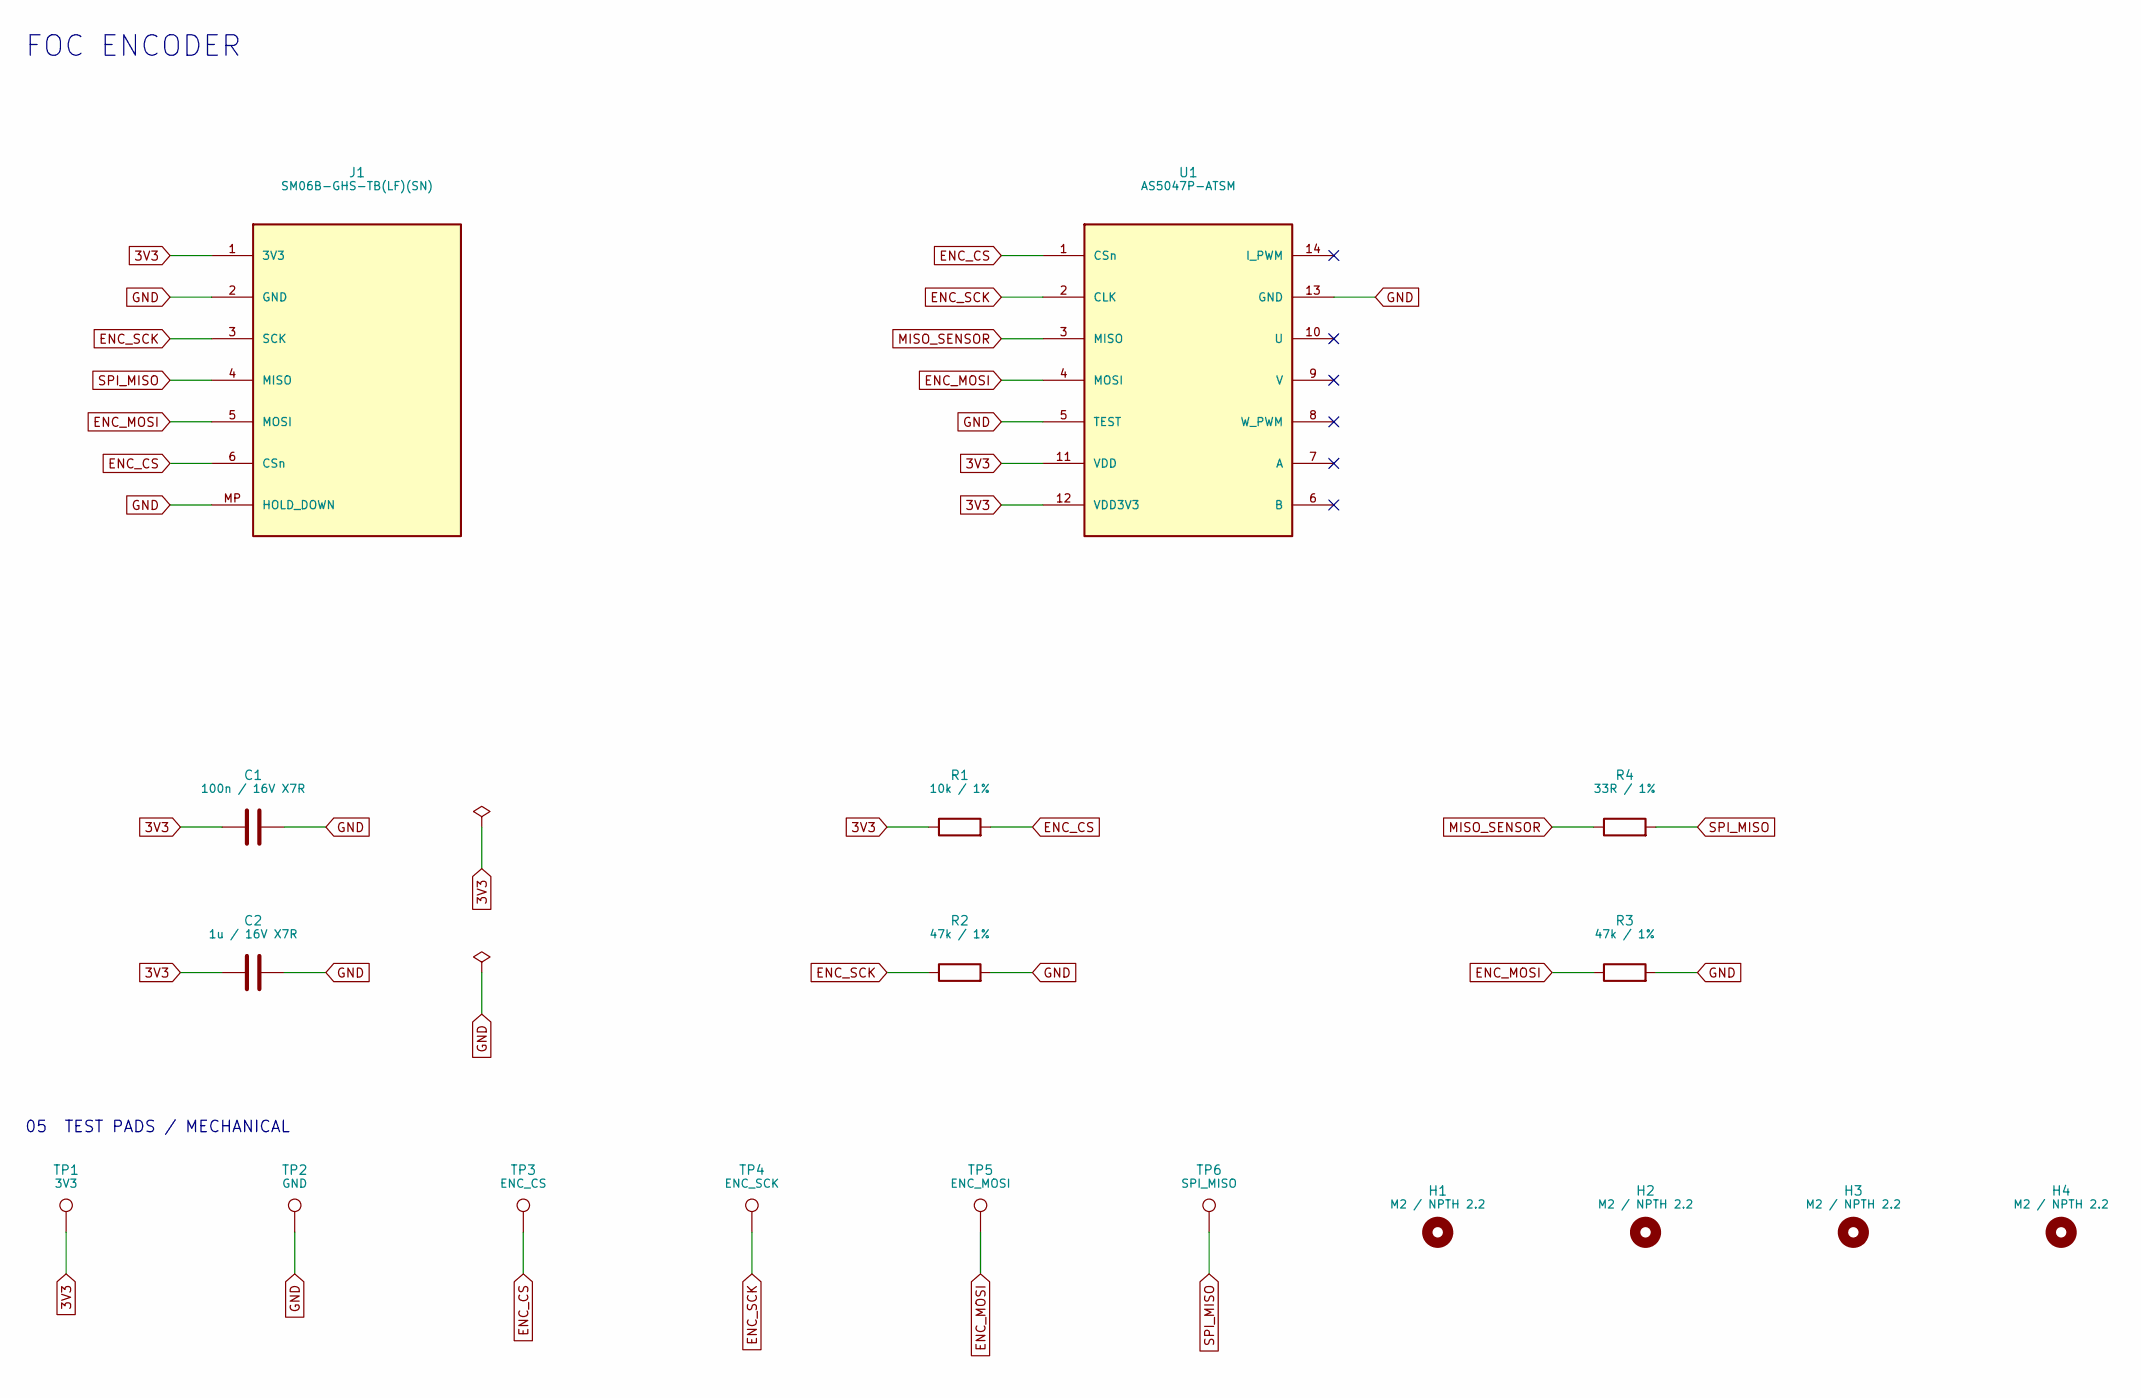
[picture p70: schematic foc-encoder.kicad_sch]

Parts:
C1: 100n / 16V X7R; C_0603_1608Metric; MPN CL10B104KB8NNNC
C2: 1u / 16V X7R; C_0603_1608Metric; MPN CL10B105KO8NNNC
H1, H2, H3, H4: M2 / NPTH 2.2; MountingHole_2.2mm_M2
J1: SM06B-GHS-TB(LF)(SN); JST_GH_SM06B-GHS-TB_1x06-1MP_P1.25mm_Horizontal; MPN SM06B-GHS-TB(LF)(SN)
R1: 10k / 1%; R_0603_1608Metric; MPN RC0603FR-0710KL
R2, R3: 47k / 1%; R_0603_1608Metric; MPN RC0603FR-0747KL
R4: 33R / 1%; R_0603_1608Metric; MPN RC0603FR-0733RL
TP1: 3V3; TestPoint_Pad_D1.0mm
TP2: GND; TestPoint_Pad_D1.0mm
TP3: ENC_CS; TestPoint_Pad_D1.0mm
TP4: ENC_SCK; TestPoint_Pad_D1.0mm
TP5: ENC_MOSI; TestPoint_Pad_D1.0mm
TP6: SPI_MISO; TestPoint_Pad_D1.0mm
U1: AS5047P-ATSM; TSSOP-14_4.4x5mm_P0.65mm; MPN AS5047P-ATSM

Connections:
3V3: C1.1, C2.1, J1.1 (3V3), R1.1, TP1.1, U1.11 (VDD), U1.12 (VDD3V3)
ENC_CS: J1.6 (CSn), R1.2, TP3.1, U1.1 (CSn)
ENC_MOSI: J1.5 (MOSI), R3.1, TP5.1, U1.4 (MOSI)
ENC_SCK: J1.3 (SCK), R2.1, TP4.1, U1.2 (CLK)
GND: C1.2, C2.2, J1.2 (GND), J1.MP (HOLD_DOWN), R2.2, R3.2, TP2.1, U1.5 (TEST), U1.13 (GND)
MISO_SENSOR: R4.1, U1.3 (MISO)
SPI_MISO: J1.4 (MISO), R4.2, TP6.1

Notes on the sheet:
05 TEST PADS / MECHANICAL
FOC ENCODER

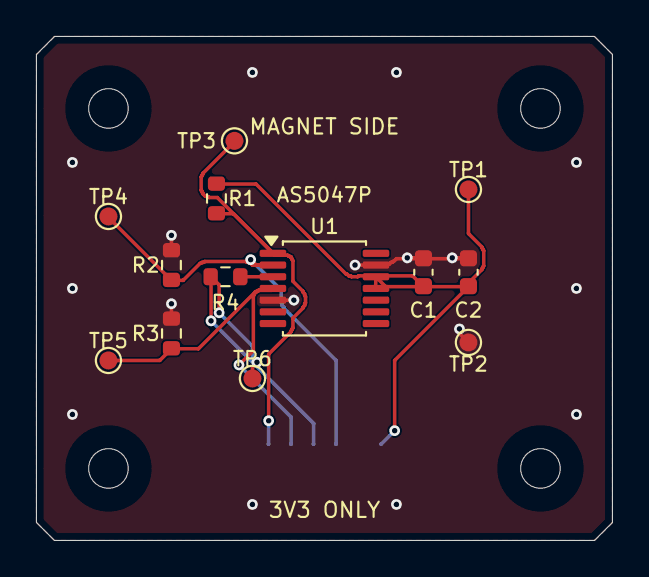
[picture p71: board foc-encoder.kicad_pcb from above]

Board: 2 copper layers, 32.0 x 28.0 mm, 18 parts (1 on the bottom side), 7 nets.
