dganin-hw/bldc-foc/hardware/dev-board/cubemx/CubeMX.ioc

Mcu.UserName=STM32G431CBTx
PA0.Signal=ADC1_IN1
PA1.Signal=ADC1_IN2
PA10.Signal=S_TIM1_CH3
PA11.GPIO_Label=DRV_ENABLE
PA11.Signal=GPIO_Output
PA12.GPIO_Label=DRV_NFAULT
PA12.Signal=GPXTI12
PA13.Signal=SYS_JTMS-SWDIO
PA14.Signal=SYS_JTCK-SWCLK
PA15.GPIO_Label=DRV_CS
PA15.Signal=GPIO_Output
PA2.Signal=ADC1_IN3
PA4.Signal=ADC2_IN17
PA5.Signal=ADC2_IN13
PA8.Signal=S_TIM1_CH1
PA9.Signal=S_TIM1_CH2
PB1.GPIO_Label=TP_TIMING
PB1.Signal=GPIO_Output
PB10.Signal=USART3_TX
PB11.Signal=USART3_RX
PB12.Signal=TIM1_BKIN
PB13.Signal=TIM1_CH1N
PB14.Signal=TIM1_CH2N
PB15.Signal=TIM1_CH3N
PB3.Signal=SPI1_SCK
PB4.Signal=SPI1_MISO
PB5.Signal=SPI1_MOSI
PB6.Signal=S_TIM4_CH1
PB9.GPIO_Label=ENC_CS
PB9.Signal=GPIO_Output
PC13.GPIO_Label=LED
PC13.Signal=GPIO_Output
