dganin-hw/bldc-foc/(commit log)

2026-10-20 Контроллер BLDC с FOC на STM32
    [00-buck.kicad_sch, 01-power-interface.kicad_sch, 01-power.kicad_sch, 01_base.step, 01_base.stl, 02-controller-A.kicad_sch, 02-mcu.kicad_sch, 02_foot.step]
2026-10-20 CI: компилятор ARM из репозитория Ubuntu
